shaoming11/hh-winners/software/benchsim/reports/layout_report.md

# Layout verification report

Generated by `python -m benchsim.verify_layout`. Source: `layout_final.json:update13_final`. Gate: station centre error <= 1.0 mm; beakers settle within 1 mm, tilt <= 0.5 deg, no initial interpenetration > 0.2 mm.

**Overall: PASS**

## Station centres (measured in the compiled MuJoCo model)

| Station | Model (mm) | update13_final (mm) | Error (mm) | Result |
|---|---|---|---|---|
| pourer base axis | [397.4, 599.7] | [397.4, 599.7] | 0.000 | PASS |
| transfer base axis | [604.8, 599.7] | [604.8, 599.7] | 0.000 | PASS |
| scale pan centre | [620.0, 407.0, 63.68] | [620.0, 407.0, 63.7] | 0.022 | PASS |
| funnel rim (sled at WORK) | [450.0, 282.0, 233.0] | [450.0, 282.0, 233.0] | 0.000 | PASS |
| carousel centre | [755.7, 297.0] | [755.7, 297.0] | 0.000 | PASS |
| carousel pick pocket | [718.22, 372.17, 61.7] | [718.2, 372.2, 61.7] | 0.032 | PASS |
| carousel auger on the pocket circle (r, z) | [83.97, 61.7] | [84.0, 61.7] | 0.033 | PASS |
| every pocket reaches the auger in deck range | [] | [] | 0.000 | PASS |
| rack pocket 1 | [192.3, 394.6, 60.2] | [192.3, 394.6, 60.2] | 0.000 | PASS |
| rack pocket 2 | [134.6, 477.1, 60.2] | [134.6, 477.1, 60.2] | 0.000 | PASS |
| rack pocket 3 | [108.5, 574.4, 60.2] | [108.5, 574.4, 60.2] | 0.000 | PASS |
| X-front rail centre Y | [582.5] | [582.5] | 0.000 | PASS |
| X-back rail centre Y | [652.3] | [652.3] | 0.000 | PASS |
| auger outlet over auger pocket | [834.5, 326.0] | [834.5, 326.0] | 0.000 | PASS |

## Beakers after 2 s of free settling

| Beaker | Station | Error (mm) | Moved (mm) | Tilt (deg) | Initial penetration (mm) | Result |
|---|---|---|---|---|---|---|
| P1 | carousel_pocket_0 | 0.110 | 0.160 | 0.024 | 0.000 | PASS |
| P2 | carousel_pocket_2 | 0.111 | 0.161 | 0.033 | 0.000 | PASS |
| dev | rack_1 | 0.110 | 0.160 | 0.038 | 0.000 | PASS |
| water | rack_3 | 0.108 | 0.158 | 0.000 | 0.000 | PASS |

## Recorded r / bearing table vs coordinates (coordinates are authoritative)

| Arm | Station | r | r recorded | Bearing | Bearing recorded |
|---|---|---|---|---|---|
| pourer | rack 1 | 290.1 | 290.0 | -45.0 | -45 |
| pourer | rack 2 | 290.0 | 290.0 | -65.0 | -65 |
| pourer | rack 3 | 290.0 | 290.0 | -85.0 | -85 |
| pourer | scale | 294.4 | 294.4 | 49.1 | 47 |
| pourer | funnel | 322.0 | 322.0 | 9.4 | 9 |
| transfer | carousel pick | 254.2 | 254.2 | 26.5 | 26.5 |
| transfer | scale | 193.3 | 193.3 | 4.5 | -5 |
| - | carousel_pick vs centre | 84.0 | 84.0 | 116.5 | None |
| - | carousel_auger vs centre | 84.0 | 84.0 | 20.2 | None |

## Imported CAD mesh placement

| Part | File | Placement check | Residual (mm) |
|---|---|---|---|
| RK-03 reagent rack | `RK-03_reagent_rack.stl` | fit: 3 cup floors to update13_final rack_stands + floor Z | 0.000 |
| TT-04 v4 beaker ring | `TT-04_beaker-ring-v4-4x100mL_qty1.stl` | fit: 4 pocket bores to the r84 pockets + floor Z | 0.123 |
| TT-02 carousel deck | `TT-02_carousel-deck_qty1.stl` | concentric with the carousel axis (symmetric part); Z = ring base - 7 | n/a |
| WS-02 v3 scale pan | `WS-02_scale-pan-v3-100mL_qty1.stl` | ring centre and floor Z: floor lands on the update13_final beaker bottom Z 63.7 | 0.000 |
| ST-11 stage sled | `ST-11_stage-sled_qty1_SUPPORTS.stl` | part frame = tools/cad/stage_b.py origin (450, 282, 0); catch-well ring centre found at local (0.01, 0.04) | 0.038 |
| ST-12 servo bridge | `ST-12_servo-bridge_qty1.stl` | part frame = tools/cad/stage_b.py Part origin (explicit world coordinates) | n/a |
| ST-13 crank | `ST-13_crank_qty1.stl` | part frame = tools/cad/stage_b.py Part origin (explicit world coordinates) | n/a |
| ST-14 connecting rod | `ST-14_connecting-rod_qty1.stl` | part frame = tools/cad/stage_b.py Part origin (explicit world coordinates) | n/a |
| ST-07 catch well | `ST-07_catch-well_qty1.stl` | concentric in the ST-11 locating ring (symmetric part); Z = sled plate top | n/a |
| ST-05 flask collar | `ST-05_flask-collar_qty1.stl` | concentric, on the catch-well floor (assumed 2 mm) | n/a |
| TT-01 v2 turntable base | `TT-01_turntable-base-v2_qty1.stl` | assumed: local origin on the carousel axis, rotated with the unit by update13_final carousel.rotation_deg | n/a |

## Fidelity

| Part | Visual | Collision | Source | Note |
|---|---|---|---|---|
| table | procedural | box | bench_params.toml world.table_xy (assumed extent) |  |
| frame rails (X-front, X-back, Y-left, Y-right, E6, S1, S2) | procedural | box per rail | update13_final X_rails + demo_process 2.2 + tools/cad/stage_a.py | solid 20x20 boxes, no T-slots; E5 omitted (placement not recorded) |
| scale WS-01 base, load cell | procedural | box | update13_final scale.mount (saddle X 547-664) + WS-01 STL extent |  |
| scale pan WS-02 v3 | procedural | cylinder floor + 20-box locating ring | update13_final scale.pan, WS-02 STL extent |  |
| load cell signal | analytic | - | slide-joint flexure (k, zeta) + HX711 noise/quantisation | see benchsim.backends.sim |
| carousel TT-01/TT-02/TT-04 v4 | procedural | cylinders + 20-box pocket bore (r 30.6) + 3 mm rib band (r 28.3) | update13_final carousel + layout_final.py pocket walls r28.3-30.3 | deck on a hinge with a position servo |
| auger PS-01 post + DH-01 head + E5 | procedural | box | layout_final carousel.auger_post_box / auger_head_box / auger_rail_E5 (STL extents as placed) | bounding boxes of the CAD parts; screw not modelled |
| auger dosing | analytic | - | g/rev x revolutions with CV, stall rule (electrical.md 6) |  |
| reagent rack RK-03 | procedural | cup posts + 20-box cup walls + webs + spine | update13_final rack_stands + rack_beaker_bottom_z | cup walls 22 mm tall around the beaker; spine on the Y-left west face |
| stage ST-11 sled, ST-13 crank, ST-14 rod | procedural | sled plate box; crank/rod no collision | tools/cad/stage_b.py (crank r50 at (450,77), rod 80) | closed slider-crank: hinge + hinge + connect equality + slide |
| flask 250 mL, ST-05 collar, ST-07 catch well | procedural | convex frustum hull (flask) | assumed Erlenmeyer dims; ST-05/ST-07 STL extents |  |
| funnel | procedural | convex frustum hull | update13_final funnel (rim Z 233); 100 mm rim assumed | solid hull: conservative for clearance below the rim |
| foam column | analytic | - | benchsim.chem.foam: induction + logistic growth from reagent masses |  |
| beakers EISCO 100 mL PP (56 x 74) | procedural | floor cylinder + 20-box hollow wall | demo_process 3 + DUMMY-BEAKER STL | free bodies; liquid weight applied as an external force by the chemistry model |
| liquid in vessels | analytic | - | benchsim.chem.liquid: tilted-cylinder volume, weir flow, ballistic stream |  |
| SO-101 arms (2x) | upstream-mesh | upstream link meshes (convex hulls) | TheRobotStudio/SO-ARM100 5f6d2b876a53 so101_new_calib.xml | stock jaw meshes removed; actuators as upstream (kp 998, 3.35 N m) |
| fin-ray gripper GR-01 body, GR-02 jaw, GR-03 fingers | cad-mesh | GR-01/GR-02 convex hulls + one 4 mm box per finger contact face | exports/prints_v2 GR-0x STLs (assembly coordinates, arm A as built) placed by the CAD as-built fit | moving finger = GR-03 mirrored about the 43 mm bisector and rotated (gripper_design.to_moving_q0) |
| RK-03 reagent rack | cad-mesh | procedural (see the matching procedural row) | RK-03_reagent_rack.stl | fit: 3 cup floors to update13_final rack_stands + floor Z; residual 0.000 mm |
| TT-04 v4 beaker ring | cad-mesh | procedural (see the matching procedural row) | TT-04_beaker-ring-v4-4x100mL_qty1.stl | fit: 4 pocket bores to the r84 pockets + floor Z; residual 0.123 mm |
| TT-02 carousel deck | cad-mesh | procedural (see the matching procedural row) | TT-02_carousel-deck_qty1.stl | concentric with the carousel axis (symmetric part); Z = ring base - 7 |
| WS-02 v3 scale pan | cad-mesh | procedural (see the matching procedural row) | WS-02_scale-pan-v3-100mL_qty1.stl | ring centre and floor Z: floor lands on the update13_final beaker bottom Z 63.7; residual 0.000 mm |
| ST-11 stage sled | cad-mesh | procedural (see the matching procedural row) | ST-11_stage-sled_qty1_SUPPORTS.stl | part frame = tools/cad/stage_b.py origin (450, 282, 0); catch-well ring centre found at local (0.01, 0.04); residual 0.038 mm |
| ST-12 servo bridge | cad-mesh | procedural (see the matching procedural row) | ST-12_servo-bridge_qty1.stl | part frame = tools/cad/stage_b.py Part origin (explicit world coordinates) |
| ST-13 crank | cad-mesh | procedural (see the matching procedural row) | ST-13_crank_qty1.stl | part frame = tools/cad/stage_b.py Part origin (explicit world coordinates) |
| ST-14 connecting rod | cad-mesh | procedural (see the matching procedural row) | ST-14_connecting-rod_qty1.stl | part frame = tools/cad/stage_b.py Part origin (explicit world coordinates) |
| ST-07 catch well | cad-mesh | procedural (see the matching procedural row) | ST-07_catch-well_qty1.stl | concentric in the ST-11 locating ring (symmetric part); Z = sled plate top |
| ST-05 flask collar | cad-mesh | procedural (see the matching procedural row) | ST-05_flask-collar_qty1.stl | concentric, on the catch-well floor (assumed 2 mm) |
| TT-01 v2 turntable base | cad-mesh | procedural (see the matching procedural row) | TT-01_turntable-base-v2_qty1.stl | assumed: local origin on the carousel axis, rotated with the unit by update13_final carousel.rotation_deg |
| cameras | analytic | - | no documented viewpoint; poses assumed in scene.cameras |  |
