shaoming11/hh-winners/software/benchsim/reports/mechanisms_report.md

# Mechanisms verification report (phase 7)

Generated by `python -m benchsim.verify_mechanisms` (123 s wall). Auger dosing, foam and liquid volumes are analytic models, not CFD or granular simulation; every parameter is in `benchsim/config/bench_params.toml` ([auger], [auger_model], [foam], [flask]), and "assumed" values there have no measurement behind them.

**Overall: PASS**

## Gates

| Section | Gate | Result |
|---|---|---|
| (a) dosing | doses within tol | PASS |
| (a) dosing | topups le max | PASS |
| (a) dosing | landing in P2 | PASS |
| (a) dosing | transient jam recovered | PASS |
| (a) dosing | jam faults | PASS |
| (a) dosing | hopper empty faults | PASS |
| (a) dosing | hopper empty host rule | PASS |
| (b) carousel | all pocket station pairs visited | PASS |
| (b) carousel | all reachable | PASS |
| (b) carousel | deck angle within done tol | PASS |
| (b) carousel | pockets on stations | PASS |
| (b) carousel | beakers stay in pockets | PASS |
| (b) carousel | commanded time obeys 2s per 45deg | PASS |
| (b) carousel | travel time within cmd plus timeout | PASS |
| (c) stage | linkage matches analytic | PASS |
| (c) stage | travel vs commanded angle | PASS |
| (c) stage | analytic 150deg is 97 3 | PASS |
| (c) stage | erupt travel 97 3 | PASS |
| (c) stage | work return | PASS |
| (c) stage | travel time within cmd plus timeout | PASS |
| (d) foam | o2 yield about 1 7 l | PASS |
| (d) foam | o2 released conserved | PASS |
| (d) foam | zero foam without yeast | PASS |
| (d) foam | zero foam without developer | PASS |
| (d) foam | foam made monotonic | PASS |
| (d) foam | column monotonic to peak | PASS |
| (d) foam | camera frames cover growth | PASS |
| (d) foam | camera colour px grow | PASS |
| (d) foam | camera segmented px grow | PASS |
| (d) foam | camera projection matches top | PASS |
| (d) foam | camera foam pixels in region | PASS |

## (a) Yeast dosing

Model: per-revolution g/rev drawn from N(0.850, (0.06 x 0.850)^2) with a seeded RNG. Yeast leaves only on new screw travel, so the 1/4-turn reverse after each AUG costs 1/4 rev of dispensing at the start of the next AUG. Host: first pass 85 % of target by revolutions, scale verification, at most 2 top-ups of round((target - m)/g_per_rev, 0.1). P2 is teleported between its pick pocket and the scale pan (the transfer-arm move is the sequencer's job); its empty tare on the simulated HX711 was 18.017 g.

Landing: outlet 0.416 mm from the P2 axis at the auger station (limit 21.800 = inner radius - outlet radius), 33.9 mm above the lip; receiver = P2.

Calibration (architecture 6, 3 x 10 rev into the tared cup): **0.8294 g/rev** (model mean 0.850 per dispensing revolution). Runs: 0.838 g/rev, 0.831 g/rev, 0.820 g/rev.

| Dose | Status | First pass (rev) | Top-ups | Revs total | Scale (g) | Error (g) | Ledger truth (g) | Truth error (g) |
|---|---|---|---|---|---|---|---|---|
| 1 | ok | 7.2 | 1 | 8.5 | 7.101 | +0.101 | 7.073 | +0.073 |
| 2 | ok | 7.2 | 1 | 8.3 | 6.987 | -0.013 | 7.010 | +0.010 |
| 3 | ok | 7.2 | 1 | 8.2 | 7.043 | +0.043 | 7.056 | +0.056 |
| 4 | ok | 7.2 | 1 | 8.1 | 6.984 | -0.016 | 6.976 | -0.024 |
| 5 | ok | 7.2 | 1 | 8.4 | 7.016 | +0.016 | 7.024 | +0.024 |
| 6 | ok | 7.2 | 1 | 8.3 | 7.077 | +0.077 | 7.089 | +0.089 |
| 7 | ok | 7.2 | 1 | 8.3 | 6.959 | -0.041 | 6.961 | -0.039 |
| 8 | ok | 7.2 | 1 | 8.1 | 7.043 | +0.043 | 7.057 | +0.057 |
| 9 | ok | 7.2 | 1 | 8.5 | 7.024 | +0.024 | 7.032 | +0.032 |
| 10 | ok | 7.2 | 1 | 8.3 | 7.016 | +0.016 | 7.036 | +0.036 |

Target 7.0 g +- 0.7 g over 10 doses: scale error mean +0.025 g, std 0.043 g, max |error| 0.101 g; ledger truth mean +0.032 g, std 0.041 g, max |error| 0.089 g. Top-up counts {'0': 0, '1': 10, '2': 0}. Yeast spilled: 0.0000 g.

Where the negative bias comes from: every AUG starts by re-covering the previous 0.00-turn anti-dribble reverse, and in this model that travel dispenses nothing ([auger_model] recover_dispenses = false, assumed). Calibration spreads the loss over 10 rev, so the calibrated value sits below the true one, but a 1-1.5 rev top-up still loses about 0.00 rev x 0.85 g/rev = 0.00 g. The documented top-up formula is used unchanged. If the real screw behaves this way, adding reverse_rev to each commanded pass would remove most of the bias.

| Fault case | Result |
|---|---|
| Transient jam (screw blocked 0.25 s, 1 s into the first pass) | ok, first-pass stalls 1, scale 7.003 g |
| Jammed auger | fault AUGER_JAM after 3 stall events |
| Empty hopper (device model rule) | fault HOPPER_EMPTY: Mega fault {'g_last': 0.619, 'revs': 10, 't': 602002} |
| Empty hopper (host scale rule, device rule off) | fault HOPPER_EMPTY: host scale check: -0.04 g over 15.6 rev |

Sensitivity to a host g/rev error (true g/rev unchanged; informational):

| Host g/rev / calibrated | Status | First pass (rev) | Top-ups | Scale (g) | Truth (g) |
|---|---|---|---|---|---|
| 0.80 | ok | 9.0 | 0 | 7.570 | 7.597 |
| 0.80 | ok | 9.0 | 0 | 7.316 | 7.344 |
| 0.90 | ok | 8.0 | 0 | 6.865 | 6.880 |
| 0.90 | ok | 8.0 | 0 | 6.702 | 6.703 |
| 1.10 | ok | 6.5 | 1 | 6.906 | 6.910 |
| 1.10 | ok | 6.5 | 1 | 6.962 | 6.980 |
| 1.20 | ok | 6.0 | 1 | 6.625 | 6.643 |
| 1.20 | ok | 6.0 | 1 | 6.688 | 6.715 |

## (b) Carousel stations

Deck angle that brings each pocket to each station; bearings from update13_final, pocket angles from [carousel] pocket_ids_deg.

| Pocket | Station | Station bearing (deg) | Deck angle (deg) |
|---|---|---|---|
| 0 | pick | 116.504 | 0.004 |
| 0 | auger | 20.205 | -96.295 |
| 1 | pick | 116.504 | -89.996 |
| 1 | auger | 20.205 | 173.705 |
| 2 | pick | 116.504 | 180.004 |
| 2 | auger | 20.205 | 83.705 |
| 3 | pick | 116.504 | 90.004 |
| 3 | auger | 20.205 | -6.295 |

Moves at the commanded minimum time (2.0 s per 45 deg). Gates: deck within the firmware done tolerance 0.6 deg, pocket centres and beaker offsets within 1.0 mm, travel time between commanded and commanded + 2.0 s.

| Deck cmd (deg) | Span (deg) | Cmd (s) | Travel (s) | Deck error (deg) | Pick: pocket, error (mm) | Auger: pocket, error (mm) | P1 offset (mm) | P2 offset (mm) |
|---|---|---|---|---|---|---|---|---|
| -96.30 | 96.3 | 4.280 | 4.285 | -0.185 | - | 0 (P1), 0.274 | 0.246 | 0.254 |
| 173.71 | 269.8 | 11.991 | 11.995 | +0.066 | - | 1 (-), 0.103 | 0.214 | 0.159 |
| 83.70 | 89.9 | 3.998 | 4.005 | -0.195 | - | 2 (P2), 0.290 | 0.212 | 0.176 |
| -6.29 | 90.2 | 4.011 | 4.015 | -0.198 | - | 3 (-), 0.294 | 0.203 | 0.172 |
| 0.00 | 6.1 | 0.270 | 0.535 | +0.382 | 0 (P1), 0.564 | - | 0.201 | 0.155 |
| -90.00 | 89.4 | 3.974 | 3.975 | -0.206 | 1 (-), 0.306 | - | 0.194 | 0.159 |
| 180.00 | 269.8 | 11.990 | 11.995 | +0.065 | 2 (P2), 0.101 | - | 0.154 | 0.150 |
| 90.00 | 89.9 | 3.998 | 4.005 | -0.195 | 3 (-), 0.290 | - | 0.148 | 0.167 |

## (c) Stage slider-crank

Analytic s(theta) = (r + L) - r cos(theta) - sqrt(L^2 - r^2 sin^2(theta)), r 50, L 80; s(150 deg) = 97.3078 mm.

| Cmd (deg) | Crank measured (deg) | Sled travel MuJoCo (mm) | Analytic at measured (mm) | Linkage error (mm) | Analytic at cmd (mm) | Error vs cmd (mm) |
|---|---|---|---|---|---|---|
| 0 | 0.000 | -0.000 | 0.000 | -0.0000 | 0.000 | -0.0000 |
| 10 | 9.995 | 1.231 | 1.231 | -0.0000 | 1.232 | -0.0012 |
| 20 | 19.995 | 4.862 | 4.862 | -0.0000 | 4.865 | -0.0024 |
| 30 | 29.995 | 10.702 | 10.702 | -0.0001 | 10.705 | -0.0035 |
| 40 | 39.995 | 18.433 | 18.433 | -0.0001 | 18.438 | -0.0043 |
| 50 | 49.995 | 27.621 | 27.621 | -0.0001 | 27.626 | -0.0049 |
| 60 | 59.995 | 37.727 | 37.727 | -0.0001 | 37.732 | -0.0051 |
| 70 | 69.995 | 48.145 | 48.145 | -0.0001 | 48.150 | -0.0050 |
| 80 | 79.995 | 58.262 | 58.262 | -0.0001 | 58.267 | -0.0046 |
| 90 | 89.996 | 67.546 | 67.546 | -0.0001 | 67.550 | -0.0040 |
| 100 | 99.996 | 75.628 | 75.629 | -0.0001 | 75.632 | -0.0033 |
| 110 | 109.996 | 82.349 | 82.349 | -0.0001 | 82.352 | -0.0026 |
| 120 | 119.996 | 87.730 | 87.730 | -0.0000 | 87.732 | -0.0020 |
| 130 | 129.996 | 91.903 | 91.903 | -0.0000 | 91.904 | -0.0015 |
| 140 | 139.996 | 95.041 | 95.041 | -0.0000 | 95.042 | -0.0011 |
| 150 | 149.996 | 97.307 | 97.307 | -0.0000 | 97.308 | -0.0008 |

Max linkage error 0.0001 mm; max error vs commanded angle 0.0051 mm (gate 0.5 mm).

| Move | Crank (deg) | Sled travel (mm) | Travel time (s) | Commanded (s) |
|---|---|---|---|---|
| WORK | 0.012 | 0.000 | 2.685 | 2.500 |
| ERUPT | 149.989 | 97.306 | 2.675 | 2.500 |
| WORK | 0.012 | 0.000 | 2.685 | 2.500 |

## (d) Foam

O2 yield: 39 g developer x 0.12 = 4.68 g H2O2 = 0.1376 mol -> 0.0688 mol O2 x 24.47 L/mol = **1683 mL** (demo_process 1: about 1.7 L). Flask internal volume (modelled frustum + neck) 296.6 mL.

Parameters ([foam], mostly assumed): induction 2.0 s, k = 1.20 mL/(g s) x yeast g / liquid mL, trap fraction 0.70 with soap (0.00 without), liquid fraction 0.05, collapse tau 30 s, column max 200 mm above the neck, column diameter = neck bore 28 mm.

Timeline (t = 0 when the yeast slurry enters the flask, all at once): stage starts at 1.5 s and reaches ERUPT at 4.17 s (sled 97.20 mm); foam reaches the neck top at 4.09 s; column peak 200.0 mm at 5.7 s; after 60 s, 1674 mL O2 released, 1233 mL foam made, 528 mL overflowed into the catch well.

Timing note (informational; it rests on the assumed induction_s and k): foam reaches the neck top BEFORE the sled arrives at ERUPT (margin -0.08 s), with the sled at 97.1 mm of its 97.2 mm travel by then. Architecture 4.5 wants the catalyst-to-neck time measured on the first live run.

| t (s) | H2O2 left (g) | O2 (mL) | Foam made (mL) | Foam in flask (mL) | Column above neck (mm) | Overflow (mL) |
|---|---|---|---|---|---|---|
| 1 | 4.680 | 0 | 0 | 0 | 0.0 | 0 |
| 2 | 4.680 | 0 | 0 | 0 | 0.0 | 0 |
| 3 | 4.282 | 143 | 105 | 104 | 0.0 | 0 |
| 4 | 3.919 | 274 | 202 | 195 | 0.0 | 0 |
| 5 | 3.586 | 394 | 290 | 202 | 119.3 | 0 |
| 6 | 3.281 | 503 | 371 | 202 | 200.0 | 21 |
| 7 | 3.002 | 604 | 445 | 202 | 200.0 | 84 |
| 8 | 2.747 | 695 | 512 | 202 | 200.0 | 140 |
| 9 | 2.514 | 779 | 574 | 202 | 200.0 | 192 |
| 10 | 2.300 | 856 | 631 | 202 | 200.0 | 237 |
| 11 | 2.105 | 926 | 682 | 202 | 200.0 | 278 |
| 12 | 1.926 | 991 | 730 | 202 | 200.0 | 315 |
| 13 | 1.762 | 1050 | 773 | 202 | 200.0 | 347 |
| 14 | 1.613 | 1103 | 813 | 202 | 200.0 | 376 |
| 15 | 1.476 | 1153 | 849 | 202 | 200.0 | 402 |
| 20 | 0.947 | 1343 | 990 | 202 | 200.0 | 488 |
| 25 | 0.607 | 1465 | 1079 | 202 | 200.0 | 523 |
| 30 | 0.390 | 1543 | 1137 | 202 | 197.4 | 528 |
| 35 | 0.250 | 1594 | 1174 | 201 | 172.9 | 528 |
| 40 | 0.160 | 1626 | 1198 | 192 | 146.3 | 528 |
| 45 | 0.103 | 1646 | 1213 | 176 | 123.9 | 528 |
| 50 | 0.066 | 1660 | 1223 | 158 | 104.8 | 528 |
| 55 | 0.042 | 1668 | 1229 | 140 | 88.7 | 528 |
| 60 | 0.027 | 1674 | 1233 | 122 | 75.1 | 528 |

Zero cases (60 s each): no yeast: peak 0.0 mm, foam 0.0 mL, O2 0 mL; no developer: peak 0.0 mm, foam 0.0 mL, O2 0 mL; no soap: peak 0.0 mm, foam 0.0 mL, O2 1680 mL.

### Foam camera check (foam_cam, 640x480, fovy 40 deg)

The flask_neck_top site is projected with f = (H/2)/tan(fovy/2) and the camera pose (data.cam_xpos/cam_xmat). The region is 2 projected column radii either side of that pixel, from the image top down to it plus one projected radius (the near half of the column base, seen from above). Foam-coloured pixels outside the region must stay under 2 % of those inside. Foam-coloured pixels: hue within 30 deg of the foam rgba hue, saturation >= 0.15, value >= 0.25. Cross-checks: MuJoCo segmentation of the foam geom in the same region, and the predicted vs segmented top row of the column. The funnel (alpha 0.55) stands in front of the lower column: the colour test sees the foam through it, but segmentation records the funnel. The top-row check is therefore gated only while the column top is above the funnel rim (marked *). Saved frames are annotated: cyan = region, green = projected neck top.

| t (s) | Column (mm) | Neck pixel (u, v) | Colour px in region | Segmented px in region | Colour px outside | Top row predicted / segmented | Frame |
|---|---|---|---|---|---|---|---|
| 4.17 | 12.2 | [320.2, 420.5] | 2362 | 2363 | 0 | 380.2 / 387 | [png](foam_frames/foam_t04.17s.png) |
| 4.25 | 23.0 | [320.2, 420.5] | 5026 | 2887 | 0 | 355.6 / 382 |  |
| 4.50 | 56.2 | [320.2, 420.5] | 10590 | 2887 | 0 | 278.4 / 382 | [png](foam_frames/foam_t04.50s.png) |
| 4.75 | 88.3 | [320.2, 420.5] | 16074 | 5248 | 0 | 201.7 / 202 * | [png](foam_frames/foam_t04.75s.png) |
| 5.00 | 119.3 | [320.2, 420.5] | 21860 | 11057 | 0 | 121.2 / 121 * | [png](foam_frames/foam_t05.00s.png) |
| 5.25 | 149.3 | [320.2, 420.5] | 27945 | 17141 | 0 | 36.6 / 37 * |  |
| 5.50 | 178.4 | [320.2, 420.5] | 30869 | 19969 | 0 | - | [png](foam_frames/foam_t05.50s.png) |
| 5.75 | 200.0 | [320.2, 420.5] | 30869 | 19968 | 0 | - |  |
| 6.00 | 200.0 | [320.2, 420.5] | 30869 | 19968 | 0 | - |  |
| 7.00 | 200.0 | [320.2, 420.5] | 30869 | 19968 | 0 | - |  |
| 8.00 | 200.0 | [320.2, 420.5] | 30869 | 19968 | 0 | - |  |
| 10.00 | 200.0 | [320.2, 420.5] | 30869 | 19968 | 0 | - |  |
| 15.00 | 200.0 | [320.2, 420.5] | 30869 | 19968 | 0 | - |  |
| 20.00 | 200.0 | [320.2, 420.5] | 30869 | 19968 | 0 | - |  |
| 30.00 | 197.4 | [320.2, 420.5] | 30868 | 19968 | 0 | - | [png](foam_frames/foam_t30.00s.png) |
| 45.00 | 123.9 | [320.2, 420.5] | 22758 | 11943 | 0 | 108.5 / 109 * |  |
| 60.00 | 75.1 | [320.2, 420.5] | 13762 | 2887 | 0 | 233.4 / 382 | [png](foam_frames/foam_t60.00s.png) |

## Approximations

- Auger: grams per revolution are i.i.d. normal per revolution of new screw travel; no bridging, no compaction, no dependence on hopper level until the hopper is empty. The fall from the outlet is instant.
- The ledger applies the yeast weight to P2 as an external force, and the simulated scale reads it through the HX711 model (noise 0.07 g at 80 Hz, mean of 16 samples).
- Foam: first-order kinetics after a fixed induction delay. The headspace ignores the liquid carried into the foam. The column is a cylinder of neck-bore diameter drawn through the funnel, which is ignored. Collapse is a single exponential; overflow above the standing height is only bookkept. None of this is CFD.
- Stage and carousel use the MuJoCo position actuators driven by the simulated Mega smoothstep. The closed slider-crank uses a soft connect equality, so linkage errors are constraint compliance.
