shaoming11/hh-winners/software/benchsim/reports/kinematics_report.md

# Kinematics verification report

Generated by `python -m benchsim.verify_kinematics`. Margins are degrees to the URDF limit minus 5 deg (rule: >= 10 at picks, places and pours, >= 5 on carries). Paths are checked at <= 1.5 deg joint steps with the other arm parked; a contact is a penetration deeper than 0.5 mm.

## 1. CAD planner convention -> SO-101 MJCF

Mapping `q_mj = o + s * q_cad` with `o` from the CAD as-built axis fit (`benchsim.cadmap`) and `s` from the sign search below.
Status: **approximate**. The recorded paths are replayed with this mapping for audit only; they are not used as hardware or simulator trajectories.

### Sign search (32 combinations; best 6)

| signs | mean endpoint error (mm) | max (mm) | all frames in limits |
|---|---|---|---|
| [1, 1, 1, 1, 1] | 32.4 | 97.0 | True |
| [1, 1, 1, 1, -1] | 42.7 | 96.8 | True |
| [1, -1, -1, -1, 1] | 160.6 | 233.7 | False |
| [1, -1, -1, -1, -1] | 161.7 | 234.0 | False |
| [-1, 1, -1, -1, -1] | 235.4 | 374.1 | False |
| [-1, 1, -1, -1, 1] | 237.7 | 368.4 | False |

### Station endpoints of the recorded paths (MJCF FK vs update13_final)

| pose | FK (mm) | station (mm) | residual (mm) | margin MJCF | planner recorded | diff |
|---|---|---|---|---|---|---|
| P_dev pick | [188.6, 399.0, 105.2] | [192.3, 394.6, 100.2] | 7.59 | 9.96 wrist_flex | 11.65 wr_flex | -1.69 |
| P_wat pick | [109.8, 578.2, 90.6] | [108.5, 574.4, 100.2] | 10.43 | 9.56 wrist_flex | 11.18 wr_flex | -1.63 |
| P_fun pick | [616.0, 403.0, 98.6] | [620.0, 407.0, 93.7] | 7.51 | 8.76 wrist_flex | 10.42 wr_flex | -1.66 |
| T1 first frame (pick) | [742.1, 466.2, 60.7] | [718.2, 372.2, 61.7] | 97.01 | 19.40 wrist_flex | 17.72 wr_flex | +1.67 |
| T1 last frame (place) | [616.7, 406.4, 62.6] | [620.0, 407.0, 63.7] | 3.48 | 18.96 wrist_flex | 17.29 wr_flex | +1.67 |
| T2 first frame (pick) | [616.7, 406.4, 62.6] | [620.0, 407.0, 63.7] | 3.48 | 18.96 wrist_flex | 17.29 wr_flex | +1.67 |
| T2 last frame (place) | [742.1, 466.2, 60.7] | [718.2, 372.2, 61.7] | 97.01 | 19.40 wrist_flex | 17.72 wr_flex | +1.67 |

The binding joint matches the planner in every case; the constant 1.67 deg margin difference is the wrist-flex zero of the axis fit vs the planner's link-angle calibration (urdf_limits.py), i.e. the wrist-flex zero is uncertain by about 1.7 deg.

## 2. Recorded paths replayed on the MJCF arms (audit)

| step | segment | frames | in limits | min margin | contacts (worst) | min clearance | held tilt | lip above rim |
|---|---|---|---|---|---|---|---|---|
| T1 | approach park->pick | 6 | True | 11.2 wrist_flex | 0  | 18.1 |  |  |
| T1 | carry pick->place (held) | 8 | True | 11.2 wrist_flex | 3 (1.4 mm beaker_P1/scale_pan) | -1.4 | [0.6, 0.6] |  |
| T1 | retreat place->park | 5 | True | 11.5 wrist_flex | 11 (13.2 mm beaker_P1/transfer/gripper) | -13.2 |  |  |
| P_dev | approach park->pick | 13 | True | 10.0 wrist_flex | 19 (4.7 mm beaker_dev/pourer/gripper) | -4.7 |  |  |
| P_dev | carry pick->pre-pour (held) | 34 | True | 10.0 wrist_flex | 7 (4.6 mm beaker_dev/world) | -4.6 | [0.3, 0.8] |  |
| P_dev | tilt-in (held) | 9 | True | 35.7 elbow_flex | 0  | 18.6 | [0.3, 55.0] | [np.float64(48.2), np.float64(96.1)] |
| P_dev | pour 55->105 deg (held) | 26 | True | 35.7 elbow_flex | 0  | 18.6 | [54.9, 104.9] | [np.float64(42.2), np.float64(48.2)] |
| P_fun | approach park->pick | 14 | True | 8.8 wrist_flex | 23 (4.6 mm beaker_P1/pourer/gripper) | -4.6 |  |  |
| P_fun | carry pick->pre-pour (held) | 32 | True | 8.8 wrist_flex | 2 (3.1 mm beaker_P1/scale_pan) | -3.1 | [0.3, 1.1] |  |
| P_fun | tilt-in (held) | 35 | True | 66.1 wrist_roll | 0  | 10.7 | [1.1, 55.0] | [np.float64(68.3), np.float64(83.8)] |
| P_fun | pour 55->105 deg (held) | 26 | True | 76.3 shoulder_lift | 0  | 18.6 | [55.0, 105.0] | [np.float64(62.3), np.float64(68.3)] |
| T2 | approach park->pick | 6 | True | 11.5 wrist_flex | 13 (13.8 mm beaker_P1/transfer/gripper) | -13.7 |  |  |
| T2 | carry pick->place (held) | 8 | True | 11.2 wrist_flex | 3 (1.4 mm scale_pan/beaker_P1) | -1.4 | [0.6, 0.6] |  |
| T2 | retreat place->park | 5 | True | 11.2 wrist_flex | 11 (13.2 mm beaker_P1/transfer/gripper) | -13.2 |  |  |
| P_wat | approach park->pick | 13 | True | 9.5 wrist_flex | 3 (0.8 mm world/pourer/moving_jaw_so101_v1) | -0.8 |  |  |
| P_wat | carry pick->pre-pour (held) | 34 | True | 9.5 wrist_flex | 12 (9.7 mm world/beaker_water) | -9.7 | [0.3, 0.8] |  |
| P_wat | tilt-in (held) | 9 | True | 35.6 elbow_flex | 0  | 18.6 | [0.3, 55.2] | [np.float64(39.6), np.float64(83.9)] |
| P_wat | pour 55->105 deg (held) | 26 | True | 35.6 elbow_flex | 0  | 18.6 | [55.2, 105.1] | [np.float64(39.6), np.float64(46.0)] |

Pour segments reproduce the planner geometry (lip 42-48 mm above the P1 rim for the 45 mm design, 62-68 for the 65 mm funnel design; carried beakers stay within 1.1 deg of upright). Approach and pick frames collide by the size of the endpoint residuals, and the planner's top-down grasp frame puts the beaker 13-14 mm into the fixed finger (demo_process 3 already tells the operator to shift it about 14 mm). Recorded-path playback is therefore **pending** a hardware calibration.

## 3. MuJoCo-native station poses (simulation only)

Solved by IK on the MJCF arms, seeded from the mapped recorded poses. Top-down picks use the taught frame (beaker shifted 16.0 mm toward the moving jaw so the fixed finger clears it by 3 mm). Saved in `reports/native_plans.json` with `origin: mujoco-native`.

| step | pose | endpoint error (mm) | axis tilt (deg) | min margin | binding | rule |
|---|---|---|---|---|---|---|
| 1 P1 carousel->scale | pick (close on P1) | 0.000 | 0.0 | 23.21 | wrist_flex | ok |
| 1 P1 carousel->scale | place (release) | 0.000 | 0.0 | 15.27 | wrist_flex | ok |
| 2 developer pour | pick (close on dev) | 0.000 | 0.0 | 9.01 | wrist_flex | **below 10** |
| 2 developer pour | place (release) | 0.000 | 0.0 | 9.67 | wrist_flex | **below 10** |
| 2 developer pour | pour theta 40 | - | - | 32.74 | elbow_flex | ok |
| 2 developer pour | pour theta 105 | - | - | 37.07 | elbow_flex | ok |
| 3 P1 funnel pour | pick (close on P1) | 0.000 | 0.0 | 7.54 | wrist_flex | **below 10** |
| 3 P1 funnel pour | place (release) | 0.000 | 0.0 | 8.12 | wrist_flex | **below 10** |
| 3 P1 funnel pour | pour theta 40 | - | - | 74.51 | shoulder_lift | ok |
| 3 P1 funnel pour | pour theta 105 | - | - | 79.80 | shoulder_lift | ok |
| 4 P1 scale->carousel | pick (close on P1) | 0.000 | 0.0 | 15.87 | wrist_flex | ok |
| 4 P1 scale->carousel | place (release) | 0.000 | 0.0 | 22.57 | wrist_flex | ok |
| 6 P2 carousel->scale | pick (close on P2) | 0.000 | 0.0 | 23.21 | wrist_flex | ok |
| 6 P2 carousel->scale | place (release) | 0.000 | 0.0 | 15.27 | wrist_flex | ok |
| 7 water pour | pick (close on water) | 0.000 | 0.0 | 13.83 | wrist_flex | ok |
| 7 water pour | place (release) | 0.000 | 0.0 | 14.56 | wrist_flex | ok |
| 7 water pour | pour theta 40 | - | - | 34.40 | elbow_flex | ok |
| 7 water pour | pour theta 105 | - | - | 39.53 | elbow_flex | ok |
| 8 P2 funnel pour | pick (close on P2) | 0.000 | 0.0 | 7.54 | wrist_flex | **below 10** |
| 8 P2 funnel pour | place (release) | 0.000 | 0.0 | 8.12 | wrist_flex | **below 10** |
| 8 P2 funnel pour | pour theta 40 | - | - | 74.51 | shoulder_lift | ok |
| 8 P2 funnel pour | pour theta 105 | - | - | 79.80 | shoulder_lift | ok |
| 9 P2 scale->carousel | pick (close on P2) | 0.000 | 0.0 | 15.87 | wrist_flex | ok |
| 9 P2 scale->carousel | place (release) | 0.000 | 0.0 | 22.57 | wrist_flex | ok |

### Grip height selection for the side-grasp pours

| step | documented GRIP_H | pick margin there | GRIP_H used | pick margin used | lip drift (mm) |
|---|---|---|---|---|---|
| 2 developer pour | 40 | 7.33 | 44 | 9.01 | 8.9 |
| 3 P1 funnel pour | 30 | 6.43 | 33 | 7.54 | 7.2 |
| 7 water pour | 40 | 13.83 | 40 | 13.83 | 0.6 |
| 8 P2 funnel pour | 30 | 6.43 | 33 | 7.54 | 7.2 |

## 4. Native path checks

| step | segment | phase | configs | min margin | rule | contacts | min clearance (mm) | at |
|---|---|---|---|---|---|---|---|---|
| 1 P1 carousel->scale | approach park->above channel entry | approach | 47 | 14.40 wrist_flex | ok | 0 | 16.18 | transfer/gripper(transfer/finger_fixed) x beaker_P1(beaker_P1_w3) |
| 1 P1 carousel->scale | lower to channel entry | approach | 10 | 14.40 wrist_flex | ok | 0 | 18.60 | transfer/shoulder x world(rail_X_front) |
| 1 P1 carousel->scale | slide in along finger channel | approach | 16 | 14.40 wrist_flex | ok | 0 | 18.60 | transfer/shoulder x world(rail_X_front) |
| 1 P1 carousel->scale | descend to carousel_pick | approach | 12 | 14.57 wrist_flex | ok | 0 | 5.55 | transfer/gripper(transfer/finger_fixed) x carousel(pocket0_w7) |
| 1 P1 carousel->scale | touch fixed finger to P1 | approach | 4 | 23.21 wrist_flex | ok | 0 | -0.34 | transfer/gripper(transfer/finger_fixed) x beaker_P1(beaker_P1_w7) |
| 1 P1 carousel->scale | close on P1 | pick | 19 | 23.21 wrist_flex | ok | 0 | 5.30 | transfer/gripper(transfer/finger_fixed) x carousel(pocket0_w7) |
| 1 P1 carousel->scale | lift from carousel_pick | carry | 12 | 14.54 wrist_flex | ok | 0 | 0.05 | beaker_P1(beaker_P1_floor) x carousel(tt04_floor) |
| 1 P1 carousel->scale | carry carousel_pick->scale_pan | carry | 21 | 7.95 wrist_flex | ok | 0 | 11.74 | beaker_P1(beaker_P1_floor) x carousel(pocket0_w18) |
| 1 P1 carousel->scale | lower onto scale_pan | carry | 11 | 7.95 wrist_flex | ok | 0 | 1.57 | beaker_P1(beaker_P1_floor) x scale_pan(scale_pan_floor) |
| 1 P1 carousel->scale | release | place | 19 | 15.27 wrist_flex | ok | 0 | 7.72 | transfer/gripper(transfer/finger_fixed) x scale_pan(scale_ring_w6) |
| 1 P1 carousel->scale | move fixed finger off P1 | retreat | 4 | 14.58 wrist_flex | ok | 0 | -0.34 | transfer/gripper(transfer/finger_fixed) x beaker_P1(beaker_P1_w7) |
| 1 P1 carousel->scale | lift 20 mm | retreat | 13 | 6.75 wrist_flex | ok | 0 | 8.04 | transfer/gripper(transfer/finger_fixed) x scale_pan(scale_ring_w6) |
| 1 P1 carousel->scale | slide out along finger channel | retreat | 17 | 6.73 wrist_flex | ok | 0 | 18.60 | transfer/shoulder x world(rail_X_front) |
| 1 P1 carousel->scale | return to park | park | 67 | 8.14 wrist_flex | ok | 0 | 13.03 | transfer/gripper(transfer/finger_fixed) x beaker_P1(beaker_P1_w9) |
| 2 developer pour | approach park->above rack_1 | approach | 99 | 31.41 elbow_flex | ok | 0 | 3.62 | pourer/gripper(pourer/finger_fixed) x beaker_dev(beaker_dev_w17) |
| 2 developer pour | descend to rack_1 | approach | 30 | 9.01 wrist_flex | ok | 0 | 5.00 | pourer/gripper(pourer/finger_fixed) x world(rk03_cup1_w18) |
| 2 developer pour | close on dev | pick | 11 | 9.01 wrist_flex | **below 10** | 0 | 4.88 | pourer/moving_jaw_so101_v1(pourer/finger_moving) x world(rk03_cup1_w10) |
| 2 developer pour | lift from rack_1 | carry | 99 | 9.01 wrist_flex | ok | 0 | 0.05 | beaker_dev(beaker_dev_floor) x world(rk03_cup1_post) |
| 2 developer pour | carry to above pre-pour | carry | 52 | 63.41 shoulder_pan | ok | 0 | 18.60 | pourer/shoulder x world(rail_X_front) |
| 2 developer pour | lower to pre-pour | carry | 23 | 56.50 elbow_flex | ok | 0 | 18.60 | pourer/shoulder x world(rail_X_front) |
| 2 developer pour | tilt-in 0->40 | pour | 41 | 32.74 elbow_flex | ok | 0 | 9.84 | pourer/gripper(pourer/finger_fixed) x beaker_P1(beaker_P1_w13) |
| 2 developer pour | pour manifold 40->105 | pour | 183 | 28.16 wrist_flex | ok | 0 | 9.84 | pourer/gripper(pourer/finger_fixed) x beaker_P1(beaker_P1_w13) |
| 2 developer pour | untilt to pre-pour | pour | 41 | 32.74 elbow_flex | ok | 0 | 9.84 | pourer/gripper(pourer/finger_fixed) x beaker_P1(beaker_P1_w13) |
| 2 developer pour | raise from pre-pour | carry | 23 | 56.50 elbow_flex | ok | 0 | 18.60 | pourer/shoulder x world(rail_X_front) |
| 2 developer pour | carry back above rack_1 | carry | 52 | 63.41 shoulder_pan | ok | 0 | 18.60 | pourer/shoulder x world(rail_X_front) |
| 2 developer pour | lower into rack_1 | carry | 99 | 9.67 wrist_flex | ok | 0 | 0.54 | beaker_dev(beaker_dev_w18) x world(rk03_cup1_w19) |
| 2 developer pour | release | place | 11 | 9.67 wrist_flex | **below 10** | 0 | 6.38 | pourer/moving_jaw_so101_v1(pourer/finger_moving) x world(rk03_cup1_w10) |
| 2 developer pour | lift out | retreat | 28 | 9.67 wrist_flex | ok | 0 | 6.50 | pourer/gripper(pourer/finger_fixed) x world(rk03_cup1_w16) |
| 2 developer pour | return to park | park | 99 | 31.41 elbow_flex | ok | 0 | 3.62 | pourer/gripper(pourer/finger_fixed) x beaker_dev(beaker_dev_w17) |
| 3 P1 funnel pour | approach park->above scale_pan | approach | 98 | 28.91 wrist_flex | ok | 0 | 3.68 | pourer/gripper(pourer/finger_fixed) x beaker_P1(beaker_P1_w2) |
| 3 P1 funnel pour | descend to scale_pan | approach | 30 | 7.54 wrist_flex | ok | 0 | 8.02 | pourer/gripper(pourer/finger_fixed) x scale_pan(scale_ring_w2) |
| 3 P1 funnel pour | close on P1 | pick | 11 | 7.54 wrist_flex | **below 10** | 0 | 7.90 | pourer/moving_jaw_so101_v1(pourer/finger_moving) x scale_pan(scale_ring_w15) |
| 3 P1 funnel pour | lift from scale_pan | carry | 103 | 7.54 wrist_flex | ok | 0 | 0.02 | beaker_P1(beaker_P1_floor) x scale_pan(scale_pan_floor) |
| 3 P1 funnel pour | carry to above pre-pour | carry | 35 | 52.52 shoulder_pan | ok | 0 | 18.60 | pourer/shoulder x world(rail_X_front) |
| 3 P1 funnel pour | lower to pre-pour | carry | 13 | 65.11 wrist_roll | ok | 0 | 11.19 | beaker_P1(beaker_P1_floor) x sled |
| 3 P1 funnel pour | tilt-in 0->40 | pour | 41 | 65.11 wrist_roll | ok | 0 | 8.44 | beaker_P1(beaker_P1_floor) x sled |
| 3 P1 funnel pour | pour manifold 40->105 | pour | 169 | 16.52 wrist_flex | ok | 0 | 18.60 | pourer/shoulder x world(rail_X_front) |
| 3 P1 funnel pour | untilt to pre-pour | pour | 41 | 65.11 wrist_roll | ok | 0 | 8.44 | beaker_P1(beaker_P1_floor) x sled |
| 3 P1 funnel pour | raise from pre-pour | carry | 13 | 65.11 wrist_roll | ok | 0 | 11.19 | beaker_P1(beaker_P1_floor) x sled |
| 3 P1 funnel pour | carry back above scale_pan | carry | 35 | 52.52 shoulder_pan | ok | 0 | 18.60 | pourer/shoulder x world(rail_X_front) |
| 3 P1 funnel pour | lower into scale_pan | carry | 103 | 8.12 wrist_flex | ok | 0 | 1.52 | beaker_P1(beaker_P1_floor) x scale_pan(scale_pan_floor) |
| 3 P1 funnel pour | release | place | 11 | 8.12 wrist_flex | **below 10** | 0 | 9.40 | pourer/moving_jaw_so101_v1(pourer/finger_moving) x scale_pan(scale_ring_w15) |
| 3 P1 funnel pour | lift out | retreat | 28 | 8.12 wrist_flex | ok | 0 | 9.52 | pourer/gripper(pourer/finger_fixed) x scale_pan(scale_ring_w3) |
| 3 P1 funnel pour | return to park | park | 98 | 28.91 wrist_flex | ok | 0 | 3.68 | pourer/gripper(pourer/finger_fixed) x beaker_P1(beaker_P1_w2) |
| 4 P1 scale->carousel | approach park->above channel entry | approach | 60 | 8.72 wrist_flex | ok | 0 | 12.68 | transfer/gripper(transfer/finger_fixed) x beaker_P1(beaker_P1_w8) |
| 4 P1 scale->carousel | lower to channel entry | approach | 9 | 8.72 wrist_flex | ok | 0 | 18.60 | transfer/shoulder x world(rail_X_front) |
| 4 P1 scale->carousel | slide in along finger channel | approach | 17 | 7.30 wrist_flex | ok | 0 | 18.60 | transfer/shoulder x world(rail_X_front) |
| 4 P1 scale->carousel | descend to scale_pan | approach | 13 | 7.32 wrist_flex | ok | 0 | 6.62 | transfer/gripper(transfer/finger_fixed) x scale_pan(scale_ring_w6) |
| 4 P1 scale->carousel | touch fixed finger to P1 | approach | 5 | 15.17 wrist_flex | ok | 0 | -0.22 | transfer/gripper(transfer/finger_fixed) x beaker_P1(beaker_P1_w6) |
| 4 P1 scale->carousel | close on P1 | pick | 19 | 15.87 wrist_flex | ok | 0 | 6.22 | transfer/gripper(transfer/finger_fixed) x scale_pan(scale_ring_w4) |
| 4 P1 scale->carousel | lift from scale_pan | carry | 13 | 7.95 wrist_flex | ok | 0 | 0.02 | beaker_P1(beaker_P1_floor) x scale_pan(scale_pan_floor) |
| 4 P1 scale->carousel | carry scale_pan->carousel_pick | carry | 21 | 7.95 wrist_flex | ok | 0 | 11.69 | beaker_P1(beaker_P1_floor) x carousel(pocket0_w7) |
| 4 P1 scale->carousel | lower onto carousel_pick | carry | 11 | 14.54 wrist_flex | ok | 0 | -0.04 | beaker_P1(beaker_P1_w5) x carousel(pocket0rib_w7) |
| 4 P1 scale->carousel | release | place | 19 | 22.57 wrist_flex | ok | 0 | 6.80 | transfer/gripper(transfer/finger_fixed) x carousel(pocket0_w5) |
| 4 P1 scale->carousel | move fixed finger off P1 | retreat | 4 | 22.57 wrist_flex | ok | 0 | -0.22 | transfer/gripper(transfer/finger_fixed) x beaker_P1(beaker_P1_w6) |
| 4 P1 scale->carousel | lift 20 mm | retreat | 12 | 13.92 wrist_flex | ok | 0 | 7.00 | transfer/gripper(transfer/finger_fixed) x carousel(pocket0_w7) |
| 4 P1 scale->carousel | slide out along finger channel | retreat | 16 | 13.75 wrist_flex | ok | 0 | 18.60 | transfer/shoulder x world(rail_X_front) |
| 4 P1 scale->carousel | return to park | park | 56 | 13.75 wrist_flex | ok | 0 | 13.45 | transfer/gripper(transfer/finger_fixed) x beaker_P1(beaker_P1_w2) |
| 6 P2 carousel->scale | approach park->above channel entry | approach | 47 | 14.40 wrist_flex | ok | 0 | 16.18 | transfer/gripper(transfer/finger_fixed) x beaker_P2(beaker_P2_w3) |
| 6 P2 carousel->scale | lower to channel entry | approach | 10 | 14.40 wrist_flex | ok | 0 | 18.60 | transfer/shoulder x world(rail_X_front) |
| 6 P2 carousel->scale | slide in along finger channel | approach | 16 | 14.40 wrist_flex | ok | 0 | 18.60 | transfer/shoulder x world(rail_X_front) |
| 6 P2 carousel->scale | descend to carousel_pick | approach | 12 | 14.57 wrist_flex | ok | 0 | 5.55 | transfer/gripper(transfer/finger_fixed) x carousel(pocket0_w7) |
| 6 P2 carousel->scale | touch fixed finger to P2 | approach | 4 | 23.21 wrist_flex | ok | 0 | -0.37 | transfer/gripper(transfer/finger_fixed) x beaker_P2(beaker_P2_w7) |
| 6 P2 carousel->scale | close on P2 | pick | 19 | 23.21 wrist_flex | ok | 0 | 5.30 | transfer/gripper(transfer/finger_fixed) x carousel(pocket0_w7) |
| 6 P2 carousel->scale | lift from carousel_pick | carry | 12 | 14.54 wrist_flex | ok | 0 | 0.00 | beaker_P2(beaker_P2_floor) x carousel(tt04_floor) |
| 6 P2 carousel->scale | carry carousel_pick->scale_pan | carry | 21 | 7.95 wrist_flex | ok | 0 | 11.69 | beaker_P2(beaker_P2_floor) x carousel(pocket0_w7) |
| 6 P2 carousel->scale | lower onto scale_pan | carry | 11 | 7.95 wrist_flex | ok | 0 | 1.52 | beaker_P2(beaker_P2_floor) x scale_pan(scale_pan_floor) |
| 6 P2 carousel->scale | release | place | 19 | 15.27 wrist_flex | ok | 0 | 7.72 | transfer/gripper(transfer/finger_fixed) x scale_pan(scale_ring_w6) |
| 6 P2 carousel->scale | move fixed finger off P2 | retreat | 4 | 14.58 wrist_flex | ok | 0 | -0.37 | transfer/gripper(transfer/finger_fixed) x beaker_P2(beaker_P2_w7) |
| 6 P2 carousel->scale | lift 20 mm | retreat | 13 | 6.75 wrist_flex | ok | 0 | 8.04 | transfer/gripper(transfer/finger_fixed) x scale_pan(scale_ring_w6) |
| 6 P2 carousel->scale | slide out along finger channel | retreat | 17 | 6.73 wrist_flex | ok | 0 | 18.60 | transfer/shoulder x world(rail_X_front) |
| 6 P2 carousel->scale | return to park | park | 67 | 8.14 wrist_flex | ok | 0 | 13.01 | transfer/gripper(transfer/finger_fixed) x beaker_P2(beaker_P2_w9) |
| 7 water pour | approach park->above rack_3 | approach | 95 | 15.88 shoulder_pan | ok | 0 | 3.68 | pourer/gripper(pourer/finger_fixed) x beaker_water(beaker_water_w6) |
| 7 water pour | descend to rack_3 | approach | 30 | 13.83 wrist_flex | ok | 0 | 1.00 | pourer/gripper(pourer/finger_fixed) x world(rk03_cup3_w4) |
| 7 water pour | close on water | pick | 11 | 13.83 wrist_flex | ok | 0 | 1.00 | pourer/gripper(pourer/finger_fixed) x world(rk03_cup3_w4) |
| 7 water pour | lift from rack_3 | carry | 101 | 13.83 wrist_flex | ok | 0 | 0.05 | beaker_water(beaker_water_floor) x world(rk03_cup3_post) |
| 7 water pour | carry to above pre-pour | carry | 102 | 16.67 shoulder_pan | ok | 0 | 18.60 | pourer/shoulder x world(rail_X_front) |
| 7 water pour | lower to pre-pour | carry | 33 | 42.72 shoulder_pan | ok | 0 | 18.60 | pourer/shoulder x world(rail_X_front) |
| 7 water pour | tilt-in 0->40 | pour | 41 | 34.40 elbow_flex | ok | 0 | 13.82 | pourer/gripper(pourer/finger_fixed) x beaker_P2(beaker_P2_w4) |
| 7 water pour | pour manifold 40->105 | pour | 94 | 34.40 elbow_flex | ok | 0 | 13.82 | pourer/gripper(pourer/finger_fixed) x beaker_P2(beaker_P2_w4) |
| 7 water pour | untilt to pre-pour | pour | 41 | 34.40 elbow_flex | ok | 0 | 13.82 | pourer/gripper(pourer/finger_fixed) x beaker_P2(beaker_P2_w4) |
| 7 water pour | raise from pre-pour | carry | 33 | 42.72 shoulder_pan | ok | 0 | 18.60 | pourer/shoulder x world(rail_X_front) |
| 7 water pour | carry back above rack_3 | carry | 102 | 16.67 shoulder_pan | ok | 0 | 18.60 | pourer/shoulder x world(rail_X_front) |
| 7 water pour | lower into rack_3 | carry | 101 | 14.56 wrist_flex | ok | 0 | 0.54 | beaker_water(beaker_water_w6) x world(rk03_cup3_w5) |
| 7 water pour | release | place | 11 | 14.56 wrist_flex | ok | 0 | 2.50 | pourer/gripper(pourer/finger_fixed) x world(rk03_cup3_w4) |
| 7 water pour | lift out | retreat | 27 | 14.56 wrist_flex | ok | 0 | 2.50 | pourer/gripper(pourer/finger_fixed) x world(rk03_cup3_w4) |
| 7 water pour | return to park | park | 95 | 15.88 shoulder_pan | ok | 0 | 3.68 | pourer/gripper(pourer/finger_fixed) x beaker_water(beaker_water_w6) |
| 8 P2 funnel pour | approach park->above scale_pan | approach | 98 | 28.91 wrist_flex | ok | 0 | 3.68 | pourer/gripper(pourer/finger_fixed) x beaker_P2(beaker_P2_w2) |
| 8 P2 funnel pour | descend to scale_pan | approach | 30 | 7.54 wrist_flex | ok | 0 | 8.02 | pourer/gripper(pourer/finger_fixed) x scale_pan(scale_ring_w2) |
| 8 P2 funnel pour | close on P2 | pick | 11 | 7.54 wrist_flex | **below 10** | 0 | 7.90 | pourer/moving_jaw_so101_v1(pourer/finger_moving) x scale_pan(scale_ring_w15) |
| 8 P2 funnel pour | lift from scale_pan | carry | 103 | 7.54 wrist_flex | ok | 0 | 0.02 | beaker_P2(beaker_P2_floor) x scale_pan(scale_pan_floor) |
| 8 P2 funnel pour | carry to above pre-pour | carry | 35 | 52.52 shoulder_pan | ok | 0 | 18.60 | pourer/shoulder x world(rail_X_front) |
| 8 P2 funnel pour | lower to pre-pour | carry | 13 | 65.11 wrist_roll | ok | 0 | 11.19 | beaker_P2(beaker_P2_floor) x sled |
| 8 P2 funnel pour | tilt-in 0->40 | pour | 41 | 65.11 wrist_roll | ok | 0 | 8.44 | beaker_P2(beaker_P2_floor) x sled |
| 8 P2 funnel pour | pour manifold 40->105 | pour | 169 | 16.52 wrist_flex | ok | 0 | 18.60 | pourer/shoulder x world(rail_X_front) |
| 8 P2 funnel pour | untilt to pre-pour | pour | 41 | 65.11 wrist_roll | ok | 0 | 8.44 | beaker_P2(beaker_P2_floor) x sled |
| 8 P2 funnel pour | raise from pre-pour | carry | 13 | 65.11 wrist_roll | ok | 0 | 11.19 | beaker_P2(beaker_P2_floor) x sled |
| 8 P2 funnel pour | carry back above scale_pan | carry | 35 | 52.52 shoulder_pan | ok | 0 | 18.60 | pourer/shoulder x world(rail_X_front) |
| 8 P2 funnel pour | lower into scale_pan | carry | 103 | 8.12 wrist_flex | ok | 0 | 1.52 | beaker_P2(beaker_P2_floor) x scale_pan(scale_pan_floor) |
| 8 P2 funnel pour | release | place | 11 | 8.12 wrist_flex | **below 10** | 0 | 9.40 | pourer/moving_jaw_so101_v1(pourer/finger_moving) x scale_pan(scale_ring_w15) |
| 8 P2 funnel pour | lift out | retreat | 28 | 8.12 wrist_flex | ok | 0 | 9.52 | pourer/gripper(pourer/finger_fixed) x scale_pan(scale_ring_w3) |
| 8 P2 funnel pour | return to park | park | 98 | 28.91 wrist_flex | ok | 0 | 3.68 | pourer/gripper(pourer/finger_fixed) x beaker_P2(beaker_P2_w2) |
| 9 P2 scale->carousel | approach park->above channel entry | approach | 60 | 8.72 wrist_flex | ok | 0 | 12.68 | transfer/gripper(transfer/finger_fixed) x beaker_P2(beaker_P2_w8) |
| 9 P2 scale->carousel | lower to channel entry | approach | 9 | 8.72 wrist_flex | ok | 0 | 18.60 | transfer/shoulder x world(rail_X_front) |
| 9 P2 scale->carousel | slide in along finger channel | approach | 17 | 7.30 wrist_flex | ok | 0 | 18.60 | transfer/shoulder x world(rail_X_front) |
| 9 P2 scale->carousel | descend to scale_pan | approach | 13 | 7.32 wrist_flex | ok | 0 | 6.62 | transfer/gripper(transfer/finger_fixed) x scale_pan(scale_ring_w6) |
| 9 P2 scale->carousel | touch fixed finger to P2 | approach | 5 | 15.17 wrist_flex | ok | 0 | -0.22 | transfer/gripper(transfer/finger_fixed) x beaker_P2(beaker_P2_w6) |
| 9 P2 scale->carousel | close on P2 | pick | 19 | 15.87 wrist_flex | ok | 0 | 6.22 | transfer/gripper(transfer/finger_fixed) x scale_pan(scale_ring_w4) |
| 9 P2 scale->carousel | lift from scale_pan | carry | 13 | 7.95 wrist_flex | ok | 0 | 0.02 | beaker_P2(beaker_P2_floor) x scale_pan(scale_pan_floor) |
| 9 P2 scale->carousel | carry scale_pan->carousel_pick | carry | 21 | 7.95 wrist_flex | ok | 0 | 11.69 | beaker_P2(beaker_P2_floor) x carousel(pocket0_w7) |
| 9 P2 scale->carousel | lower onto carousel_pick | carry | 11 | 14.54 wrist_flex | ok | 0 | -0.04 | beaker_P2(beaker_P2_w5) x carousel(pocket0rib_w7) |
| 9 P2 scale->carousel | release | place | 19 | 22.57 wrist_flex | ok | 0 | 6.80 | transfer/gripper(transfer/finger_fixed) x carousel(pocket0_w5) |
| 9 P2 scale->carousel | move fixed finger off P2 | retreat | 4 | 22.57 wrist_flex | ok | 0 | -0.22 | transfer/gripper(transfer/finger_fixed) x beaker_P2(beaker_P2_w6) |
| 9 P2 scale->carousel | lift 20 mm | retreat | 12 | 13.92 wrist_flex | ok | 0 | 7.00 | transfer/gripper(transfer/finger_fixed) x carousel(pocket0_w7) |
| 9 P2 scale->carousel | slide out along finger channel | retreat | 16 | 13.75 wrist_flex | ok | 0 | 18.60 | transfer/shoulder x world(rail_X_front) |
| 9 P2 scale->carousel | return to park | park | 56 | 13.75 wrist_flex | ok | 0 | 13.45 | transfer/gripper(transfer/finger_fixed) x beaker_P2(beaker_P2_w2) |

| step | free-motion clearance (mm) | segment | between |
|---|---|---|---|
| 1 P1 carousel->scale | 11.74 | carry carousel_pick->scale_pan | beaker_P1(beaker_P1_floor) x carousel(pocket0_w18) |
| 2 developer pour | 3.62 | approach park->above rack_1 | pourer/gripper(pourer/finger_fixed) x beaker_dev(beaker_dev_w17) |
| 3 P1 funnel pour | 3.68 | approach park->above scale_pan | pourer/gripper(pourer/finger_fixed) x beaker_P1(beaker_P1_w2) |
| 4 P1 scale->carousel | 11.69 | carry scale_pan->carousel_pick | beaker_P1(beaker_P1_floor) x carousel(pocket0_w7) |
| 6 P2 carousel->scale | 11.69 | carry carousel_pick->scale_pan | beaker_P2(beaker_P2_floor) x carousel(pocket0_w7) |
| 7 water pour | 3.68 | approach park->above rack_3 | pourer/gripper(pourer/finger_fixed) x beaker_water(beaker_water_w6) |
| 8 P2 funnel pour | 3.68 | approach park->above scale_pan | pourer/gripper(pourer/finger_fixed) x beaker_P2(beaker_P2_w2) |
| 9 P2 scale->carousel | 11.69 | carry scale_pan->carousel_pick | beaker_P2(beaker_P2_floor) x carousel(pocket0_w7) |

Clearances near 0 at picks and places are the beaker seated in its pocket or cup (beakers are ignored by the clearance query while the gripper is at a station).

## 5. Reach limits found

- Top-down at carousel_pick: +0 mm 23.2 deg, +10 mm 19.0 deg, +20 mm 14.7 deg, +30 mm 10.4 deg, +40 mm 5.9 deg, +50 mm 1.3 deg, +60 mm -3.6 deg, +80 mm unreachable
- Top-down at scale_pan: +0 mm 15.2 deg, +10 mm 11.3 deg, +20 mm 7.4 deg, +30 mm 3.6 deg, +40 mm -0.2 deg, +50 mm -4.0 deg, +60 mm unreachable, +80 mm unreachable

## 6. Open rule issues

- 2 developer pour / close on dev: margin 9.01 deg < rule 10 (wrist_flex)
- 2 developer pour / release: margin 9.67 deg < rule 10 (wrist_flex)
- 3 P1 funnel pour / close on P1: margin 7.54 deg < rule 10 (wrist_flex)
- 3 P1 funnel pour / release: margin 8.12 deg < rule 10 (wrist_flex)
- 8 P2 funnel pour / close on P2: margin 7.54 deg < rule 10 (wrist_flex)
- 8 P2 funnel pour / release: margin 8.12 deg < rule 10 (wrist_flex)

Collision-free: **True**
