shaoming11/hh-winners/analysis/fastener_reach.md

# Fastener reach check (CDR-01 / CDR-24)

Generated by `python analysis/fastener_reach.py` from `meshes.json` (scene list, world mm). Do not edit by hand.

Criterion: engagement >= 1.5 d in PLA, >= 1.0 d in steel / Al / brass. Engagement is the axial overlap of the shank (tip to head bearing face) with the receiving thread: T-nut, heat-set insert or tapped horn by axial extent, PLA pilot by point-in-mesh ring test at r = d/2 - 0.1 mm. 'Avail.' is the threaded length the receiving body offers on this axis (for PLA: material inside d/2 along the 15 mm search window, i.e. pilot plus any solid beyond it); 'gap' is how far short of it the tip stops.

**The CAD still carries the pre-CDR fastener lengths.** FAILs below are the as-modelled state and are expected; the CDR disposition column says what the ruling changes. Re-run after the CAD occurrences are updated.

Screws checked: 43. PASS 11, FAIL 32.

## Root-level occurrences (not in a HARDWARE group)

| Occurrence | Screw | Clamps | Axis | Tip (X, Y, Z) | Receiving thread | Material | Engaged mm | x d | Threads | Need mm | Avail. mm | Gap mm | Result |
|---|---|---|---|---|---|---|---|---|---|---|---|---|---|
| SHCS ISO 4762 M3x12:38 | SHCS M3x12 | ST-02 | Z | 648.9, 141.0, 54.0 | 25T Al disc horn (Treedix) | Al 6061 | 2.00 | 0.67 | 4.0 | 3.0 | 2.00 | - | **FAIL** |
| SHCS ISO 4762 M3x12:39 | SHCS M3x12 | ST-02 | Z | 654.9, 148.9, 54.0 | 25T Al disc horn (Treedix) | Al 6061 | 2.00 | 0.67 | 4.0 | 3.0 | 2.00 | - | **FAIL** |
| SHCS ISO 4762 M3x12:40 | SHCS M3x12 | ST-02 | Z | 656.8, 135.1, 54.0 | 25T Al disc horn (Treedix) | Al 6061 | 2.00 | 0.67 | 4.0 | 3.0 | 2.00 | - | **FAIL** |
| SHCS ISO 4762 M3x12:41 | SHCS M3x12 | ST-02 | Z | 662.8, 143.0, 54.0 | 25T Al disc horn (Treedix) | Al 6061 | 2.00 | 0.67 | 4.0 | 3.0 | 2.00 | - | **FAIL** |
| SHCS ISO 4762 M5x20:8 | SHCS M5x20 | ST-08 bearing race spacer | Z | 535.6, 232.0, 47.0 | Heat-set insert M5 ruthex RX-M5x9.5 | brass | 8.00 | 1.60 | 10.0 | 5.0 | 9.50 | - | **PASS** |

- Al horn flange is 2.0 mm thick: 1.0d not reachable; same class as the CDR-24 carousel deck screws (full 2.0 mm flange accepted)

## Arm mounts

| Occurrence | Screw | Clamps | Axis | Tip (X, Y, Z) | Receiving thread | Material | Engaged mm | x d | Threads | Need mm | Avail. mm | Gap mm | Result |
|---|---|---|---|---|---|---|---|---|---|---|---|---|---|
| CSK ISO 10642 M4x20:2 | CSK M4x20 | (not in scene, e.g. SO-101 base) | Z | 302.7, 508.5, 17.0 | T-nut 2020 drop-in M4 | steel | 1.20 | 0.30 | 1.7 | 4.0 | 3.80 | - | **FAIL** |
| CSK ISO 10642 M4x20:3 | CSK M4x20 | (not in scene, e.g. SO-101 base) | Z | 358.3, 508.5, 17.0 | T-nut 2020 drop-in M4 | steel | 1.20 | 0.30 | 1.7 | 4.0 | 3.80 | - | **FAIL** |
| CSK ISO 10642 M4x20:4 | CSK M4x20 | (not in scene, e.g. SO-101 base) | Z | 542.7, 508.5, 17.0 | T-nut 2020 drop-in M4 | steel | 1.20 | 0.30 | 1.7 | 4.0 | 3.80 | - | **FAIL** |
| CSK ISO 10642 M4x20:5 | CSK M4x20 | (not in scene, e.g. SO-101 base) | Z | 598.3, 508.5, 17.0 | T-nut 2020 drop-in M4 | steel | 1.20 | 0.30 | 1.7 | 4.0 | 3.80 | - | **FAIL** |
| SHCS ISO 4762 M4x20:12 | SHCS M4x20 | (not in scene, e.g. SO-101 base) | Z | 298.2, 578.3, 16.2 | T-nut 2020 drop-in M4 | steel | 2.00 | 0.50 | 2.9 | 4.0 | 3.80 | - | **FAIL** |
| SHCS ISO 4762 M4x20:13 | SHCS M4x20 | (not in scene, e.g. SO-101 base) | Z | 361.6, 578.3, 16.2 | T-nut 2020 drop-in M4 | steel | 2.00 | 0.50 | 2.9 | 4.0 | 3.80 | - | **FAIL** |
| SHCS ISO 4762 M4x20:16 | SHCS M4x20 | (not in scene, e.g. SO-101 base) | Z | 538.2, 578.3, 16.2 | T-nut 2020 drop-in M4 | steel | 2.00 | 0.50 | 2.9 | 4.0 | 3.80 | - | **FAIL** |
| SHCS ISO 4762 M4x20:17 | SHCS M4x20 | (not in scene, e.g. SO-101 base) | Z | 601.6, 578.3, 16.2 | T-nut 2020 drop-in M4 | steel | 2.00 | 0.50 | 2.9 | 4.0 | 3.80 | - | **FAIL** |

- CDR-11: replace by ISO 7380 M4x20, 2.0 mm; T-nut is 3.8 mm long, so 1.0d is not reachable; accepted (PLA-boss-limited preload ~1 kN)

- CDR-11: unchanged, 2.0 mm accepted (T-nut 3.8 mm < 1.0d; PLA-boss-limited preload)

## Four-bar

| Occurrence | Screw | Clamps | Axis | Tip (X, Y, Z) | Receiving thread | Material | Engaged mm | x d | Threads | Need mm | Avail. mm | Gap mm | Result |
|---|---|---|---|---|---|---|---|---|---|---|---|---|---|
| SHCS ISO 4762 M5x20:5 | SHCS M5x20 | ST-08 bearing race spacer | Z | 655.6, 242.0, 47.0 | Heat-set insert M5 ruthex RX-M5x9.5 | brass | 8.00 | 1.60 | 10.0 | 5.0 | 9.50 | - | **PASS** |
| SHCS ISO 4762 M5x20:7 | SHCS M5x20 | ST-08 bearing race spacer | Z | 535.6, 332.0, 47.0 | Heat-set insert M5 ruthex RX-M5x9.5 | brass | 8.00 | 1.60 | 10.0 | 5.0 | 9.50 | - | **PASS** |

## Frame brackets

| Occurrence | Screw | Clamps | Axis | Tip (X, Y, Z) | Receiving thread | Material | Engaged mm | x d | Threads | Need mm | Avail. mm | Gap mm | Result |
|---|---|---|---|---|---|---|---|---|---|---|---|---|---|
| SHCS ISO 4762 M5x8:10 | SHCS M5x8 | 2020 inside corner bracket | Y | 276.6, 503.5, 10.0 | T-nut 2020 drop-in M5 | steel | 3.20 | 0.64 | 4.0 | 5.0 | 3.80 | - | **FAIL** |
| SHCS ISO 4762 M5x8:11 | SHCS M5x8 | 2020 inside corner bracket | X | 260.0, 486.5, 10.4 | T-nut 2020 drop-in M5 | steel | 3.20 | 0.64 | 4.0 | 5.0 | 3.80 | - | **FAIL** |
| SHCS ISO 4762 M5x8:12 | SHCS M5x8 | 2020 inside corner bracket | X | 260.0, 600.3, 10.4 | T-nut 2020 drop-in M5 | steel | 3.20 | 0.64 | 4.0 | 5.0 | 3.80 | - | **FAIL** |
| SHCS ISO 4762 M5x8:13 | SHCS M5x8 | 2020 inside corner bracket | Y | 276.6, 583.3, 10.0 | T-nut 2020 drop-in M5 | steel | 3.20 | 0.64 | 4.0 | 5.0 | 3.80 | - | **FAIL** |
| SHCS ISO 4762 M5x8:14 | SHCS M5x8 | 2020 inside corner bracket | X | 670.0, 486.5, 9.6 | T-nut 2020 drop-in M5 | steel | 3.20 | 0.64 | 4.0 | 5.0 | 3.80 | - | **FAIL** |
| SHCS ISO 4762 M5x8:15 | SHCS M5x8 | 2020 inside corner bracket | Y | 652.6, 503.5, 10.0 | T-nut 2020 drop-in M5 | steel | 3.20 | 0.64 | 4.0 | 5.0 | 3.80 | - | **FAIL** |
| SHCS ISO 4762 M5x8:16 | SHCS M5x8 | 2020 inside corner bracket | Y | 652.6, 583.3, 10.0 | T-nut 2020 drop-in M5 | steel | 3.20 | 0.64 | 4.0 | 5.0 | 3.80 | - | **FAIL** |
| SHCS ISO 4762 M5x8:17 | SHCS M5x8 | 2020 inside corner bracket | X | 670.0, 600.3, 9.6 | T-nut 2020 drop-in M5 | steel | 3.20 | 0.64 | 4.0 | 5.0 | 3.80 | - | **FAIL** |

- Not reviewed at CDR; T-nut-limited

## Measuring + auger station

| Occurrence | Screw | Clamps | Axis | Tip (X, Y, Z) | Receiving thread | Material | Engaged mm | x d | Threads | Need mm | Avail. mm | Gap mm | Result |
|---|---|---|---|---|---|---|---|---|---|---|---|---|---|
| SHCS ISO 4762 M3x12:42 | SHCS M3x12 | DH-01 yeast auger head | Z | 47.9, 262.5, 136.0 | AG-01 auger stand | PLA | 0.00 | 0.00 | 0.0 | 4.5 | 14.05 | 1.00 | **FAIL** |
| SHCS ISO 4762 M3x12:43 | SHCS M3x12 | DH-01 yeast auger head | Z | 61.9, 262.5, 136.0 | AG-01 auger stand | PLA | 0.00 | 0.00 | 0.0 | 4.5 | 14.05 | 1.00 | **FAIL** |
| SHCS ISO 4762 M5x12:14 | SHCS M5x12 | WS-01 scale base | Z | 409.6, 508.5, 16.0 | T-nut 2020 drop-in M5 | steel | 2.20 | 0.44 | 2.8 | 5.0 | 3.80 | - | **FAIL** |
| SHCS ISO 4762 M5x12:15 | SHCS M5x12 | WS-01 scale base | Z | 464.6, 508.5, 16.0 | T-nut 2020 drop-in M5 | steel | 2.20 | 0.44 | 2.8 | 5.0 | 3.80 | - | **FAIL** |
| SHCS ISO 4762 M5x12:20 | SHCS M5x12 | RK-02 reagent rack | Z | 674.6, 455.0, 14.2 | T-nut 2020 drop-in M5 | steel | 3.80 | 0.76 | 4.7 | 5.0 | 3.80 | - | **FAIL** |
| SHCS ISO 4762 M5x12:21 | SHCS M5x12 | RK-02 reagent rack | Z | 674.6, 545.0, 14.2 | T-nut 2020 drop-in M5 | steel | 3.80 | 0.76 | 4.7 | 5.0 | 3.80 | - | **FAIL** |
| SHCS ISO 4762 M5x12:22 | SHCS M5x12 | AG-01 auger stand | Z | 254.6, 291.0, 16.0 | T-nut 2020 drop-in M5 | steel | 2.20 | 0.44 | 2.8 | 5.0 | 3.80 | - | **FAIL** |
| SHCS ISO 4762 M5x12:23 | SHCS M5x12 | AG-01 auger stand | Z | 254.6, 309.0, 16.0 | T-nut 2020 drop-in M5 | steel | 2.20 | 0.44 | 2.8 | 5.0 | 3.80 | - | **FAIL** |

- AG-01/WS-01: CDR-03/06 Ø10x1.5 counterbore -> 3.35-4.05 mm; RK-02 already full T-nut

- CDR-01: replace by SHCS M3x20, tip Z128, 7.0 mm (2.3d) in the AG-01 pilot

## Saddle bolts

| Occurrence | Screw | Clamps | Axis | Tip (X, Y, Z) | Receiving thread | Material | Engaged mm | x d | Threads | Need mm | Avail. mm | Gap mm | Result |
|---|---|---|---|---|---|---|---|---|---|---|---|---|---|
| SHCS ISO 4762 M5x12:6 | SHCS M5x12 | TT-01 | Z | 254.6, 355.0, 16.0 | T-nut 2020 drop-in M5 | steel | 2.20 | 0.44 | 2.8 | 5.0 | 3.80 | - | **FAIL** |
| SHCS ISO 4762 M5x12:7 | SHCS M5x12 | TT-01 | Z | 254.6, 385.0, 16.0 | T-nut 2020 drop-in M5 | steel | 2.20 | 0.44 | 2.8 | 5.0 | 3.80 | - | **FAIL** |
| SHCS ISO 4762 M5x12:8 | SHCS M5x12 | ST-01 | Z | 674.6, 280.0, 16.0 | T-nut 2020 drop-in M5 | steel | 2.20 | 0.44 | 2.8 | 5.0 | 3.80 | - | **FAIL** |
| SHCS ISO 4762 M5x12:9 | SHCS M5x12 | ST-01 | Z | 674.6, 298.0, 16.0 | T-nut 2020 drop-in M5 | steel | 2.20 | 0.44 | 2.8 | 5.0 | 3.80 | - | **FAIL** |

- CDR-24: TT-01/ST-01 saddles not reprinted, 2.2 mm accepted (PLA-roof-limited preload, SF ~1.5 install / >40 service)

## Servos

| Occurrence | Screw | Clamps | Axis | Tip (X, Y, Z) | Receiving thread | Material | Engaged mm | x d | Threads | Need mm | Avail. mm | Gap mm | Result |
|---|---|---|---|---|---|---|---|---|---|---|---|---|---|
| SHCS ISO 4762 M3x12:14 | SHCS M3x12 | FlashHobby M45CHW + 25T disc horn | Z | 140.6, 365.1, 21.3 | TT-01 | PLA | 8.05 | 2.68 | 16.1 | 4.5 | 23.05 | - | **PASS** |
| SHCS ISO 4762 M3x12:15 | SHCS M3x12 | FlashHobby M45CHW + 25T disc horn | Z | 140.6, 374.9, 21.3 | TT-01 | PLA | 8.05 | 2.68 | 16.1 | 4.5 | 23.05 | - | **PASS** |
| SHCS ISO 4762 M3x12:16 | SHCS M3x12 | FlashHobby M45CHW + 25T disc horn | Z | 189.2, 365.1, 21.3 | TT-01 | PLA | 8.05 | 2.68 | 16.1 | 4.5 | 23.05 | - | **PASS** |
| SHCS ISO 4762 M3x12:17 | SHCS M3x12 | FlashHobby M45CHW + 25T disc horn | Z | 189.2, 374.9, 21.3 | TT-01 | PLA | 8.05 | 2.68 | 16.1 | 4.5 | 23.05 | - | **PASS** |
| SHCS ISO 4762 M3x12:18 | SHCS M3x12 | FlashHobby M45CHW + 25T disc horn | Z | 690.1, 146.9, 27.3 | ST-01 | PLA | 8.05 | 2.68 | 16.1 | 4.5 | 23.05 | - | **PASS** |
| SHCS ISO 4762 M3x12:19 | SHCS M3x12 | FlashHobby M45CHW + 25T disc horn | Z | 690.1, 137.1, 27.3 | ST-01 | PLA | 8.05 | 2.68 | 16.1 | 4.5 | 23.05 | - | **PASS** |
| SHCS ISO 4762 M3x12:20 | SHCS M3x12 | FlashHobby M45CHW + 25T disc horn | Z | 641.5, 146.9, 27.3 | ST-01 | PLA | 8.05 | 2.68 | 16.1 | 4.5 | 23.05 | - | **PASS** |
| SHCS ISO 4762 M3x12:21 | SHCS M3x12 | FlashHobby M45CHW + 25T disc horn | Z | 641.5, 137.1, 27.3 | ST-01 | PLA | 8.05 | 2.68 | 16.1 | 4.5 | 23.05 | - | **PASS** |

## Summary by fastener group

| Group | Screw | Clamps | Receiving | Qty | Engaged mm (min-max) | x d (min) | Threads (min) | Result | CDR disposition |
|---|---|---|---|---|---|---|---|---|---|
| (root) | SHCS M3x12 | ST-02 | 25T Al disc horn (Treedix) | 4 | 2.00-2.00 | 0.67 | 4.0 | **FAIL** | Al horn flange is 2.0 mm thick: 1.0d not reachable; same class as the CDR-24 carousel deck screws (full 2.0 mm flange accepted) |
| (root) | SHCS M5x20 | ST-08 bearing race spacer | Heat-set insert M5 ruthex RX-M5x9.5 | 1 | 8.00-8.00 | 1.60 | 10.0 | **PASS** |  |
| Arm mounts | CSK M4x20 | (not in scene, e.g. SO-101 base) | T-nut 2020 drop-in M4 | 4 | 1.20-1.20 | 0.30 | 1.7 | **FAIL** | CDR-11: replace by ISO 7380 M4x20, 2.0 mm; T-nut is 3.8 mm long, so 1.0d is not reachable; accepted (PLA-boss-limited preload ~1 kN) |
| Arm mounts | SHCS M4x20 | (not in scene, e.g. SO-101 base) | T-nut 2020 drop-in M4 | 4 | 2.00-2.00 | 0.50 | 2.9 | **FAIL** | CDR-11: unchanged, 2.0 mm accepted (T-nut 3.8 mm < 1.0d; PLA-boss-limited preload) |
| Four-bar | SHCS M5x20 | ST-08 bearing race spacer | Heat-set insert M5 ruthex RX-M5x9.5 | 2 | 8.00-8.00 | 1.60 | 10.0 | **PASS** |  |
| Frame brackets | SHCS M5x8 | 2020 inside corner bracket | T-nut 2020 drop-in M5 | 8 | 3.20-3.20 | 0.64 | 4.0 | **FAIL** | Not reviewed at CDR; T-nut-limited |
| Measuring + auger station | SHCS M3x12 | DH-01 yeast auger head | AG-01 auger stand | 2 | 0.00-0.00 | 0.00 | 0.0 | **FAIL** | CDR-01: replace by SHCS M3x20, tip Z128, 7.0 mm (2.3d) in the AG-01 pilot |
| Measuring + auger station | SHCS M5x12 | AG-01 auger stand | T-nut 2020 drop-in M5 | 2 | 2.20-2.20 | 0.44 | 2.8 | **FAIL** | AG-01/WS-01: CDR-03/06 Ø10x1.5 counterbore -> 3.35-4.05 mm; RK-02 already full T-nut |
| Measuring + auger station | SHCS M5x12 | RK-02 reagent rack | T-nut 2020 drop-in M5 | 2 | 3.80-3.80 | 0.76 | 4.7 | **FAIL** | AG-01/WS-01: CDR-03/06 Ø10x1.5 counterbore -> 3.35-4.05 mm; RK-02 already full T-nut |
| Measuring + auger station | SHCS M5x12 | WS-01 scale base | T-nut 2020 drop-in M5 | 2 | 2.20-2.20 | 0.44 | 2.8 | **FAIL** | AG-01/WS-01: CDR-03/06 Ø10x1.5 counterbore -> 3.35-4.05 mm; RK-02 already full T-nut |
| Saddle bolts | SHCS M5x12 | ST-01 | T-nut 2020 drop-in M5 | 2 | 2.20-2.20 | 0.44 | 2.8 | **FAIL** | CDR-24: TT-01/ST-01 saddles not reprinted, 2.2 mm accepted (PLA-roof-limited preload, SF ~1.5 install / >40 service) |
| Saddle bolts | SHCS M5x12 | TT-01 | T-nut 2020 drop-in M5 | 2 | 2.20-2.20 | 0.44 | 2.8 | **FAIL** | CDR-24: TT-01/ST-01 saddles not reprinted, 2.2 mm accepted (PLA-roof-limited preload, SF ~1.5 install / >40 service) |
| Servos | SHCS M3x12 | FlashHobby M45CHW + 25T disc horn | ST-01 | 4 | 8.05-8.05 | 2.68 | 16.1 | **PASS** |  |
| Servos | SHCS M3x12 | FlashHobby M45CHW + 25T disc horn | TT-01 | 4 | 8.05-8.05 | 2.68 | 16.1 | **PASS** |  |

## Not checkable from meshes.json

- Carousel deck screws (README row 519, M3x10 into the 25T horn): no screw occurrence is present in the export (neither `scene` nor `carousel`). Per M-21: tip Z48.6 in the Z48-50 flange = 1.4 mm (0.47d) **FAIL**; CDR-24 changes them to SHCS M3x12 (tip Z46.6, full 2.0 mm flange, 0.67d, accepted: the flange is the limit).
- Arm-base screws pass through the borrowed SO-101 base, which is excluded from the scene; only the T-nut engagement is checked here, which is the governing thread.
- Any nut not modelled (e.g. DIN 985 locknuts on GR-03, CDR-16) is not in the scene and is not checked.
