shaoming11/hh-winners/analysis/load_cases.md

# Load cases (CDR-28)

Generated by `python analysis/load_cases.py`. Do not edit by hand.

**Allowables** (FDM PLA, scatter-adjusted): across layers 10 MPa, along layers 30 MPa, bearing 50 MPa; VHB 4950 0.3 MPa sustained shear.  
**Criteria:** OP (operational) SF >= 2 against the allowable. ACC (accident, two-fault) SF >= 1 against the allowable and SF >= 2 against 20/40 MPa. CHECK/TEST rows state their own criterion. Kt from Peterson stepped-bar fits with the measured root radii (fillet_report.md not yet generated; see notes).

Servo stall 4.413 N*m (M45CHW 45 kg*cm at 8.4 V).

**Summary:** 57 rows, 14 FAIL: 1d-sleeved, 2-1s, 3a, 3b-t, 3c, 3d, 4--X-v1, 4--Y-v1, 5b, 5c, 8-40-PLA, 8-50-PLA, 9, 12-v1.

**FAIL dispositions:**

- **1d-sleeved** Stop post v1, Z35.5 post top above the web (governing), sleeved: ST-01 v1 knife edge (SF 0.96-1.0). ST-01 v2 fin is mandatory before the live demo (CDR-07); until then accepted-risk entry signed by the lead.
- **2-1s** Stop impact, 1 s move (wrong profile, fault on fault): post force and v1 Z35.5 stress: Only reachable with a wrong motion profile AND a failed firmware clamp; CDR-09 enforces >= 3 s smoothstep (row 2-3s passes).
- **3a** DH-01 v1 Y=299 joint: continuous section (sliver): v1 geometry, not printed; replaced by the CDR-02 web.
- **3b-t** DH-01 v1 sliver torsion, 10 N lateral at the hopper rim (Z205): v1 geometry, not printed; replaced by the CDR-02 web.
- **3c** DH-01 v2 Y=299 joint: continuous section with the web X79-95, Z135-152: **Open issue for CDR-02:** the web as drawn (X79-95) cannot meet the >= 700 mm^2 continuous-section acceptance at Y=299; it only reaches ~213-296 mm^2. Either widen the web across the bridge face or restate the acceptance (bridge face area vs two-sided transfer area). Stress rows 3e/3f pass with large margin, so this is an acceptance-wording/geometry decision for the chief engineer.
- **3d** DH-01 v2 Y=320 section (web + tube ring + hopper walls): Predicted from v1 hopper walls; the v2 hopper (60 deg walls) must be sliced. Below 600 mm^2 on this estimate.
- **4--X-v1** AG-01 rocking, 20 N -X (pivot on foot X edge), v1 20x12 bar: v1 geometry; v2 (30x16 bar) passes.
- **4--Y-v1** AG-01 rocking, 20 N -Y (pivot on foot Y edge, bar bending + torsion), v1 20x12 bar: v1 geometry; v2 passes at 0.47 deg (thin margin against 0.5 deg).
- **5b** DH-02 v1 jam 0.25 N*m, hub annulus D5.1/D3.1, sharp step: v1 geometry; DH-02 v2 passes (row 5a). Both superseded by DH-02 v3 (servo change, 2026-10-14).
- **5c** DH-02 v3 jam at full FB5311M-360 stall 1.52 N*m, D8 hub: Servo change, 2026-10-14: a full FB5311M-360 stall overloads the D8 PLA hub. Mitigation: mandatory firmware stall rule on the A2 feedback (150 ms), DH-02 v3 at 100 % infill, 1 spare printed.
- **8-40-PLA** Hot-wetted ST-04/05/07 at 40 mL charge vs PLA HDT: Accepted by CDR-18 if PLA: kPa stress, roundness check after each run. Confirm the as-printed material.
- **8-50-PLA** Hot-wetted ST-04/05/07 at 50 mL charge vs PLA HDT: 50 mL is above the 40 mL cap; shown for reference.
- **9** Foam volume at the 40 mL cap vs ST-07 well annulus: By design: overflow is contained by the drop cloth and pads (CDR-19).
- **12-v1** TT-04 pocket wall, 10 N side load at the rim (v1 printed: 16 tall, 2.4 wall, R0.8): Accident only (rim strike) after the CDR-15 lead-ins; v1 is the printed part. If TT-04 is unprinted, v2 (12 mm walls, R1.5) passes.

Rows 10b, 10c, 10d, 10e, 10f, 10h, 10i meet thread-strip vs preload but miss the reach rule (receiving thread shorter than 1.0 d); accepted by CDR-11/24.

| # | Case | Cat | Demand | Capacity | SF | SF vs 20/40 | Criterion | Result | CDR |
|---|---|---|---|---|---|---|---|---|---|
| 1a | Stop post contact force at stall, bare (crank 39 deg) | INFO | 189 N | - | - | - | - | **-** | CDR-07 |
| 1b | Stop post contact force at stall, ST-09 sleeved | INFO | 197 N | - | - | - | - | **-** | CDR-08 |
| 1c-bare | Stop post v1, Z7.3 composite root (post + web + cradle wall), bare | ACC | 6.65 MPa | 10.0 MPa | 1.50 | 3.01 | SF >= 1.0 and >= 2.0 vs 20 | **PASS** | CDR-07 |
| 1c-sleeved | Stop post v1, Z7.3 composite root (post + web + cradle wall), sleeved | ACC | 6.95 MPa | 10.0 MPa | 1.44 | 2.88 | SF >= 1.0 and >= 2.0 vs 20 | **PASS** | CDR-07 |
| 1d-bare | Stop post v1, Z35.5 post top above the web (governing), bare | ACC | 10.00 MPa | 10.0 MPa | 1.00 | 2.00 | SF >= 1.0 and >= 2.0 vs 20 | **PASS** | CDR-07 |
| 1d-sleeved | Stop post v1, Z35.5 post top above the web (governing), sleeved | ACC | 10.5 MPa | 10.0 MPa | 0.96 | 1.91 | SF >= 1.0 and >= 2.0 vs 20 | **FAIL** | CDR-07 |
| 1e | Stop post v2, Z54 fin top (sleeved) | ACC | 3.11 MPa | 10.0 MPa | 3.22 | 6.43 | SF >= 1.0 and >= 2.0 vs 20 | **PASS** | CDR-07 |
| 2-3s | Stop impact, 3 s smoothstep (CDR-09 minimum): post force and v1 Z35.5 stress | ACC | 4.84 MPa | 10.0 MPa | 2.07 | 4.14 | SF >= 1.0 and >= 2.0 vs 20 | **PASS** | CDR-09 |
| 2-1s | Stop impact, 1 s move (wrong profile, fault on fault): post force and v1 Z35.5 stress | ACC | 14.5 MPa | 10.0 MPa | 0.69 | 1.38 | SF >= 1.0 and >= 2.0 vs 20 | **FAIL** | CDR-09 |
| 3a | DH-01 v1 Y=299 joint: continuous section (sliver) | CHECK | 700 mm^2 | 58.7 mm^2 | 0.08 | - | SF >= 1 | **FAIL** | CDR-02 |
| 3b | DH-01 v1 sliver under 10 N hand load on the hopper | OP | 7.38 MPa | 30.0 MPa | 4.06 | - | SF >= 2.0 | **PASS** | CDR-02 |
| 3b-t | DH-01 v1 sliver torsion, 10 N lateral at the hopper rim (Z205) | OP | 8.01 MPa | 10.0 MPa | 1.25 | - | SF >= 2.0 | **FAIL** | CDR-02 |
| 3c | DH-01 v2 Y=299 joint: continuous section with the web X79-95, Z135-152 | CHECK | 700 mm^2 | 213 mm^2 | 0.30 | - | SF >= 1 | **FAIL** | CDR-02 |
| 3d | DH-01 v2 Y=320 section (web + tube ring + hopper walls) | CHECK | 600 mm^2 | 507 mm^2 | 0.84 | - | SF >= 1 | **FAIL** | CDR-02 |
| 3e | DH-01 v2 web joint under 10 N hand load (bending) | OP | 0.86 MPa | 30.0 MPa | 34.81 | - | SF >= 2.0 | **PASS** | CDR-02 |
| 3f | DH-01 v2 web joint: torsion (hand 10 N lateral + N20 stall 0.35 N*m) | OP | 2.05 MPa | 10.0 MPa | 4.87 | - | SF >= 2.0 | **PASS** | CDR-02 |
| 4a | AG-01 v2 post root, 20 N at Z180 (worst axis, Z_y 3125) | OP | 1.42 MPa | 10.0 MPa | 7.05 | - | SF >= 2.0 | **PASS** | CDR-03 |
| 4--X-v1 | AG-01 rocking, 20 N -X (pivot on foot X edge), v1 20x12 bar | OP | 0.54 deg | 0.50 deg | 0.93 | - | SF >= 1.0 | **FAIL** | CDR-03 |
| 4--X-v2 | AG-01 rocking, 20 N -X (pivot on foot X edge), v2 30x16 bar | OP | 0.15 deg | 0.50 deg | 3.32 | - | SF >= 1.0 | **PASS** | CDR-03 |
| 4--Y-v1 | AG-01 rocking, 20 N -Y (pivot on foot Y edge, bar bending + torsion), v1 20x12 bar | OP | 1.70 deg | 0.50 deg | 0.29 | - | SF >= 1.0 | **FAIL** | CDR-03 |
| 4--Y-v2 | AG-01 rocking, 20 N -Y (pivot on foot Y edge, bar bending + torsion), v2 30x16 bar | OP | 0.47 deg | 0.50 deg | 1.07 | - | SF >= 1.0 | **PASS** | CDR-03 |
| 5a | DH-02 v2 jam 0.25 N*m, D7 hub at the D9 collar (R2) | OP | 4.33 MPa | 10.0 MPa | 2.31 | - | SF >= 2.0 | **PASS** | CDR-04 |
| 5b | DH-02 v1 jam 0.25 N*m, hub annulus D5.1/D3.1, sharp step | OP | 22.2 MPa | 10.0 MPa | 0.45 | - | SF >= 2.0 | **FAIL** | CDR-04 |
| 5c | DH-02 v3 jam at full FB5311M-360 stall 1.52 N*m, D8 hub | ACC | 15.1 MPa | 10.0 MPa | 0.66 | - | SF >= 1.0 | **FAIL** | servo change 2026-10-14 |
| 6a | Grip pull-out vs 100 mL beaker + 80 mL developer, 1 g + 1 g shake | TEST | 2.12 N | 3.20 N | 1.51 | - | SF >= 1.5 | **PASS** | CDR-13 |
| 7a | Load cell: arm place force + max demo load vs stop engagement | CHECK | 7.92 N | 11.8 N | 1.49 | - | SF >= 1 | **PASS** | CDR-06 |
| 7b | Load cell: stop engagement (upper) vs 150 % safe overload | ACC | 13.7 N | 14.7 N | 1.07 | - | SF >= 1.0 | **PASS** | CDR-06 |
| 8-40-PLA | Hot-wetted ST-04/05/07 at 40 mL charge vs PLA HDT | CHECK | 57.5 C | 55.0 C | 0.96 | - | SF >= 1 | **FAIL** | CDR-18 |
| 8-40-PETG | Hot-wetted ST-04/05/07 at 40 mL charge vs PETG HDT | CHECK | 57.5 C | 70.0 C | 1.22 | - | SF >= 1 | **PASS** | CDR-18 |
| 8-50-PLA | Hot-wetted ST-04/05/07 at 50 mL charge vs PLA HDT | CHECK | 62.0 C | 55.0 C | 0.89 | - | SF >= 1 | **FAIL** | CDR-18 |
| 8-50-PETG | Hot-wetted ST-04/05/07 at 50 mL charge vs PETG HDT | CHECK | 62.0 C | 70.0 C | 1.13 | - | SF >= 1 | **PASS** | CDR-18 |
| 9 | Foam volume at the 40 mL cap vs ST-07 well annulus | CHECK | 1.94 L | 0.65 L | 0.34 | - | SF >= 1 | **FAIL** | CDR-19 |
| 10a | Engagement: DH-01 -> AG-01, SHCS M3x20 self-tapped D2.5 pilot | OP | 30.0 N | 396 N | 13.19 | - | strip SF >= 2.0; reach >= 1.5 d | **PASS** | CDR-01 |
| 10b | Engagement: Arm front row, ISO 7380 M4x20 into steel T-nut | OP | 1000 N | 1822 N | 1.82 | - | strip SF >= 1.5; reach >= 1.0 d | **ACCEPTED (strip PASS, reach FAIL)** | CDR-11 |
| 10c | Engagement: Arm back row, SHCS M4x20 into steel T-nut | OP | 1000 N | 1822 N | 1.82 | - | strip SF >= 1.5; reach >= 1.0 d | **ACCEPTED (strip PASS, reach FAIL)** | CDR-11 |
| 10d | Engagement: TT-01/ST-01 saddle M5x12 into T-nut (no counterbore) | OP | 1650 N | 2505 N | 1.52 | - | strip SF >= 1.5; reach >= 1.0 d | **ACCEPTED (strip PASS, reach FAIL)** | CDR-24 |
| 10e | Engagement: AG-01/WS-01 v2 saddle M5x12, D10x1.5 counterbore (min) | OP | 1650 N | 3815 N | 2.31 | - | strip SF >= 1.5; reach >= 1.0 d | **ACCEPTED (strip PASS, reach FAIL)** | CDR-03/06 |
| 10f | Engagement: RK-02 M5x12 into T-nut (full nut) | OP | 1650 N | 4328 N | 2.62 | - | strip SF >= 1.5; reach >= 1.0 d | **ACCEPTED (strip PASS, reach FAIL)** | CDR-24 |
| 10g | Engagement: Four-bar pivot M5x20 into ruthex M5 insert | OP | 500 N | 10933 N | 21.87 | - | strip SF >= 1.5; reach >= 1.0 d | **PASS** |  |
| 10h | Engagement: Carousel deck SHCS M3x12 into 25T Al horn (2.0 mm flange) | OP | 500 N | 1585 N | 3.17 | - | strip SF >= 1.5; reach >= 1.0 d | **ACCEPTED (strip PASS, reach FAIL)** | CDR-24 |
| 10i | Engagement: Stage crank SHCS M3x12 into 25T Al horn (2.0 mm flange) | OP | 500 N | 1585 N | 3.17 | - | strip SF >= 1.5; reach >= 1.0 d | **ACCEPTED (strip PASS, reach FAIL)** |  |
| 10j | Engagement: Servo ears SHCS M3x12 into TT-01/ST-01 D2.5 pilots | OP | 150 N | 452 N | 3.02 | - | strip SF >= 2.0; reach >= 1.5 d | **PASS** |  |
| 11a | Carousel: liner friction torque (bottom plate floating) vs servo torque | OP | 0.07 N*m | 3.43 N*m | 47.67 | - | SF >= 2.0 | **PASS** | CDR-10 |
| 11b | Carousel: upper VHB (top plate to deck) shear from the friction drag | OP | 0.00 MPa | 0.30 MPa | 1100.00 | - | SF >= 2.0 | **PASS** | CDR-10 |
| 12-v1 | TT-04 pocket wall, 10 N side load at the rim (v1 printed: 16 tall, 2.4 wall, R0.8) | ACC | 11.0 MPa | 10.0 MPa | 0.91 | 1.82 | SF >= 1.0 and >= 2.0 vs 20 | **FAIL** | CDR-14/15 |
| 12-v2 | TT-04 pocket wall, 10 N side load at the rim (v2 if unprinted: 12 tall (CDR-14), 2.4 wall, R1.5) | ACC | 7.40 MPa | 10.0 MPa | 1.35 | 2.70 | SF >= 1.0 and >= 2.0 vs 20 | **PASS** | CDR-14/15 |
| 13a | Servo ear screws at stall: PLA bearing on the M3 shank | ACC | 1.89 MPa | 50.0 MPa | 26.43 | - | SF >= 1.0 | **PASS** |  |
| 13b | Servo ear screws at stall: M3 shank shear (8.8) | ACC | 9.03 MPa | 384 MPa | 42.54 | - | SF >= 1.0 | **PASS** |  |
| 13c | Servo ear (servo case) bearing on the screw | ACC | 6.05 MPa | 50.0 MPa | 8.26 | - | SF >= 1.0 | **PASS** |  |
| 14a | Carousel: servo torque to index 45 deg in 0.6 s (8 full beakers) | OP | 0.13 N*m | 3.43 N*m | 26.36 | - | SF >= 2.0 | **PASS** |  |
| 14b | Carousel: M3 horn screws, PLA bearing in deck + spacer at stall | ACC | 6.49 MPa | 50.0 MPa | 7.71 | - | SF >= 1.0 | **PASS** |  |
| 14c | Stage: crank torque, breakaway + accel (180 mm in 1 s, worst) | OP | 0.33 N*m | 3.43 N*m | 10.51 | - | SF >= 2.0 | **PASS** |  |
| 14d | Crank bending at the hub, servo stalled (in plane, along layers) | ACC | 9.93 MPa | 30.0 MPa | 3.02 | 4.03 | SF >= 1.0 and >= 2.0 vs 40 | **PASS** |  |
| 14e | ST-04 tray posts (D20), stall load, R<=0.5 root | ACC | 4.96 MPa | 10.0 MPa | 2.02 | 4.03 | SF >= 1.0 and >= 2.0 vs 20 | **PASS** | CDR-12 |
| 14f | F625ZZ bearing radial load at stall | OP | 29.4 N | 1100 N | 37.39 | - | SF >= 2.0 | **PASS** |  |
| 14g | SO-101 base: tension per M4 bolt vs PLA-limited preload | OP | 37.9 N | 1000 N | 26.36 | - | SF >= 2.0 | **PASS** | CDR-11 |
| 14h | Frame: horizontal shove vs friction from 2 C-clamps | OP | 30.0 N | 600 N | 20.00 | - | SF >= 2.0 | **PASS** |  |

## Formulas and inputs

**1a Stop post contact force at stall, bare (crank 39 deg)**  
Formula: `F = T_stall / sqrt(r_c^2 - (10 + r_post + t_sleeve)^2)`  
Inputs: T_stall = 4.413 N*m (45 kg*cm), r_c = 30.15, r_post = 9.0, t_sleeve = 0 -> lever 23.41 mm  
Note: X 146 N, -Y 119 N  

**1b Stop post contact force at stall, ST-09 sleeved**  
Formula: `F = T_stall / sqrt(r_c^2 - (10 + r_post + t_sleeve)^2)`  
Inputs: t_sleeve = 1.2 -> lever 22.38 mm  
Note: X 153 N, -Y 124 N. Design value.  

**1c-bare Stop post v1, Z7.3 composite root (post + web + cradle wall), bare**  
Formula: `sigma = Kt (Fx L / Zx + Fy L / Zy)`  
Inputs: F = 189 N at Z61, L = 53.7, A 662 mm^2, Zx 4008, Zy 2580 mm^3, Kt 1.5 (R2.0; Peterson full shoulder r/d 0.11, D/d 1.5: 1.69)  
Note: sigma_nom 4.43 MPa. Across layers.  

**1c-sleeved Stop post v1, Z7.3 composite root (post + web + cradle wall), sleeved**  
Formula: `sigma = Kt (Fx L / Zx + Fy L / Zy)`  
Inputs: F = 197 N at Z61, L = 53.7, A 662 mm^2, Zx 4008, Zy 2580 mm^3, Kt 1.5 (R2.0; Peterson full shoulder r/d 0.11, D/d 1.5: 1.69)  
Note: sigma_nom 4.64 MPa. Across layers.  

**1d-bare Stop post v1, Z35.5 post top above the web (governing), bare**  
Formula: `sigma = Kt F L / Z (resultant, minimum Z)`  
Inputs: F = 189 N, L = 25.5, Z = 577 mm^3 (A 260), Kt 1.2 (R2.0 partial shoulder, ruling value; Peterson full shoulder 1.69)  
Note: sigma_nom 8.33 MPa. v1 knife edge: ST-01 v2 mandatory before the live demo; accepted-risk wording if not fitted.  

**1d-sleeved Stop post v1, Z35.5 post top above the web (governing), sleeved**  
Formula: `sigma = Kt F L / Z (resultant, minimum Z)`  
Inputs: F = 197 N, L = 25.5, Z = 577 mm^3 (A 260), Kt 1.2 (R2.0 partial shoulder, ruling value; Peterson full shoulder 1.69)  
Note: sigma_nom 8.71 MPa. v1 knife edge: ST-01 v2 mandatory before the live demo; accepted-risk wording if not fitted.  

**1e Stop post v2, Z54 fin top (sleeved)**  
Formula: `sigma = Kt F L / Z`  
Inputs: F = 197 N, L = 61 - 54 = 7.0, Z = 577 mm^3, Kt 1.3 (R3 fin-to-post)  
Note: Predicted. Acceptance (CDR-07): slice the v2 STL, sigma_peak <= 10 MPa at every Z 5-66 under 197 N at Z61. At Z35.3 the post+fin section (>330 mm^2) carries 197 N x 25.7 mm with no notch.  

**2-3s Stop impact, 3 s smoothstep (CDR-09 minimum): post force and v1 Z35.5 stress**  
Formula: `F_tip = v sqrt(m k_s); F_post = F_tip L_crank / a; sigma = Kt F_post L / Z`  
Inputs: m 0.69 kg, v = 1.5 s/T = 0.090 m/s, k_crank = 3EI/L^3 = 33.7 N/mm (L 127.6), k_post 3187 N/mm, k_s 33.3 N/mm, L_crank 150, a 22.38 -> F_post 91 N; Z35.5: L 25.5, Z 577, Kt 1.2  
Note: Sleeve compliance ignored (conservative). Tray mass reflected 1:1 to the crank tip.  

**2-1s Stop impact, 1 s move (wrong profile, fault on fault): post force and v1 Z35.5 stress**  
Formula: `F_tip = v sqrt(m k_s); F_post = F_tip L_crank / a; sigma = Kt F_post L / Z`  
Inputs: m 0.69 kg, v = 1.5 s/T = 0.270 m/s, k_crank = 3EI/L^3 = 33.7 N/mm (L 127.6), k_post 3187 N/mm, k_s 33.3 N/mm, L_crank 150, a 22.38 -> F_post 274 N; Z35.5: L 25.5, Z 577, Kt 1.2  
Note: Sleeve compliance ignored (conservative). Tray mass reflected 1:1 to the crank tip.  

**3a DH-01 v1 Y=299 joint: continuous section (sliver)**  
Formula: `A_cont = area(slice Y298.95 AND slice Y299.05)`  
Inputs: meshes.json slice (0.25 mm raster, point-in-mesh): bridge side 707 mm^2, tube side 257 mm^2  
Note: Strip ~15.6 x 4 mm, Z_bend ~42 mm^3. v1 is not printed (CDR-02 web is P0-before-print).  

**3b DH-01 v1 sliver under 10 N hand load on the hopper**  
Formula: `sigma = M / Z_bend`  
Inputs: M = 10 N x 31 mm = 310 N*mm, Z_bend 42 mm^3 (M-02); torsion 10 N x 58 mm = 580 N*mm -> tau ~8 MPa on 15.6 x 4  
Note: Bending along layers; torsional shear ~8 MPa vs 10 also fails.  

**3b-t DH-01 v1 sliver torsion, 10 N lateral at the hopper rim (Z205)**  
Formula: `tau = T / (alpha b c^2), alpha 0.29`  
Inputs: T = 580 N*mm, b 15.6, c 4 (M-02)  
Note: No Kt applied (would be worse).  

**3c DH-01 v2 Y=299 joint: continuous section with the web X79-95, Z135-152**  
Formula: `A_cont = area(bridge side AND (tube side OR web) minus v2 bore D14)`  
Inputs: web 16 x 17 joined at the bridge face; web-in-bridge overlap 213 mm^2; R3 web-to-bridge fillets add ~83 mm^2 near the face  
Note: Predicted from the v1 mesh + web box (v2 STL not exported yet). The web only spans X79-95 of the 60-wide bridge, so the load-transfer area across Y=299 cannot reach 700 mm^2 as drawn (+fillets ~296). The >=700 figure is met only if the whole bridge face is counted. RECORD the measured v2 value here.  

**3d DH-01 v2 Y=320 section (web + tube ring + hopper walls)**  
Formula: `A = area(slice Y320 OR web, minus v2 bore D14)`  
Inputs: v1 section at Y320 337 mm^2 (v1 hopper geometry)  
Note: Predicted; v2 hopper walls (60 deg, slot Y312-344) change this. RECORD the measured v2 value here.  

**3e DH-01 v2 web joint under 10 N hand load (bending)**  
Formula: `sigma = Kt M / Z_web, Z_web = b h^2 / 6`  
Inputs: M 310 N*mm, b 16, h 13.9 -> Z 515 mm^3, Kt(R3) 1.43  

**3f DH-01 v2 web joint: torsion (hand 10 N lateral + N20 stall 0.35 N*m)**  
Formula: `tau = Kt T / (alpha b c^2), alpha 0.21`  
Inputs: T = 580 + 350 N*mm, b 16, c 13.9, Kt 1.43  
Note: Shear allowable taken as the across-layer 10 MPa (conservative). SUPERSEDED by the servo change, 2026-10-14: the N20 is replaced by the Feetech FB5311M-360 on the DH-01 v3 mounting wall (stall 1.52 N*m at 6 V); this row is the v2/N20 record and has not been re-run for v3.  

**4a AG-01 v2 post root, 20 N at Z180 (worst axis, Z_y 3125)**  
Formula: `sigma = Kt F (Z_load - Z_root) / Z`  
Inputs: F 20 N, lever 168 mm -> M 3360 N*mm, post 30 x 25 (Z_x 3750, Z_y 3125 mm^3), R8 root Kt 1.32  

**4--X-v1 AG-01 rocking, 20 N -X (pivot on foot X edge), v1 20x12 bar**  
Formula: `theta = F H / k_theta`  
Inputs: F 20 N, H 180 mm, k_theta 3.85e+05 N*mm/rad (M-06 beam-matrix model)  
Note: Hopper top moves 1.9 mm. +X/+Y bear on the bar/saddle side and are stiffer.  

**4--X-v2 AG-01 rocking, 20 N -X (pivot on foot X edge), v2 30x16 bar**  
Formula: `theta = F H / k_theta`  
Inputs: F 20 N, H 180 mm, k_theta 1.37e+06 N*mm/rad (M-06 beam-matrix model, scaled by bar EI/GJ ratio 3.56)  
Note: Hopper top moves 0.5 mm. +X/+Y bear on the bar/saddle side and are stiffer.  

**4--Y-v1 AG-01 rocking, 20 N -Y (pivot on foot Y edge, bar bending + torsion), v1 20x12 bar**  
Formula: `theta = F H / k_theta`  
Inputs: F 20 N, H 180 mm, k_theta 1.21e+05 N*mm/rad (M-06 beam-matrix model)  
Note: Hopper top moves 6.1 mm. +X/+Y bear on the bar/saddle side and are stiffer.  

**4--Y-v2 AG-01 rocking, 20 N -Y (pivot on foot Y edge, bar bending + torsion), v2 30x16 bar**  
Formula: `theta = F H / k_theta`  
Inputs: F 20 N, H 180 mm, k_theta 4.42e+05 N*mm/rad (M-06 beam-matrix model, scaled by bar EI/GJ ratio 3.65)  
Note: Hopper top moves 1.7 mm. +X/+Y bear on the bar/saddle side and are stiffer.  

**5a DH-02 v2 jam 0.25 N*m, D7 hub at the D9 collar (R2)**  
Formula: `tau = Kt 16 T / (pi d^3)`  
Inputs: T 250 N*mm (N20 6 V stall at the 6.0 V-compensated duty), d 7, Peterson torsion D9/d7/r2: Kt 1.17 (ruling quoted 1.3)  
Note: tau_nom 3.71 MPa; with Kt 1.3: 4.8 MPa (SF 2.07). At the 0.35 N*m top of the N20 stall range: SF 1.65. Shear on layer planes (upright print). SUPERSEDED by the servo change, 2026-10-14 (N20 and DH-02 v2 dropped; see row 5c).  

**5b DH-02 v1 jam 0.25 N*m, hub annulus D5.1/D3.1, sharp step**  
Formula: `tau = Kt T r / J`  
Inputs: J = pi (5.1^4 - 3.1^4) / 32 = 57 mm^4, r 2.55, Kt ~2 (sharp)  
Note: Superseded by v2 (not printed).  

**5c DH-02 v3 jam at full FB5311M-360 stall 1.52 N*m, D8 hub**  
Formula: `tau = 16 T / (pi d^3)`  
Inputs: T 1520 N*mm (FB5311M-360 15.5 kg*cm stall at 6 V), d 8, Kt not applied (flange root radius not in this script)  
Note: Servo change, 2026-10-14. Nominal shear already exceeds the across-layer allowable, and the stall torque rises at 8.4 V. Not a design point: the firmware stall rule (A2 feedback progress < 5 deg in 150 ms -> stop, reverse 1/4 rev, retry; 3 stalls -> F AUGER_JAM) must stop the servo first. DH-02 v3 is printed at 100 % infill, 1 spare.  

**6a Grip pull-out vs 100 mL beaker + 80 mL developer, 1 g + 1 g shake**  
Formula: `F_pull >= 1.5 (1 g + 1 g shake) W; F_pull = 2 mu N`  
Inputs: W = (25 g + 80 mL x 1.04) g = 1.06 N; demand 2W = 2.12 N; calibrated pull-out >= 3.2 N  
Note: Torque-limited close, calibrated Friday on a water-filled beaker with wet silicone fingers. N per finger = 3.2 / (2 x 0.6) = 2.7 N (mu 0.6 silicone); without silicone (mu 0.3) 5.3 N. Static 1 g: SF 3.0.  

**7a Load cell: arm place force + max demo load vs stop engagement**  
Formula: `F = F_slip + m_max g  vs  F_stop = 1.2 FS`  
Inputs: F_slip 4.0 N (grip pull-out, beaker slides in the fingers), m_max 0.4 kg; stop set with 2 paper sheets under 500 g -> 1.2-1.4 FS  
Note: Criterion: the stop is not touched in normal use (lower stop setting 1.2 FS).  

**7b Load cell: stop engagement (upper) vs 150 % safe overload**  
Formula: `F_stop,max = 1.4 FS  vs  1.5 FS`  
Inputs: FS = 1 kg = 9.81 N  
Note: Hand on the pan / dropped beaker: the set-screw stop carries the rest.  

**8-40-PLA Hot-wetted ST-04/05/07 at 40 mL charge vs PLA HDT**  
Formula: `T = T0 + (V rho w / M) dH / (m_liq c + C_flask)`  
Inputs: V 40 mL, rho 1.04, w 0.12, M 34.01, dH 98.2 kJ/mol -> Q 14.4 kJ; C 488 J/K; T0 28 C  
Note: Margin -2.5 K. Near-zero (kPa) stress for minutes: warping, not strength, is the risk; check ST-07 roundness after each run (CDR-18). As-printed material (PLA vs PETG) still to be confirmed from printer logs.  

**8-40-PETG Hot-wetted ST-04/05/07 at 40 mL charge vs PETG HDT**  
Formula: `T = T0 + (V rho w / M) dH / (m_liq c + C_flask)`  
Inputs: V 40 mL, rho 1.04, w 0.12, M 34.01, dH 98.2 kJ/mol -> Q 14.4 kJ; C 488 J/K; T0 28 C  
Note: Margin +12.5 K. Near-zero (kPa) stress for minutes: warping, not strength, is the risk; check ST-07 roundness after each run (CDR-18). As-printed material (PLA vs PETG) still to be confirmed from printer logs.  

**8-50-PLA Hot-wetted ST-04/05/07 at 50 mL charge vs PLA HDT**  
Formula: `T = T0 + (V rho w / M) dH / (m_liq c + C_flask)`  
Inputs: V 50 mL, rho 1.04, w 0.12, M 34.01, dH 98.2 kJ/mol -> Q 18.0 kJ; C 530 J/K; T0 28 C  
Note: Margin -7.0 K. Near-zero (kPa) stress for minutes: warping, not strength, is the risk; check ST-07 roundness after each run (CDR-18). As-printed material (PLA vs PETG) still to be confirmed from printer logs.  

**8-50-PETG Hot-wetted ST-04/05/07 at 50 mL charge vs PETG HDT**  
Formula: `T = T0 + (V rho w / M) dH / (m_liq c + C_flask)`  
Inputs: V 50 mL, rho 1.04, w 0.12, M 34.01, dH 98.2 kJ/mol -> Q 18.0 kJ; C 530 J/K; T0 28 C  
Note: Margin +8.0 K. Near-zero (kPa) stress for minutes: warping, not strength, is the risk; check ST-07 roundness after each run (CDR-18). As-printed material (PLA vs PETG) still to be confirmed from printer logs.  

**9 Foam volume at the 40 mL cap vs ST-07 well annulus**  
Formula: `V_foam ~ V_O2 = V_dev x 40 vol x T/273 K`  
Inputs: V_dev 40 mL, 40-vol developer, T 58 C; well annulus 0.65 L (D126 x 88 around the D85 flask)  
Note: Overflow ~1.3 L by design: contained by the taped drop cloth + absorbent pads ringing ERUPT (CDR-19); optional PP container (OD <=150) holds ~2.3 L.  

**10a Engagement: DH-01 -> AG-01, SHCS M3x20 self-tapped D2.5 pilot**  
Formula: `F_strip = pi d Le tau 0.6 (tau 10)  vs  installation preload / max service load`  
Inputs: Le 7.00 mm = 2.33 d = 14.0 threads (need 4.5 mm, PLA); preload/service 30 N  
Note: Reach rule (>= 1.5 d): **PASS**.  

**10b Engagement: Arm front row, ISO 7380 M4x20 into steel T-nut**  
Formula: `F_strip = pi d Le 0.58 UTS 0.5 (UTS 250)  vs  installation preload / max service load`  
Inputs: Le 2.00 mm = 0.50 d = 2.9 threads (need 4.0 mm, steel); preload/service 1000 N  
Note: Reach rule (>= 1.0 d): **FAIL**. Receiving thread is shorter than 1.0 d, so the rule cannot be met by any screw length; the ruling accepts the joint on strip vs PLA-limited preload.  

**10c Engagement: Arm back row, SHCS M4x20 into steel T-nut**  
Formula: `F_strip = pi d Le 0.58 UTS 0.5  vs  installation preload / max service load`  
Inputs: Le 2.00 mm = 0.50 d = 2.9 threads (need 4.0 mm, steel); preload/service 1000 N  
Note: Reach rule (>= 1.0 d): **FAIL**. Receiving thread is shorter than 1.0 d, so the rule cannot be met by any screw length; the ruling accepts the joint on strip vs PLA-limited preload.  

**10d Engagement: TT-01/ST-01 saddle M5x12 into T-nut (no counterbore)**  
Formula: `F_strip = pi d Le 0.58 UTS 0.5  vs  installation preload / max service load`  
Inputs: Le 2.20 mm = 0.44 d = 2.8 threads (need 5.0 mm, steel); preload/service 1650 N  
Note: Reach rule (>= 1.0 d): **FAIL**. Receiving thread is shorter than 1.0 d, so the rule cannot be met by any screw length; the ruling accepts the joint on strip vs PLA-limited preload.  

**10e Engagement: AG-01/WS-01 v2 saddle M5x12, D10x1.5 counterbore (min)**  
Formula: `F_strip = pi d Le 0.58 UTS 0.5  vs  installation preload / max service load`  
Inputs: Le 3.35 mm = 0.67 d = 4.2 threads (need 5.0 mm, steel); preload/service 1650 N  
Note: Reach rule (>= 1.0 d): **FAIL**. Receiving thread is shorter than 1.0 d, so the rule cannot be met by any screw length; the ruling accepts the joint on strip vs PLA-limited preload.  

**10f Engagement: RK-02 M5x12 into T-nut (full nut)**  
Formula: `F_strip = pi d Le 0.58 UTS 0.5  vs  installation preload / max service load`  
Inputs: Le 3.80 mm = 0.76 d = 4.7 threads (need 5.0 mm, steel); preload/service 1650 N  
Note: Reach rule (>= 1.0 d): **FAIL**. Receiving thread is shorter than 1.0 d, so the rule cannot be met by any screw length; the ruling accepts the joint on strip vs PLA-limited preload.  

**10g Engagement: Four-bar pivot M5x20 into ruthex M5 insert**  
Formula: `F_strip = pi d Le 0.58 UTS 0.5 (UTS 300)  vs  installation preload / max service load`  
Inputs: Le 8.00 mm = 1.60 d = 10.0 threads (need 5.0 mm, brass); preload/service 500 N  
Note: Reach rule (>= 1.0 d): **PASS**.  

**10h Engagement: Carousel deck SHCS M3x12 into 25T Al horn (2.0 mm flange)**  
Formula: `F_strip = pi d Le 0.58 UTS 0.5 (UTS 290)  vs  installation preload / max service load`  
Inputs: Le 2.00 mm = 0.67 d = 4.0 threads (need 3.0 mm, Al); preload/service 500 N  
Note: Reach rule (>= 1.0 d): **FAIL**. Receiving thread is shorter than 1.0 d, so the rule cannot be met by any screw length; the ruling accepts the joint on strip vs PLA-limited preload.  

**10i Engagement: Stage crank SHCS M3x12 into 25T Al horn (2.0 mm flange)**  
Formula: `F_strip = pi d Le 0.58 UTS 0.5 (UTS 290)  vs  installation preload / max service load`  
Inputs: Le 2.00 mm = 0.67 d = 4.0 threads (need 3.0 mm, Al); preload/service 500 N  
Note: Reach rule (>= 1.0 d): **FAIL**. Receiving thread is shorter than 1.0 d, so the rule cannot be met by any screw length; the ruling accepts the joint on strip vs PLA-limited preload.  

**10j Engagement: Servo ears SHCS M3x12 into TT-01/ST-01 D2.5 pilots**  
Formula: `F_strip = pi d Le tau 0.6 (tau 10)  vs  installation preload / max service load`  
Inputs: Le 8.00 mm = 2.67 d = 16.0 threads (need 4.5 mm, PLA); preload/service 150 N  
Note: Reach rule (>= 1.5 d): **PASS**.  

**11a Carousel: liner friction torque (bottom plate floating) vs servo torque**  
Formula: `T_f = mu N r`  
Inputs: mu 0.3, N 6 N (deck + beakers on the liner), r 40 mm  
Note: Radial load on the servo output = liner friction ~2 N (was 0.8-2.5 kN with both plates bonded).  

**11b Carousel: upper VHB (top plate to deck) shear from the friction drag**  
Formula: `tau = (T_f / r) / A_vhb`  
Inputs: T_f 0.072 N*m at r 40, A 6600 mm^2  

**12-v1 TT-04 pocket wall, 10 N side load at the rim (v1 printed: 16 tall, 2.4 wall, R0.8)**  
Formula: `sigma = Kt 6 F h / (b t^2)`  
Inputs: F 10 N, h 16, b 20 (flat-strip, conservative for a ring), t 2.4, Kt(r 0.8) 1.32  
Note: Rim strike = accident after the CDR-15 lead-ins and vertical approach (acceptance: 20 picks, no strike).  

**12-v2 TT-04 pocket wall, 10 N side load at the rim (v2 if unprinted: 12 tall (CDR-14), 2.4 wall, R1.5)**  
Formula: `sigma = Kt 6 F h / (b t^2)`  
Inputs: F 10 N, h 12, b 20 (flat-strip, conservative for a ring), t 2.4, Kt(r 1.5) 1.18  
Note: Rim strike = accident after the CDR-15 lead-ins and vertical approach (acceptance: 20 picks, no strike).  

**13a Servo ear screws at stall: PLA bearing on the M3 shank**  
Formula: `sigma_b = F / (d Le), F = T_stall / (s_ears 2)`  
Inputs: T 4413 N*mm, ear spacing 48.6 mm, 2 screws per side -> F 45.4 N; d 3, Le 8.0 (fastener_reach)  

**13b Servo ear screws at stall: M3 shank shear (8.8)**  
Formula: `tau = F / A_s`  
Inputs: F 45.4 N, A_s 5.03 mm^2, allowable 0.6 x 640  

**13c Servo ear (servo case) bearing on the screw**  
Formula: `sigma_b = F / (d t_ear)`  
Inputs: F 45.4 N, t_ear 2.5 mm (est.), nylon/ABS ~50 MPa  

**14a Carousel: servo torque to index 45 deg in 0.6 s (8 full beakers)**  
Formula: `T = I alpha + T_drag`  
Inputs: I 0.0044 kg*m^2, alpha 8.7 rad/s^2, drag 0.02 N*m + liner 0.072 N*m  

**14b Carousel: M3 horn screws, PLA bearing in deck + spacer at stall**  
Formula: `sigma_b = T / (4 r_bc) / (d t)`  
Inputs: r_bc 7, d 3, t 8.1  

**14c Stage: crank torque, breakaway + accel (180 mm in 1 s, worst)**  
Formula: `T = (mu m g + m a) L`  
Inputs: mu 0.25, m 0.69 kg, a 0.72 m/s^2, L 0.15 m  

**14d Crank bending at the hub, servo stalled (in plane, along layers)**  
Formula: `sigma = Kt T / Z`  
Inputs: Z = 10 x 20^2 / 6 = 667 mm^3, Kt 1.5 (hub root radius not yet in fillet_report; assumed)  

**14e ST-04 tray posts (D20), stall load, R<=0.5 root**  
Formula: `sigma = Kt F L / Z`  
Inputs: F 29.4 N, L 49, Z 785 mm^3, Kt 2.7 (r/d 0.025; Peterson D/d 1.2: 2.41)  
Note: Printed; no reprint for fillets (CDR-12).  

**14f F625ZZ bearing radial load at stall**  
Formula: `F = T / L`  
Inputs: L 150 mm, C ~1.1 kN  

**14g SO-101 base: tension per M4 bolt vs PLA-limited preload**  
Formula: `F = M / s / 2`  
Inputs: M 5.30 N*m (shoulder stall + arm), rows 69.8 mm apart, 2 bolts/row; preload ~1 kN  

**14h Frame: horizontal shove vs friction from 2 C-clamps**  
Formula: `F_f = 2 F_clamp mu`  
Inputs: F_clamp ~1 kN (est), mu 0.3  

## DH-01 section record (CDR-02)

| Section | v1 (as exported) | v2 predicted | Acceptance | v2 measured |
|---|---|---|---|---|
| Y=299.0 continuous (both sides) | 59 mm^2 | 213 mm^2 (+~83 fillets) | >= 700 mm^2 | _pending: slice v2 STL_ |
| Y=320 | 337 mm^2 | 507 mm^2 | >= 600 mm^2 | _pending: slice v2 STL_ |

Source: meshes.json slice (0.25 mm raster, point-in-mesh).
