shaoming11/hh-winners/review/records/cdr_minutes.md

# CDR minutes — Wet Lab Bench v2, 2026-10-14

Generated by `python analysis/make_minutes.py` from [cdr_record.json](cdr_record.json). Full ruling text: [cdr_ruling.md](cdr_ruling.md). Do not edit by hand.

## Attendees

| Role | Discipline | Part in the review |
|---|---|---|
| Chief engineer (chair) | all | Ran spot-checks and ruled on every finding |
| Senior reviewer | mechanical | Raised 29 findings, wrote the rebuttals |
| Design owner | mechanical | Answered each finding (defence), final word on M-04 |
| Senior reviewer | electrical | Raised 16 findings, wrote the rebuttals |
| Design owner | electrical | Answered each finding (defence) |
| Senior reviewer | software | Raised 30 findings, wrote the rebuttals |
| Design owner | software | Answered each finding (defence), final word on S-13 |

Process (per review/BRIEF.md): reviewer finding → owner defence → reviewer rebuttal (RESOLVED or ESCALATE) → owner final word on escalations → chief engineer ruling.

## Outcome in brief

- 75 findings reviewed; 53 action items (CDR-xx); 30 rejected sub-requirements; nothing rejected outright.
- Action items by priority: P0-before-print 24, P1-before-demo 27, P2-nice 2; 8 require a reprint.
- Escalated to the chief engineer: M-04, S-13.

## Mechanical

29 findings (BLOCKER 5, MAJOR 15, MINOR 9).

| Finding | Severity | Title | Owner position | Reviewer status | Final ruling |
|---|---|---|---|---|---|
| M-01 | BLOCKER | DH-01 auger head is not fastened to AG-01: the M3 x 12 screws never reach the post | ACCEPT | RESOLVED | CDR-01 |
| M-02 | BLOCKER | DH-01 tube, hopper and outlet hang off the bridge by a ~50 mm² sliver | ACCEPT | RESOLVED | CDR-02 |
| M-03 | BLOCKER | Carousel is over-constrained: the deck is bolted to the servo horn AND VHB-bonded to a hand-placed lazy Susan | PARTIAL | RESOLVED | CDR-10 (part rejected) |
| M-04 | BLOCKER | ST-01 Ø18 stop posts have an R0.7 root fillet; the claimed SF 3.0 is really ~1.2 at stall and <1 on impact | PARTIAL | ESCALATE | CDR-07, CDR-08, CDR-09 (part rejected) |
| M-05 | BLOCKER | Front-row countersunk arm bolts must cut into the borrowed SO-101 base, and engage only 1.2 mm of the T-nut | PARTIAL | RESOLVED | CDR-11, CDR-31 (part rejected) |
| M-06 | MAJOR | AG-01 135 mm post: no real base fillet is possible, the gusset ends abruptly, and the stand rocks about the 20 x 12 bar | PARTIAL | RESOLVED | CDR-03 (part rejected) |
| M-07 | MAJOR | AG-01 front saddle T-nut hangs 4.5 mm off the end of the left Y-rail | ACCEPT | RESOLVED | CDR-03 |
| M-08 | MAJOR | Fillets were applied by a blanket script, not sized to load paths; structural roots are R0-R2 | PARTIAL | RESOLVED | CDR-03, CDR-06, CDR-12 (part rejected) |
| M-09 | MAJOR | DH-02 auger screw shears at the collar step on a jam, and its flights are too thin to print | ACCEPT | RESOLVED | CDR-04, CDR-49 |
| M-10 | MAJOR | Auger bore printed horizontally on tree supports with 0.42 mm radial clearance; screw has no tip support | PARTIAL | RESOLVED | CDR-05 (part rejected) |
| M-11 | MAJOR | Fin-ray grip force from a 4° position squeeze is about 2-5x too low to hold a full reagent beaker | ACCEPT | RESOLVED | CDR-13 |
| M-12 | MAJOR | A level-gripper roll pour puts the pour lip at a finger, and beaker spouts are not indexed | PARTIAL | RESOLVED | CDR-14 (part rejected) |
| M-13 | MAJOR | Approach clearance is ±2.6 mm and the pockets have no lead-ins, below SO-101 repeatability | PARTIAL | RESOLVED | CDR-15 |
| M-14 | MAJOR | GR-03 TPU slot will not accept the tongue; GR-01/02 tongues are unfilleted; GR-02 print orientation loads layers | ACCEPT | RESOLVED | CDR-16 |
| M-15 | MAJOR | The 1 kg load cell has no overload stop and no splash protection | PARTIAL | RESOLVED | CDR-06, CDR-17 (part rejected) |
| M-16 | MAJOR | PLA tray, collar and catch well sit under a reaction that reaches 60-70 °C; the load case compares against PETG | PARTIAL | RESOLVED | CDR-18 (part rejected) |
| M-17 | MAJOR | Catch well holds about a third of the foam | PARTIAL | RESOLVED | CDR-19 (part rejected) |
| M-18 | MAJOR | The funnel rides loose in the flask neck through the eruption, and the reaction starts at WORK under the pouring arm | PARTIAL | RESOLVED | CDR-20, CDR-21 |
| M-19 | MAJOR | CAD physical materials are wrong on many components, so the mass properties are meaningless | ACCEPT | RESOLVED | CDR-22 |
| M-20 | MAJOR | The BOM is spread over three README tables and is missing CAD and bench items | ACCEPT | RESOLVED | CDR-23 |
| M-21 | MINOR | Several screws are one size short; thread engagement is 1.4-2.2 mm | PARTIAL | RESOLVED | CDR-03, CDR-06, CDR-24 (part rejected) |
| M-22 | MINOR | ST-05 collar OD equals ST-07 well ID (126.0 mm, line-to-line) | ACCEPT | RESOLVED | CDR-25 |
| M-23 | MINOR | ST-08 spacers bear on the F625ZZ shields and crush under the M5 preload | PARTIAL | RESOLVED | CDR-26 (part rejected) |
| M-24 | MINOR | RK-02 'stiffening rib' is entirely inside the plate and does nothing | ACCEPT | RESOLVED | CDR-27 (part rejected) |
| M-25 | MINOR | Hopper has a flat floor and is ~56 mL, not 70 mL | ACCEPT | RESOLVED | CDR-04, CDR-05 |
| M-26 | MINOR | load_cases are missing the cases that actually govern and misstate some failure modes | ACCEPT | RESOLVED | CDR-28 |
| M-27 | MINOR | The README contradicts itself on material, gripper, rack and process | ACCEPT | RESOLVED | CDR-29 |
| M-28 | MINOR | No packing plan; clamp TSA length is unverified; ST-01 is held by 40 mm of rail | PARTIAL | RESOLVED | CDR-30 (part rejected) |
| M-29 | MINOR | Planner collision-free claims have no evidence in the repo and assume CAD-perfect arms | ACCEPT | RESOLVED | CDR-31 (part rejected) |

## Electrical

16 findings (BLOCKER 2, MAJOR 11, MINOR 3).

| Finding | Severity | Title | Owner position | Reviewer status | Final ruling |
|---|---|---|---|---|---|
| E-01 | BLOCKER | The M45CHW servo leads have no exit path from the TT-01 and ST-01 servo pockets. Both pockets are closed cups with 0.3 mm clearance. | ACCEPT | RESOLVED | CDR-40 |
| E-02 | BLOCKER | Opening the serial port, a reset, a firmware upload or plugging in the LiPo snaps the carousel and stage to 1500 us at full servo speed, with peroxide on board. | PARTIAL | RESOLVED | CDR-41 (part rejected) |
| E-03 | MAJOR | The 10 A fuse cannot protect the M45CHWs from a stall. A one-spline horn error drives the stage into its +/-45 deg stop and holds it there. | PARTIAL | RESOLVED | CDR-09, CDR-42 (part rejected) |
| E-04 | MAJOR | HX711 reads disable interrupts and jitter the Servo-library pulses by up to 300 us. The timers themselves do not conflict on the Mega. | ACCEPT | RESOLVED | CDR-43 |
| E-05 | MAJOR | The pour controller assumes an 80 Hz HX711 the module does not provide, and the HX711 and load-cell wiring have no mount, routing or spill protection. | PARTIAL | RESOLVED | CDR-06, CDR-17, CDR-44 (part rejected) |
| E-06 | MAJOR | There is no hardware emergency stop. The only stop is a laptop spacebar, which depends on the Python loop being alive. | ACCEPT | RESOLVED | CDR-45 |
| E-07 | MAJOR | The pour interlock and the low-battery stop rely on signals that do not exist: stage position is inferred from the command, and the LiPo monitor is not wired. | PARTIAL | RESOLVED | CDR-19, CDR-20, CDR-38, CDR-46 (part rejected) |
| E-08 | MAJOR | Ground topology, wire gauge, connector ratings and servo extension drops are unspecified. 'All grounds common' invites returning motor current through the Mega and its USB link. | PARTIAL | RESOLVED | CDR-47 (part rejected) |
| E-09 | MAJOR | There is no defined location, enclosure or spill protection for the Mega, LiPo, TB6612, fuse and relay. The old EL-01 envelope sits under the arms' swept volume. | ACCEPT | RESOLVED | CDR-48 |
| E-10 | MAJOR | The auger drive is under-specified and contradictory: 70 % vs 100 % PWM, speed that varies with battery voltage, no stall detection, an unfused TB6612 branch and no dead time on reversal. | ACCEPT | RESOLVED | CDR-49 |
| E-11 | MAJOR | The arm supply sizing has zero margin, and identical 5.5 x 2.1 barrels on 5 V, 6 V and 12 V supplies invite a motor-killing mis-plug. | ACCEPT | RESOLVED | CDR-50 |
| E-12 | MAJOR | The README contradicts itself on power and control (legacy PCA9685 / 6 V text) and has no wiring diagram, pin table or harness list. | ACCEPT | RESOLVED | CDR-29, CDR-51 |
| E-13 | MAJOR | The electrical BOM is missing parts needed to build and run the bench, including a USB hub for 3 serial devices. | PARTIAL | RESOLVED | CDR-23 |
| E-14 | MINOR | A full 2S charge sits at or above the M45CHW's 8.4 V maximum. The XT60 sparks into 2200 uF, and the single bulk capacitor is far from both servos. | PARTIAL | RESOLVED | CDR-52 (part rejected) |
| E-15 | MINOR | Cable routing and strain relief: the N20 leads hang near the deck rim, there is no tie point on DH-01/AG-01, and the arm cables and load-cell lead are unmanaged. | ACCEPT | RESOLVED | CDR-53 |
| E-16 | MINOR | Servo idle current and heat inside the closed PLA pockets have not been measured, and USB host robustness items are not covered. | PARTIAL | RESOLVED | CDR-54 |

## Software

30 findings (BLOCKER 6, MAJOR 19, MINOR 5).

| Finding | Severity | Title | Owner position | Reviewer status | Final ruling |
|---|---|---|---|---|---|
| S-01 | BLOCKER | Offline trajectories go past the SO-101 joint ranges, so they cannot be replayed on the real arms | ACCEPT | RESOLVED | CDR-31 |
| S-02 | BLOCKER | Planned moves carry filled open beakers tilted and upside down, so they spill reagent in transit | ACCEPT | RESOLVED | CDR-31 |
| S-03 | BLOCKER | The planned pour pose puts the stream 35 mm outside the measuring beaker | ACCEPT | RESOLVED | CDR-31 (part rejected) |
| S-04 | BLOCKER | E-stop and SAFE_STOP keep a pour running, and a software exit drops the held beaker | ACCEPT | RESOLVED | CDR-32 |
| S-05 | BLOCKER | A Mega reset slams the carousel and the stage to 1500 µs at full speed | ACCEPT | RESOLVED | CDR-41 (part rejected) |
| S-06 | BLOCKER | No valid trajectory set exists for the hardware being built, and the repo cannot regenerate one | ACCEPT | RESOLVED | CDR-31 |
| S-07 | MAJOR | The cut-off law double-counts in-flight mass and ignores the untilt tail | ACCEPT | RESOLVED | CDR-34 |
| S-08 | MAJOR | PI on flow cannot follow the falling liquid level without tilt feed-forward | ACCEPT | RESOLVED | CDR-34 |
| S-09 | MAJOR | Reagent fill level is never measured, so θ_start(fill) and the PRECHECK quantity test have no input | ACCEPT | RESOLVED | CDR-34 |
| S-10 | MAJOR | Flow estimate and first-drop detection are noise-limited, and the HX711 rate is assumed, not checked | ACCEPT | RESOLVED | CDR-44 |
| S-11 | MAJOR | Grasp-miss detection cannot fire, and the gripper load thresholds conflict with LeRobot's gripper configuration | ACCEPT | RESOLVED | CDR-13 |
| S-12 | MAJOR | A 5 deg approach opening leaves almost no clearance on the fixed finger | ACCEPT | RESOLVED | CDR-15 |
| S-13 | MAJOR | Calibration and teach plan break the collision guarantee, needs fixtures nobody has, and ignores LeRobot's normalisation | PARTIAL | ESCALATE | CDR-13, CDR-33 (part rejected) |
| S-14 | MAJOR | Arm-to-arm safety relies on zone locks, but the plan was only checked against the other arm's planned pose | ACCEPT | RESOLVED | CDR-31 |
| S-15 | MAJOR | The eruption starts at WORK under arm A before the stage moves out | ACCEPT | RESOLVED | CDR-20 |
| S-16 | MAJOR | No e-stop independent of software, and no handling for arm power loss | PARTIAL | RESOLVED | CDR-17, CDR-45, CDR-50 (part rejected) |
| S-17 | MAJOR | Firmware: the HX711 read disables interrupts and jitters the servos, and a blocking read can leave the auger running | ACCEPT | RESOLVED | CDR-43 (part rejected) |
| S-18 | MAJOR | Motion limits are not enforced in firmware and are given in degrees while the servo type (180 vs 270) is unknown | ACCEPT | RESOLVED | CDR-09 |
| S-19 | MAJOR | Mega protocol is underspecified: framing, acknowledgement semantics, watchdog latch and baud error | PARTIAL | RESOLVED | CDR-35, CDR-46 (part rejected) |
| S-20 | MAJOR | A single asyncio loop with blocking LeRobot calls cannot meet the timing budget | ACCEPT | RESOLVED | CDR-35 |
| S-21 | MAJOR | Arm identity is not checked at connect, so serial ports can swap and torque-enable can snap the arm | ACCEPT | RESOLVED | CDR-54 (part rejected) |
| S-22 | MAJOR | State machine: soap state missing, no pause/resume or reset, no recovery paths, tare scheme cannot work | ACCEPT | RESOLVED | CDR-36 |
| S-23 | MAJOR | Open-loop auger dosing cannot meet ±0.3 g, and several planned checks are physically impossible | PARTIAL | RESOLVED | CDR-46, CDR-49 (part rejected) |
| S-24 | MAJOR | The 'flask detected' interlock is not a sensor, and SAFE_STOP's 'stage home' contradicts the watchdog | PARTIAL | RESOLVED | CDR-20, CDR-46 (part rejected) |
| S-25 | MAJOR | Plan, simulator and schedule cannot deliver a tuned closed-loop system in Friday's window | ACCEPT | RESOLVED | CDR-37 (part rejected) |
| S-26 | MINOR | Top-up pulses and the snap-back excite slosh and make overshoot more likely | PARTIAL | RESOLVED | CDR-34 |
| S-27 | MINOR | Servo load guard thresholds are arbitrary and miss light collisions | ACCEPT | RESOLVED | CDR-36 |
| S-28 | MINOR | Documentation disagrees with itself; config needs a single source of truth | ACCEPT | RESOLVED | CDR-29 |
| S-29 | MINOR | Tolerances are far tighter than the chemistry needs and force slow correction loops | ACCEPT | RESOLVED | CDR-34 |
| S-30 | MINOR | Logging, calibration and platform details are missing | PARTIAL | RESOLVED | CDR-38 (part rejected) |

## Action items

| ID | Discipline | Priority | Reprint | Decision | Parts / docs |
|---|---|---|---|---|---|
| CDR-01 | mechanical | P0-before-print | no | M-01 upheld; owner's M3x20 counter-proposal adopted (reviewer resolved). | AG-01, DH-01, hw occurrences (fusion_bridge), README fastener table, bom/BOM.csv, analysis/fastener_reach.md |
| CDR-02 | mechanical | P0-before-print | yes | M-02 upheld. Owner's mechanism correction (bending runs along layers at Y=299) accepted; the joint is unacceptable either way. | DH-01 (auger_west.py), analysis/load_cases.md |
| CDR-03 | mechanical | P0-before-print | yes | M-06 (partial), M-07, M-21 (AG-01 part) and the M-08 AG-01 radii, combined into AG-01 v2. The user's large-base-fillet rule for a 123 mm pillar is applied. Owner's stress correction accepted (post ~1 MPa; the soft direction is -Y rocking). | AG-01 (auger_west.py, agfix2.py), README rows 387, bom/BOM.csv |
| CDR-04 | mechanical | P0-before-print | yes | M-09 upheld (owner accepted); M-25 screw length included. | DH-02 (aug2.py), analysis/load_cases.py |
| CDR-05 | mechanical | P0-before-print | yes | M-10 (partial; tip pin rejected) and M-25 accepted. | DH-01 (auger_west.py), README auger section, print settings note |
| CDR-06 | mechanical | P0-before-print | yes | M-15 (partial), M-21 (WS-01 counterbore), M-08 (WS-01 R4) and E-05 (mount face kept clear), combined into WS-01 v2. | WS-01 generator, README fastener/assembly, bom/BOM.csv (M3x12 set screw), analysis/load_cases.py |
| CDR-07 | mechanical | P1-before-demo | yes | M-04 escalation resolved for the owner's final position. CE slices of ST-01 confirm the post, web and cradle wall are continuous from Z5 to Z35.3, so the Z5-root failure claim is rejected. The Z35.3 section governs at SF ≈1.0 against 10 MPa, which is not acceptable next to 12% H2O2. ST-01 v2 is mandatory before the live demo (not before powered bring-up behind the clamp). | ST-01 generator, exports/print_manifest.md, README, analysis/load_cases.py |
| CDR-08 | mechanical | P0-before-print | no | M-04 owner bumper accepted; the reviewer's 3 mm sleeve is rejected because it would drop the stop to 31.5°, below the 36.87° that WORK/ERUPT require. | ST-09 (new), README print list, bom/BOM.csv |
| CDR-09 | software | P1-before-demo | no | CE cross-check of M-04, E-03 and S-18. With the sleeve the stop is at 42.2°. A ±40° clamp plus E-03's ±2° trim tolerance reaches 42.0°, a 0.2° margin, which is too thin. Clamp tightened. | docs/software_architecture.md §7, README stage/commissioning, angle gauge (print list) |
| CDR-10 | mechanical | P1-before-demo | no | M-03: over-constraint upheld. Owner's zero-reprint fix adopted (float the bottom plate). Spigot and PTFE sheet rejected. | README turntable stack + fastener row 520, assembly checklist |
| CDR-11 | mechanical | P0-before-print | no | M-05 upheld for the countersink (it modifies the borrowed arm). M4x22 rejected: js15 tolerance against a 0.5 mm window would bottom some screws on the 2020 core. | README lines 37-42, bom/BOM.csv, plan3.py keep-out, analysis/load_cases.py |
| CDR-12 | mechanical | P1-before-demo | no | M-08: process criticism upheld. Reprinting already-printed parts just for fillets rejected (ST-04 tray posts SF 2.0 accident / 4.1, stall-only). ST-01 is handled by CDR-07. | fillet_lib.py + all part scripts (fusion_bridge), analysis/fillet_report.md, analysis/load_cases.py |
| CDR-13 | software | P1-before-demo | no | M-11, S-11 and S-13(b) merged. Close by force, not angle. CE cross-check: the S-11 'stall short of goal' classification only works if the goal lies beyond contact; the torque limit must sit under the EEPROM Max_Torque_Limit=500 that LeRobot writes. | docs/software_architecture.md §3/§8, GR-03 contact faces, bom/BOM.csv, analysis/load_cases.py |
| CDR-14 | mechanical | P0-before-print | no | M-12 partial: lower the grasp. Pocket spout notch rejected (the spout is 45-60 mm above any pocket wall); arrows adopted, with the reviewer's carousel-angle condition. | TT-04, RK-02, WS-02 generators, plan3.py |
| CDR-15 | mechanical | P0-before-print | no | M-13 and S-12 merged. Openings are per station, confirmed by audit. The carousel floor is set where neighbours permit. | TT-04, RK-02, WS-02 generators, config.yaml spec in docs/software_architecture.md §3, plan3.py |
| CDR-16 | mechanical | P0-before-print | no | M-14 upheld (owner accepted). Chamfered roof plus clearance in place of a 10 mm gable. | GR-01, GR-02, GR-03 (gripper_ops.py), bom/BOM.csv |
| CDR-17 | mechanical | P0-before-print | yes | M-15 pan growth, S-16 spill containment and E-05 drip protection combined. CE check: Ø90 leaves only ~0.9 mm to the arm-B base bbox corner (510.1,493.3), so the pan is capped at Ø80. The S-16 ≥80 mL tray is replaced by a lip sized to the real worst case: an 80 mL-line reagent into a 74 mL-brim beaker that already holds yeast overflows ≈13-18 mL. | WS-02 generator, README, docs/software_architecture.md §8 (host-hang residual risk text) |
| CDR-18 | mechanical | P0-before-print | no | M-16 partial. ST-07 3.2 mm reprint rejected. CE cross-check: the README schedule shows ST-04/05/07 were queued in PETG, so the material is confirmed before renaming. The developer target is set so the +2 g tolerance stays under the 40 mL cap. | README materials/recipe, exports/prints names, analysis/load_cases.py, config recipe, bom/BOM.csv (cork) |
| CDR-19 | mechanical | P1-before-demo | no | M-17 partial. The basin is rejected because it sits in the tray's travel path. Charge cap plus disposable containment adopted, with the reviewer's snag condition. CE interface ruling with E-07: Hall sensors go on top of the cloth. | README setup/containment, bom/BOM.csv, analysis/load_cases.py |
| CDR-20 | software | P1-before-demo | no | M-18, S-15, S-24 and E-07 merged into one eruption-timing and interlock rule. CE cross-check: the cork pad raises the funnel rim to Z236, so the retract height is Z>336. | docs/software_architecture.md §4/§8, README run sequence |
| CDR-21 | mechanical | P2-nice | no | M-18 fixed funnel FN-01 accepted only as a gated option (reviewer resolved). | FN-01 (new, optional), plan3 scene |
| CDR-22 | mechanical | P1-before-demo | no | M-19 upheld in full: correct physical materials on everything, including glass. | Fusion model, matfix3.py, review/design_data.json |
| CDR-23 | mechanical | P0-before-print | no | M-20 and E-13 merged, plus every consumable introduced by this CDR. One machine-readable BOM in the repo, as the user requires (all glassware included). | bom/BOM.csv (new), README 'What you buy' |
| CDR-24 | mechanical | P1-before-demo | no | M-21 partial. No reprint of TT-01/ST-01 (preload is PLA-roof-limited; SF ~1.5 at installation, >40 in service). The 2 mm counterbore is rejected on tolerance grounds; 1.5 mm used (in CDR-03/06). | README fastener table, CAD occurrences, bom/BOM.csv |
| CDR-25 | mechanical | P1-before-demo | no | M-22 upheld. | ST-05 (CAD), README verification table |
| CDR-26 | mechanical | P0-before-print | yes | M-23 partial. Shield contact accepted. DIN 988 5x7 (non-standard) and 1.5 N·m preload rejected. | ST-08, README pivot stack, bom/BOM.csv |
| CDR-27 | mechanical | P2-nice | no | M-24 accepted: delete the rib, do not add a foot. | rk3.py |
| CDR-28 | mechanical | P1-before-demo | no | M-26 upheld, with operational/accident categories. | analysis/load_cases.py, analysis/load_cases.md |
| CDR-29 | mechanical | P0-before-print | no | M-27, S-28 and E-12 (doc portion) merged: one README consistency pass in tonight's push. | README.md, docs/software_architecture.md §1.1 |
| CDR-30 | mechanical | P0-before-print | no | M-28 partial. Clamp, packing and tools accepted. ST-01 saddle extension rejected: the preload friction (~1 kN) holds a fixed offset that teach absorbs. | README packing table + assembly notes, bom/BOM.csv |
| CDR-31 | software | P1-before-demo | no | S-01, S-02, S-03, S-06, S-14, M-29 and M-05 (keep-out) upheld. CE ruling on the M-29 vs S-03 conflict: the lip sits 15-20 mm above the receiver rim for scale pours (target 18) and 20-30 mm above the funnel rim. The current frames.json is invalid. The planner is existing CAD tooling: requirements are written into the doc tonight and implemented by the team per §9. | docs/software_architecture.md, fusion_bridge plan3.py/planner.py, software/tools/planner/, analysis/plan3_audit.txt |
| CDR-32 | software | P1-before-demo | no | S-04 upheld, with the reviewer's pre-first-flow rule. | docs/software_architecture.md §4/§8 |
| CDR-33 | software | P0-before-print | no | S-13 escalation resolved for the owner's final position. The roll-axis lever is ~9 mm, so roll is unobservable with the 4-cone grasp-centre fit; owner and reviewer agree. The rigid-probe datum on an arm-registered block is accepted over a slot on WS-01 or the TPU fingers. The WS-01 location is rejected because its T-nut placement error would enter tick0. | CAL-01 x2, CAL-02 (new), bom/BOM.csv print list, docs/software_architecture.md §3/§3.1 |
| CDR-34 | software | P1-before-demo | no | S-07, S-08, S-09, S-26 and S-29 upheld (pour controller §5). | docs/software_architecture.md §5, config.yaml spec |
| CDR-35 | software | P1-before-demo | no | S-19 and S-20 upheld, with reviewer additions (HB proves orchestrator liveness; goal-wake). CE harmonization: V messages come from the INA226, not A0. | docs/software_architecture.md §2/§7 |
| CDR-36 | software | P1-before-demo | no | S-22 and S-27 upheld. | docs/software_architecture.md §4/§8 |
| CDR-37 | software | P1-before-demo | no | S-25 partial: schedule, simulator spec, STEP and DEGRADED modes and cutting the web page accepted. Per the user's explicit instruction, no software is written in this CDR. The pre-flight code list is recorded as the team's recommended schedule, not a CDR deliverable. | docs/software_architecture.md §9 |
| CDR-38 | software | P1-before-demo | no | S-30 partial. Logging, hashing and voltage gating accepted. Ubuntu pin rejected (Windows 11 + LeRobot 0.6.0 already installed). The 100 g M2 weight replaces nickels as primary. CE harmonization of the battery thresholds with E-07. | docs/software_architecture.md §8/§9.3, requirements.lock spec |
| CDR-40 | electrical | P0-before-print | no | E-01 upheld as a BLOCKER, owner's L-relief adopted. CE cross-check: the grommet must be measured tonight so ST-01 v2 (CDR-07) carries the slot. | TT-01 (hand mod), ST-01 v1/v2, hw_funcs.py, TT-01/ST-01 generators, README assembly |
| CDR-41 | electrical | P1-before-demo | no | E-02 and S-05 merged. CE ruling: no RESET capacitor (relay gating makes a reset limp and safe; a cap that must be removed to flash is a trap). The Servo library is dropped per CDR-43, so S-05's writeMicroseconds-before-attach and its 544-2400 µs clamp issue are superseded. | docs/software_architecture.md §7, README Electrical/bring-up, bom/BOM.csv |
| CDR-42 | electrical | P1-before-demo | no | E-03 upheld as resolved (3 A branch fuses, single INA226 with replaced shunt, measured I_trip). | README Electrical, docs/software_architecture.md §6/§7, bom/BOM.csv |
| CDR-43 | electrical | P1-before-demo | no | E-04 and S-17 merged. CE ruling for E-04: Timer4 hardware PWM plus a direct-port HX711 read. S-17's keep-the-Servo-library-on-D9/D10 option and its Timer5 fallback are superseded. S-17's STBY, WDT and timeout items are retained. | docs/software_architecture.md §1/§7, README pin table |
| CDR-44 | electrical | P1-before-demo | no | E-05 and S-10 merged (80 SPS, VHB mount on the WS-01 -Y face, LSQ flow estimator). | README Electrical, docs/software_architecture.md §5.1/§7 |
| CDR-45 | electrical | P0-before-print | no | E-06 and S-16 merged. Hardware e-stop required. CE note: Mega D2 = PE4/INT4 (attachInterrupt 0); E-06 and S-16 name the same pin. | bom/BOM.csv, README Electrical, docs/software_architecture.md §8 |
| CDR-46 | electrical | P1-before-demo | no | E-07 upheld (Halls on the tray, INA226 VBUS, A1 bus divider). CE ruling: this supersedes the S-23/S-19 A0 10k/4.7k divider and makes the Hall the hardware input for the S-24 interlock. | README Electrical/pin table, docs/software_architecture.md §8, bom/BOM.csv |
| CDR-47 | electrical | P1-before-demo | no | E-08 upheld. XT30 power split rejected; 20 AWG HD JR extensions instead. | README Electrical, docs/electrical_block.svg |
| CDR-48 | electrical | P0-before-print | no | E-09 upheld (electronics box in the 0%-overflown left-rear zone). | EL-02 (CAD/BOM), README Electrical layout, plan3 scene |
| CDR-49 | electrical | P0-before-print | no | E-10, M-09 (drive) and S-23 merged into one auger drive spec. CE ruling: E-10's stall rule replaces M-09's 300 ms and S-23's 200 ms rules. INA226 supplies V_pack. | bom/BOM.csv, README Electrical, docs/software_architecture.md §6 |
| CDR-50 | electrical | P0-before-print | no | E-11 and S-16 (voltage part) merged. CE ruling: thresholds are relative to the measured V_idle (S-16) using E-11's warn/fault ratios; 200 ms debounce to avoid acceleration-sag false trips. | bom/BOM.csv, README SO-101 arms, docs/software_architecture.md §8 |
| CDR-51 | electrical | P0-before-print | no | E-12 upheld. The single pin table is authoritative across disciplines (in tonight's push). | README Electrical, docs/electrical_block.svg, docs/software_architecture.md §1 |
| CDR-52 | electrical | P1-before-demo | no | E-14 partial. Charging to 4.15 V rejected; capacitor placement upgraded (upstream of both the e-stop and the relay). | README Electrical |
| CDR-53 | electrical | P1-before-demo | no | E-15 upheld, with geometry corrected. CE cross-check: the AG-01 post top is Z135 (DH-01 bridge above it), so the upper tie point moves from Z140 to Z130. | README cable routing |
| CDR-54 | electrical | P1-before-demo | no | E-16 and S-21 merged. CE ruling: port identity by hub-port location plus identity probe (E-16), because the CH340G has no serial number. The S-21 fingerprint, goal=present and 5°/tick clamp are retained. | docs/software_architecture.md §2/§3, README Electrical (d) |

## Rejected

| Finding (part) | Reason |
|---|---|
| M-03 (part) | The Ø53 spigot on TT-01 (already printed: a 4 h 31 reprint) and the PTFE sheet are unnecessary. Floating the lazy-Susan bottom plate removes the redundant constraint at zero cost, and the reviewer accepted that. |
| M-04 (part) | Ø22 posts with a 3 mm sleeve move the stop to 31.5°, below the 36.87° that WORK/ERUPT need. The Z5-root failure claim (air gap, 26 MPa) is disproved: CE slices of the ST-01 STL at Z 7.3-34 show material continuous from y -38.8 to -10.3. The 0.5 kN/58 MPa impact figure ignores crank compliance. Replaced by CDR-07/08/09. |
| M-05 (part) | M4 x 22 rejected. ISO length tolerance (±0.42 mm) against a 0.5 mm window would bottom some screws on the 2020 core and unclamp the arm. M4 x 20 at 2.0 mm engagement is adequate because preload is limited by the borrowed PLA boss. |
| M-06 (part) | Moving AG-01 off the A1 is rejected. With the 90 x 80 foot and 230 mm bar footprint the part is stable on a bed-slinger, and the move only adds schedule risk. The reviewer's 7.5 MPa/3.5° numbers were for the bar and a free-pivot model, not the post. |
| M-08 (part) | Reprinting already-printed parts (ST-04, ST-01 idler, TT-01) only for fillets is rejected. They are stall-only accident cases with SF ≥2 against 10 MPa including Kt. ST-01 is covered by CDR-07. |
| M-10 (part) | The Ø3 tip pin in a Ø3.4 bushing is rejected. A 0.2 mm journal at the outlet would pack with yeast and become the jam point, and free-end runout (≤0.5 mm) fits inside the new 1.0 mm radial clearance. |
| M-12 (part) | The spout key notch in the pockets is rejected. The EISCO spout is a pinched lip 45-60 mm above any pocket wall, so a notch cannot index it. Engraved arrows (CDR-14) instead. |
| M-15 (part) | The fixed 0.4 mm printed gap is rejected (print tolerance ±0.2 mm against a 0.2-0.3 mm full-scale deflection); an adjustable set-screw stop is used instead. The Ø90 pan and skirt are rejected by CE check: Ø90 leaves ~0.9 mm to the arm-B base bbox corner (510.1, 493.3). Capped at Ø80 with an 8 mm lip (CDR-17). |
| M-16 (part) | Reprinting ST-07 with 3.2 mm walls is rejected. It carries kPa-level stress for minutes, roundness is checked each run, and it may already be PETG (CDR-18). |
| M-17 (part) | The ≥6 L basin under ERUPT is rejected. It sits in the PTFE-glide tray's travel path (Y214-420 → Y34-240), so the tray cannot reach ERUPT. Replaced by the 40 mL cap plus drop cloth, pads and a cling-film-protected servo. |
| M-21 (part) | Reprinting TT-01/ST-01 for counterbores is rejected (PLA-roof-limited preload, SF >40 in service). The 2 mm counterbore is rejected on M5x12 length tolerance (tip could reach Z13.65, below the core at 13.9); 1.5 mm used instead. |
| M-23 (part) | 'DIN 988 5x7x1' is not a standard size (d5 shims are 5x10, which would hit the shield). The 1.5 N·m pivot torque would crush any PLA spacer (~90 MPa); a pivot pin needs no preload. |
| M-24 (part) | The table-height foot is rejected. It would have to match the rail height exactly and would rock, and the plate is adequate on its own (σ≈1 MPa, δ≈0.04 mm). |
| M-28 (part) | Extending the ST-01 saddle to Y330 is rejected (reprint). Two M5 at ~1.6 kN preload give ~1 kN of friction against ~10 N of reactions, so any yaw is a fixed offset absorbed by teach. |
| E-02 (part) / S-05 (part) | The 10 µF RESET-GND capacitor is rejected. With servo power relay-gated (off at reset, in the bootloader and with USB unplugged), a reset only makes the servos limp, and a cap that must be removed before flashing is a trap for teammates. S-05's writeMicroseconds-before-attach sequence is superseded because the Servo library is dropped (Timer4 PWM, CDR-41/43). |
| E-03 (part) | Per-branch INA219s are rejected. One INA226 on the bus sum identifies a single 6.8 A stall against a <2.5 A legitimate sum. The '≥8° clear of the stop' commissioning criterion is impossible against 8.13° of design clearance; replaced by ±1.5° (CDR-09). |
| E-05 (part) | M2 pilots on WS-01 are rejected in favour of VHB on the -Y face, which needs no generator change. The -X face is about 5 mm from arm A's shoulder sweep. The printed drip skirt is replaced by the WS-02 lip (CDR-17). |
| E-07 (part) | D2F-L lever microswitches are rejected (4.3 mm of stop overtravel would crush them, and they need features on the printed ST-01). The deck-home Hall is rejected (a carousel mis-index is not a hazard and the grasp check catches it). The INTERNAL 2.56 V reference is rejected (±9%); the INA226 is used instead. |
| E-08 (part) | The XT30 split power connector per servo is rejected. It doubles mis-mate risk for unsupervised assembly, and 20 AWG HD JR extensions meet the <0.7 V drop target while the 300 ms INA trip bounds stall duration. |
| E-14 (part) | Charging to 4.15 V/cell is rejected. The M45CHW HV rating (6.0-8.4 V) covers a standard 4.20 V/cell 2S charge, which sags within seconds under load. A firmware >8.50 V warning is added instead. |
| S-13 (part) | An orientation slot on WS-01 is rejected. WS-01 is located by T-nuts that slide by hand, so its placement error would enter tick0. A slot seating the TPU fin-ray fingers would use the most compliant element as the datum. Replaced by arm-registered CAL-01 plus the rigid CAL-02 probe (CDR-33). |
| S-16 (part) | A ≥80 mL spill tray under WS-02 is rejected as sized. With the 80 mL fill line, the worst-case host-hang overflow into a 74 mL-brim beaker is ≈13-18 mL, covered by the ~24 mL WS-02 v2 lip. The fixed 6.0/10.5 V thresholds are rejected because they would fault a healthy 5 V arm; relative thresholds are used (CDR-50). |
| S-17 (part) | Keeping the Servo library on D9/D10 with bit-level critical sections, and the Timer5 D45/D46 fallback, are superseded by the E-04 Timer4 hardware-PWM design, which is immune to interrupt latency and also avoids USART RX overrun (CDR-43). |
| S-19 (part) | Sourcing the 'V <mV>' message from an A0 divider is rejected; pack voltage comes from INA226 VBUS and bus presence from the A1 divider (CDR-35/46). |
| S-21 (part) | Port resolution by USB VID:PID plus serial number is rejected. The CH340G reports no serial number and the CH340/CH343 bridges can share VID:PID. Hub-port location plus an identity probe is used (CDR-54). |
| S-23 (part) | The mandatory A0 10k/4.7k battery divider is rejected; it is superseded by INA226 VBUS (±0.1%, no AVcc dependence). The separate 200 ms no-edge stall rule is replaced by the single E-10 rule (CDR-49). |
| S-24 (part) | The microswitch in ST-05 is rejected for this event (reprint and wiring of a printed part). The interlock uses the E-07 WORK Hall, the EEPROM last-DONE and operator confirmation instead. 'Stage moves only on operator command' is rejected without the catalyst-in exception (CDR-20). |
| S-25 (part) | Writing and committing firmware, MegaLink and the simulator as part of this CDR is rejected: the user directed that the software not be written beforehand, only structured in the repo. The pre-flight code list stays in §9 as the team's recommended schedule (CDR-37). |
| S-30 (part) | Pinning to Ubuntu 22.04 is rejected (the demo laptop runs Windows 11 with LeRobot 0.6.0 installed; re-imaging two days before the flight is the bigger risk). 20 nickels as the primary calibration mass is rejected (±0.5% scatter); a 100 g class M2 weight is primary and the nickels are the logged backup. |
| M-29 (part) / S-03 (part) | Neither the flat 20 mm pour clearance nor the 10-20 mm lip band is adopted as written. CE ruling: 15-20 mm above the receiver rim for scale pours (≥10 mm margin over post-teach arm error while keeping the stream short) and 20-30 mm above the funnel rim (CDR-31). |
