shaoming11/hh-winners/software/benchsim/reports/demo_run/joints.csv

t_s | scale_g | pourer_shoulder_pan_deg | pourer_shoulder_lift_deg | pourer_elbow_flex_deg | pourer_wrist_flex_deg | pourer_wrist_roll_deg | pourer_gripper_deg | transfer_shoulder_pan_deg | transfer_shoulder_lift_deg | transfer_elbow_flex_deg | transfer_wrist_flex_deg | transfer_wrist_roll_deg | transfer_gripper_deg
0.516 | 0.145 | 29.97 | -29.09 | -60.03 | 29.36 | 2.9 | 21.71 | 29.97 | -29.09 | -60.03 | 29.36 | 2.9 | 21.71
0.616 | 0.036 | 29.97 | -29.09 | -60.03 | 29.36 | 2.9 | 21.71 | 27.77 | -28.74 | -56.51 | 31.82 | 2.9 | 22.32
0.716 | -0.029 | 29.97 | -29.09 | -60.03 | 29.36 | 2.9 | 21.71 | 25.22 | -28.39 | -52.56 | 34.72 | 2.9 | 23.12
0.816 | 0.055 | 29.97 | -29.09 | -60.03 | 29.36 | 2.9 | 21.71 | 22.59 | -27.95 | -48.52 | 37.53 | 2.9 | 23.82
0.916 | 0.148 | 29.97 | -29.09 | -60.03 | 29.36 | 2.9 | 21.71 | 20.04 | -27.6 | -44.56 | 40.43 | 2.9 | 24.61
1.036 | -0.045 | 29.97 | -29.09 | -60.03 | 29.36 | 2.9 | 21.71 | 16.96 | -27.16 | -39.73 | 43.86 | 2.9 | 25.49
1.156 | -0.086 | 29.97 | -29.09 | -60.03 | 29.36 | 2.9 | 21.71 | 13.8 | -26.72 | -34.98 | 47.29 | 2.9 | 26.37
1.276 | -0.15 | 29.97 | -29.09 | -60.03 | 29.36 | 2.9 | 21.71 | 10.72 | -26.19 | -30.15 | 50.71 | 2.9 | 27.25
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
