shaoming11/hh-winners/software/benchsim/reports/demo_safe_stop/scale.csv

t_s | w_g | raw
0.005 | 45.01 | 60141
0.03 | 44.962 | 60121
0.055 | 44.95 | 60116
0.08 | 44.838 | 60069
0.105 | -0.031 | 60121
0.13 | 0.036 | 60149
0.155 | -0.002 | 60133
0.18 | -0.04 | 60117
0.205 | 0.071 | 60164
0.23 | -0.045 | 60115
0.255 | -0.024 | 60124
0.28 | -0.064 | 60107
0.305 | -0.005 | 60132
0.33 | 0.021 | 60143
0.355 | -0.038 | 60118
0.38 | 0.062 | 60160
0.405 | -0.081 | 60100
0.43 | 0.102 | 60177
0.455 | 0.026 | 60145
0.48 | 0.11 | 60180
0.505 | 0.133 | 60190
0.53 | 0.033 | 60148
0.555 | 0.007 | 60137
0.58 | -0.083 | 60099
0.605 | 0.038 | 60150
0.63 | -0.076 | 60102
0.655 | -0.024 | 60124
0.68 | 0.129 | 60188
0.705 | 0.031 | 60147
0.73 | 0.119 | 60184
0.755 | 0.052 | 60156
0.78 | 0.012 | 60139
0.805 | 0.079 | 60167
0.83 | 0.136 | 60191
0.855 | -0.038 | 60118
0.88 | 0.01 | 60138
0.905 | 0.021 | 60143
0.93 | -0.019 | 60126
0.955 | -0.083 | 60099
0.98 | 0.048 | 60154
1.005 | -0.045 | 60115
1.03 | -0.012 | 60129
1.055 | -0.024 | 60124
1.08 | 0.024 | 60144
1.105 | 0.019 | 60142
1.13 | -0.086 | 60098
1.155 | 0.043 | 60152
1.18 | -0.005 | 60132
1.205 | 0.069 | 60163
1.23 | -0.043 | 60116
1.255 | -0.15 | 60071
1.28 | -0.033 | 60120
1.305 | 0.002 | 60135
1.33 | 0.055 | 60157
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
