shaoming11/hh-winners/software/benchsim/reports/demo_run/frames/0063.39_overview.png

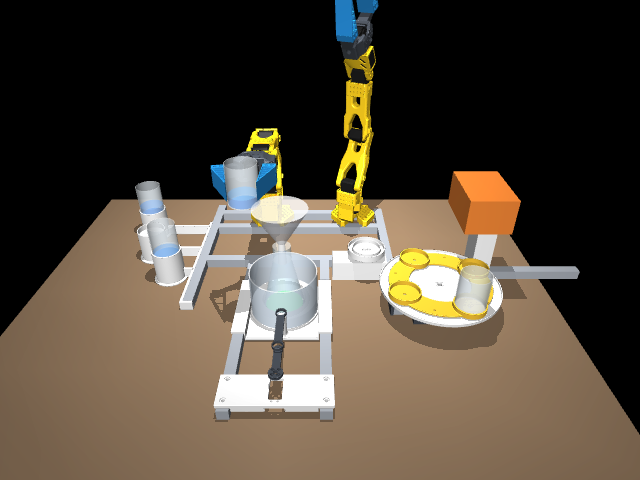
software/benchsim/reports/demo_run/frames/0063.39_overview.png
