shaoming11/hh-winners/software/benchsim/reports/demo_run/frames/0169.69_overview.png

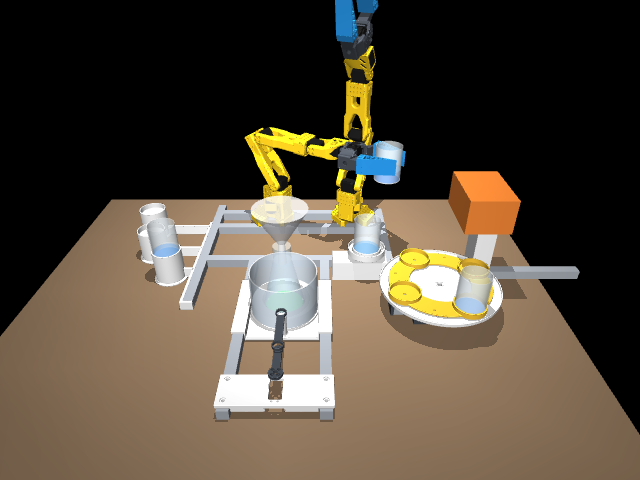
software/benchsim/reports/demo_run/frames/0169.69_overview.png
