shaoming11/hh-winners/software/benchsim/reports/demo_run/frames/0290.69_foam_cam.png

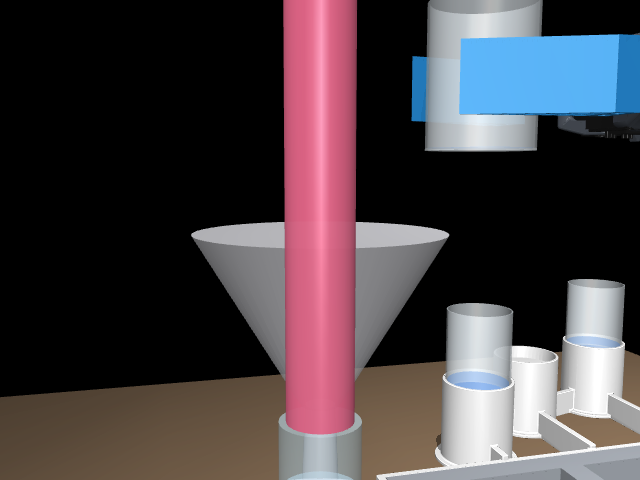
software/benchsim/reports/demo_run/frames/0290.69_foam_cam.png
