shaoming11/hh-winners/software/benchsim/reports/foam_frames/foam_t04.17s.png

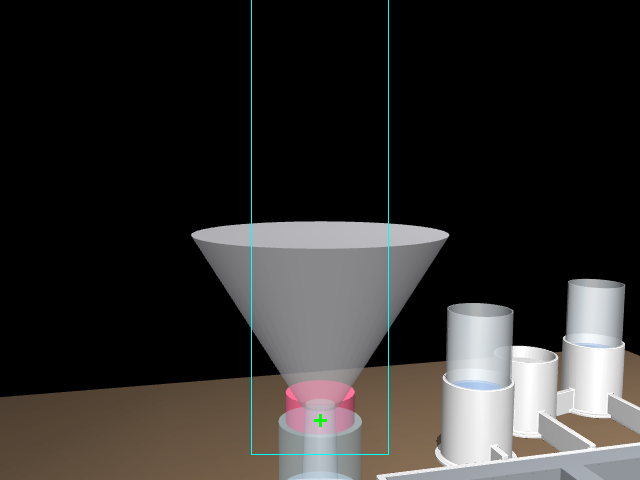
software/benchsim/reports/foam_frames/foam_t04.17s.png
