shaoming11/hh-winners/software/benchsim/reports/grasp_demo/carousel_to_scale_5_grasp.png

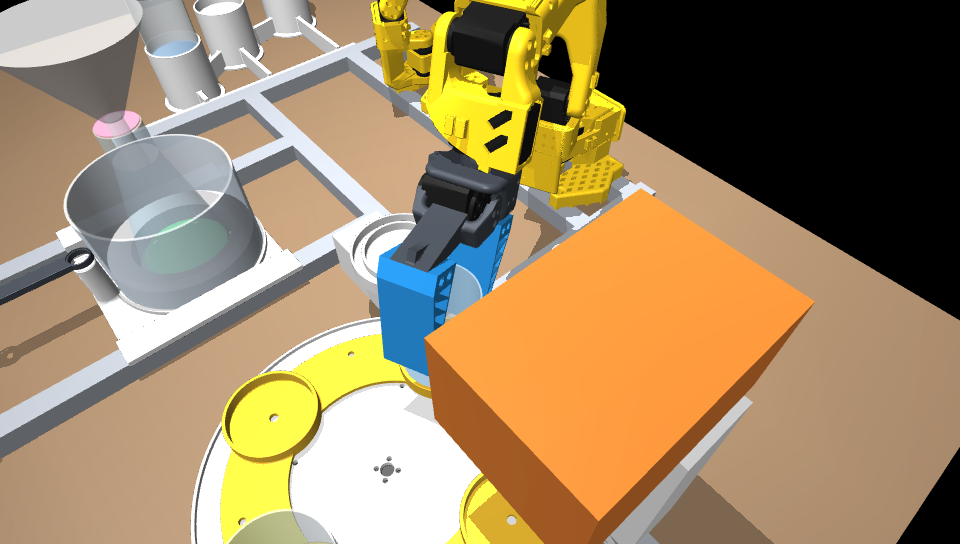
software/benchsim/reports/grasp_demo/carousel_to_scale_5_grasp.png
