shaoming11/hh-winners/software/benchsim/reports/grasp_demo/carousel_to_scale_9_final.png

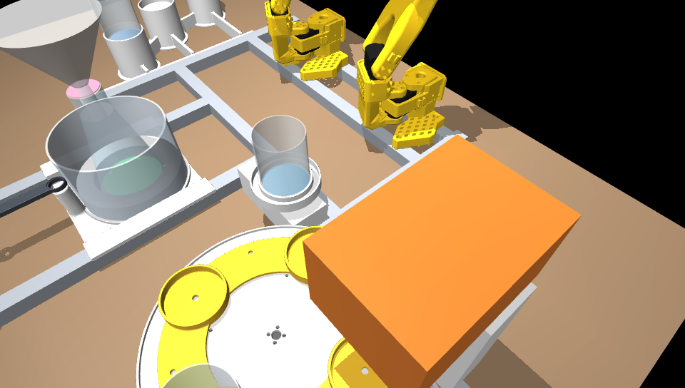
software/benchsim/reports/grasp_demo/carousel_to_scale_9_final.png
