shaoming11/hh-winners/software/benchsim/reports/grasp_demo/rack_to_scale_0_start.png

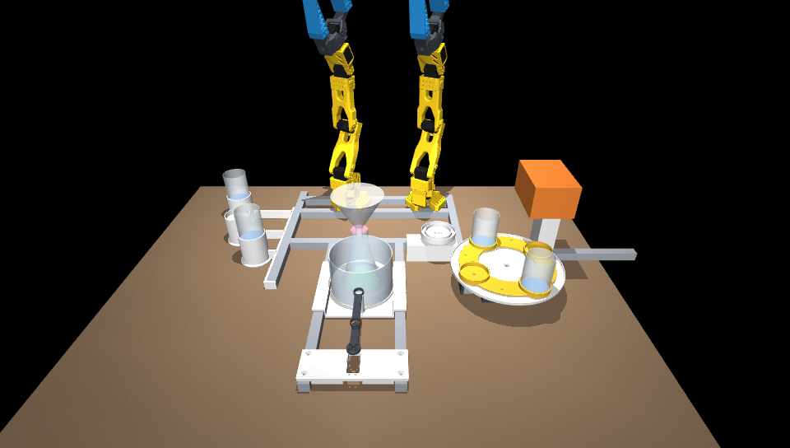
software/benchsim/reports/grasp_demo/rack_to_scale_0_start.png
