shaoming11/hh-winners/software/benchsim/reports/grasp_demo/rack_to_scale_2_grasp.png

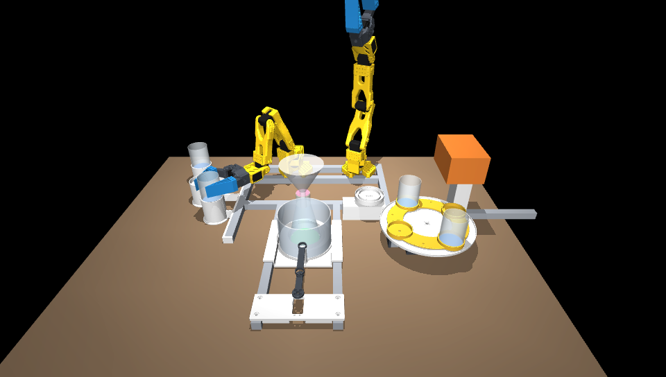
software/benchsim/reports/grasp_demo/rack_to_scale_2_grasp.png
