shaoming11/hh-winners/software/benchsim/reports/grasp_demo/t_c2s_5_grasp.png

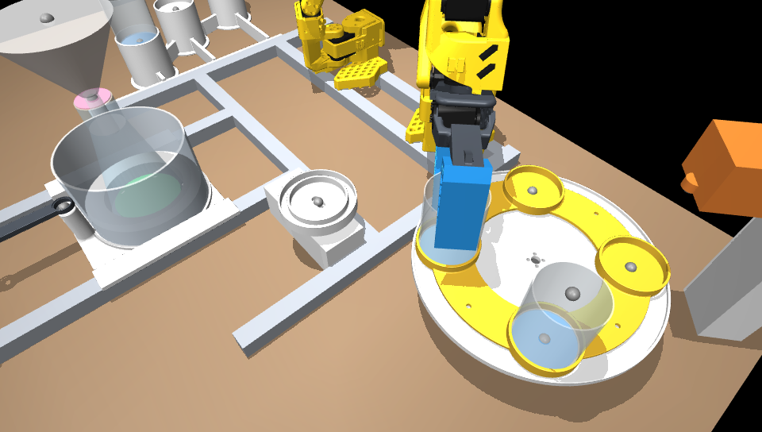
software/benchsim/reports/grasp_demo/t_c2s_5_grasp.png
