shaoming11/hh-winners/software/benchsim/reports/grasp_demo/t_c2s_9_placement.png

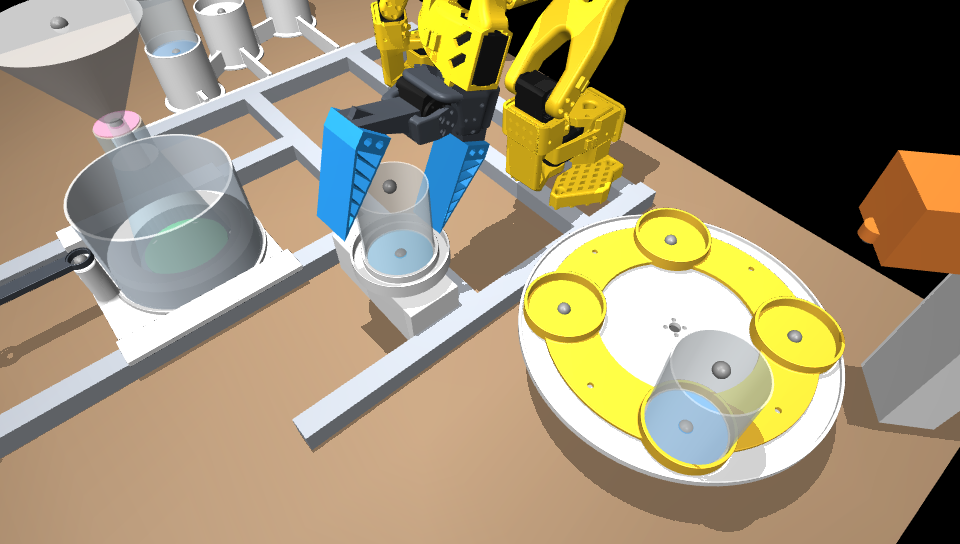
software/benchsim/reports/grasp_demo/t_c2s_9_placement.png
