shaoming11/hh-winners/software/benchsim/reports/grasp_demo/t_miss_8_failed.png

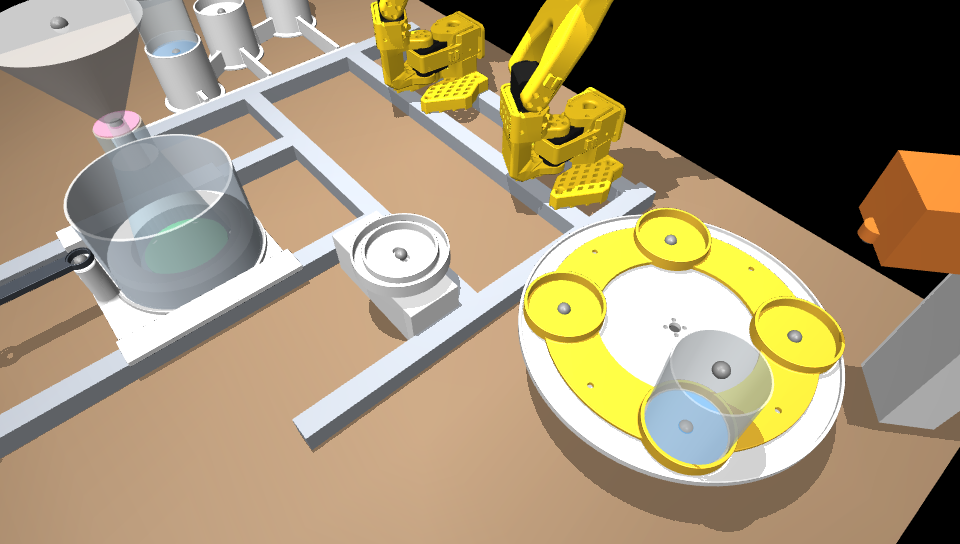
software/benchsim/reports/grasp_demo/t_miss_8_failed.png
