shaoming11/hh-winners/software/benchsim/runs/20261017T053913Z-sim/frames/0000.00_overview.png

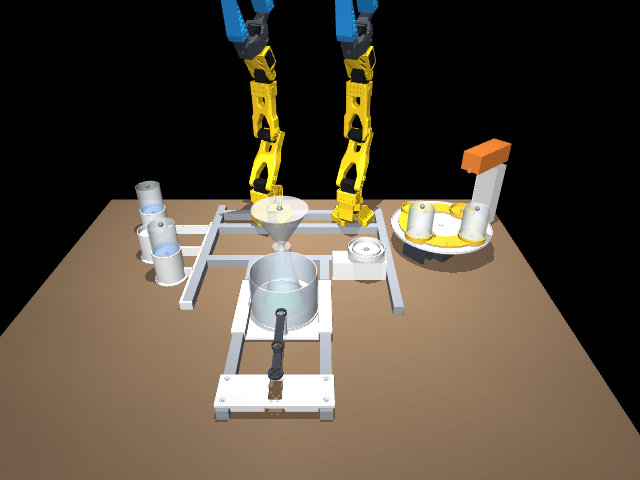
software/benchsim/runs/20261017T053913Z-sim/frames/0000.00_overview.png
