shaoming11/hh-winners/software/benchsim/runs/fx_preview/dose/0004.01_close.png

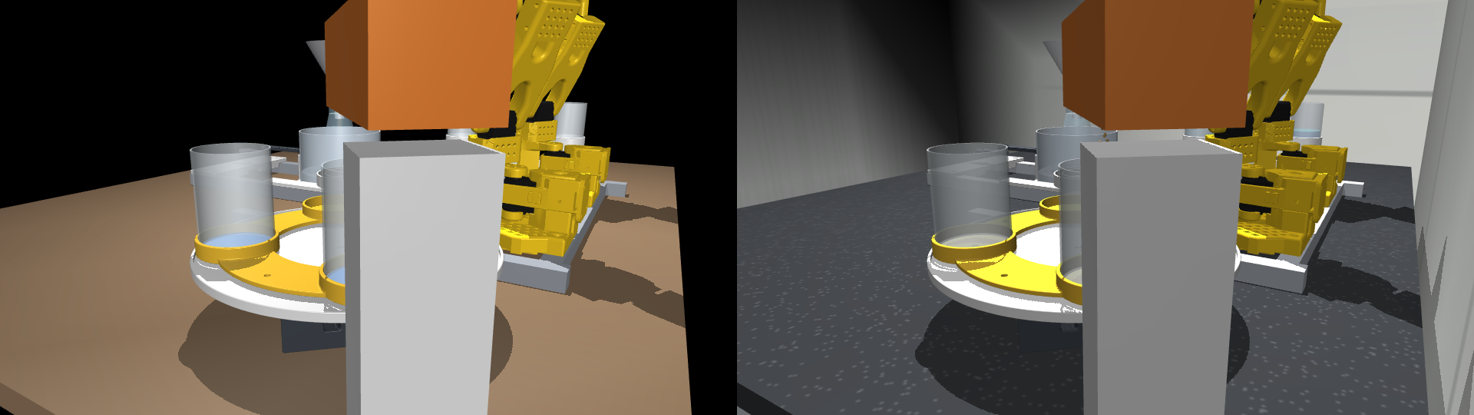
software/benchsim/runs/fx_preview/dose/0004.01_close.png
