shaoming11/hh-winners/software/benchsim/runs/fx_preview/dose/0004.71_bench_cam.png

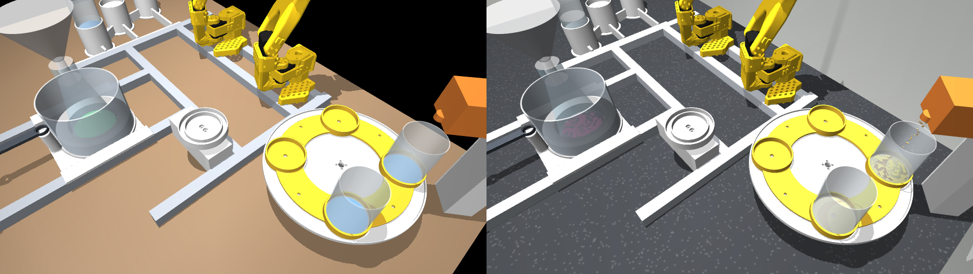
software/benchsim/runs/fx_preview/dose/0004.71_bench_cam.png
