shaoming11/hh-winners/software/benchsim/runs/fx_preview/foam/0004.37_wide_t+03.0s.png

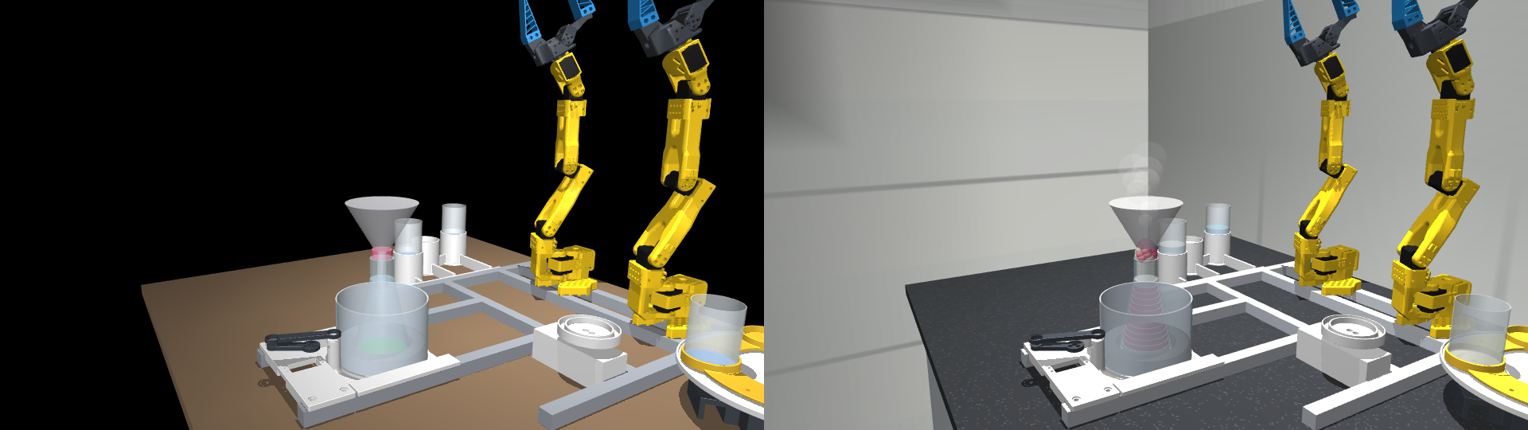
software/benchsim/runs/fx_preview/foam/0004.37_wide_t+03.0s.png
