shaoming11/hh-winners/software/benchsim/runs/fx_preview/foam/0004.70_overview_t+04.5s.png

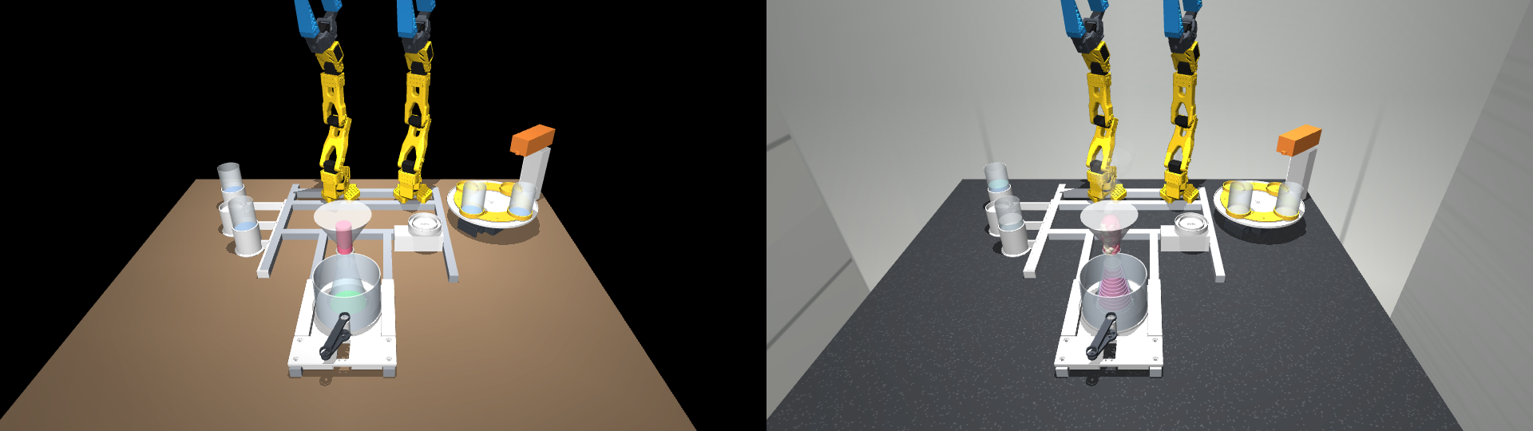
software/benchsim/runs/fx_preview/foam/0004.70_overview_t+04.5s.png
