shaoming11/hh-winners/software/benchsim/runs/fx_preview/foam/0006.20_wide_t+06.0s.png

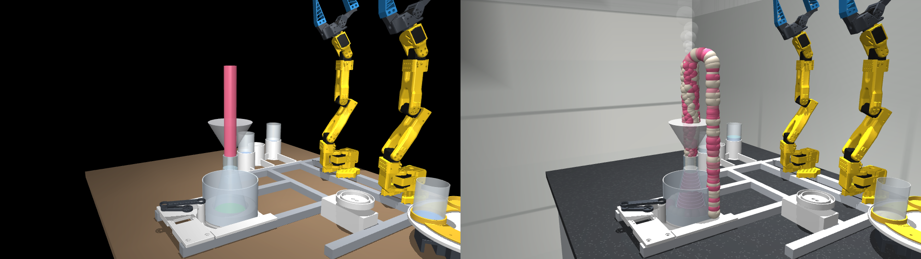
software/benchsim/runs/fx_preview/foam/0006.20_wide_t+06.0s.png
