shaoming11/hh-winners/software/benchsim/runs/fx_preview/foam/0020.20_foam_cam_t+20.0s.png

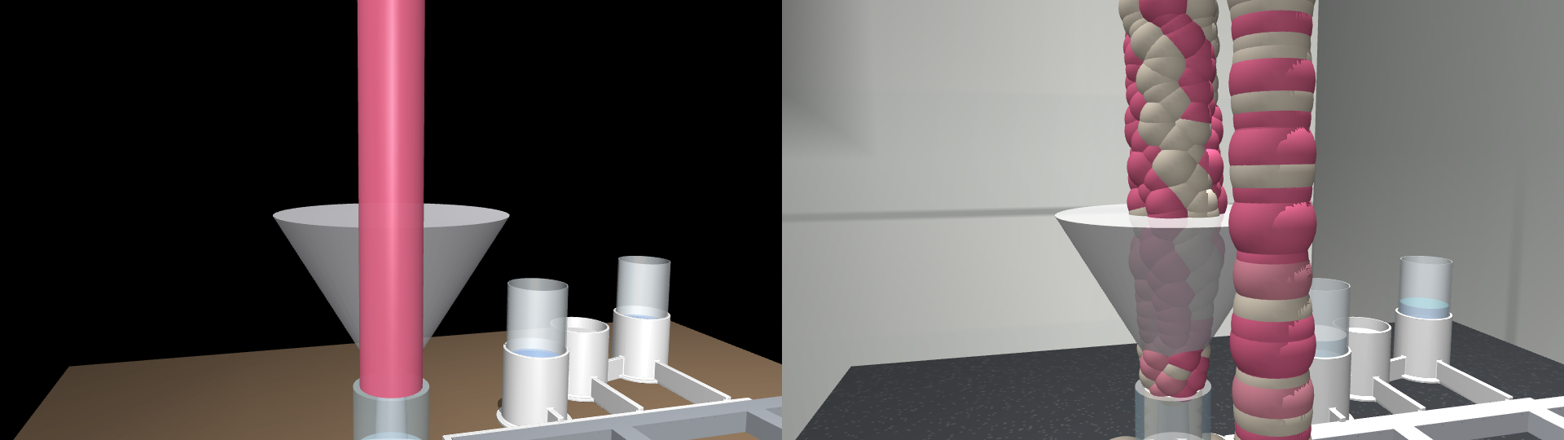
software/benchsim/runs/fx_preview/foam/0020.20_foam_cam_t+20.0s.png
