shaoming11/hh-winners/software/benchsim/runs/fx_preview/foam/0060.20_foam_cam_t+60.0s.png

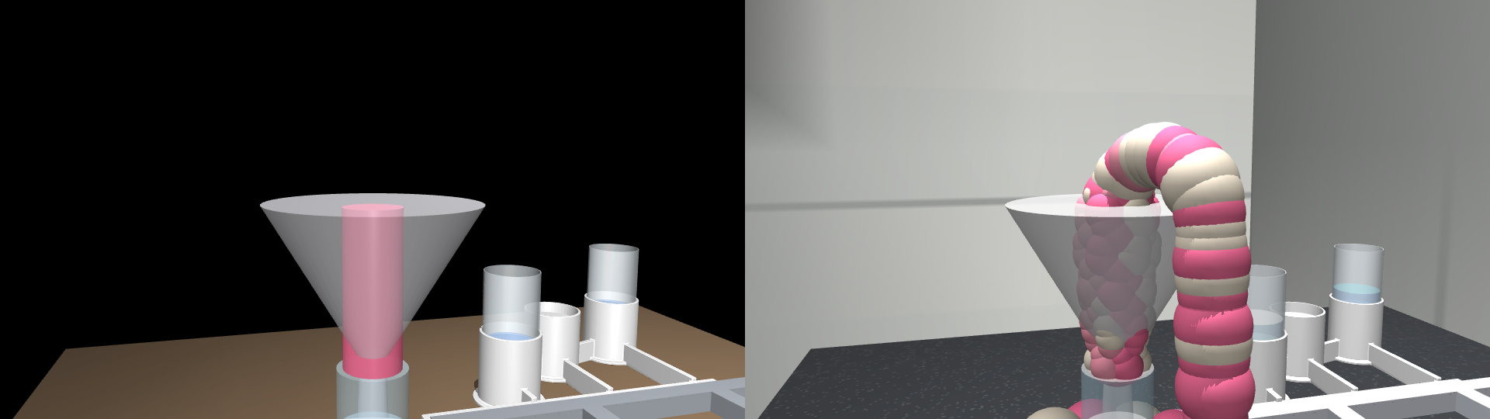
software/benchsim/runs/fx_preview/foam/0060.20_foam_cam_t+60.0s.png
