shaoming11/hh-winners/software/benchsim/runs/fx_preview/funnel/0013.48_close.png

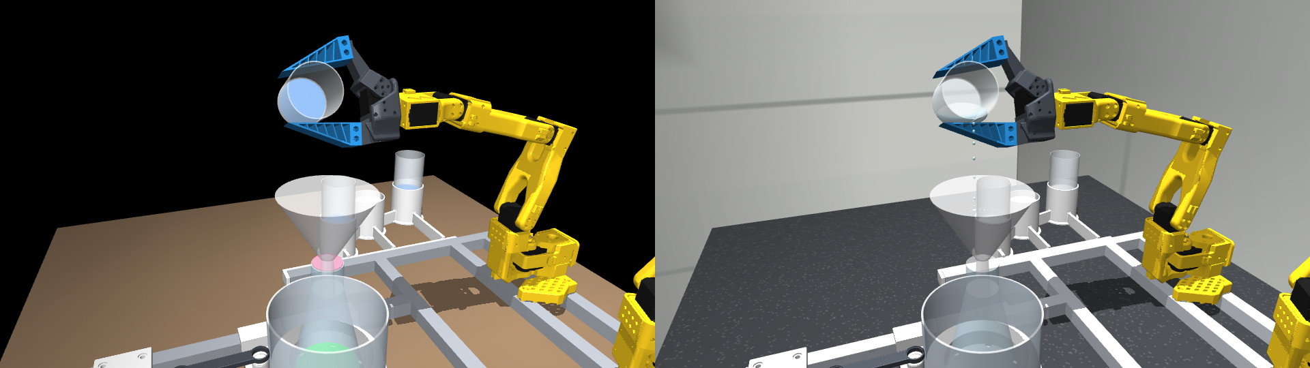
software/benchsim/runs/fx_preview/funnel/0013.48_close.png
