shaoming11/hh-winners/software/benchsim/runs/fx_preview/funnel/0013.98_flask.png

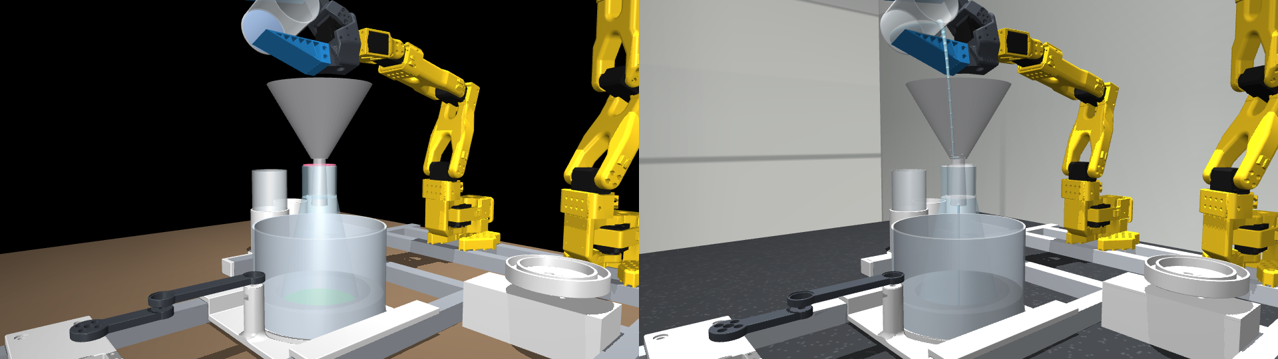
software/benchsim/runs/fx_preview/funnel/0013.98_flask.png
