shaoming11/hh-winners/software/benchsim/runs/fx_preview/funnel/0014.49_overview.png

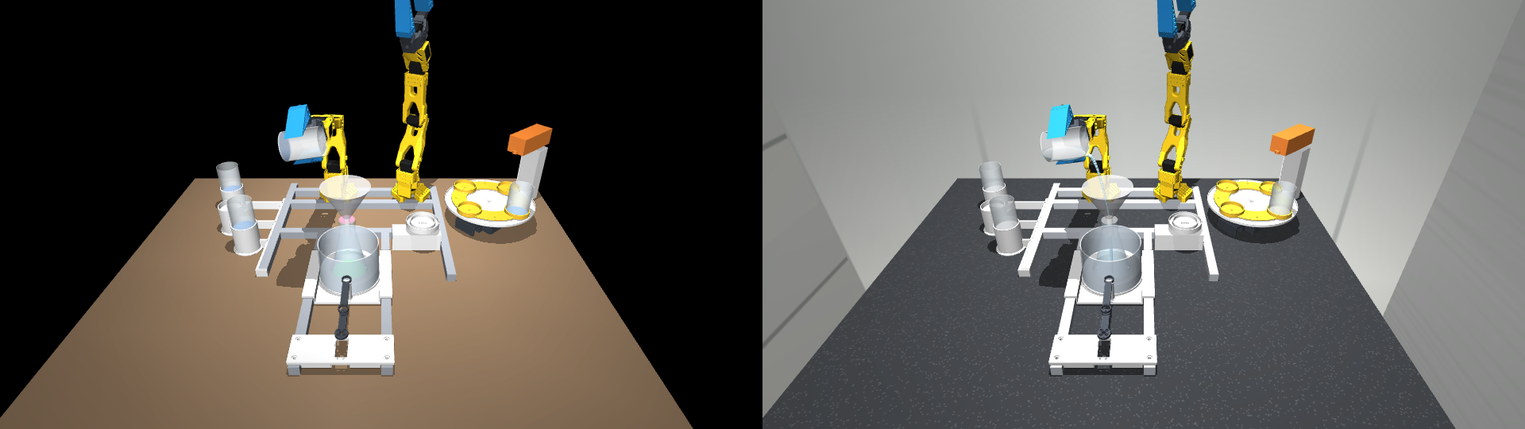
software/benchsim/runs/fx_preview/funnel/0014.49_overview.png
