shaoming11/hh-winners/software/benchsim/runs/fx_preview/funnel/0016.49_close.png

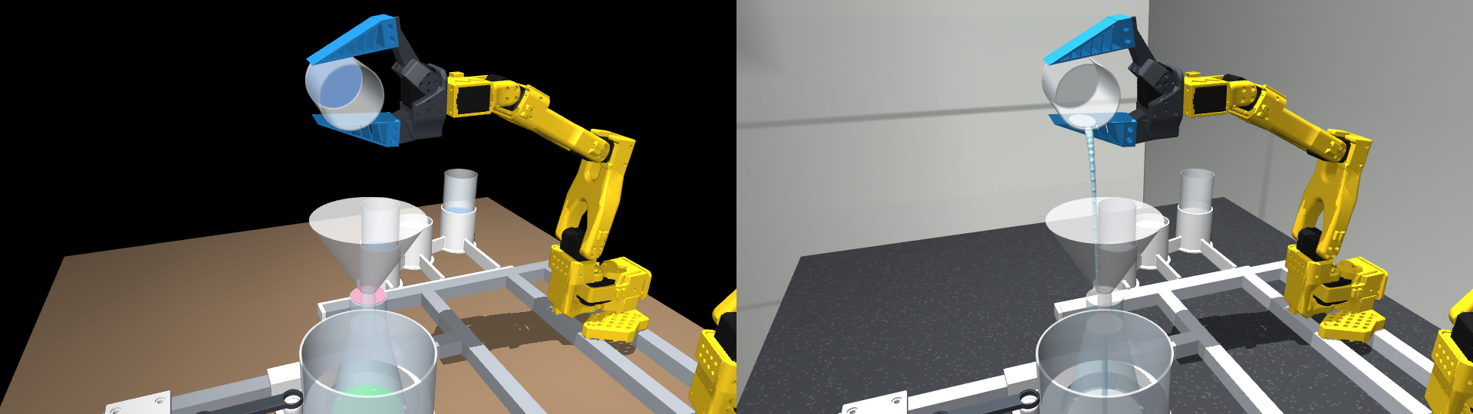
software/benchsim/runs/fx_preview/funnel/0016.49_close.png
