shaoming11/hh-winners/software/benchsim/runs/fx_preview/pour/0019.04_close.png

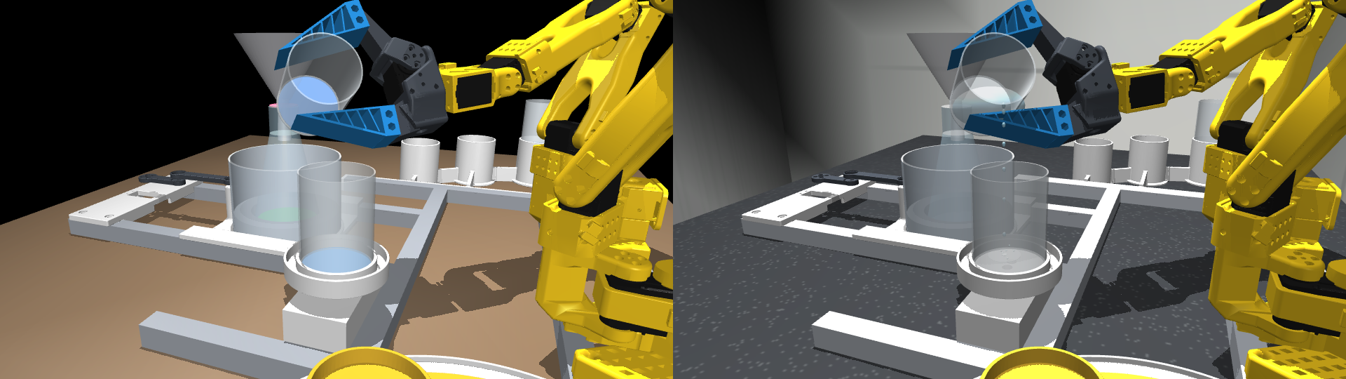
software/benchsim/runs/fx_preview/pour/0019.04_close.png
