shaoming11/hh-winners/software/benchsim/runs/fx_preview/pour/0019.64_side.png

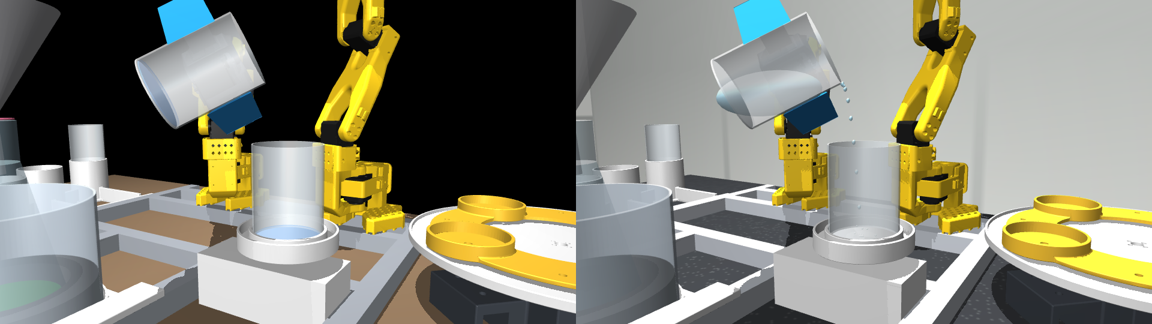
software/benchsim/runs/fx_preview/pour/0019.64_side.png
