shaoming11/hh-winners/bom/BOM_final.md

# Final bill of materials (LEAN v4, as ordered)

Status: **ordered 2026-10-14**, shipped to Boston 02215. Source:
[Google Sheet "Wet Lab Bench - LEAN Order List v4 (Oct 14)"](https://docs.google.com/spreadsheets/d/17d2MXRSbegNUYcjjpSLNEWjm604agthDyUk6FDgXbmU/edit).
Links match `bom/BOM_links.csv` by id; the four add-ons at the bottom come from the sheet.
Prices are logged-out Amazon list prices from Oct 14.

- **Totals:** the LEAN v4 buy list is **$302.51**. On top of that came four add-ons: an M4 kit, M4 ×
  20 SHCS, M4 × 20 BHCS and VHB tape. Everything went out in two Amazon orders, $213.83 + $123.42.
- **Delivery:** the 100 mL beakers arrive **Saturday**. Until then, use printed dummy beakers
  for dry runs ([../docs/print_list.md](../docs/print_list.md)).
- **No new purchases.** Design changes must use only what is listed here or already owned.

The older `BOM.csv`, `BOM.md`, `BOM_links.*` and `delivery_check*` files list the full post-CDR
set (about $1,050). They are kept for reference; this file is what was actually bought.

## Bought (LEAN v4)

| id | Item | Why it is needed | Qty | Link | Price |
|---|---|---|---|---|---|
| FR-06 | F625ZZ flanged bearing 5 × 16 × 5 (10-pk) | Stage connecting rod (ST-14) | 1 | [B0G1B256ZS](https://www.amazon.com/dp/B0G1B256ZS) | $8.49 |
| F-30 | M4 hammer-head T-nuts for 2020 (100-pk) | All frame joints are M4 | 1 | [B0C9DJBG1H](https://www.amazon.com/dp/B0C9DJBG1H) | $5.09 |
| F-31 | M4 × 10 SHCS, 12.9 black (120-pk) | All frame joints are M4; RK-03 spine | 1 | [B0DYSDQ6TV](https://www.amazon.com/dp/B0DYSDQ6TV) | $7.99 |
| F-01 | M3 screw kit (M3 × 6..30 + hex nuts + washers) | Servo horns (M3 holes), gripper finger clamps, auger head, servo ears. Auger flange uses M3 × 6. Plain hex nut + Loctite where nylocs were planned | 1 | [B0FGV5FCBN](https://www.amazon.com/dp/B0FGV5FCBN) | $9.99 |
| F-18 | M5 screw kit (M5 × 8..35 + nuts) | Stage pivot only: 1 × M5 × 25 + nut through the F625ZZ bearings | 1 | [B0FGV561HZ](https://www.amazon.com/dp/B0FGV561HZ) | $9.99 |
| ELE-31 | 25T aluminium servo horn (10-pk) | Auger, carousel and stage servos all couple through these | 1 | [B0875ZS9KF](https://www.amazon.com/dp/B0875ZS9KF) | $8.99 |
| FR-07 | Lazy Susan bearing, 4 in | Carousel turntable bearing (TT-01 is built around it) | 1 | [B08CY2P8KZ](https://www.amazon.com/dp/B08CY2P8KZ) | $15.99 |
| ELE-08 | 1 kg load cell + HX711 | The scale | 1 | [B09K7G51KJ](https://www.amazon.com/dp/B09K7G51KJ) | $9.99 |
| CON-09 | Loctite 242 blue | Replaces nylon lock nuts on the gripper clamps and stage pivot | 1 | [B000I1RSNS](https://www.amazon.com/dp/B000I1RSNS) | $7.02 |
| TOO-02 | Long metric hex key set | Assembly | 1 | [B0CJBRYQF3](https://www.amazon.com/dp/B0CJBRYQF3) | $9.99 |
| FR-04 | Deep-reach C-clamp (2-pk) | Clamps the bench to the table so the arms can't walk it | 1 | [B0CBZ9J74Y](https://www.amazon.com/dp/B0CBZ9J74Y) | $19.06 |
| ELE-22 | XT60 lead with inline blade-fuse holder | Battery connector + main fuse in one part | 1 | [B0BZ7Y1DQY](https://www.amazon.com/dp/B0BZ7Y1DQY) | $12.99 |
| ELE-21 | 10 A blade fuses | Main fuse | 1 | [B0DSCGW488](https://www.amazon.com/dp/B0DSCGW488) | $4.99 |
| ELE-23b | 22 mm e-stop, 2 NC | Pole 1 cuts servo power; pole 2 tells the Mega (D2) | 1 | [B07NP44T74](https://www.amazon.com/dp/B07NP44T74) | $13.99 |
| ELE-28 | 2200 µF 16 V capacitor | Stops servo brown-outs | 1 | [B0FVGBGMW2](https://www.amazon.com/dp/B0FVGBGMW2) | $6.99 |
| ELE-17 | WAGO lever-nut kit | Power distribution with no soldering | 1 | [B0CJ5QF3VX](https://www.amazon.com/dp/B0CJ5QF3VX) | $20.95 |
| ELE-12 | Servo extension 100 cm (5-pk) | Carousel / stage / auger servos reach the Mega | 1 | [B0CXR2YBS4](https://www.amazon.com/dp/B0CXR2YBS4) | $24.49 |
| HDW-07 | ABS project box | Holds the e-stop and keeps foam and liquid off the electronics | 1 | [B06XSQZ5M6](https://www.amazon.com/dp/B06XSQZ5M6) | $9.99 |
| CHM-01 | 12 % hydrogen peroxide, 32 oz | The reaction. Alternative: Sally Beauty Cambridge, 40 Vol **clear** developer | 2 | [B09HW9VJGQ](https://www.amazon.com/dp/B09HW9VJGQ) | $27.90 |
| LAB-02 | EISCO 100 mL PP beakers, 56 × 74 (12-pk) | Rack, carousel and scale beakers: the only beaker size on the bench | 1 | [B00BHLE5RU](https://www.amazon.com/dp/B00BHLE5RU) | $16.29 |
| GLS-01 | 250 mL Erlenmeyer flask | Reaction flask + 1 spare | 2 | [B006VYY10Y](https://www.amazon.com/dp/B006VYY10Y) | $16.40 |
| LAB-03 | 4 in funnel | Pours go through it into the flask | 1 | [B017UYYKSQ](https://www.amazon.com/dp/B017UYYKSQ) | $9.99 |
| SAF-02 | Splash goggles | 12 % peroxide causes serious eye damage | 2 | [B0CJVDBZW3](https://www.amazon.com/dp/B0CJVDBZW3) | $15.98 |
| SAF-03 | Nitrile gloves | Handling the peroxide and the foam | 1 | [B0C9S5PMSD](https://www.amazon.com/dp/B0C9S5PMSD) | $8.97 |
| | **Total** | | | | **$302.51** |

## Added to the order

| Item | Use | Link | Price |
|---|---|---|---|
| M4 screw assortment ("M4 longer screws") | Longer M4 screws for the frame | [B0GG8SZC1W](https://www.amazon.com/dp/B0GG8SZC1W) | see order |
| M4 × 20 socket head (SHCS) | Arm bases, back row | [B0GHNNRZ4F](https://www.amazon.com/dp/B0GHNNRZ4F) | see order |
| M4 × 20 button head (BHCS, ISO 7380) | Arm bases, front row (low head under the shoulder link) | [B07H17FG9R](https://www.amazon.com/dp/B07H17FG9R) | $8.89 |
| 3M 4950 VHB tape, 1 in × 5 yd | Under TT-01 (carousel + auger unit) | [B007Y7GIKI](https://www.amazon.com/dp/B007Y7GIKI) | $22.29 |

## Buy locally

| id | Item | Where |
|---|---|---|
| CHM-04 | Instant dry yeast | Grocery store (about $2 for 3 packets) |
| CHM-02 | Dish soap + food colouring | Grocery store / CVS |

## Already owned or borrowed (do not buy)

- 8 × 400 mm 2020 extrusions, angle brackets, M4 screws and M4 T-nuts.
- Wire, zip ties, solder, USB cables.
- FlashHobby M45CHW servos (carousel and stage), Feetech FB5311M-360 (auger).
- 2S LiPo with XT60, Arduino Mega 2560 Pro.
- PLA and TPU 95A filament.
- 2 × SO-101 arms **with their power adapters** (borrowed).

## Dropped from the earlier BOM

Kapton tape, ASI 388 silicone, cork, silicone sheet, thermometer, standoffs, resistor and
capacitor kits, perfboard, **relay, INA226 + shunt, Hall sensors + magnets, branch fuses, 470 µF
capacitor**, M5 T-nut and bracket kits, nyloc kit, set screw, marker, M5 bracket screws. The
electrics that remain are described in [../docs/electrical.md](../docs/electrical.md).
