shaoming11/hh-winners/bom/delivery_check_v2.md

# Delivery check v2: everything to BU (ZIP 02215) by Fri Oct 16

## DEADLINES (Eastern, Wed Oct 14)

- **Thursday: order by 7:30 PM ET.** This covers every item that has a Thursday option. The earliest Thursday cutoffs are 7:39 PM (ELE-33 cap kit, SAF-01 glasses, FAS-08 nylocs), then 8:39 PM (HDW-04 clamps) and 8:44 PM (FAS-09, 2 left). Thursday for *every* item is not possible: ELE-23 boxed e-stop, LAB-02 and ELE-27 are Friday-only, and LAB-01 is Saturday.
- **Friday: order everything by ~11:30 PM ET tonight.** Most Thursday cutoffs are 11:39 PM and Friday-only items cut off at ~11:59 PM. Friday is a delivery *date*, not guaranteed morning (up to ~10 PM).
- **Can't make Friday at all:** LAB-01 (EISCO 50 mL beakers, now Sat Oct 17).
- All Thu/Fri dates need a **Prime** account. Without Prime every item shows Mon Oct 19.

**Checked:** Wed 2026-10-14 ~16:08-16:20 EDT, amazon.com, not signed in, Deliver to Boston 02215. Thu/Fri dates are the 'Prime members get FREE delivery' line; without Prime every item shows Mon Oct 19. Cutoffs = check time + 'Order within' countdown (+/- 10 min). Fri dates are date-only, not guaranteed morning. Every listing below ships from Amazon (FBA, Prime-eligible). None ships from overseas. The only overseas listings seen (e.g. e-stop B0HGX86M7Y, Oct 22-26) were rejected.

**Changes since v1:** FAS-05 M3 kit B0FG2BRXL3 slipped to **Sat** (replaced by B0FGV5FCBN). GLS-02 B099QK8PX8 and TOO-03 B07S2DCVR2 slipped to Fri (Thursday substitutes below). LAB-01 slipped from Fri to **Sat**. ELE-23 B07GPF76R1 is now **Fri** with a cutoff around midnight. Genuine WAGO 25-pk B0107SYYGU is now Sat.

| id | item | qty | link | price (pack) | ships from / sold by | Thu cutoff | Fri cutoff | verdict | note |
|---|---|---|---|---|---|---|---|---|---|
| NEW-a | 2020 inside corner bracket, black aluminium, 20 sets incl. 40 M5 T-nuts + 40 M5 SHCS (need 12) | 1 | [B0F1B85397](https://www.amazon.com/dp/B0F1B85397) | $14.99 (20 sets) | Amazon / TOCLUX | 11:39 PM | - | **OK-THU** | Alt Iverntech 20 pc alu B091GH5QKF $17.89 (Thu, cutoff 7:39 PM). HONJIE B09R8SDF8T is Fri only. |
| NEW-b1 | M3 SHCS kit 1120 pc M3x6/8/10/12/16/20/25/30 + nuts + washers (Fasteners Pro) | 1 | [B0FGV5FCBN](https://www.amazon.com/dp/B0FGV5FCBN) | $9.99 (1120 pc) | Amazon / Fasteners Pro | 11:39 PM | - | **OK-THU** | REPLACES FAS-05 B0FG2BRXL3, which now shows SATURDAY Oct 17 (too late). Same brand, larger kit, includes hex nuts. Covers FAS-01/05/07/17/19/20. |
| NEW-b2/c2 | Metric nylon-insert lock nut (DIN 985) + hex nut kit 206 pc: M3 lock x30, M5 lock x20, M3/M5 hex | 1 | [B0F62DG4DV](https://www.amazon.com/dp/B0F62DG4DV) | $9.99 (206 pc) | Amazon / BNUOK Fasterner | 11:39 PM | - | **OK-THU** | Covers ~20 M3 nylocs (b), M5 hex + nylocs (c) and FAS-08. Stainless A2-70. |
| NEW-c1 | M5x25 SHCS 12.9, 60 pc | 1 | [B0GHNNR8YZ](https://www.amazon.com/dp/B0GHNNR8YZ) | $7.30 (60) | Amazon / Svling Fastener | 11:39 PM | - | **OK-THU** | Need 2. M5 kit B0FGV561HZ (FAS-11) has only ~9 per length; buy this so the kit is not short. |
| NEW-d | M5x10 SHCS 12.9, 100 pc | 1 | [B0GHNN6HQ4](https://www.amazon.com/dp/B0GHNN6HQ4) | $8.09 (100) | Amazon / Svling Fastener | 11:39 PM | - | **OK-THU** | Need 8. M5 kit has only ~9 per length, so buy a dedicated pack. |
| NEW-e1 / ELE-23 | Taiss 22 mm red latching mushroom e-stop, 2 NC, in station box | 1 | [B07GPF76R1](https://www.amazon.com/dp/B07GPF76R1) | $16.99 (1) | Amazon / SEA-GULL | - | 11:59 PM | **OK-FRI** | Exact spec. Now FRI Oct 16 (cutoff ~midnight tonight). No boxed 2NC e-stop on Amazon shows Thursday (boxed B0F89WHD36 is Thu but 1NO+1NC). |
| NEW-e2 | TWTADE 22 mm 2NC red latching mushroom e-stop (bare, no box), YW1B-V4E02R | 1 | [B07NP44T74](https://www.amazon.com/dp/B07NP44T74) | $13.99 (1) | Amazon / TAISHUN | 11:39 PM | - | **OK-THU** | THURSDAY backup: panel-mount in a 22 mm hole in the HDW-07 ABS box or a printed box. Order both; cheap insurance. |
| NEW-f / HDW-01 | uxcell F625ZZ flanged bearing 5x16x5, 10 pc | 1 | [B0G1B256ZS](https://www.amazon.com/dp/B0G1B256ZS) | $8.49 (10) | Amazon / Amadeo City | 11:39 PM | - | **OK-THU** | Earlier BOM listing still arrives Thu. ONLY 5 LEFT: order early. |
| GLS-01 | Karter 250 mL Erlenmeyer | 2 | [B006VYY10Y](https://www.amazon.com/dp/B006VYY10Y) | $8.20 ea (1) | Amazon / Lake Charles Mfg | 11:39 PM | - | **OK-THU** |  |
| GLS-02 | Glass stir rods 6 mm x 6 in, 15 pk (Gardena) | 1 | [B0D1NCM4R4](https://www.amazon.com/dp/B0D1NCM4R4) | $8.98 (15) | Amazon / Gardena | 9:34 PM | - | **OK-THU** | SUBSTITUTE: BOM listing B099QK8PX8 slipped to FRI. |
| GLS-03 | Karter 100 mL glass graduated cylinder | 1 | [B006UKIASI](https://www.amazon.com/dp/B006UKIASI) | $10.99 (1) | Amazon / Lake Charles Mfg | 11:39 PM | - | **OK-THU** |  |
| LAB-01 | EISCO 50 mL PP beaker 43 OD x 61 H (single per listing) | 6 | [B00BHLE5AW](https://www.amazon.com/dp/B00BHLE5AW) | $9.19 ea (1) | Amazon / The Lab Stockroom | - | - | **AT RISK** | Now SATURDAY Oct 17 (was Fri), only 11 left. No EISCO 50 mL listing arrives Thu/Fri. Stopgap: DAJAVE 50 mL cups 100 pk B09Y2TXFDT $14.99 Thu (cutoff 9:19 PM), dimensions NOT verified against the 43 x 61 carousel pockets. |
| LAB-02 | EISCO 100 mL PP beaker, 12 pk | 1 | [B00BHLE5RU](https://www.amazon.com/dp/B00BHLE5RU) | $16.29 (12) | Amazon / The Lab Stockroom | - | 11:59 PM | **OK-FRI** | Fri only (date, not guaranteed morning). Thu alt Waziaqoc 12 pk B0DGT4WDGF $9.99 is 62.5 x 68.5 mm, not the 56 x 74 EISCO. |
| LAB-03 | EISCO 4 in PP funnel | 1 | [B017UYYKSQ](https://www.amazon.com/dp/B017UYYKSQ) | $9.99 (1) | Amazon / The Lab Stockroom | 11:39 PM | - | **OK-THU** |  |
| FAS-02 | ISO 7380 M4x20 button head, 50 pc | 1 | [B07H17FG9R](https://www.amazon.com/dp/B07H17FG9R) | $8.89 (50) | Amazon / Fullerkreg | 11:39 PM | - | **OK-THU** |  |
| FAS-03/14 | mxuteuk M4 12.9 SHCS kit | 1 | [B0CHJDMJ3H](https://www.amazon.com/dp/B0CHJDMJ3H) | $8.99 (kit) | Amazon / mxuteuk | 9:34 PM | - | **OK-THU** |  |
| FAS-04 | 2020 M4 drop-in T-nut, 100 | 1 | [B0B1LTL6M5](https://www.amazon.com/dp/B0B1LTL6M5) | $5.99 (100) | Amazon / HELIFOUNER | 11:39 PM | - | **OK-THU** |  |
| FAS-08 | DIN 985 M3 nylon locknut, 120 (optional) | 0-1 | [B0FJ8QP76C](https://www.amazon.com/dp/B0FJ8QP76C) | $9.23 (120) | Amazon / Kinhon Rock | 7:39 PM | - | **OK-THU** | OPTIONAL now: NEW-b2/c2 kit has 30 M3 nylocs. Early cutoff 7:39 PM. |
| FAS-09 | M3x12 set screw | 1 | [B0DDHL6P99](https://www.amazon.com/dp/B0DDHL6P99) | $6.89 (-) | Amazon / AMZ-Fasteners | 8:44 PM | - | **OK-THU** | Only 2 left. Backup: Ace/Home Depot. |
| FAS-11 | M5 SHCS kit 272 pc M5x8-35 + nuts | 1 | [B0FGV561HZ](https://www.amazon.com/dp/B0FGV561HZ) | $9.99 (272) | Amazon / Fasteners Pro | 11:39 PM | - | **OK-THU** |  |
| FAS-13 | 2020 M5 T-nut + M5 screw kit 240 pc | 1 | [B0DMCS8KW4](https://www.amazon.com/dp/B0DMCS8KW4) | $12.99 (240) | Amazon / JCSPBYL | 11:39 PM | - | **OK-THU** | Covers FAS-10/12. |
| FAS-16 | ruthex M5 heat-set inserts, 50 | 1 | [B07YSVXWS8](https://www.amazon.com/dp/B07YSVXWS8) | $9.99 (50) | Amazon / ruthex | 9:34 PM | - | **OK-THU** |  |
| FAS-18 | M3 brass standoff kit | 1 | [B06XQ33Y9X](https://www.amazon.com/dp/B06XQ33Y9X) | $8.99 (120) | Amazon / ALBERT GUY | 9:34 PM | - | **OK-THU** | Only 13 left. |
| HDW-04 | BESSEY CM34DR C-clamp, 2 pk | 1 | [B0CBZ9J74Y](https://www.amazon.com/dp/B0CBZ9J74Y) | $19.06 (2) | Amazon / Amazon.com | 8:39 PM | - | **OK-THU** |  |
| HDW-07 | ABS project box 200x120x75 | 1 | [B06XSQZ5M6](https://www.amazon.com/dp/B06XSQZ5M6) | $9.99 (1) | Amazon / Aquat Supply | 9:19 PM | - | **OK-THU** |  |
| ELE-02 | OVONIC Mate1 2S LiPo charger | 1 | [B0G6CV6BNR](https://www.amazon.com/dp/B0G6CV6BNR) | $50.99 (1) | Amazon / Ovonic Online | 9:34 PM | - | **OK-THU** |  |
| ELE-03 | Zeee LiPo safe bag | 1 | [B07KZQZBN2](https://www.amazon.com/dp/B07KZQZBN2) | $13.49 (1) | Amazon / ZEEE POWER | 11:39 PM | - | **OK-THU** |  |
| ELE-04 | LiPo cell checker | 1 | [B013U1CP08](https://www.amazon.com/dp/B013U1CP08) | $5.99 (1) | Amazon / yueton | 11:39 PM | - | **OK-THU** |  |
| ELE-05 | Sabrent 4-port powered hub | 1 | [B00TPMEOYM](https://www.amazon.com/dp/B00TPMEOYM) | $19.99 (1) | Amazon / Store4PC | 11:39 PM | - | **OK-THU** |  |
| ELE-07 | USB-A to micro-USB cable 2 pk | 1 | [B0719H12WD](https://www.amazon.com/dp/B0719H12WD) | $7.25 (2) | Amazon / Amazon.com | 11:39 PM | - | **OK-THU** |  |
| ELE-08 | Load cell 1 kg + HX711, 2 sets | 1 | [B09K7G51KJ](https://www.amazon.com/dp/B09K7G51KJ) | $9.99 (2) | Amazon / SazkJere | 11:39 PM | - | **OK-THU** |  |
| ELE-12 | 20 AWG JR ext 120 cm, 5 pk | 1 | [B0CXR2YBS4](https://www.amazon.com/dp/B0CXR2YBS4) | $24.49 (5) | Amazon / Chellys | 11:39 PM | - | **OK-THU** |  |
| ELE-13 | 20 AWG JR ext 30 cm, 5 pk | 1 | [B0CXQ8RZH8](https://www.amazon.com/dp/B0CXQ8RZH8) | $14.49 (5) | Amazon / Chellys | 11:39 PM | - | **OK-THU** |  |
| ELE-14 | 16 AWG silicone wire red+black | 1 | [B0D93K21TN](https://www.amazon.com/dp/B0D93K21TN) | $7.99 (10+10 ft) | Amazon / Deegoo-FPV | 11:39 PM | - | **OK-THU** |  |
| ELE-15 | 20 AWG silicone wire red+black | 1 | [B01AAX64EC](https://www.amazon.com/dp/B01AAX64EC) | $8.48 (10+10 ft) | Amazon / BNTECHGO-US | 11:39 PM | - | **OK-THU** |  |
| ELE-16 | 22 AWG hook-up wire 6 col | 1 | [B089CQHRDT](https://www.amazon.com/dp/B089CQHRDT) | $12.79 (6) | Amazon / Fermerry | 11:39 PM | - | **OK-THU** |  |
| ELE-17 | WAGO 221 12-pc kit (3x 221-415) | 1 | [B0CJ5QF4Z2](https://www.amazon.com/dp/B0CJ5QF4Z2) | $12.45 (12) | Amazon / Peppy Products | 11:39 PM | - | **OK-THU** | Need 4x 221-415: buy the 4th LOCAL. Genuine 25 pk B0107SYYGU now SATURDAY. |
| ELE-18 | Inline ATO fuse holder 4 pk | 1 | [B0F6NPV287](https://www.amazon.com/dp/B0F6NPV287) | $7.99 (4) | Amazon / Anyongora | 11:39 PM | - | **OK-THU** |  |
| ELE-19/42 | ATO fuse 3 A, 20 | 1 | [B0DHS1GTC7](https://www.amazon.com/dp/B0DHS1GTC7) | $3.99 (20) | Amazon / GOMEDI | 11:39 PM | - | **OK-THU** |  |
| ELE-21 | ATO fuse 10 A, 25 | 1 | [B0DSCGW488](https://www.amazon.com/dp/B0DSCGW488) | $4.99 (25) | Amazon / GOODSEN | 11:39 PM | - | **OK-THU** |  |
| ELE-22 | XT60 lead with fuse holder, 2 | 1 | [B0BZ7Y1DQY](https://www.amazon.com/dp/B0BZ7Y1DQY) | $12.99 (2) | Amazon / Sundry Goods | 11:39 PM | - | **OK-THU** |  |
| ELE-24 | HiLetgo 5 V relay H/L, 2 | 1 | [B00LW15A4W](https://www.amazon.com/dp/B00LW15A4W) | $7.39 (2) | Amazon / HiLetgo | 11:39 PM | - | **OK-THU** |  |
| ELE-25 | Metal film resistor kit | 1 | [B0CDWVLTM1](https://www.amazon.com/dp/B0CDWVLTM1) | $8.99 (kit) | Amazon / ALLECIN | 11:39 PM | - | **OK-THU** |  |
| ELE-26 | HiLetgo INA226, 2 | 1 | [B0CDWXB8PG](https://www.amazon.com/dp/B0CDWXB8PG) | $10.99 (2) | Amazon / HiLetgo | 11:39 PM | - | **OK-THU** |  |
| ELE-27 | 2512 2 W R010 shunt, 50 | 1 | [B0FVM8PRL5](https://www.amazon.com/dp/B0FVM8PRL5) | $5.99 (50) | Amazon / Qianhai Store | - | 11:59 PM | **OK-FRI** | Fri only, 15 left. Fallback: INA226 onboard R100 shunt. |
| ELE-28 | Rubycon 2200 uF 16 V | 1 | [B0FVGBGMW2](https://www.amazon.com/dp/B0FVGBGMW2) | $6.99 (1) | Amazon / eeeee_shop | 9:34 PM | - | **OK-THU** |  |
| ELE-29/30 | FlashHobby M45CHW servo (order qty 3) | 3 | [B09VBFZ9KW](https://www.amazon.com/dp/B09VBFZ9KW) | $44.99 ea (1) | Amazon / UAV-parts | 11:39 PM | - | **OK-THU** | Only 17 left. |
| ELE-31 | Treedix 25T Al horn, 10 | 1 | [B0875ZS9KF](https://www.amazon.com/dp/B0875ZS9KF) | $8.99 (10) | Amazon / Treedix | 11:39 PM | - | **OK-THU** | Only 11 left. |
| ELE-32 | 470 uF 16 V electrolytic | 1 | [B0CMQCQMH5](https://www.amazon.com/dp/B0CMQCQMH5) | $5.99 (pk) | Amazon / ALLECIN | 9:19 PM | - | **OK-THU** | Low-ESR B0D78PQ4C1 is Fri only. |
| ELE-33 | Ceramic cap kit (100 nF) | 1 | [B0C1V8Q93P](https://www.amazon.com/dp/B0C1V8Q93P) | $9.99 (kit) | Amazon / ALLECIN | 7:39 PM | - | **OK-THU** | EARLIEST cutoff. |
| ELE-34 | A3144 Hall sensor, 20 | 1 | [B0CZ6QXMZ2](https://www.amazon.com/dp/B0CZ6QXMZ2) | $6.99 (20) | Amazon / ALLECIN | 11:39 PM | - | **OK-THU** |  |
| ELE-35 | N52 6x2 magnets, 50 | 1 | [B0H55FXL9W](https://www.amazon.com/dp/B0H55FXL9W) | $9.99 (50) | Amazon / Rhinocats | 11:39 PM | - | **OK-THU** |  |
| ELE-38 | Switched power strip | 1 | [B0GF26Y1TF](https://www.amazon.com/dp/B0GF26Y1TF) | $19.99 (1) | Amazon / Chiefway | 11:54 PM | - | **OK-THU** |  |
| ELE-39 | 4-core shielded cable 22 AWG 25 ft (conditional) | 1 | [B0D9JY3MC4](https://www.amazon.com/dp/B0D9JY3MC4) | $16.99 (25 ft) | Amazon / PENGYULAI | 11:54 PM | - | **OK-THU** |  |
| CON-01 | 3M 4950 VHB 1 in x 5 yd | 1 | [B007Y7GIKI](https://www.amazon.com/dp/B007Y7GIKI) | $22.29 (1) | Amazon / Prime Distribution USA | 11:39 PM | - | **OK-THU** |  |
| CON-02 | Cork 3 mm, 8 pk | 1 | [B0CKL6KLQS](https://www.amazon.com/dp/B0CKL6KLQS) | $16.99 (8) | Amazon / BENECREAT | 11:39 PM | - | **OK-THU** |  |
| CON-03 | 1 mm adhesive silicone sheet | 1 | [B0CZNYD9PP](https://www.amazon.com/dp/B0CZNYD9PP) | $8.99 (1) | Amazon / SJZSLM-US | 11:39 PM | - | **OK-THU** |  |
| CON-05 | Trimaco drop cloth 9x12 | 1 | [B00004YOTS](https://www.amazon.com/dp/B00004YOTS) | $11.69 (1) | Amazon / Amazon.com | 11:54 PM | - | **OK-THU** |  |
| CON-06 | Absorbent spill pads | 1 | [B09X24M4B8](https://www.amazon.com/dp/B09X24M4B8) | $8.40 (pk) | Amazon / Amazon.com | 11:39 PM | - | **OK-THU** |  |
| CON-07 | ELEGOO Kapton tape 4 pk | 1 | [B072Z92QZ2](https://www.amazon.com/dp/B072Z92QZ2) | $9.99 (4) | Amazon / ELEGOO | 11:39 PM | - | **OK-THU** |  |
| CON-08 | ASI 388 silicone 2.8 oz | 1 | [B0063U2RT8](https://www.amazon.com/dp/B0063U2RT8) | $9.95 (1) | Amazon / SDR Supply | 10:59 PM | 11:59 PM | **OK-FRI** | Buy-box offer is Fri; a second offer on the page shows Thu (cutoff 10:59 PM). Or Home Depot/Ace. |
| CON-09 | Loctite 242 | 1 | [B000I1RSNS](https://www.amazon.com/dp/B000I1RSNS) | $7.02 (1) | Amazon / Amazon.com | 11:39 PM | - | **OK-THU** |  |
| CON-10 | Heat-shrink kit | 1 | [B01MFA3OFA](https://www.amazon.com/dp/B01MFA3OFA) | $7.99 (580) | Amazon / GinscoDirect | 11:39 PM | - | **OK-THU** |  |
| CON-11 | Zip ties 200 | 1 | [B0BC1VH4XB](https://www.amazon.com/dp/B0BC1VH4XB) | $3.99 (200) | Amazon / TANTTI-US | 11:39 PM | - | **OK-THU** |  |
| CON-12 | Adhesive tie mounts 100 | 1 | [B07M69LK65](https://www.amazon.com/dp/B07M69LK65) | $6.99 (100) | Amazon / XHF2018 | 11:54 PM | - | **OK-THU** |  |
| CON-14 | PTFE glides 20 | 1 | [B08HWC3CSP](https://www.amazon.com/dp/B08HWC3CSP) | $8.99 (20) | Amazon / ALIMITOPIA | 9:19 PM | - | **OK-THU** |  |
| CON-15 | Lazy Susan bearing 8 pk | 1 | [B08CY2P8KZ](https://www.amazon.com/dp/B08CY2P8KZ) | $15.99 (8) | Amazon / Evadow | 9:19 PM | - | **OK-THU** |  |
| CON-17 | SUNLU TPU 95A 1 kg (if needed) | 1 | [B0BXNWK6NS](https://www.amazon.com/dp/B0BXNWK6NS) | $21.99 (1 kg) | Amazon / SUNLU | 11:39 PM | - | **OK-THU** |  |
| CON-19 | VELCRO strips | 1 | [B09BNPX3XJ](https://www.amazon.com/dp/B09BNPX3XJ) | $8.65 (8) | Amazon / Amazon.com | 11:39 PM | - | **OK-THU** |  |
| CON-20 | 2020 slot cover 6 m | 1 | [B09KPZBTB9](https://www.amazon.com/dp/B09KPZBTB9) | $11.98 (6 m) | Amazon / BLCCLOY | 11:39 PM | - | **OK-THU** |  |
| CON-21 | Electrical tape 4 col | 1 | [B0C62DM4H8](https://www.amazon.com/dp/B0C62DM4H8) | $7.89 (4) | Amazon / xinhanhuachen | 11:39 PM | - | **OK-THU** |  |
| CON-22 | 63/37 solder 0.8 mm | 1 | [B075WB98FJ](https://www.amazon.com/dp/B075WB98FJ) | $8.99 (50 g) | Amazon / MAIYUM | 11:39 PM | - | **OK-THU** |  |
| CON-23 | 120-grit sandpaper 12 | 1 | [B0BWN8J1FZ](https://www.amazon.com/dp/B0BWN8J1FZ) | $8.99 (12) | Amazon / BOSHCRAFT | 9:49 PM | - | **OK-THU** |  |
| TOO-01 | Pinecil | 1 | [B096X6SG13](https://www.amazon.com/dp/B096X6SG13) | $39.99 (1) | Amazon / Pine64 | 11:39 PM | - | **OK-THU** |  |
| TOO-02 | AMTOVL long hex keys | 1 | [B0CJBRYQF3](https://www.amazon.com/dp/B0CJBRYQF3) | $9.99 (9) | Amazon / AMTOVL-USA | 11:39 PM | - | **OK-THU** |  |
| TOO-03 | HARFINGTON 14 mm HSS drill, 10 mm shank, 158 mm OAL | 1 | [B0F679NDD6](https://www.amazon.com/dp/B0F679NDD6) | $8.99 (1) | Amazon / HARFINGTON | 11:39 PM | - | **OK-THU** | SUBSTITUTE: BOM listing B07S2DCVR2 slipped to FRI. 158 mm < 7 in (TSA OK). |
| TOO-04 | GMTOOLS countersink set | 1 | [B0CWLCZ51W](https://www.amazon.com/dp/B0CWLCZ51W) | $13.99 (5) | Amazon / GMTOOLS | 10:59 PM | - | **OK-THU** |  |
| TOO-05 | AstroAI multimeter | 1 | [B08DHHJPS1](https://www.amazon.com/dp/B08DHHJPS1) | $18.99 (1) | Amazon / AstroAI | 11:39 PM | - | **OK-THU** |  |
| TOO-06 | Luggage scale | 1 | [B07QFTGGYF](https://www.amazon.com/dp/B07QFTGGYF) | $9.99 (1) | Amazon / Travel Inspira | 10:59 PM | - | **OK-THU** |  |
| SAF-01 | Quest safety glasses 2 pk | 1 | [B0CZ7K4Q9S](https://www.amazon.com/dp/B0CZ7K4Q9S) | $7.99 (2) | Amazon / Quest Safety | 7:39 PM | - | **OK-THU** | EARLIEST cutoff. |
| SAF-02 | Indirect-vent goggles | 2 | [B0CJVDBZW3](https://www.amazon.com/dp/B0CJVDBZW3) | $7.99 ea (1?) | Amazon / LECHENG LTD | 9:34 PM | - | **OK-THU** |  |
| SAF-03 | Nitrile gloves 100 | 1 | [B0C9S5PMSD](https://www.amazon.com/dp/B0C9S5PMSD) | $8.97 (100) | Amazon / Supmedic | 11:39 PM | - | **OK-THU** |  |
| CLB-01 | MAGIKON 100 g M2 weight | 1 | [B078N1TRDC](https://www.amazon.com/dp/B078N1TRDC) | $4.99 (1) | Amazon / LittleTiger | 11:39 PM | - | **OK-THU** |  |

Covered by other rows, no separate purchase: FAS-01/05/07/17/19/20 (NEW-b1 kit), FAS-06 (servo screws), FAS-10/12 (FAS-13), FAS-14 (FAS-03), ELE-41 (ELE-31), ELE-42 (ELE-19). Skipped: LAB-05 (optional, qty 0), ELE-37 (voltage unconfirmed).

## AT RISK

- **LAB-01 EISCO 50 mL PP beaker (B00BHLE5AW):** now Sat Oct 17, only 11 left. No 43 OD x 61 H EISCO listing arrives Thursday or Friday. Stopgap: DAJAVE 50 mL cups, 100-pk, [B09Y2TXFDT](https://www.amazon.com/dp/B09Y2TXFDT), $14.99, Thursday, cutoff 9:19 PM. Their dimensions are **not verified** against the carousel pockets. Or ask the BU chemistry stockroom.
- **ELE-23 e-stop:** the exact boxed 2NC part is Friday-only. Order it and also the bare Thursday TWTADE 2NC (NEW-e2). If the box is late, mount the TWTADE in a 22 mm hole in HDW-07.

## ORDER NOW (earliest cutoff first)

1. **7:39 PM** (Thu) | FAS-08 | [B0FJ8QP76C](https://www.amazon.com/dp/B0FJ8QP76C) | DIN 985 M3 nylon locknut, 120 (optional) | qty 0-1
2. **7:39 PM** (Thu) | ELE-33 | [B0C1V8Q93P](https://www.amazon.com/dp/B0C1V8Q93P) | Ceramic cap kit (100 nF) | qty 1
3. **7:39 PM** (Thu) | SAF-01 | [B0CZ7K4Q9S](https://www.amazon.com/dp/B0CZ7K4Q9S) | Quest safety glasses 2 pk | qty 1
4. **8:39 PM** (Thu) | HDW-04 | [B0CBZ9J74Y](https://www.amazon.com/dp/B0CBZ9J74Y) | BESSEY CM34DR C-clamp, 2 pk | qty 1
5. **8:44 PM** (Thu) | FAS-09 | [B0DDHL6P99](https://www.amazon.com/dp/B0DDHL6P99) | M3x12 set screw | qty 1
6. **9:19 PM** (Thu) | HDW-07 | [B06XSQZ5M6](https://www.amazon.com/dp/B06XSQZ5M6) | ABS project box 200x120x75 | qty 1
7. **9:19 PM** (Thu) | ELE-32 | [B0CMQCQMH5](https://www.amazon.com/dp/B0CMQCQMH5) | 470 uF 16 V electrolytic | qty 1
8. **9:19 PM** (Thu) | CON-14 | [B08HWC3CSP](https://www.amazon.com/dp/B08HWC3CSP) | PTFE glides 20 | qty 1
9. **9:19 PM** (Thu) | CON-15 | [B08CY2P8KZ](https://www.amazon.com/dp/B08CY2P8KZ) | Lazy Susan bearing 8 pk | qty 1
10. **9:34 PM** (Thu) | GLS-02 | [B0D1NCM4R4](https://www.amazon.com/dp/B0D1NCM4R4) | Glass stir rods 6 mm x 6 in, 15 pk (Gardena) | qty 1
11. **9:34 PM** (Thu) | FAS-03/14 | [B0CHJDMJ3H](https://www.amazon.com/dp/B0CHJDMJ3H) | mxuteuk M4 12.9 SHCS kit | qty 1
12. **9:34 PM** (Thu) | FAS-16 | [B07YSVXWS8](https://www.amazon.com/dp/B07YSVXWS8) | ruthex M5 heat-set inserts, 50 | qty 1
13. **9:34 PM** (Thu) | FAS-18 | [B06XQ33Y9X](https://www.amazon.com/dp/B06XQ33Y9X) | M3 brass standoff kit | qty 1
14. **9:34 PM** (Thu) | ELE-02 | [B0G6CV6BNR](https://www.amazon.com/dp/B0G6CV6BNR) | OVONIC Mate1 2S LiPo charger | qty 1
15. **9:34 PM** (Thu) | ELE-28 | [B0FVGBGMW2](https://www.amazon.com/dp/B0FVGBGMW2) | Rubycon 2200 uF 16 V | qty 1
16. **9:34 PM** (Thu) | SAF-02 | [B0CJVDBZW3](https://www.amazon.com/dp/B0CJVDBZW3) | Indirect-vent goggles | qty 2
17. **9:49 PM** (Thu) | CON-23 | [B0BWN8J1FZ](https://www.amazon.com/dp/B0BWN8J1FZ) | 120-grit sandpaper 12 | qty 1
18. **10:59 PM** (Thu) | CON-08 | [B0063U2RT8](https://www.amazon.com/dp/B0063U2RT8) | ASI 388 silicone 2.8 oz | qty 1
19. **10:59 PM** (Thu) | TOO-04 | [B0CWLCZ51W](https://www.amazon.com/dp/B0CWLCZ51W) | GMTOOLS countersink set | qty 1
20. **10:59 PM** (Thu) | TOO-06 | [B07QFTGGYF](https://www.amazon.com/dp/B07QFTGGYF) | Luggage scale | qty 1
21. **11:39 PM** (Thu) | NEW-a | [B0F1B85397](https://www.amazon.com/dp/B0F1B85397) | 2020 inside corner bracket, black aluminium, 20 sets incl. 40 M5 T-nuts + 40 M5 SHCS (need 12) | qty 1
22. **11:39 PM** (Thu) | NEW-b1 | [B0FGV5FCBN](https://www.amazon.com/dp/B0FGV5FCBN) | M3 SHCS kit 1120 pc M3x6/8/10/12/16/20/25/30 + nuts + washers (Fasteners Pro) | qty 1
23. **11:39 PM** (Thu) | NEW-b2/c2 | [B0F62DG4DV](https://www.amazon.com/dp/B0F62DG4DV) | Metric nylon-insert lock nut (DIN 985) + hex nut kit 206 pc: M3 lock x30, M5 lock x20, M3/M5 hex | qty 1
24. **11:39 PM** (Thu) | NEW-c1 | [B0GHNNR8YZ](https://www.amazon.com/dp/B0GHNNR8YZ) | M5x25 SHCS 12.9, 60 pc | qty 1
25. **11:39 PM** (Thu) | NEW-d | [B0GHNN6HQ4](https://www.amazon.com/dp/B0GHNN6HQ4) | M5x10 SHCS 12.9, 100 pc | qty 1
26. **11:39 PM** (Thu) | NEW-e2 | [B07NP44T74](https://www.amazon.com/dp/B07NP44T74) | TWTADE 22 mm 2NC red latching mushroom e-stop (bare, no box), YW1B-V4E02R | qty 1
27. **11:39 PM** (Thu) | NEW-f / HDW-01 | [B0G1B256ZS](https://www.amazon.com/dp/B0G1B256ZS) | uxcell F625ZZ flanged bearing 5x16x5, 10 pc | qty 1
28. **11:39 PM** (Thu) | GLS-01 | [B006VYY10Y](https://www.amazon.com/dp/B006VYY10Y) | Karter 250 mL Erlenmeyer | qty 2
29. **11:39 PM** (Thu) | GLS-03 | [B006UKIASI](https://www.amazon.com/dp/B006UKIASI) | Karter 100 mL glass graduated cylinder | qty 1
30. **11:39 PM** (Thu) | LAB-03 | [B017UYYKSQ](https://www.amazon.com/dp/B017UYYKSQ) | EISCO 4 in PP funnel | qty 1
31. **11:39 PM** (Thu) | FAS-02 | [B07H17FG9R](https://www.amazon.com/dp/B07H17FG9R) | ISO 7380 M4x20 button head, 50 pc | qty 1
32. **11:39 PM** (Thu) | FAS-04 | [B0B1LTL6M5](https://www.amazon.com/dp/B0B1LTL6M5) | 2020 M4 drop-in T-nut, 100 | qty 1
33. **11:39 PM** (Thu) | FAS-11 | [B0FGV561HZ](https://www.amazon.com/dp/B0FGV561HZ) | M5 SHCS kit 272 pc M5x8-35 + nuts | qty 1
34. **11:39 PM** (Thu) | FAS-13 | [B0DMCS8KW4](https://www.amazon.com/dp/B0DMCS8KW4) | 2020 M5 T-nut + M5 screw kit 240 pc | qty 1
35. **11:39 PM** (Thu) | ELE-03 | [B07KZQZBN2](https://www.amazon.com/dp/B07KZQZBN2) | Zeee LiPo safe bag | qty 1
36. **11:39 PM** (Thu) | ELE-04 | [B013U1CP08](https://www.amazon.com/dp/B013U1CP08) | LiPo cell checker | qty 1
37. **11:39 PM** (Thu) | ELE-05 | [B00TPMEOYM](https://www.amazon.com/dp/B00TPMEOYM) | Sabrent 4-port powered hub | qty 1
38. **11:39 PM** (Thu) | ELE-07 | [B0719H12WD](https://www.amazon.com/dp/B0719H12WD) | USB-A to micro-USB cable 2 pk | qty 1
39. **11:39 PM** (Thu) | ELE-08 | [B09K7G51KJ](https://www.amazon.com/dp/B09K7G51KJ) | Load cell 1 kg + HX711, 2 sets | qty 1
40. **11:39 PM** (Thu) | ELE-12 | [B0CXR2YBS4](https://www.amazon.com/dp/B0CXR2YBS4) | 20 AWG JR ext 120 cm, 5 pk | qty 1
41. **11:39 PM** (Thu) | ELE-13 | [B0CXQ8RZH8](https://www.amazon.com/dp/B0CXQ8RZH8) | 20 AWG JR ext 30 cm, 5 pk | qty 1
42. **11:39 PM** (Thu) | ELE-14 | [B0D93K21TN](https://www.amazon.com/dp/B0D93K21TN) | 16 AWG silicone wire red+black | qty 1
43. **11:39 PM** (Thu) | ELE-15 | [B01AAX64EC](https://www.amazon.com/dp/B01AAX64EC) | 20 AWG silicone wire red+black | qty 1
44. **11:39 PM** (Thu) | ELE-16 | [B089CQHRDT](https://www.amazon.com/dp/B089CQHRDT) | 22 AWG hook-up wire 6 col | qty 1
45. **11:39 PM** (Thu) | ELE-17 | [B0CJ5QF4Z2](https://www.amazon.com/dp/B0CJ5QF4Z2) | WAGO 221 12-pc kit (3x 221-415) | qty 1
46. **11:39 PM** (Thu) | ELE-18 | [B0F6NPV287](https://www.amazon.com/dp/B0F6NPV287) | Inline ATO fuse holder 4 pk | qty 1
47. **11:39 PM** (Thu) | ELE-19/42 | [B0DHS1GTC7](https://www.amazon.com/dp/B0DHS1GTC7) | ATO fuse 3 A, 20 | qty 1
48. **11:39 PM** (Thu) | ELE-21 | [B0DSCGW488](https://www.amazon.com/dp/B0DSCGW488) | ATO fuse 10 A, 25 | qty 1
49. **11:39 PM** (Thu) | ELE-22 | [B0BZ7Y1DQY](https://www.amazon.com/dp/B0BZ7Y1DQY) | XT60 lead with fuse holder, 2 | qty 1
50. **11:39 PM** (Thu) | ELE-24 | [B00LW15A4W](https://www.amazon.com/dp/B00LW15A4W) | HiLetgo 5 V relay H/L, 2 | qty 1
51. **11:39 PM** (Thu) | ELE-25 | [B0CDWVLTM1](https://www.amazon.com/dp/B0CDWVLTM1) | Metal film resistor kit | qty 1
52. **11:39 PM** (Thu) | ELE-26 | [B0CDWXB8PG](https://www.amazon.com/dp/B0CDWXB8PG) | HiLetgo INA226, 2 | qty 1
53. **11:39 PM** (Thu) | ELE-29/30 | [B09VBFZ9KW](https://www.amazon.com/dp/B09VBFZ9KW) | FlashHobby M45CHW servo (order qty 3) | qty 3
54. **11:39 PM** (Thu) | ELE-31 | [B0875ZS9KF](https://www.amazon.com/dp/B0875ZS9KF) | Treedix 25T Al horn, 10 | qty 1
55. **11:39 PM** (Thu) | ELE-34 | [B0CZ6QXMZ2](https://www.amazon.com/dp/B0CZ6QXMZ2) | A3144 Hall sensor, 20 | qty 1
56. **11:39 PM** (Thu) | ELE-35 | [B0H55FXL9W](https://www.amazon.com/dp/B0H55FXL9W) | N52 6x2 magnets, 50 | qty 1
57. **11:39 PM** (Thu) | CON-01 | [B007Y7GIKI](https://www.amazon.com/dp/B007Y7GIKI) | 3M 4950 VHB 1 in x 5 yd | qty 1
58. **11:39 PM** (Thu) | CON-02 | [B0CKL6KLQS](https://www.amazon.com/dp/B0CKL6KLQS) | Cork 3 mm, 8 pk | qty 1
59. **11:39 PM** (Thu) | CON-03 | [B0CZNYD9PP](https://www.amazon.com/dp/B0CZNYD9PP) | 1 mm adhesive silicone sheet | qty 1
60. **11:39 PM** (Thu) | CON-06 | [B09X24M4B8](https://www.amazon.com/dp/B09X24M4B8) | Absorbent spill pads | qty 1
61. **11:39 PM** (Thu) | CON-07 | [B072Z92QZ2](https://www.amazon.com/dp/B072Z92QZ2) | ELEGOO Kapton tape 4 pk | qty 1
62. **11:39 PM** (Thu) | CON-09 | [B000I1RSNS](https://www.amazon.com/dp/B000I1RSNS) | Loctite 242 | qty 1
63. **11:39 PM** (Thu) | CON-10 | [B01MFA3OFA](https://www.amazon.com/dp/B01MFA3OFA) | Heat-shrink kit | qty 1
64. **11:39 PM** (Thu) | CON-11 | [B0BC1VH4XB](https://www.amazon.com/dp/B0BC1VH4XB) | Zip ties 200 | qty 1
65. **11:39 PM** (Thu) | CON-17 | [B0BXNWK6NS](https://www.amazon.com/dp/B0BXNWK6NS) | SUNLU TPU 95A 1 kg (if needed) | qty 1
66. **11:39 PM** (Thu) | CON-19 | [B09BNPX3XJ](https://www.amazon.com/dp/B09BNPX3XJ) | VELCRO strips | qty 1
67. **11:39 PM** (Thu) | CON-20 | [B09KPZBTB9](https://www.amazon.com/dp/B09KPZBTB9) | 2020 slot cover 6 m | qty 1
68. **11:39 PM** (Thu) | CON-21 | [B0C62DM4H8](https://www.amazon.com/dp/B0C62DM4H8) | Electrical tape 4 col | qty 1
69. **11:39 PM** (Thu) | CON-22 | [B075WB98FJ](https://www.amazon.com/dp/B075WB98FJ) | 63/37 solder 0.8 mm | qty 1
70. **11:39 PM** (Thu) | TOO-01 | [B096X6SG13](https://www.amazon.com/dp/B096X6SG13) | Pinecil | qty 1
71. **11:39 PM** (Thu) | TOO-02 | [B0CJBRYQF3](https://www.amazon.com/dp/B0CJBRYQF3) | AMTOVL long hex keys | qty 1
72. **11:39 PM** (Thu) | TOO-03 | [B0F679NDD6](https://www.amazon.com/dp/B0F679NDD6) | HARFINGTON 14 mm HSS drill, 10 mm shank, 158 mm OAL | qty 1
73. **11:39 PM** (Thu) | TOO-05 | [B08DHHJPS1](https://www.amazon.com/dp/B08DHHJPS1) | AstroAI multimeter | qty 1
74. **11:39 PM** (Thu) | SAF-03 | [B0C9S5PMSD](https://www.amazon.com/dp/B0C9S5PMSD) | Nitrile gloves 100 | qty 1
75. **11:39 PM** (Thu) | CLB-01 | [B078N1TRDC](https://www.amazon.com/dp/B078N1TRDC) | MAGIKON 100 g M2 weight | qty 1
76. **11:54 PM** (Thu) | ELE-38 | [B0GF26Y1TF](https://www.amazon.com/dp/B0GF26Y1TF) | Switched power strip | qty 1
77. **11:54 PM** (Thu) | ELE-39 | [B0D9JY3MC4](https://www.amazon.com/dp/B0D9JY3MC4) | 4-core shielded cable 22 AWG 25 ft (conditional) | qty 1
78. **11:54 PM** (Thu) | CON-05 | [B00004YOTS](https://www.amazon.com/dp/B00004YOTS) | Trimaco drop cloth 9x12 | qty 1
79. **11:54 PM** (Thu) | CON-12 | [B07M69LK65](https://www.amazon.com/dp/B07M69LK65) | Adhesive tie mounts 100 | qty 1
80. **11:59 PM** (Fri) | NEW-e1 / ELE-23 | [B07GPF76R1](https://www.amazon.com/dp/B07GPF76R1) | Taiss 22 mm red latching mushroom e-stop, 2 NC, in station box | qty 1
81. **11:59 PM** (Fri) | LAB-02 | [B00BHLE5RU](https://www.amazon.com/dp/B00BHLE5RU) | EISCO 100 mL PP beaker, 12 pk | qty 1
82. **11:59 PM** (Fri) | ELE-27 | [B0FVM8PRL5](https://www.amazon.com/dp/B0FVM8PRL5) | 2512 2 W R010 shunt, 50 | qty 1

## BUY LOCAL

- **LAB-04** PP bin ~110x80x100 (confirm use): CVS / Target near Kenmore Sq (any small plastic tub)
- **ELE-36** Screw-terminal breakout for Mega 2560 PRO: Micro Center Cambridge, 730 Memorial Dr: perfboard + 3.5 mm screw terminals
- **ELE-17 (4th)** 1x extra WAGO 221-415: Home Depot or Micro Center Cambridge
- **ELE-23 backup** 22 mm 2NC e-stop: Micro Center Cambridge (if both Amazon e-stops slip)
- **NEW-a..d backup** M3/M5 SHCS, M3/M5 hex + nylon lock nuts: Tags Hardware Cambridge, Ace Hardware, Home Depot. 2020 brackets are unlikely at big-box stores; check Micro Center.
- **LAB-01 stopgap** 50 mL PP beakers: No known Boston retail stockist of EISCO 50 mL; ask the BU chemistry stockroom
- **ELE-37** Arm power adapters (voltage TBD): Micro Center Cambridge once SIGRobotics confirms

McMaster-Carr is not used (no same-week delivery to individuals).
