shaoming11/hh-winners/exports/print_at_BU/2_TT-04_carousel-ring_x1.stl

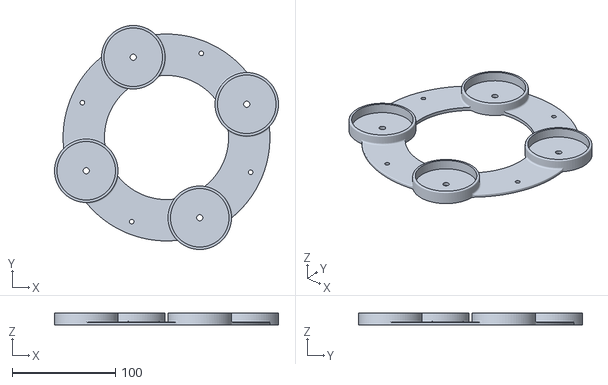
[picture p41: CAD file, 2026-10-17]
exports/print_at_BU/2_TT-04_carousel-ring_x1.stl
216.6 x 216.6 x 12.0
