shaoming11/hh-winners/exports/print_at_BU/7_jigs/JG-02R.stl

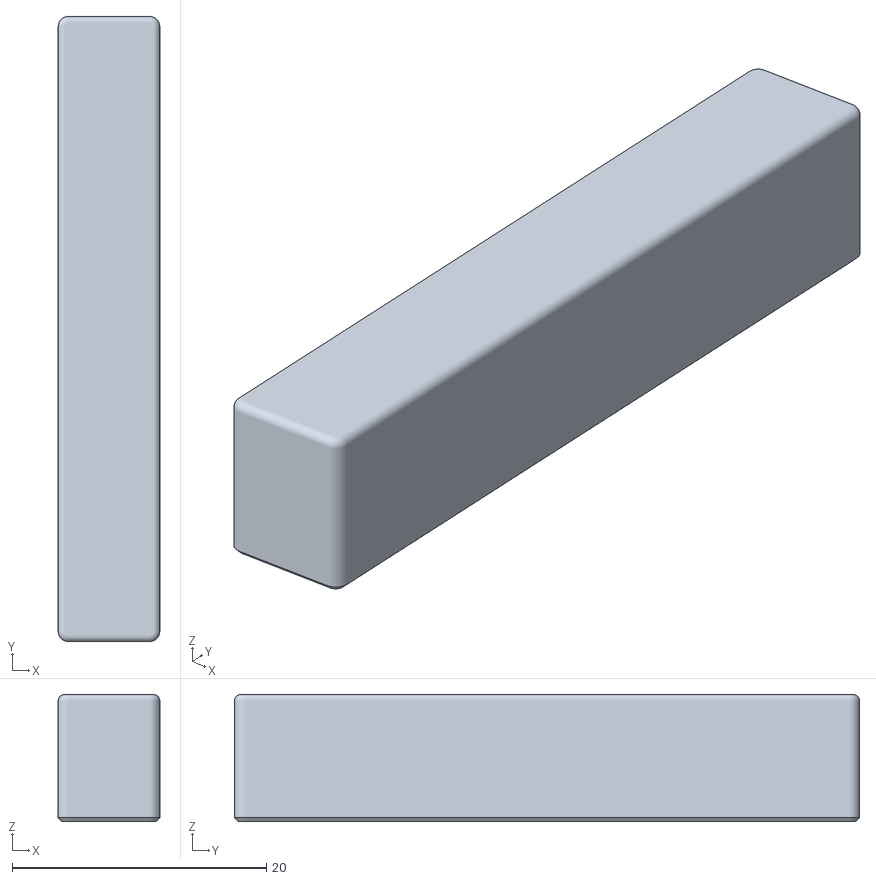
[picture p42: CAD file, 2026-10-17]
exports/print_at_BU/7_jigs/JG-02R.stl
8.00 x 49.2 x 10.0
