shaoming11/hh-winners/exports/print_final/A1/4_CAL-01x2_calibration-blocks_2h43_DROPPABLE.gcode.3mf

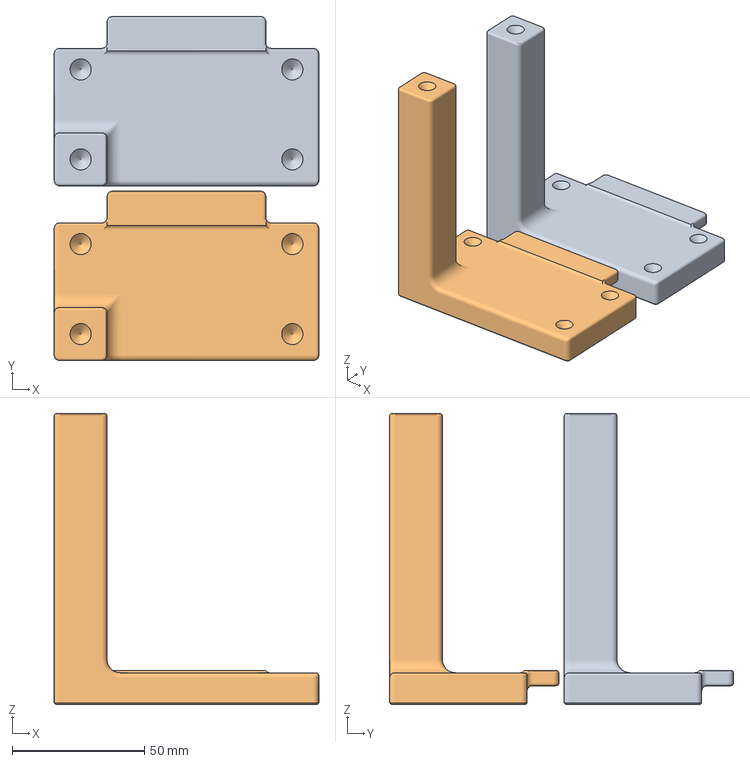
[picture p43: CAD file, 2026-10-17]
exports/print_final/A1/4_CAL-01x2_calibration-blocks_2h43_DROPPABLE.gcode.3mf
100.0 x 130.0 x 110.0 mm
CAL-01_arm-calibration-block_qty2.stl x 2
