shaoming11/hh-winners/exports/print_final/H2D/2_DH-01-v4_auger-head_2h37.gcode.3mf

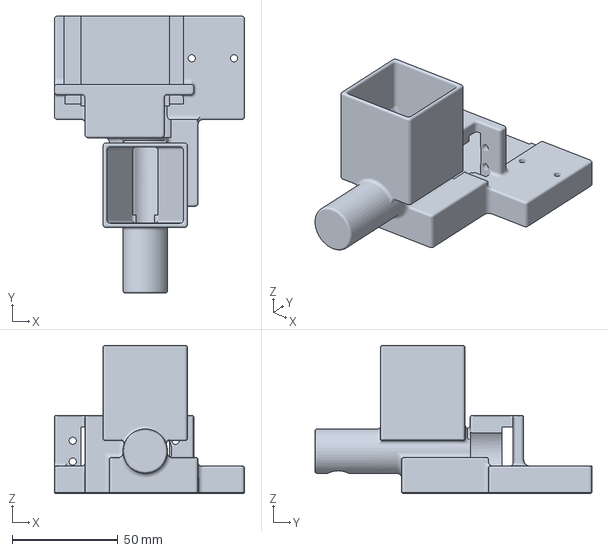
[picture p44: CAD file, 2026-10-17]
exports/print_final/H2D/2_DH-01-v4_auger-head_2h37.gcode.3mf
90.0 x 131.0 x 70.0 mm
