shaoming11/hh-winners/exports/print_final/X2/4_WS-02_scale-pan_+_ST-08-x6_0h44/WS-02_scale-pan-v2_qty1.stl

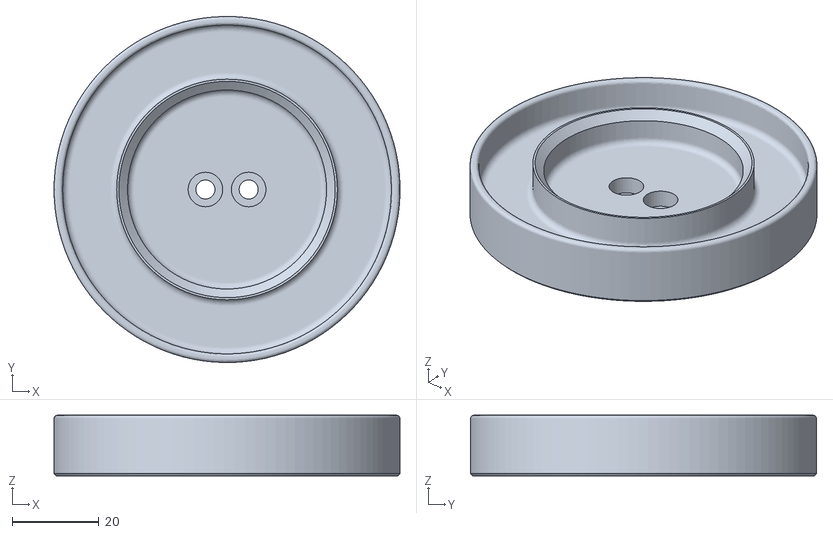
[picture p45: CAD file, 2026-10-17]
exports/print_final/X2/4_WS-02_scale-pan_+_ST-08-x6_0h44/WS-02_scale-pan-v2_qty1.stl
80.0 x 80.0 x 14.0
