shaoming11/hh-winners/exports/print_final/X2/5_CAL-02_probe_1h12_DROPPABLE/CAL-02_calibration-probe_qty1.stl

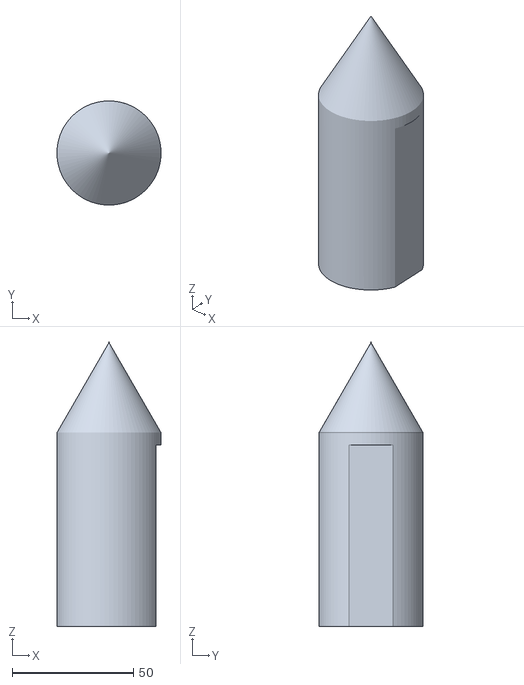
[picture p46: CAD file, 2026-10-17]
exports/print_final/X2/5_CAL-02_probe_1h12_DROPPABLE/CAL-02_calibration-probe_qty1.stl
43.0 x 43.0 x 117.2
