shaoming11/hh-winners/exports/print_final/X2/6_RK-02_reagent-rack_2h05_LAST_may-change/RK-02_reagent-rack-v2_qty1.stl

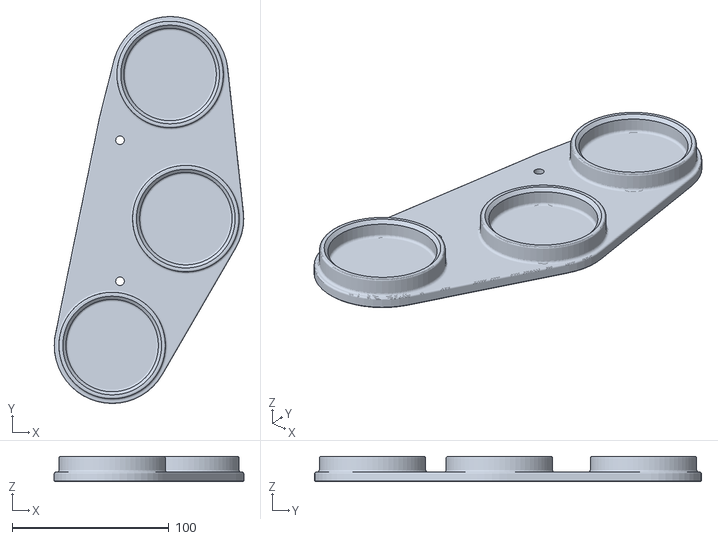
[picture p47: CAD file, 2026-10-17]
exports/print_final/X2/6_RK-02_reagent-rack_2h05_LAST_may-change/RK-02_reagent-rack-v2_qty1.stl
121.0 x 247.0 x 16.0
