shaoming11/hh-winners/exports/print_queue_2026-10-15/A1/2_ST-07_catch-well_VASE_0h54.gcode.3mf

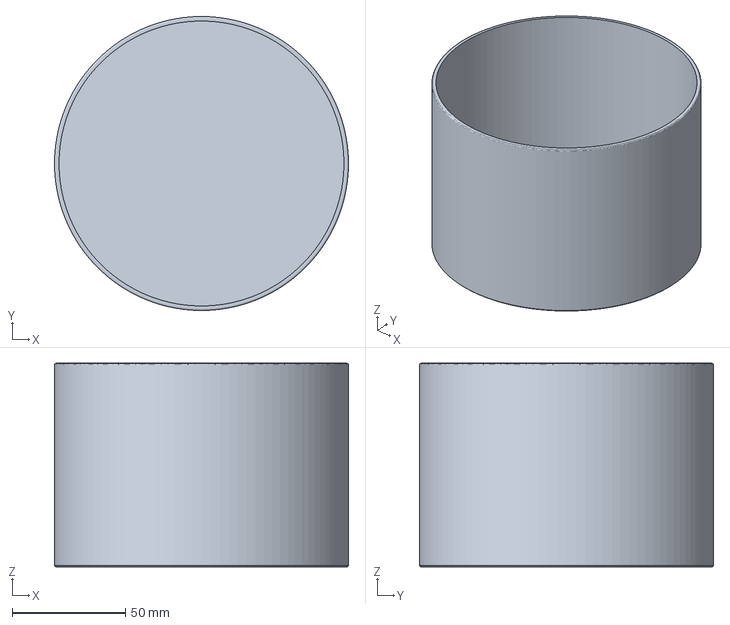
[picture p48: CAD file, 2026-10-17]
exports/print_queue_2026-10-15/A1/2_ST-07_catch-well_VASE_0h54.gcode.3mf
130.0 x 130.0 x 90.0 mm
