shaoming11/hh-winners/exports/print_queue_2026-10-15/H2D - when its current plate finishes/2_TT-02-deck_+_TT-03-spacer_FAST.gcode.3mf

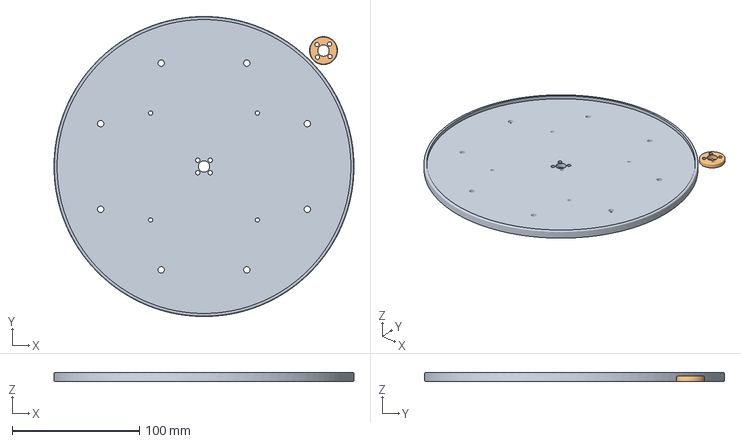
[picture p49: CAD file, 2026-10-17]
exports/print_queue_2026-10-15/H2D - when its current plate finishes/2_TT-02-deck_+_TT-03-spacer_FAST.gcode.3mf
236.0 x 236.0 x 7.00 mm
TT-02_carousel-deck_qty1.stl
TT-03_horn-spacer_qty1.stl
