shaoming11/hh-winners/exports/print_queue_2026-10-15/X2E/2_AFTER-GRIPPERS_RK-03v2_reagent-stands_x3_2h10.gcode.3mf

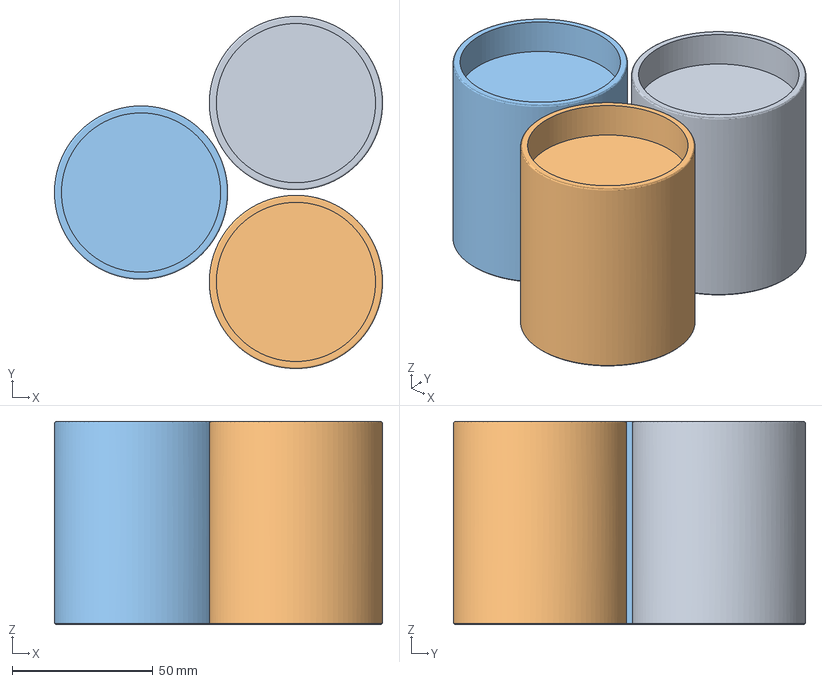
[picture p50: CAD file, 2026-10-17]
exports/print_queue_2026-10-15/X2E/2_AFTER-GRIPPERS_RK-03v2_reagent-stands_x3_2h10.gcode.3mf
116.7 x 125.2 x 72.2 mm
RK-03v2_reagent-stand_qty3.stl x 3
