shaoming11/hh-winners/exports/prints/TT-04_beaker-locator-ring-v2_qty1.step

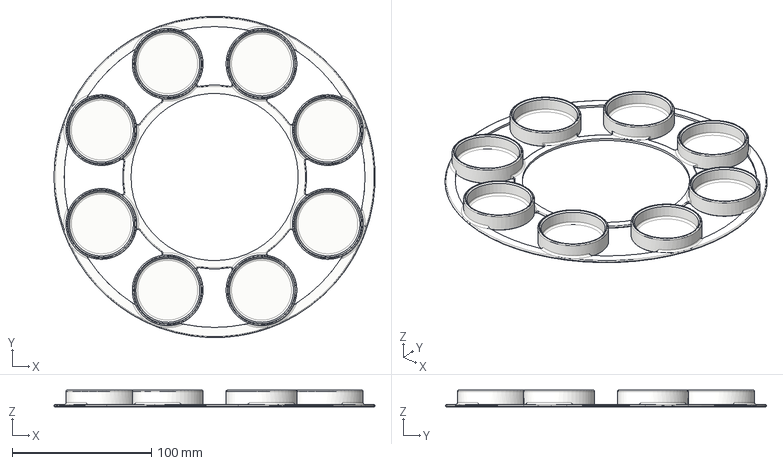
[picture p51: CAD file, 2026-10-17]
exports/prints/TT-04_beaker-locator-ring-v2_qty1.step
230.5 x 230.5 x 12.0 mm
