shaoming11/hh-winners/exports/prints_v2/WS-02_scale-pan-v3-100mL_qty1.stl

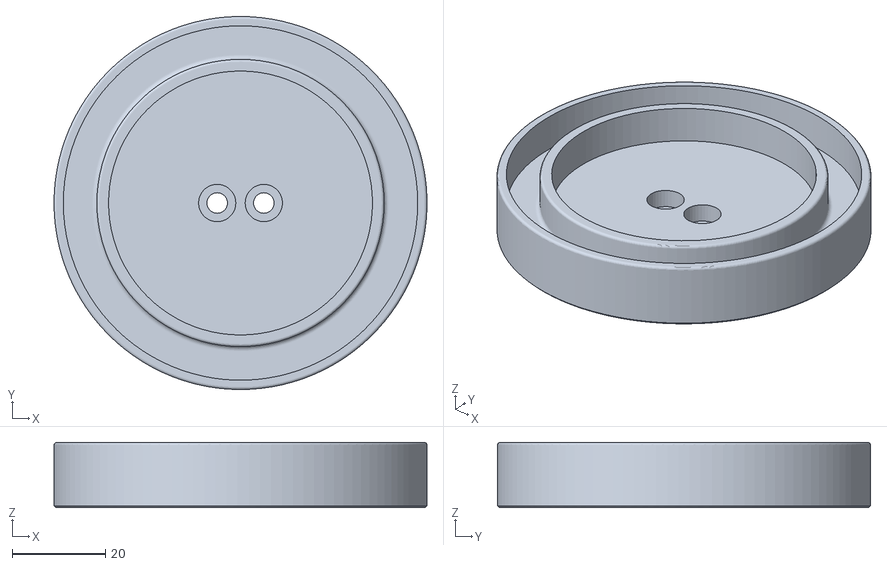
[picture p52: CAD file, 2026-10-17]
exports/prints_v2/WS-02_scale-pan-v3-100mL_qty1.stl
80.0 x 80.0 x 14.0
