shaoming11/hh-winners/exports/plates/X2-3_RK-02.gcode.3mf

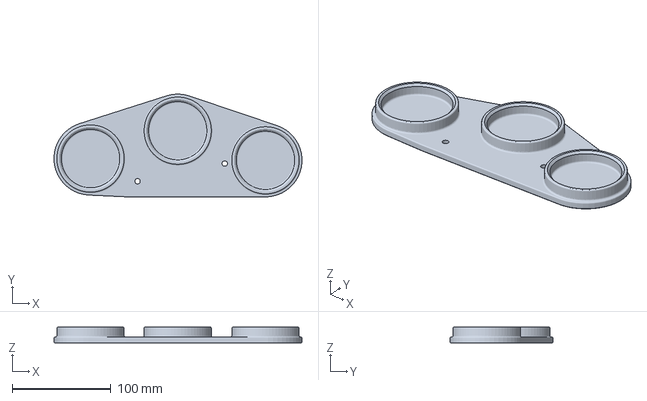
[picture p53: CAD file, 2026-10-17]
exports/plates/X2-3_RK-02.gcode.3mf
250.8 x 103.8 x 16.0 mm
