shaoming11/hh-winners/exports/print_at_BU/7_jigs/JG-03.stl

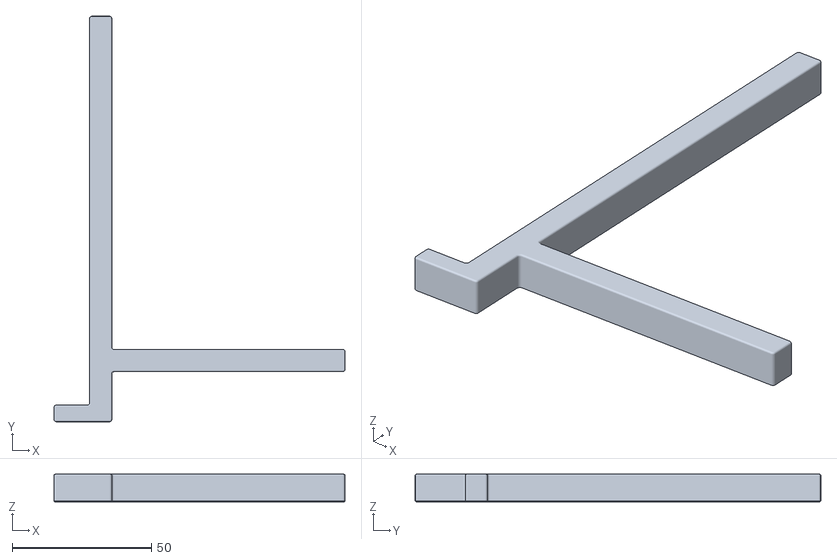
[picture p54: CAD file, 2026-10-17]
exports/print_at_BU/7_jigs/JG-03.stl
104.6 x 145.8 x 10.0
