shaoming11/hh-winners/exports/print_final/A1/3_WS-01-v3_FX-01_2h08.gcode.3mf

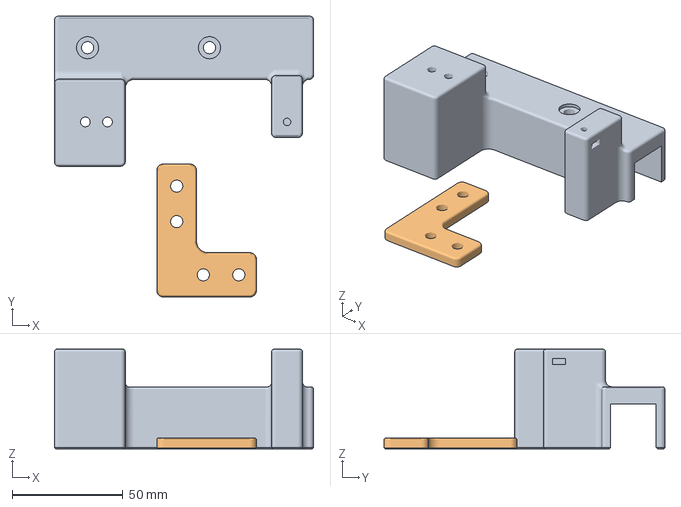
[picture p55: CAD file, 2026-10-17]
exports/print_final/A1/3_WS-01-v3_FX-01_2h08.gcode.3mf
117.0 x 126.8 x 45.0 mm
WS-01_scale-base-v3_qty1.stl
FX-01_E5-joiner-plate_qty1.stl
