shaoming11/hh-winners/exports/print_final/H2D/3_ST-11-14_stage-sled-bridge-crank-rod_6h18.gcode.3mf

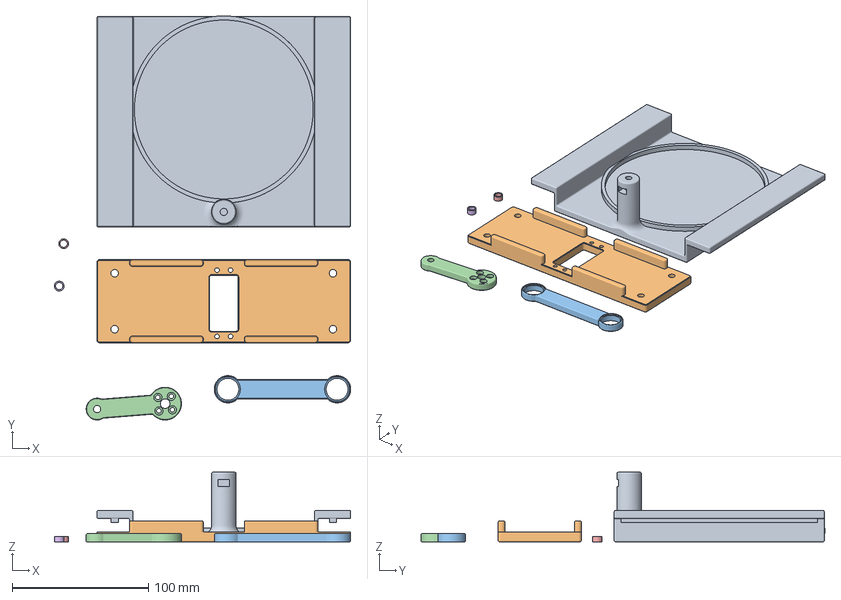
[picture p56: CAD file, 2026-10-17]
exports/print_final/H2D/3_ST-11-14_stage-sled-bridge-crank-rod_6h18.gcode.3mf
217.2 x 296.0 x 51.0 mm
ST-11_stage-sled_qty1_SUPPORTS.stl
ST-12_servo-bridge_qty1.stl
ST-14_connecting-rod_qty1.stl
ST-13_crank_qty1.stl
ST-15_pivot-spacer_qty2.stl x 2
