shaoming11/hh-winners/exports/print_queue_2026-10-15/H2D - when its current plate finishes/3_jigs_JG-04-05-06-08_0h33.gcode.3mf

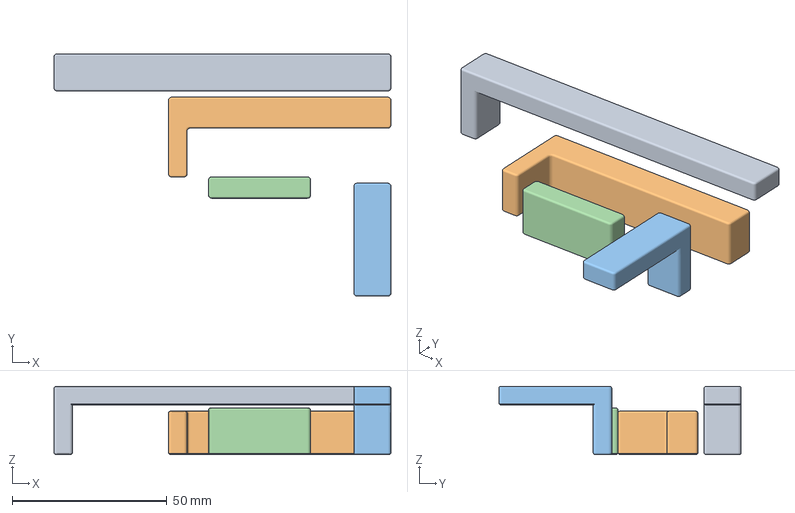
[picture p57: CAD file, 2026-10-17]
exports/print_queue_2026-10-15/H2D - when its current plate finishes/3_jigs_JG-04-05-06-08_0h33.gcode.3mf
108.9 x 78.3 x 22.0 mm
JG-04_pourer-base-locator.stl
JG-08_rack-tie-plate-gauge.stl
JG-05_transfer-base-locator.stl
JG-06_scale-gauge-7-mm.stl
