shaoming11/hh-winners/exports/print_queue_2026-10-15/X2E/GR-01x2_GR-02x2_gripper-bodies_RE-SLICE-FOR-X2E_5h05.gcode.3mf

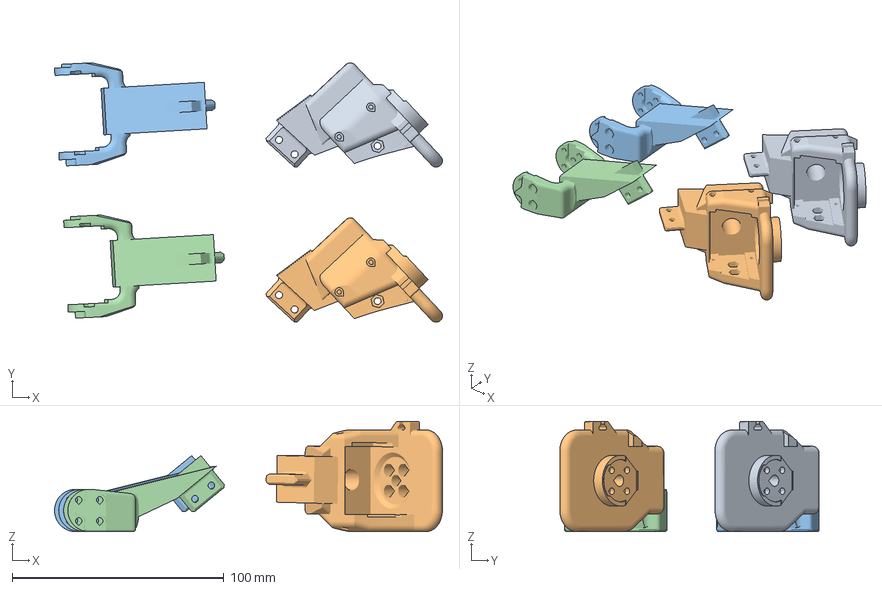
[picture p58: CAD file, 2026-10-17]
exports/print_queue_2026-10-15/X2E/GR-01x2_GR-02x2_gripper-bodies_RE-SLICE-FOR-X2E_5h05.gcode.3mf
183.1 x 122.5 x 52.0 mm
GR-01_gripper-body_qty2_SUPPORTS.stl x 2
GR-02_moving-jaw_qty2_SUPPORTS.stl x 2
