shaoming11/hh-winners/exports/prints/ST-15_pivot-spacer_qty2.step

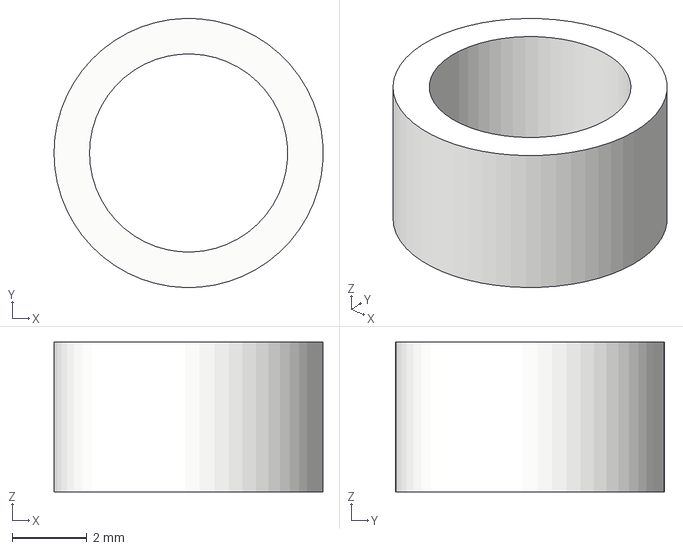
[picture p59: CAD file, 2026-10-17]
exports/prints/ST-15_pivot-spacer_qty2.step
7.19 x 7.20 x 4.00 mm
