shaoming11/hh-winners/exports/prints_v2/DH-01-v5_FINAL_bore-support-blocker_modifier.stl

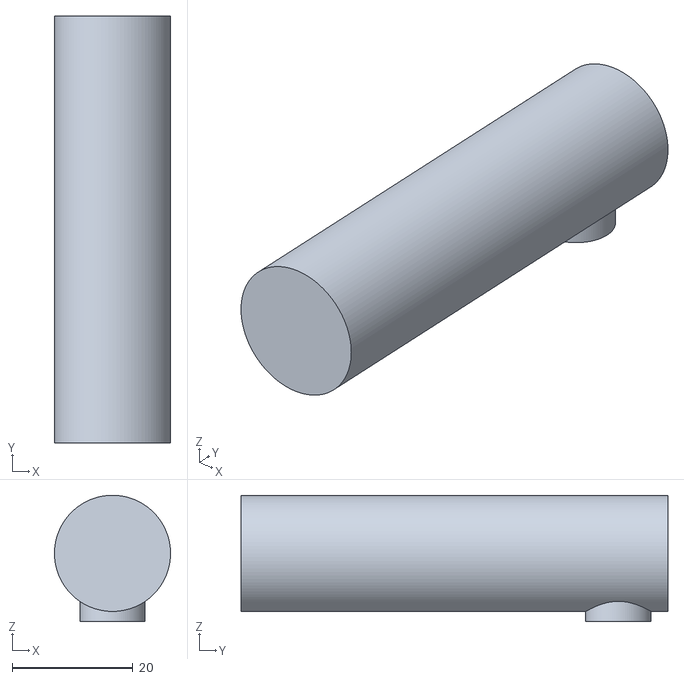
[picture p60: CAD file, 2026-10-17]
exports/prints_v2/DH-01-v5_FINAL_bore-support-blocker_modifier.stl
19.2 x 70.6 x 20.9
