shaoming11/hh-winners/exports/plates/A1-1_TPU_fingers-sleeves.gcode.3mf

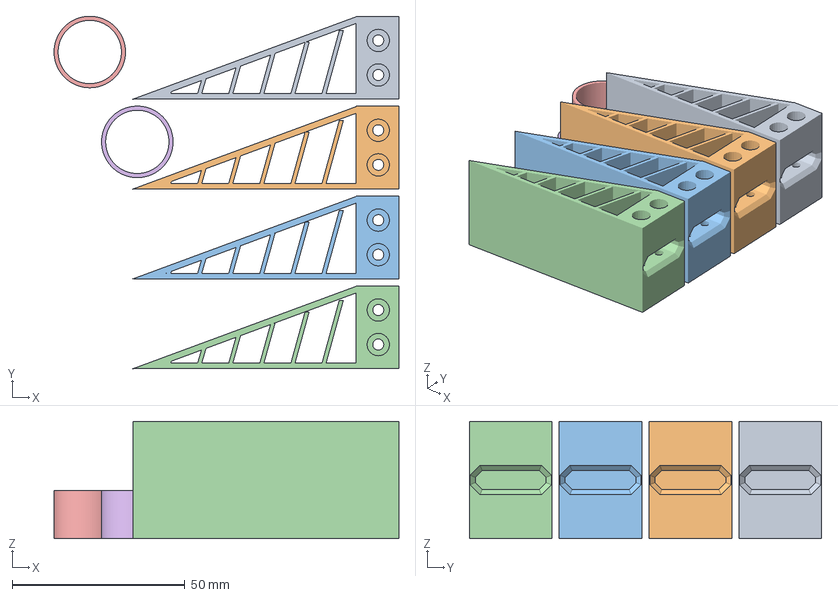
[picture p61: CAD file, 2026-10-17]
exports/plates/A1-1_TPU_fingers-sleeves.gcode.3mf
99.8 x 102.0 x 34.0 mm
GR-03_fin-ray-finger_qty4_TPU.stl x 4
ST-09_stop-post-sleeve_qty2_TPU.stl x 2
