shaoming11/hh-winners/exports/print_at_BU/4_RK-04_rack-tie-plate_x1.stl

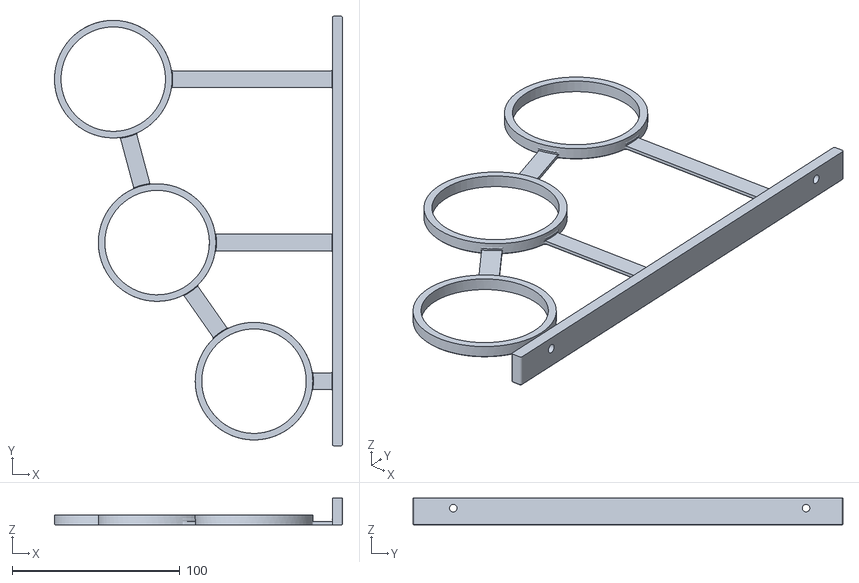
[picture p62: CAD file, 2026-10-17]
exports/print_at_BU/4_RK-04_rack-tie-plate_x1.stl
171.5 x 256.0 x 16.0
