shaoming11/hh-winners/exports/print_at_BU/7_jigs/JG-04_pourer-base-locator.stl

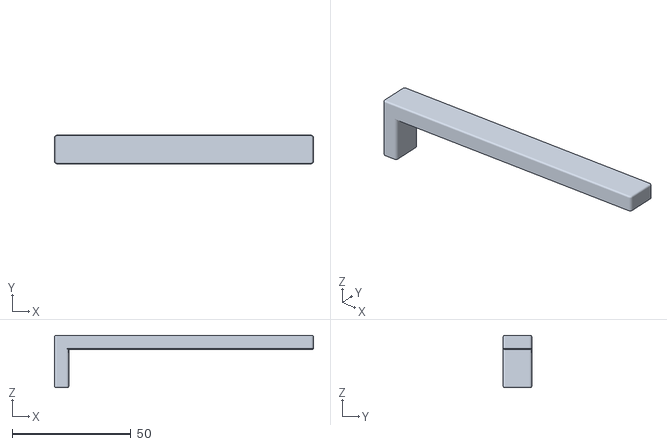
[picture p63: CAD file, 2026-10-17]
exports/print_at_BU/7_jigs/JG-04_pourer-base-locator.stl
108.9 x 12.0 x 22.0
