shaoming11/hh-winners/exports/print_final/A1/1_PS-01_auger-post_2h11.gcode.3mf

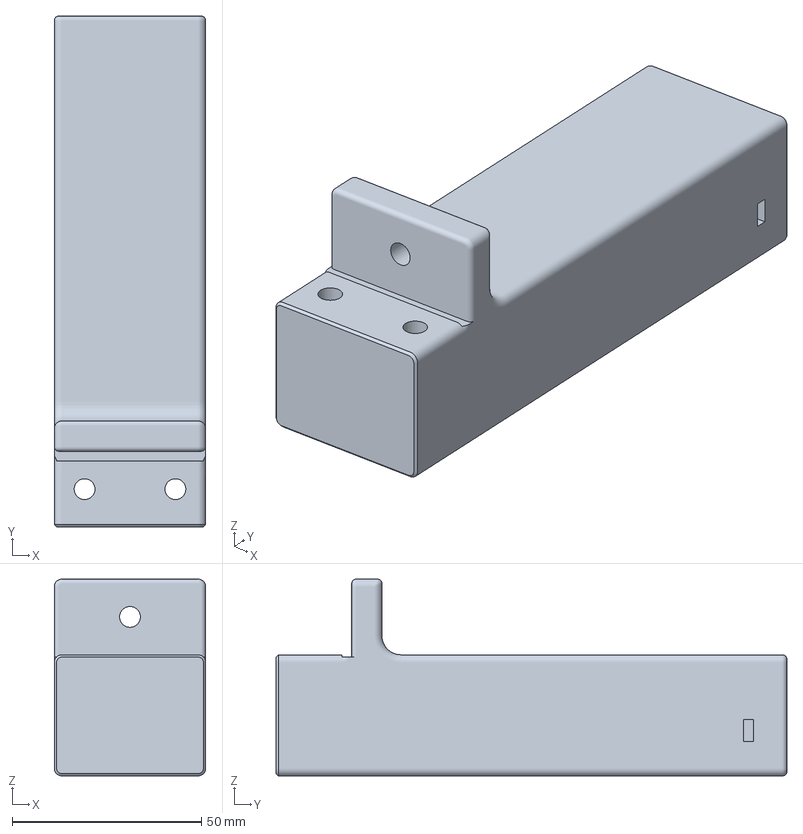
[picture p64: CAD file, 2026-10-17]
exports/print_final/A1/1_PS-01_auger-post_2h11.gcode.3mf
40.0 x 135.0 x 52.0 mm
