shaoming11/hh-winners/exports/print_queue_2026-10-15/A1/5_TT-05_turntable-tie-plate_1h11.gcode.3mf

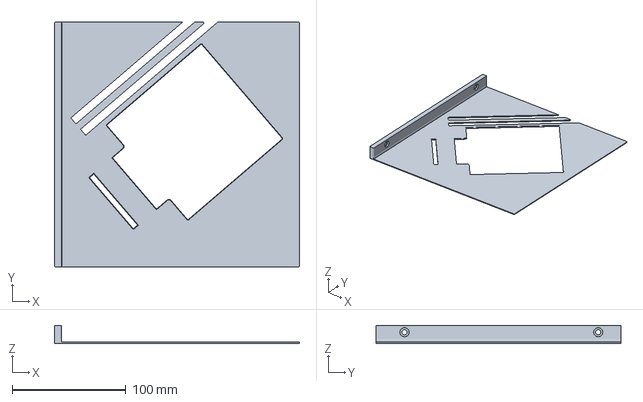
[picture p65: CAD file, 2026-10-17]
exports/print_queue_2026-10-15/A1/5_TT-05_turntable-tie-plate_1h11.gcode.3mf
215.0 x 215.0 x 16.0 mm
