shaoming11/hh-winners/exports/print_queue_2026-10-15/H2D - when its current plate finishes/1_DH-01-v5_auger-head_2h35.gcode.3mf

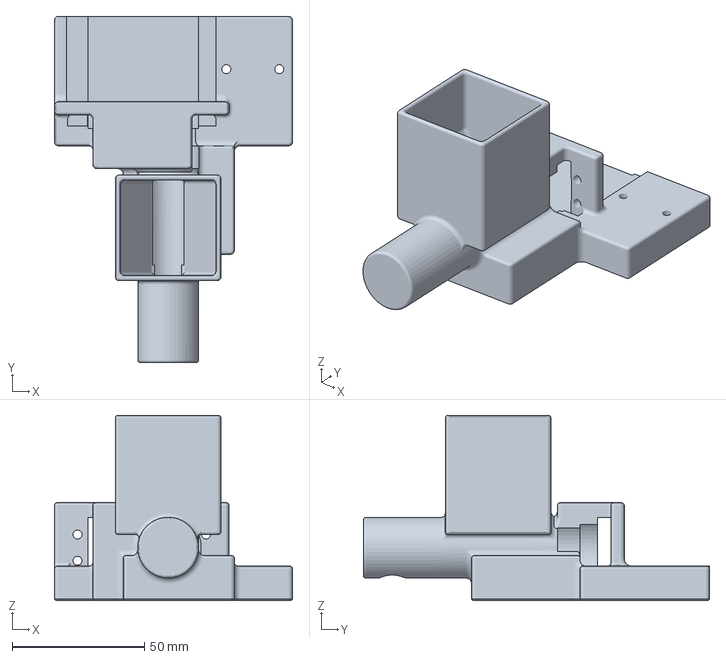
[picture p66: CAD file, 2026-10-17]
exports/print_queue_2026-10-15/H2D - when its current plate finishes/1_DH-01-v5_auger-head_2h35.gcode.3mf
90.0 x 131.0 x 70.0 mm
