shaoming11/hh-winners/exports/prints/GR-03_fin-ray-finger_qty4_TPU.step

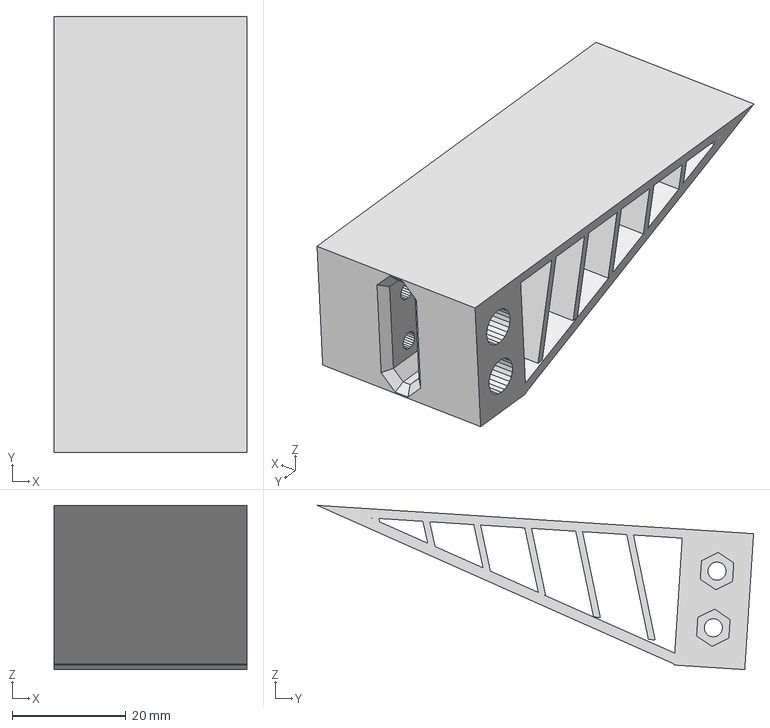
[picture p67: CAD file, 2026-10-17]
exports/prints/GR-03_fin-ray-finger_qty4_TPU.step
34.0 x 76.8 x 28.9 mm
