shaoming11/hh-winners/exports/prints_v2/JG-05_transfer-base-locator.stl

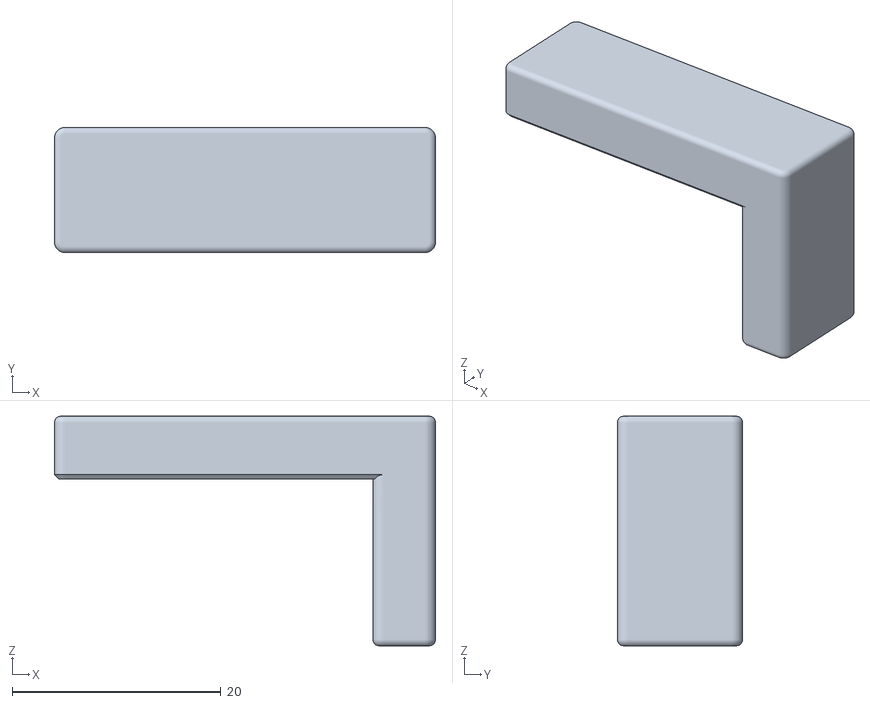
[picture p68: CAD file, 2026-10-17]
exports/prints_v2/JG-05_transfer-base-locator.stl
36.5 x 12.0 x 22.0
