shaoming11/hh-winners/exports/plates/X2-1_scale-spacers-gauge.gcode.3mf

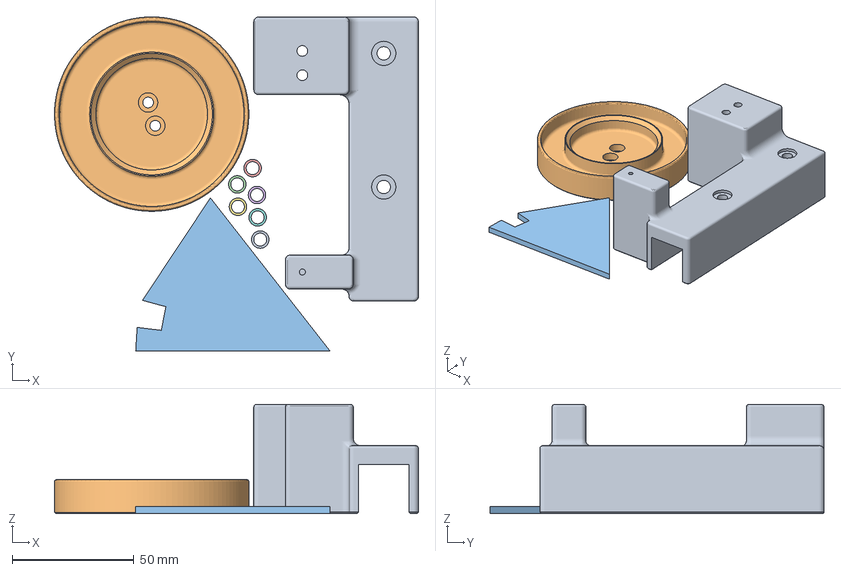
[picture p69: CAD file, 2026-10-17]
exports/plates/X2-1_scale-spacers-gauge.gcode.3mf
149.8 x 137.5 x 45.0 mm
WS-01_scale-base-v2_qty1.stl
WS-02_scale-pan-v2_qty1.stl
GA-01_stage-angle-gauge_qty1.stl
ST-08_bearing-race-spacer-v2_qty6.stl x 6
