shaoming11/hh-winners/exports/prints_v2/ST-01_stage-base-v2_qty1.stl

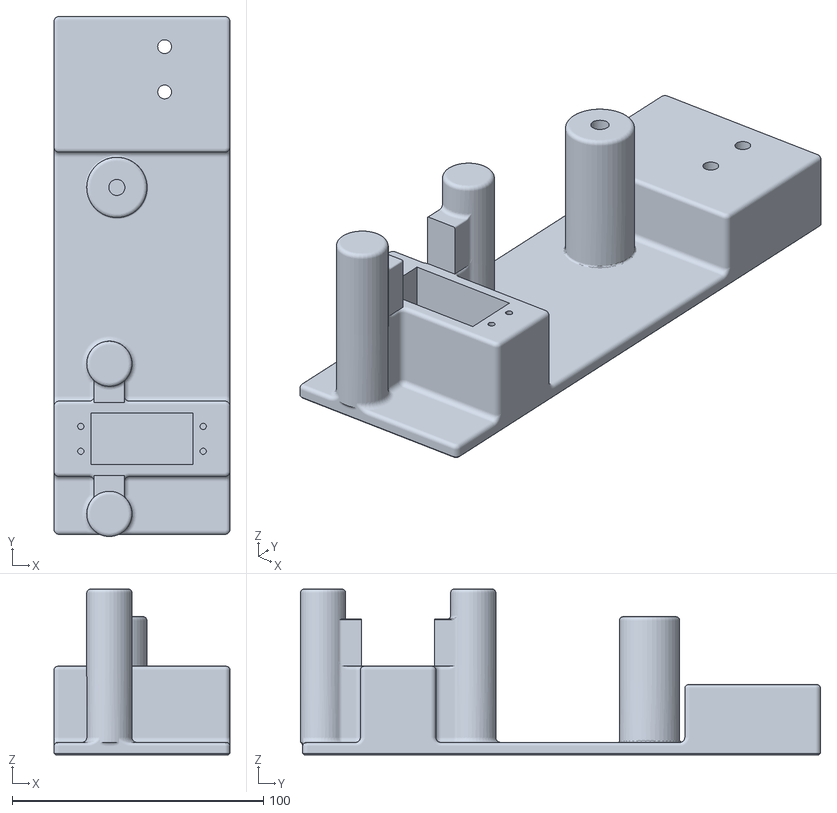
[picture p70: CAD file, 2026-10-17]
exports/prints_v2/ST-01_stage-base-v2_qty1.stl
70.0 x 206.9 x 66.0
