shaoming11/hh-winners/exports/print_at_BU/3_RK-03v2_reagent-stand_PRINT-x2.stl

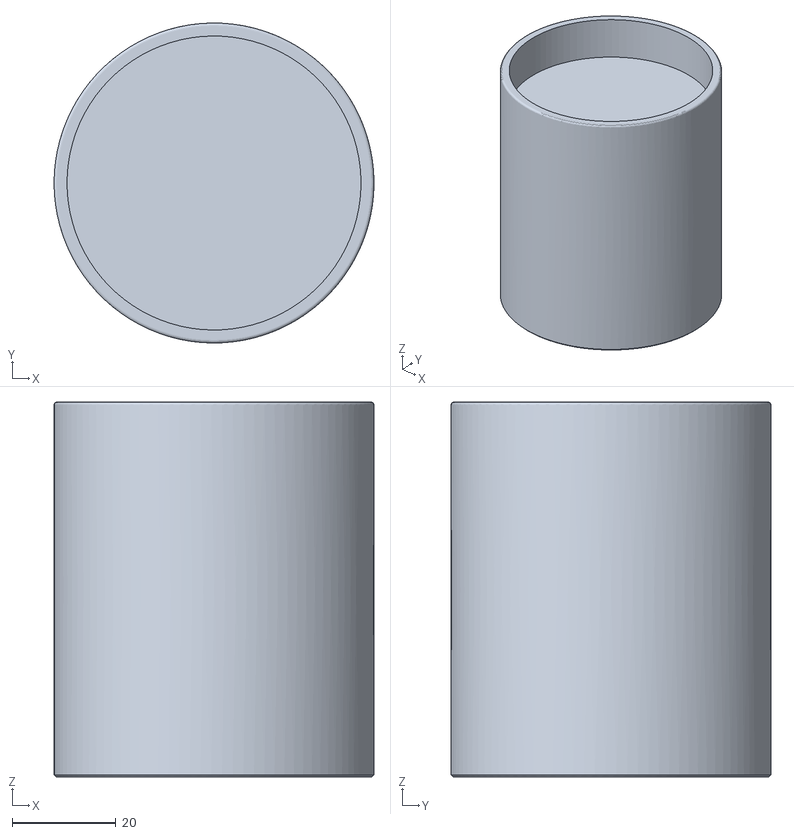
[picture p71: CAD file, 2026-10-17]
exports/print_at_BU/3_RK-03v2_reagent-stand_PRINT-x2.stl
61.6 x 61.6 x 72.2
