shaoming11/hh-winners/exports/print_queue_2026-10-15/A1/6_IF-TIME_jigs_JG-01-02-03-07-10_0h55.gcode.3mf

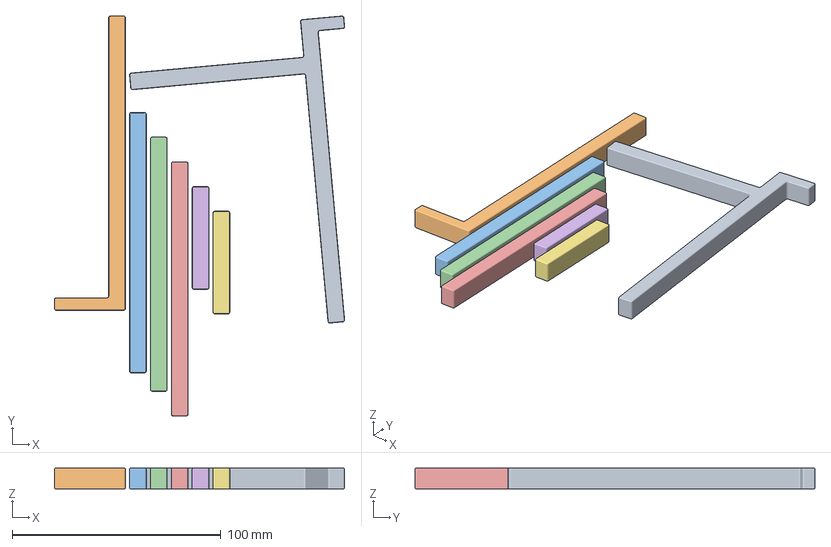
[picture p72: CAD file, 2026-10-17]
exports/print_queue_2026-10-15/A1/6_IF-TIME_jigs_JG-01-02-03-07-10_0h55.gcode.3mf
139.0 x 191.5 x 10.0 mm
JG-03.stl
JG-07.stl
JG-10.stl
JG-01L.stl
JG-01R.stl
JG-02L.stl
JG-02R.stl
