shaoming11/hh-winners/exports/prints/FX-01_E5-joiner-plate_qty1.step

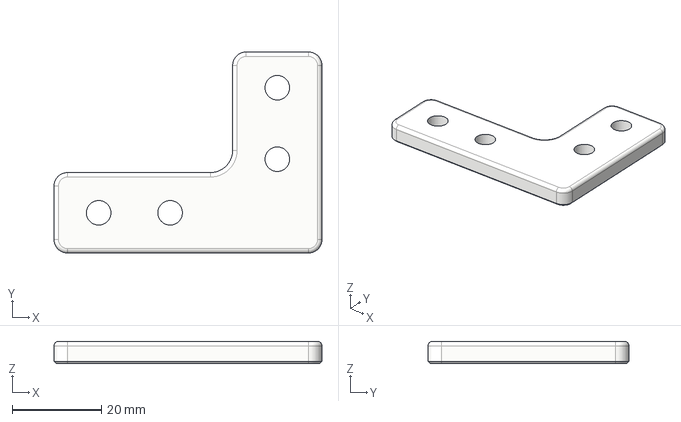
[picture p73: CAD file, 2026-10-17]
exports/prints/FX-01_E5-joiner-plate_qty1.step
60.0 x 45.0 x 5.00 mm
