shaoming11/hh-winners/exports/prints_v2/_beaker_wall.stl

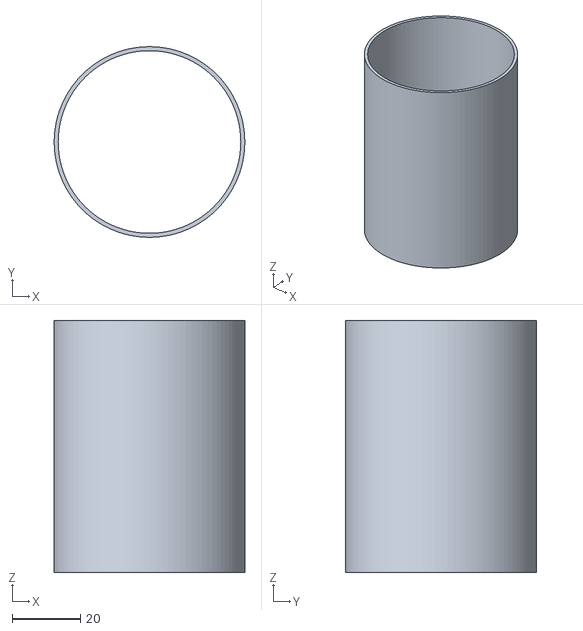
[picture p74: CAD file, 2026-10-17]
exports/prints_v2/_beaker_wall.stl
56.0 x 56.0 x 74.0
