shaoming11/hh-winners/exports/print_queue_2026-10-15/A1/1_NOW_WS-01v4_+_ST-05_2h37.gcode.3mf

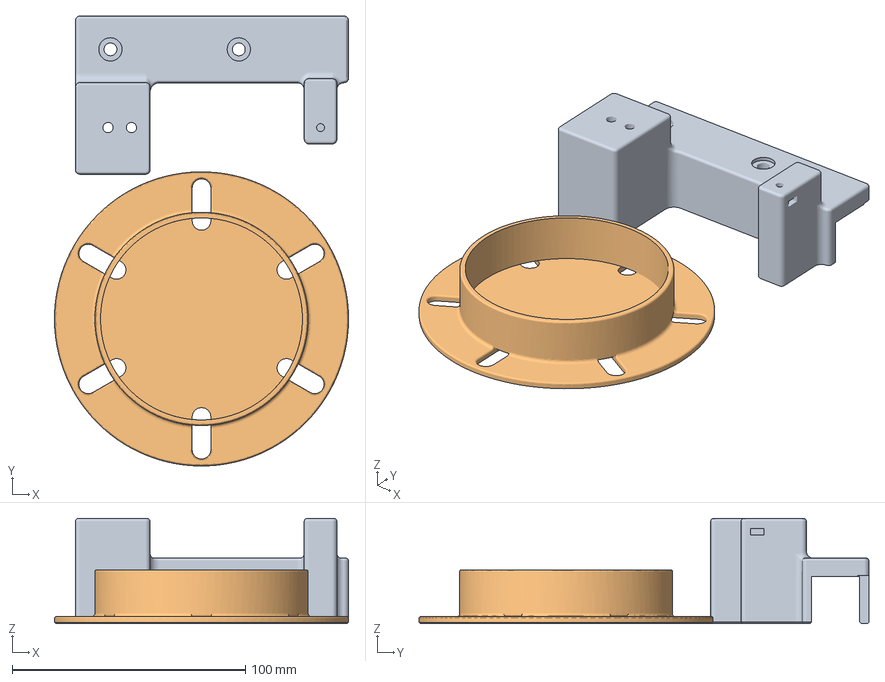
[picture p75: CAD file, 2026-10-17]
exports/print_queue_2026-10-15/A1/1_NOW_WS-01v4_+_ST-05_2h37.gcode.3mf
126.0 x 192.7 x 45.0 mm
WS-01_scale-base-v4_E6-notch_qty1.stl
ST-05_flask-collar_qty1.stl
