shaoming11/hh-winners/exports/prints_v2/JG-06_scale_gauge_7_mm.stl

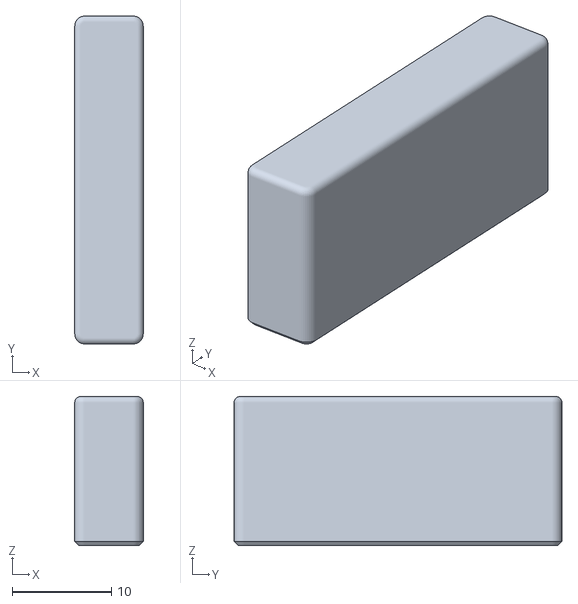
[picture p76: CAD file, 2026-10-17]
exports/prints_v2/JG-06_scale_gauge_7_mm.stl
6.90 x 33.0 x 15.0
