shaoming11/hh-winners/exports/prints/ST-14_connecting-rod_qty1.step

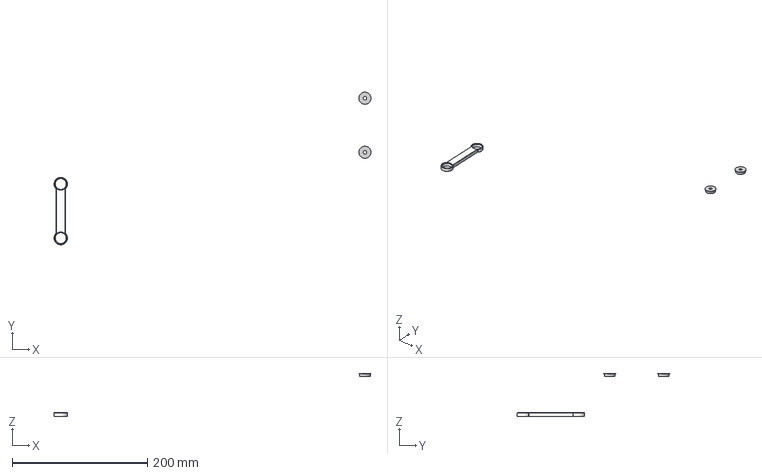
[picture p77: CAD file, 2026-10-17]
exports/prints/ST-14_connecting-rod_qty1.step
469.0 x 226.0 x 64.0 mm
