shaoming11/hh-winners/exports/prints_v2/JG-07.stl

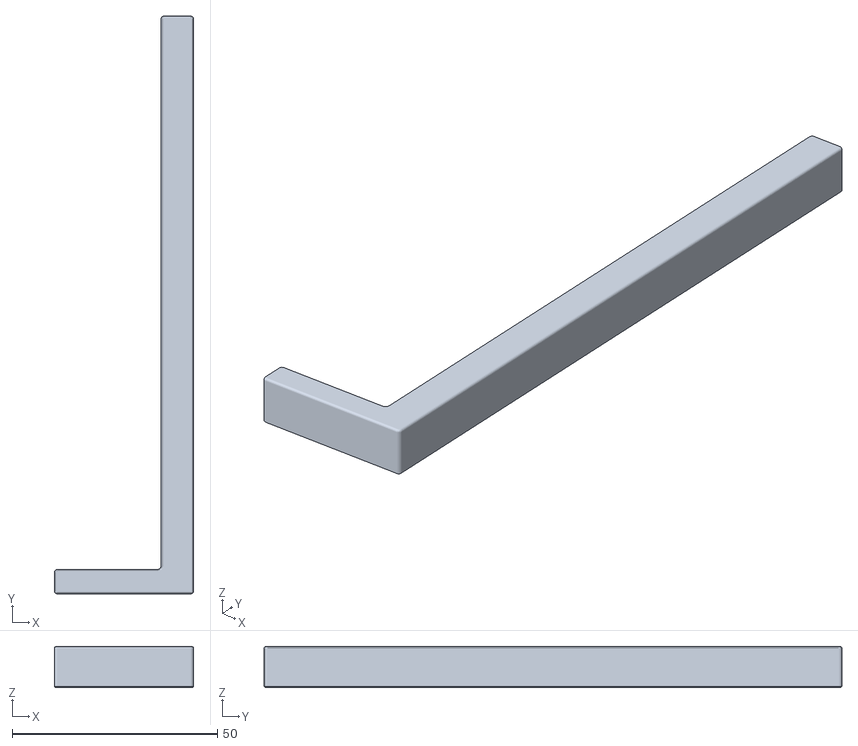
[picture p78: CAD file, 2026-10-17]
exports/prints_v2/JG-07.stl
34.0 x 140.9 x 10.0
