shaoming11/hh-winners/exports/prints/TT-02_carousel-deck_qty1.step

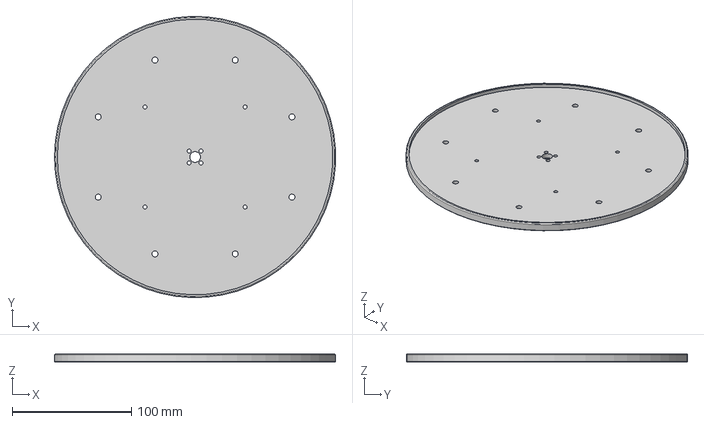
[picture p79: CAD file, 2026-10-17]
exports/prints/TT-02_carousel-deck_qty1.step
235.8 x 235.9 x 7.00 mm
