shaoming11/hh-winners/exports/prints/ST-13_crank_qty1.step

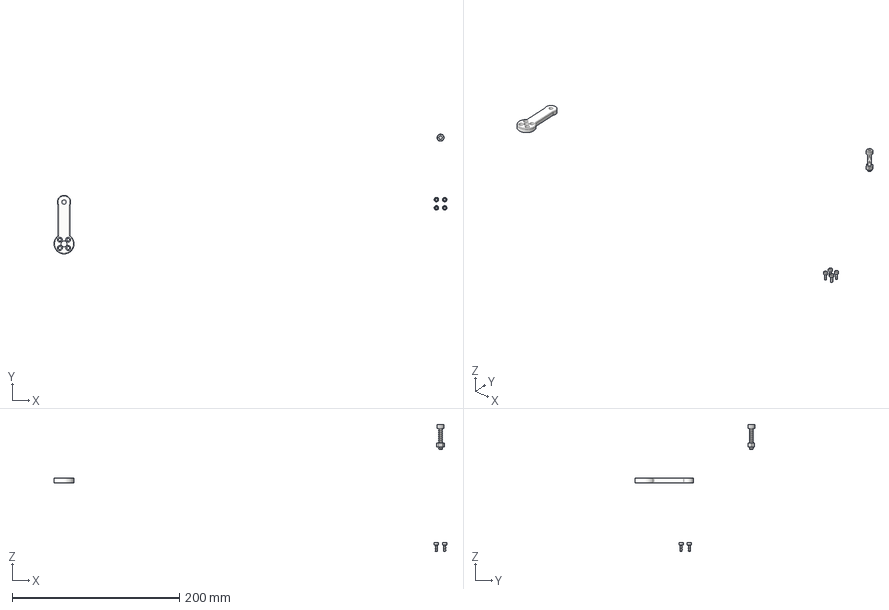
[picture p80: CAD file, 2026-10-17]
exports/prints/ST-13_crank_qty1.step
469.7 x 143.2 x 152.0 mm
