shaoming11/hh-winners/exports/prints/GR-02_moving-jaw_qty2_SUPPORTS.step

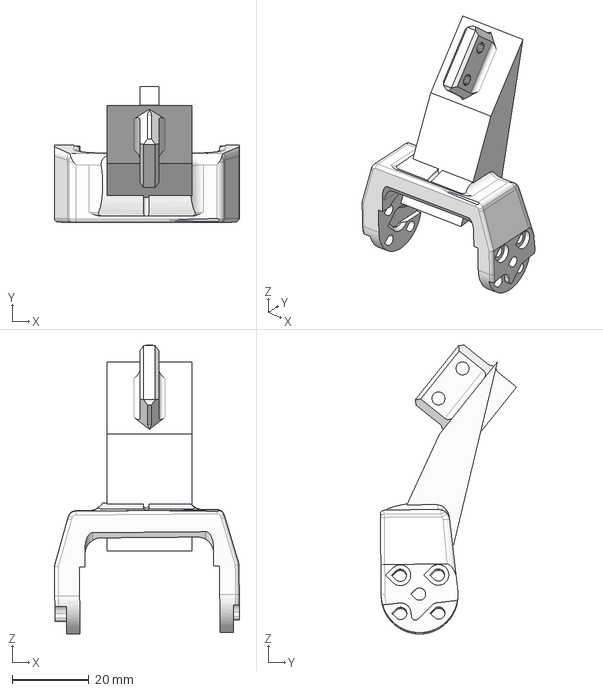
[picture p81: CAD file, 2026-10-17]
exports/prints/GR-02_moving-jaw_qty2_SUPPORTS.step
48.1 x 35.4 x 75.1 mm
