shaoming11/hh-winners/exports/prints_v2/PS-01_auger-post-v2_qty1.stl

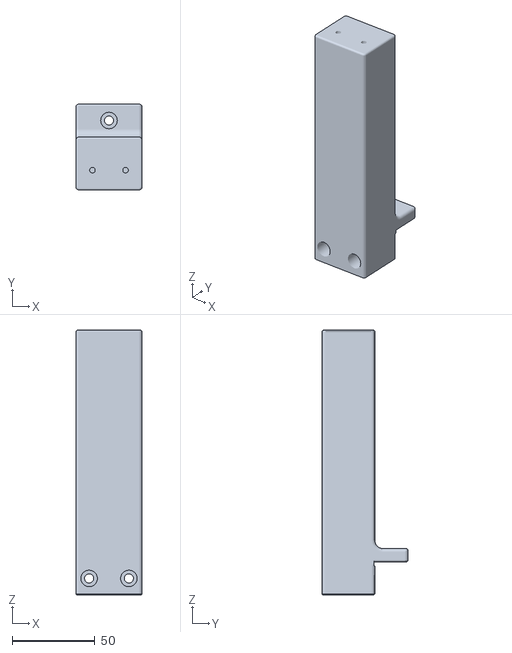
[picture p82: CAD file, 2026-10-17]
exports/prints_v2/PS-01_auger-post-v2_qty1.stl
40.0 x 52.0 x 160.0
