shaoming11/hh-winners/exports/prints_v2/JG-10_S2-locator.stl

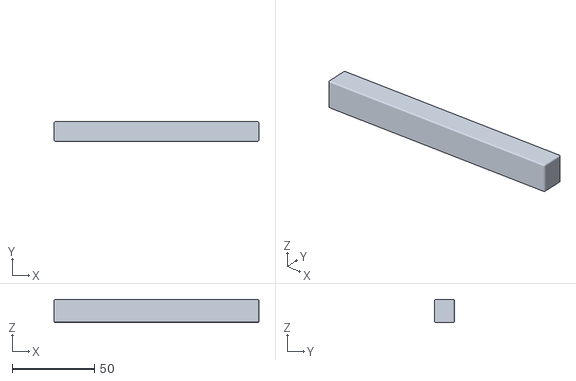
[picture p83: CAD file, 2026-10-17]
exports/prints_v2/JG-10_S2-locator.stl
124.7 x 12.0 x 14.0
