shaoming11/hh-winners/exports/prints/TT-01_turntable-base_qty1.step

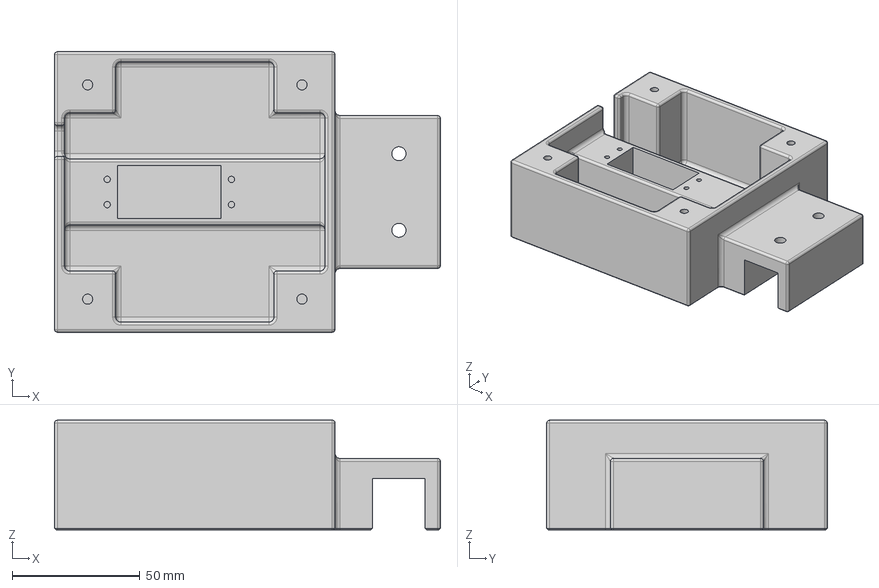
[picture p84: CAD file, 2026-10-17]
exports/prints/TT-01_turntable-base_qty1.step
151.3 x 110.0 x 43.0 mm
