shaoming11/hh-winners/exports/prints_v2/_beaker_floor.stl

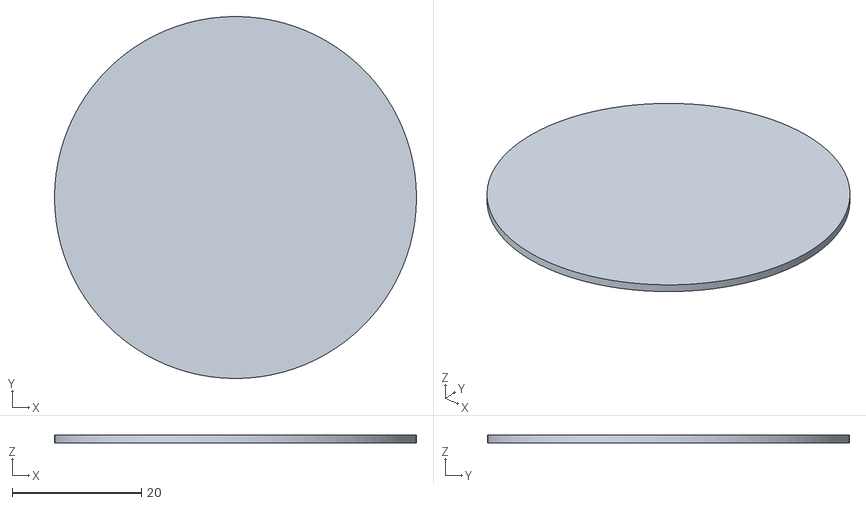
[picture p85: CAD file, 2026-10-17]
exports/prints_v2/_beaker_floor.stl
56.0 x 56.0 x 1.20
