shaoming11/hh-winners/exports/prints_v2/ST-05_flask-collar_qty1.stl

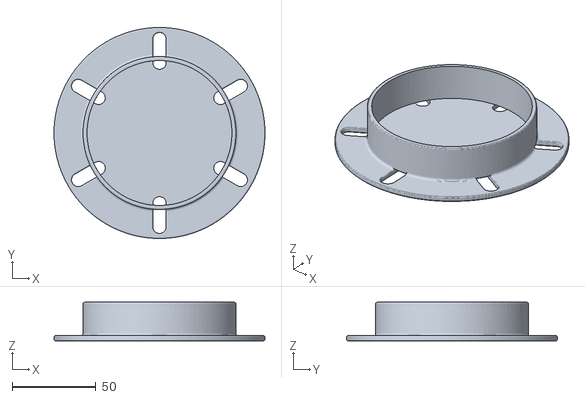
[picture p86: CAD file, 2026-10-17]
exports/prints_v2/ST-05_flask-collar_qty1.stl
126.0 x 126.0 x 23.0
