shaoming11/hh-winners/exports/prints/WS-01_scale-base-v3_qty1.step

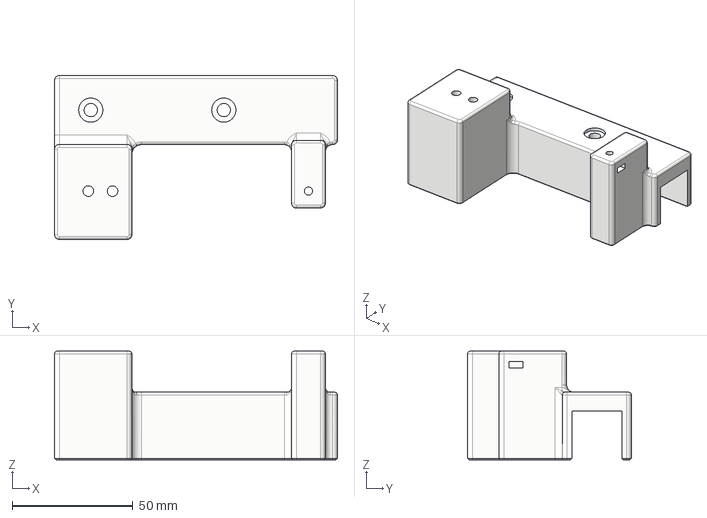
[picture p87: CAD file, 2026-10-17]
exports/prints/WS-01_scale-base-v3_qty1.step
117.0 x 67.8 x 45.0 mm
