shaoming11/hh-winners/exports/prints_v2/JG-01_gap_block_E6-Xfront_122_R.stl

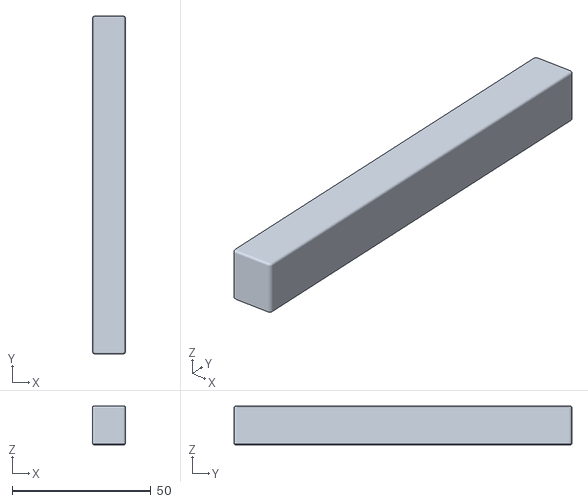
[picture p88: CAD file, 2026-10-17]
exports/prints_v2/JG-01_gap_block_E6-Xfront_122_R.stl
12.0 x 121.7 x 14.0
