shaoming11/hh-winners/exports/prints/GR-01_gripper-body_qty2_SUPPORTS.step

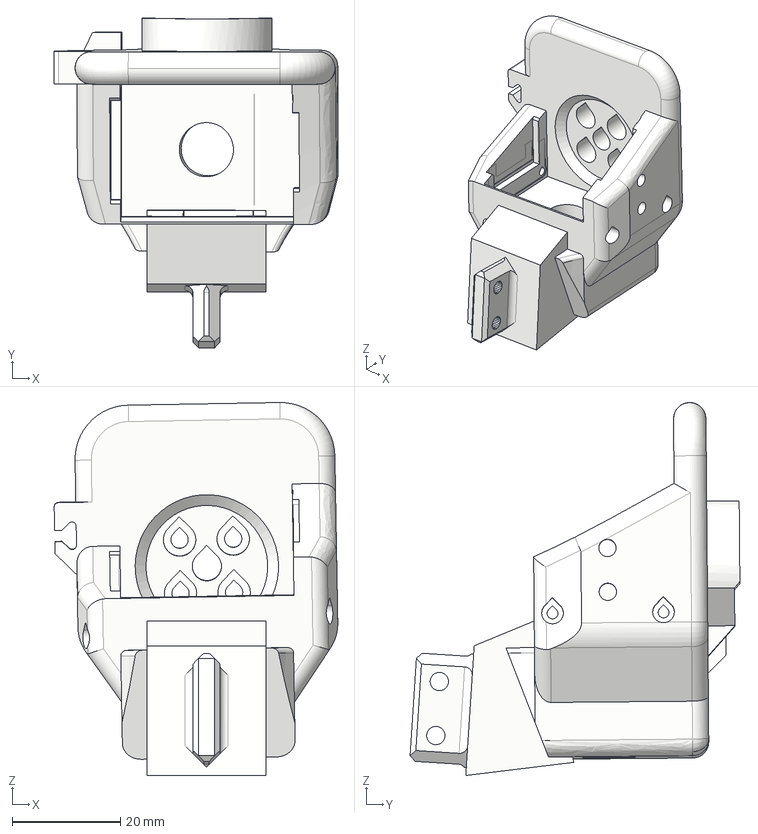
[picture p89: CAD file, 2026-10-17]
exports/prints/GR-01_gripper-body_qty2_SUPPORTS.step
52.4 x 60.9 x 68.9 mm
