shaoming11/hh-winners/exports/prints_v2/WS-01_scale-base-v4_E6-notch_qty1.stl

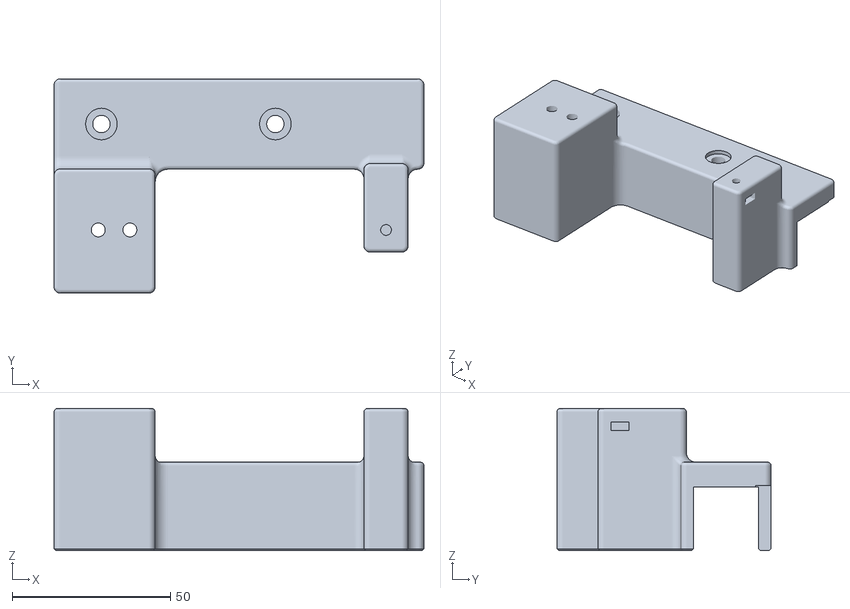
[picture p90: CAD file, 2026-10-17]
exports/prints_v2/WS-01_scale-base-v4_E6-notch_qty1.stl
117.0 x 67.8 x 45.0
