shaoming11/hh-winners/exports/prints/TT-01_turntable-base-v2_qty1.step

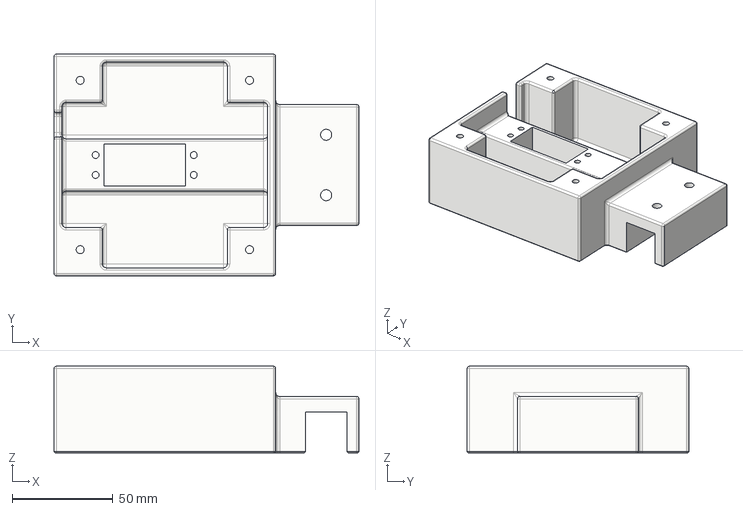
[picture p91: CAD file, 2026-10-17]
exports/prints/TT-01_turntable-base-v2_qty1.step
151.3 x 110.0 x 43.0 mm
