shaoming11/hh-winners/exports/prints/ST-11_stage-sled_qty1_SUPPORTS.step

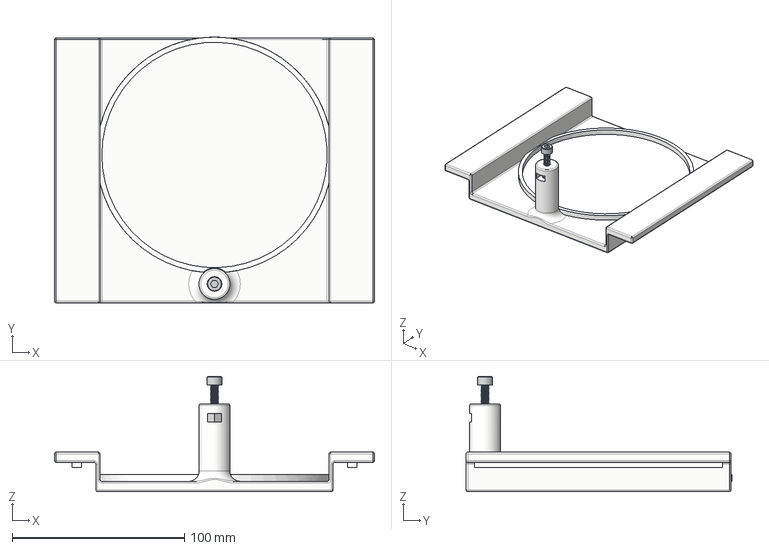
[picture p92: CAD file, 2026-10-17]
exports/prints/ST-11_stage-sled_qty1_SUPPORTS.step
186.0 x 154.5 x 67.0 mm
