shaoming11/hh-winners/exports/prints_v2/JG-07_turntable-plate-gauge.stl

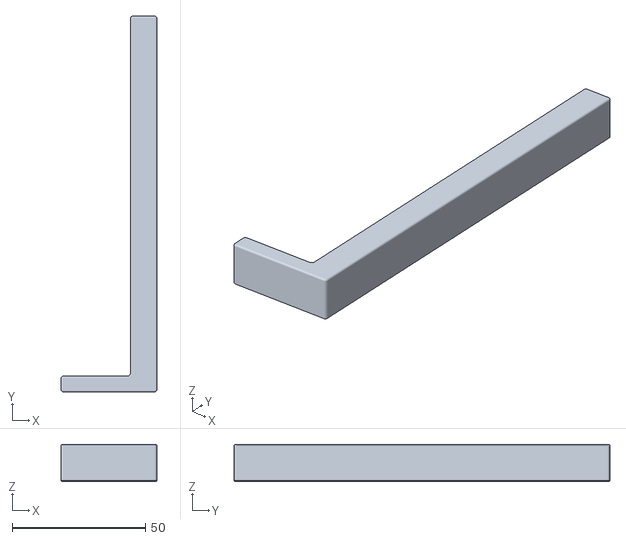
[picture p93: CAD file, 2026-10-17]
exports/prints_v2/JG-07_turntable-plate-gauge.stl
36.0 x 140.9 x 14.0
