shaoming11/hh-winners/exports/prints/TL-01_stir-rod-handle_qty2.step

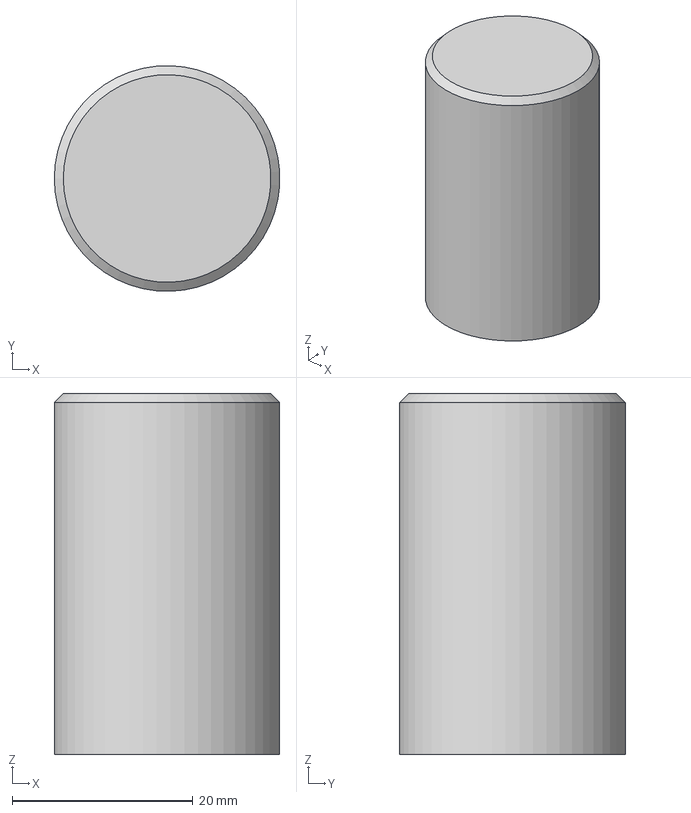
[picture p94: CAD file, 2026-10-17]
exports/prints/TL-01_stir-rod-handle_qty2.step
25.0 x 25.0 x 40.0 mm
