shaoming11/hh-winners/exports/prints_v2/DH-01-v4_bore-support-blocker_modifier.stl

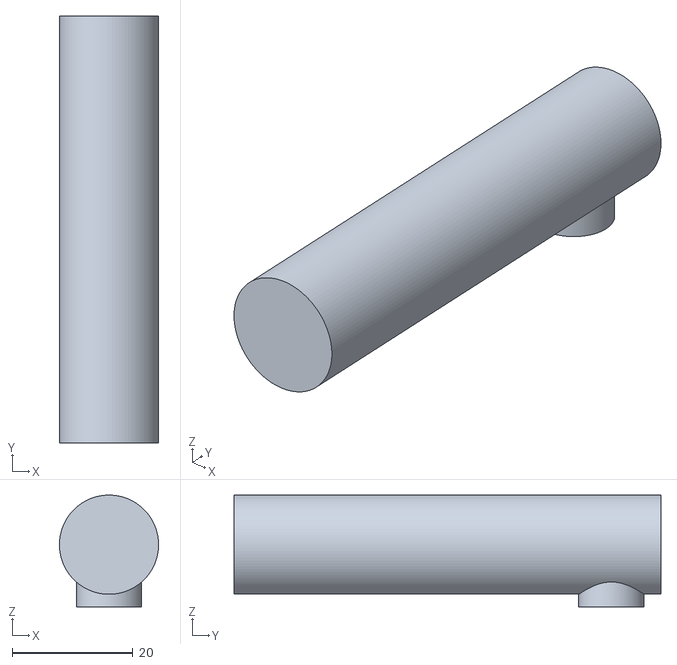
[picture p95: CAD file, 2026-10-17]
exports/prints_v2/DH-01-v4_bore-support-blocker_modifier.stl
16.4 x 70.6 x 18.5
