shaoming11/hh-winners/exports/prints/TT-03_horn-spacer_qty1.step

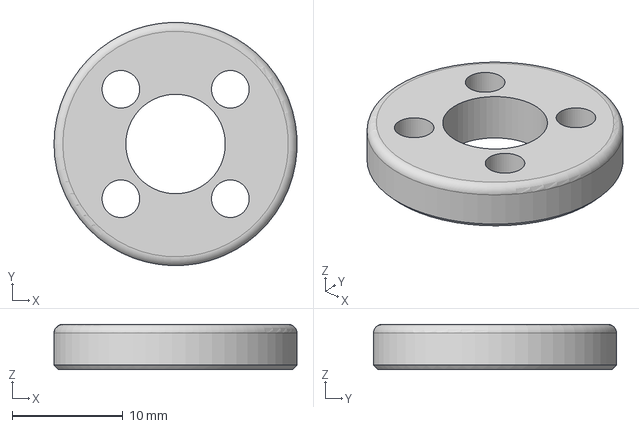
[picture p96: CAD file, 2026-10-17]
exports/prints/TT-03_horn-spacer_qty1.step
22.0 x 22.0 x 4.10 mm
