shaoming11/hh-winners/exports/prints/ST-12_servo-bridge_qty1.step

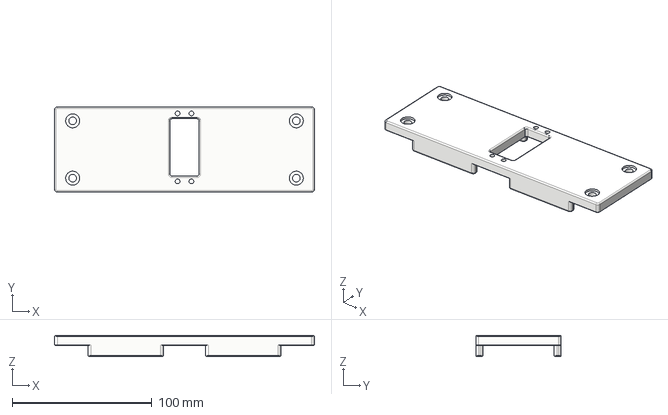
[picture p97: CAD file, 2026-10-17]
exports/prints/ST-12_servo-bridge_qty1.step
186.0 x 61.0 x 15.3 mm
