shaoming11/hh-winners/exports/prints_v2/GA-01_stage-angle-gauge_qty1.stl

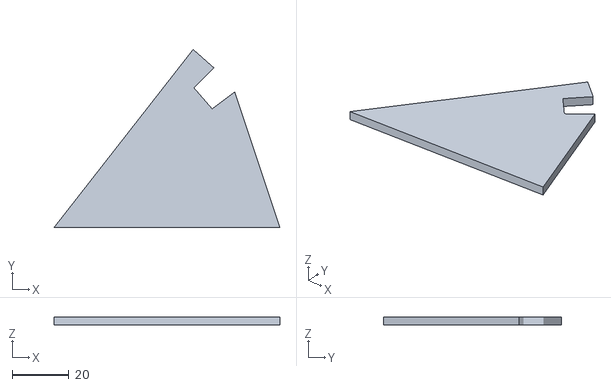
[picture p98: CAD file, 2026-10-17]
exports/prints_v2/GA-01_stage-angle-gauge_qty1.stl
80.0 x 63.0 x 3.00
