shaoming11/hh-winners/exports/prints_v2/JG-03_E6_locator.stl

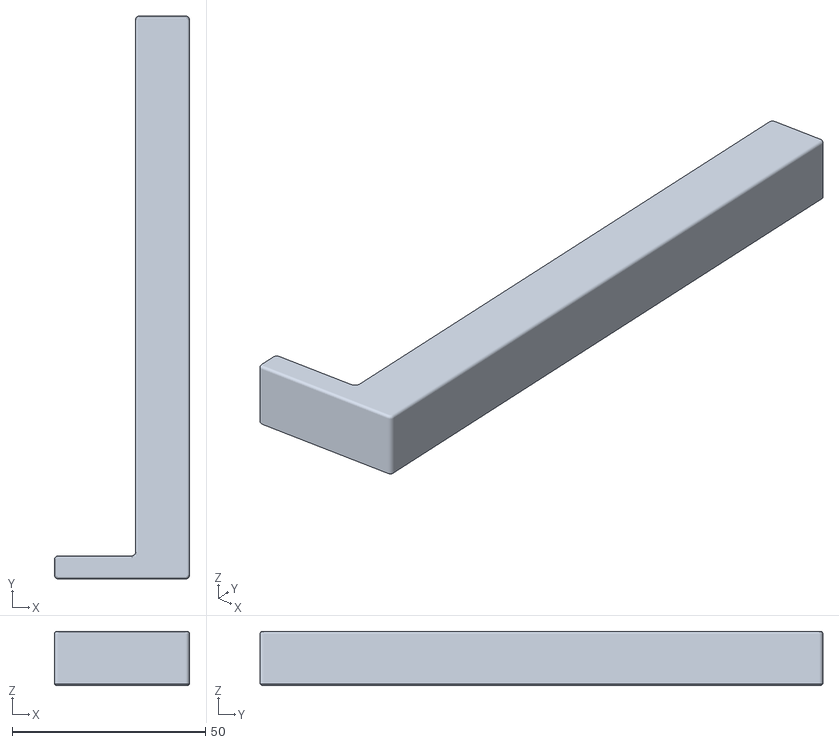
[picture p99: CAD file, 2026-10-17]
exports/prints_v2/JG-03_E6_locator.stl
35.0 x 145.8 x 14.0
