shaoming11/hh-winners/exports/prints/TC-01_bearing-test-coupon_qty1.step

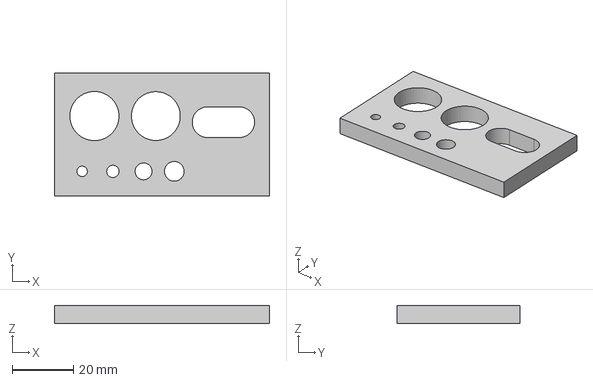
[picture p100: CAD file, 2026-10-17]
exports/prints/TC-01_bearing-test-coupon_qty1.step
70.0 x 40.0 x 6.00 mm
