shaoming11/hh-winners/exports/prints_v2/JG-03_E6-+-S1-locator.stl

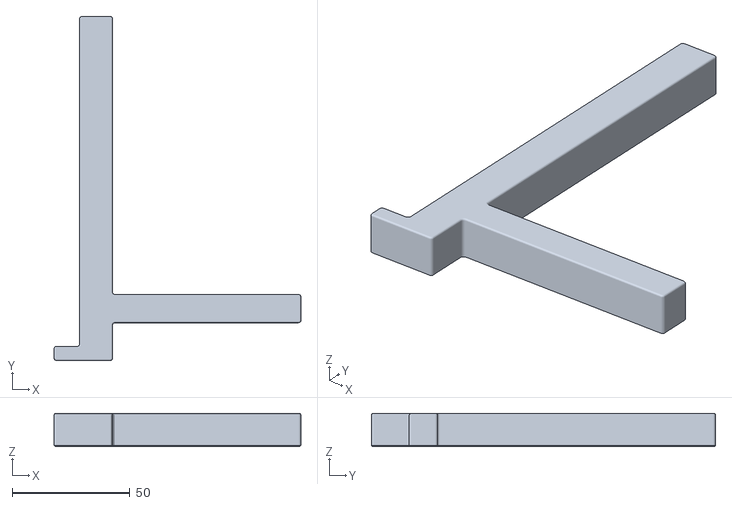
[picture p101: CAD file, 2026-10-17]
exports/prints_v2/JG-03_E6-+-S1-locator.stl
104.6 x 145.8 x 14.0
