shaoming11/hh-winners/exports/prints_v2/JG-01R.stl

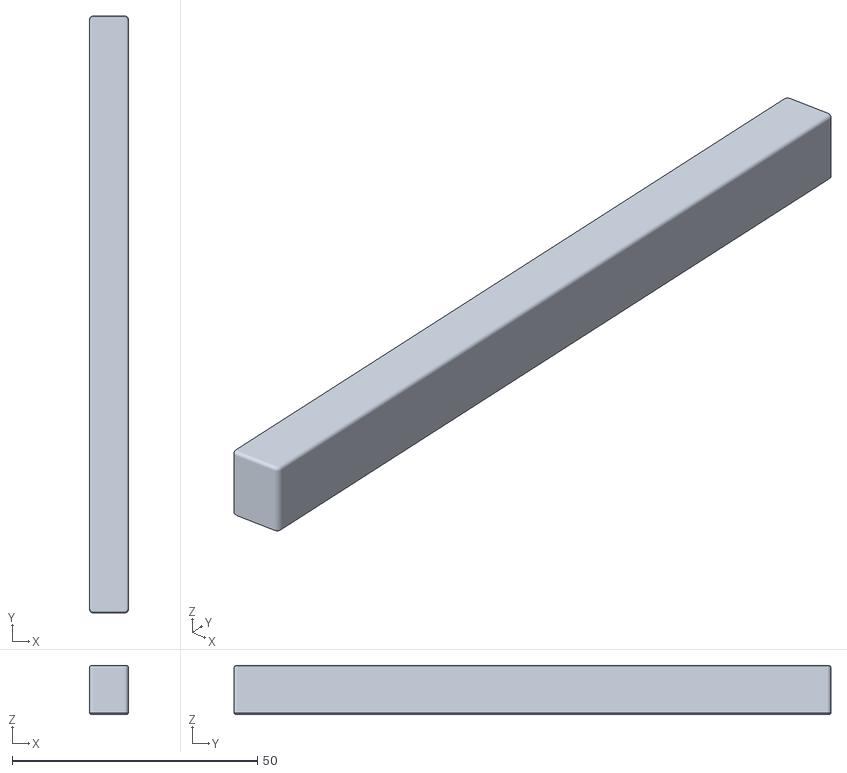
[picture p102: CAD file, 2026-10-17]
exports/prints_v2/JG-01R.stl
8.00 x 121.7 x 10.0
