shaoming11/hh-winners/exports/prints_v2/SF-01_scale-foot_qty1.stl

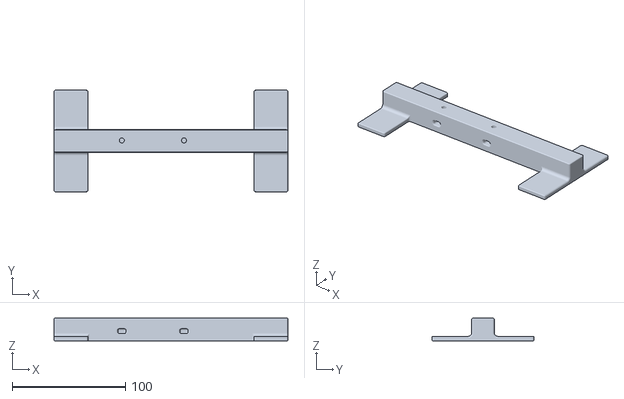
[picture p103: CAD file, 2026-10-17]
exports/prints_v2/SF-01_scale-foot_qty1.stl
207.0 x 90.0 x 20.0
