shaoming11/hh-winners/exports/prints_v2/JG-04_pourer_base_locator.stl

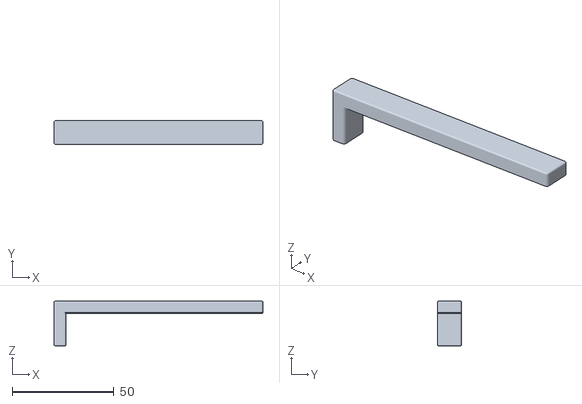
[picture p104: CAD file, 2026-10-17]
exports/prints_v2/JG-04_pourer_base_locator.stl
102.9 x 12.0 x 22.0
