shaoming11/hh-winners/exports/prints_v2/CAL-02_probe-v2-d56_qty1.stl

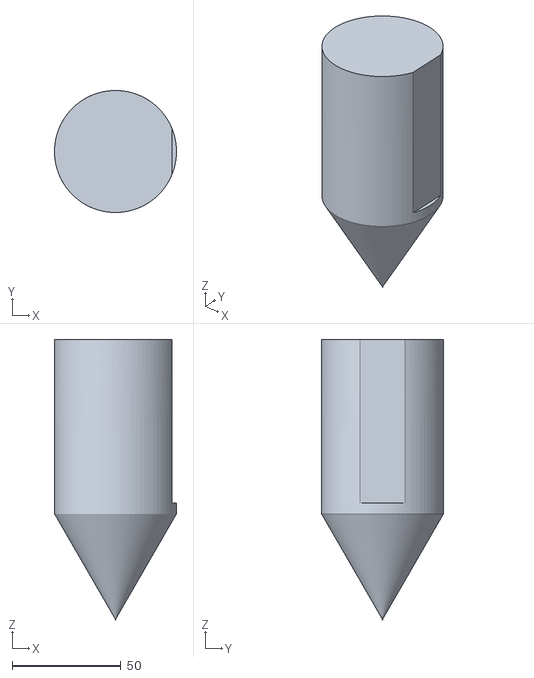
[picture p105: CAD file, 2026-10-17]
exports/prints_v2/CAL-02_probe-v2-d56_qty1.stl
56.0 x 56.0 x 128.5
