shaoming11/hh-winners/exports/prints_v2/RK-03_reagent_rack.stl

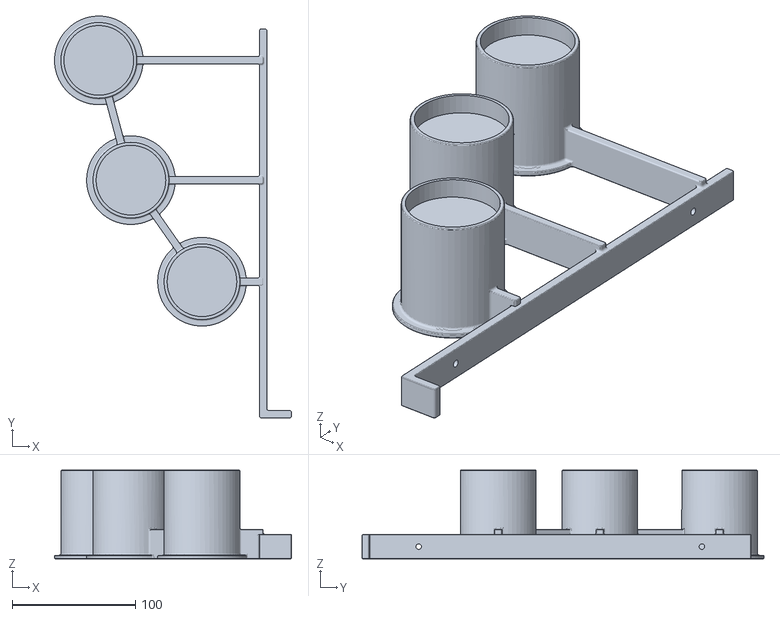
[picture p106: CAD file, 2026-10-17]
exports/prints_v2/RK-03_reagent_rack.stl
192.5 x 326.4 x 72.2
