shaoming11/hh-winners/exports/prints_v2/ST-13_crank_qty1.stl

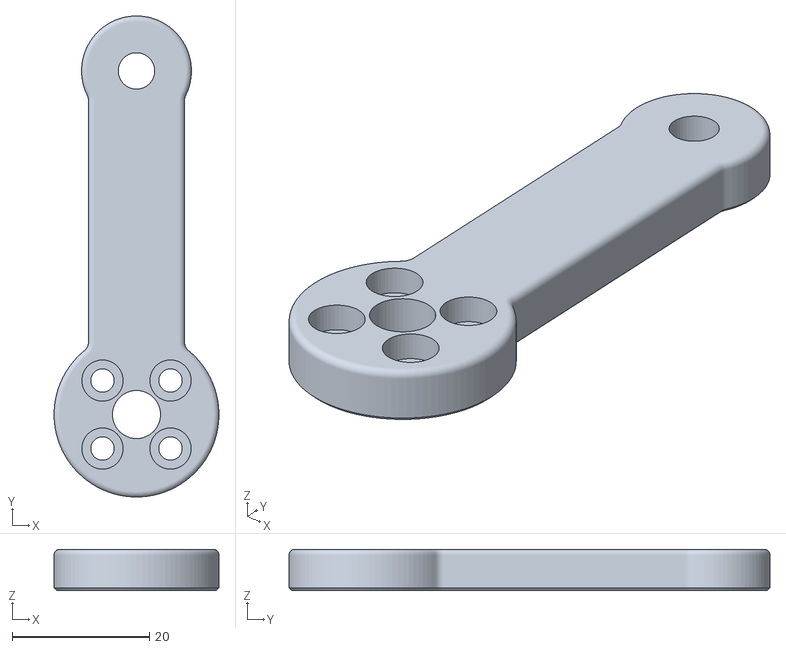
[picture p107: CAD file, 2026-10-17]
exports/prints_v2/ST-13_crank_qty1.stl
24.0 x 70.0 x 6.00
