shaoming11/hh-winners/exports/prints_v2/AG-01_auger-stand-v2_qty1.stl

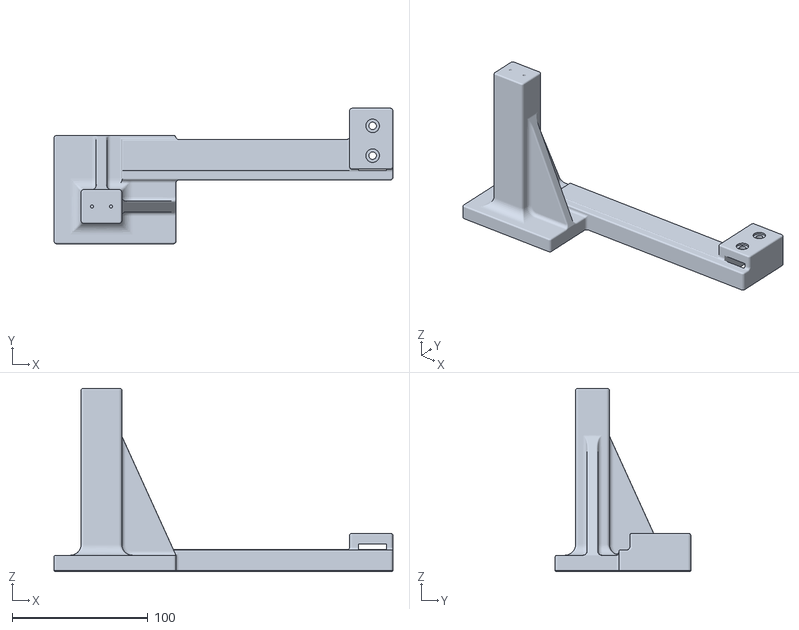
[picture p108: CAD file, 2026-10-17]
exports/prints_v2/AG-01_auger-stand-v2_qty1.stl
250.0 x 100.0 x 135.0
