shaoming11/hh-winners/exports/prints_v2/ST-09_stop-post-sleeve_qty2_TPU.stl

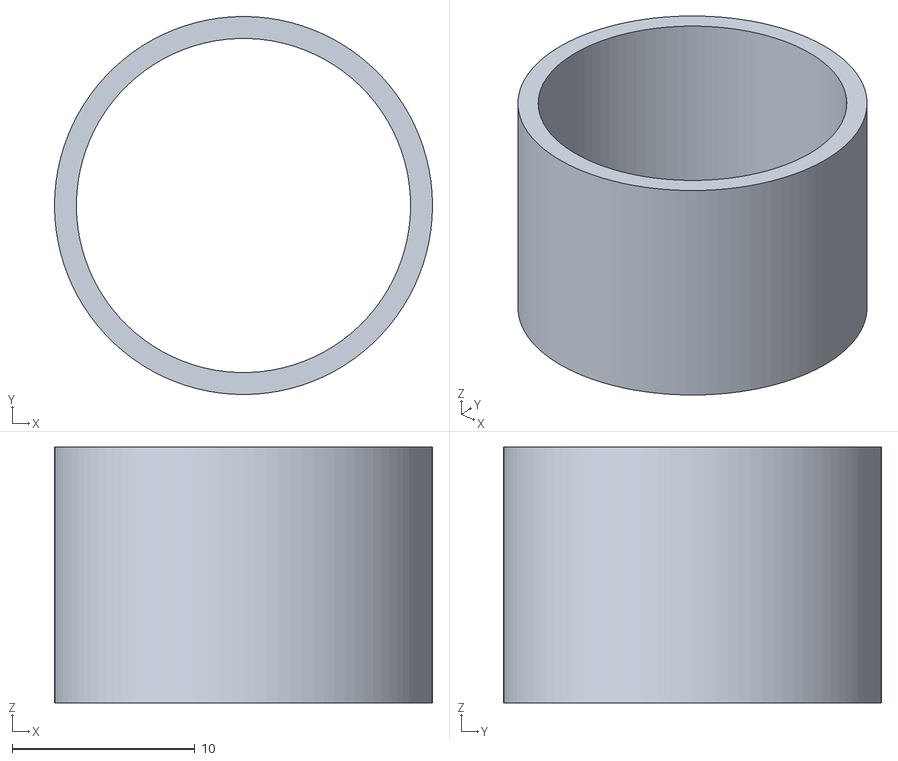
[picture p109: CAD file, 2026-10-17]
exports/prints_v2/ST-09_stop-post-sleeve_qty2_TPU.stl
20.7 x 20.7 x 14.0
