shaoming11/hh-winners/exports/prints_v2/JG-08_rack-tie-plate-gauge.stl

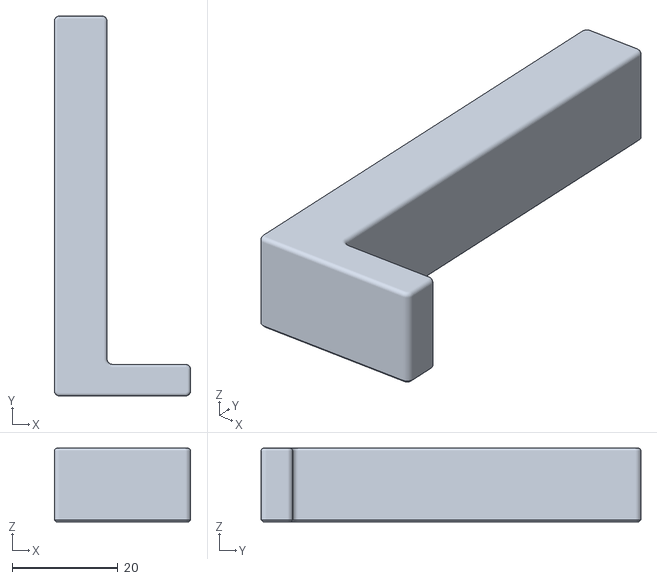
[picture p110: CAD file, 2026-10-17]
exports/prints_v2/JG-08_rack-tie-plate-gauge.stl
25.8 x 71.9 x 14.0
