shaoming11/hh-winners/exports/prints_v2/JG-10.stl

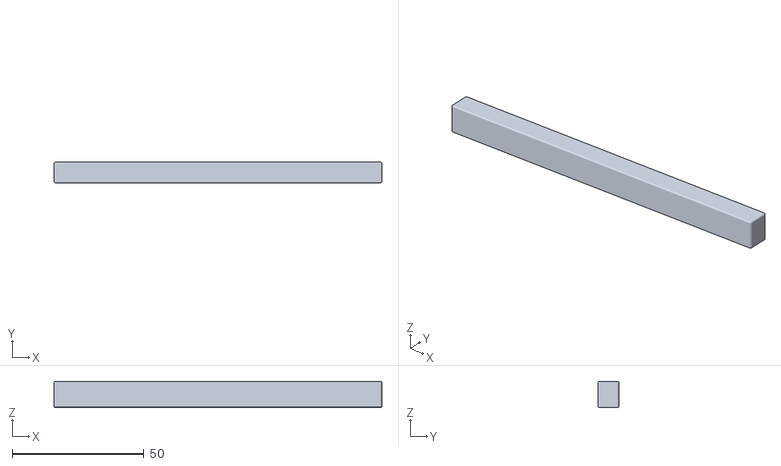
[picture p111: CAD file, 2026-10-17]
exports/prints_v2/JG-10.stl
124.7 x 8.00 x 10.0
