shaoming11/hh-winners/exports/prints_v2/RK-03_reagent-rack-freestanding_qty1.stl

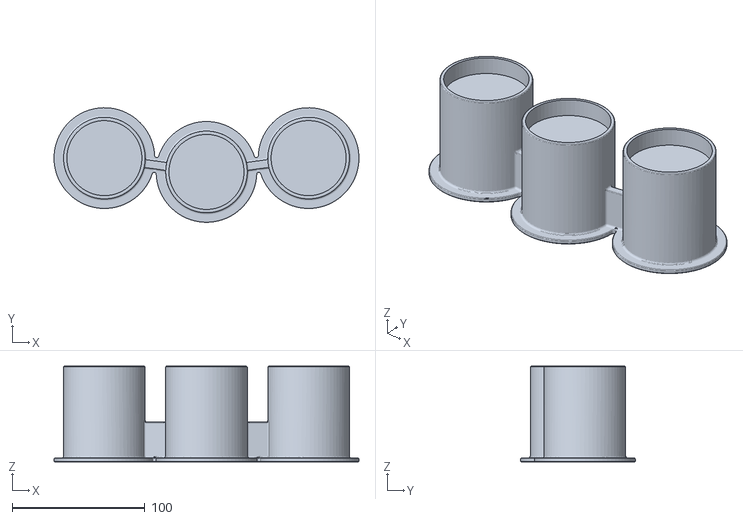
[picture p112: CAD file, 2026-10-17]
exports/prints_v2/RK-03_reagent-rack-freestanding_qty1.stl
230.0 x 86.4 x 72.2
