shaoming11/hh-winners/exports/prints_v2/RK-03_reagent-stand_qty3.stl

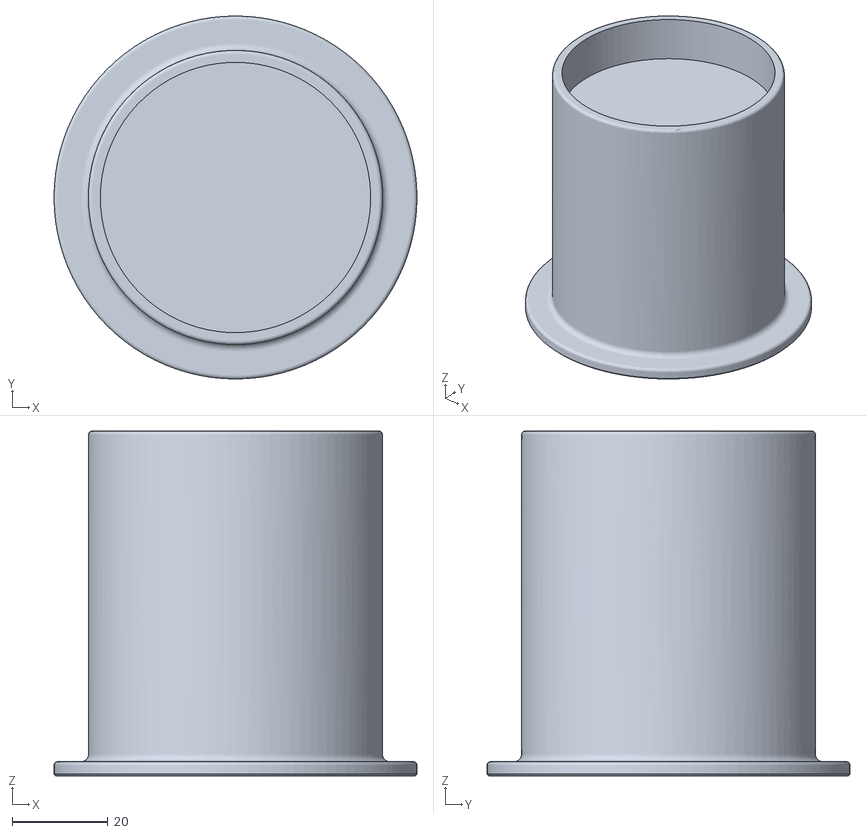
[picture p113: CAD file, 2026-10-17]
exports/prints_v2/RK-03_reagent-stand_qty3.stl
76.0 x 76.0 x 72.2
