shaoming11/hh-winners/exports/prints_v2/ST-14_connecting-rod_qty1.stl

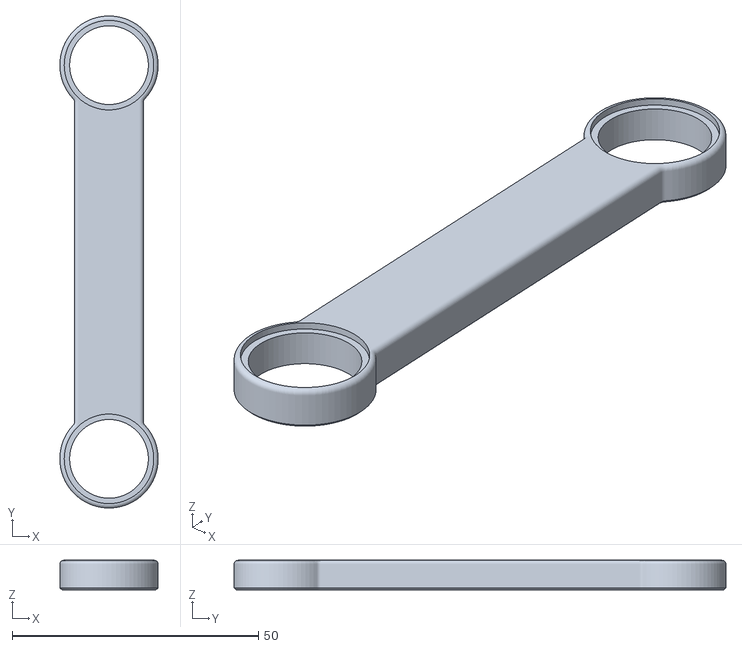
[picture p114: CAD file, 2026-10-17]
exports/prints_v2/ST-14_connecting-rod_qty1.stl
20.0 x 100.0 x 6.00
