shaoming11/hh-winners/exports/prints_v2/JG-02_gap-block-Xfront-Xback-50-R.stl

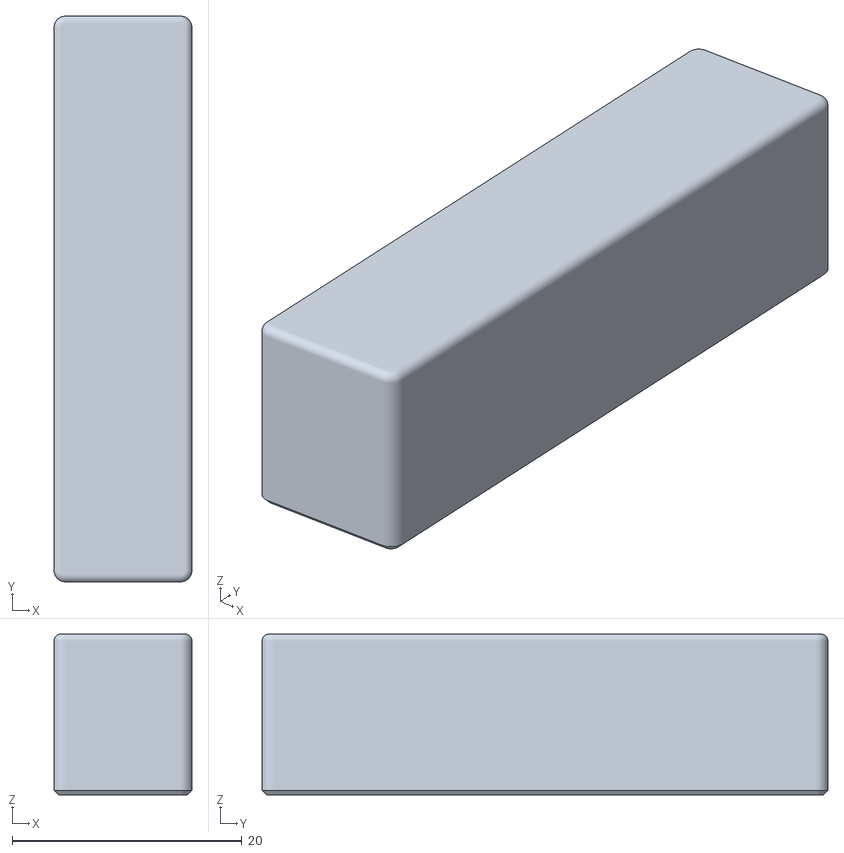
[picture p115: CAD file, 2026-10-17]
exports/prints_v2/JG-02_gap-block-Xfront-Xback-50-R.stl
12.0 x 49.2 x 14.0
