shaoming11/hh-winners/exports/prints_v2/DUMMY-BEAKER-100mL_56x74_qty4.stl

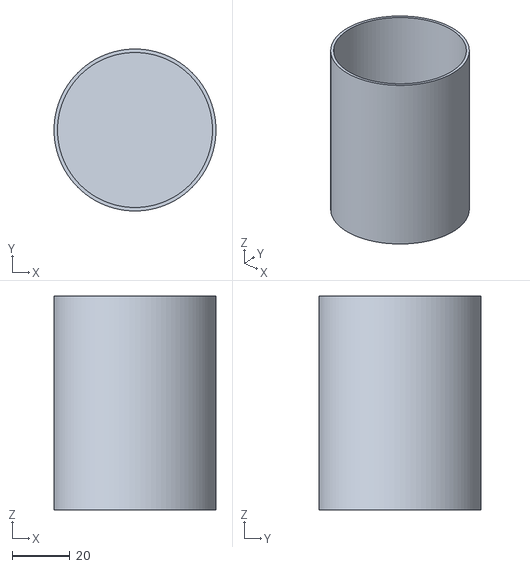
[picture p116: CAD file, 2026-10-17]
exports/prints_v2/DUMMY-BEAKER-100mL_56x74_qty4.stl
56.0 x 56.0 x 74.0
