shaoming11/hh-winners/exports/prints_v2/ST-08_bearing-race-spacer-v2_qty6.stl

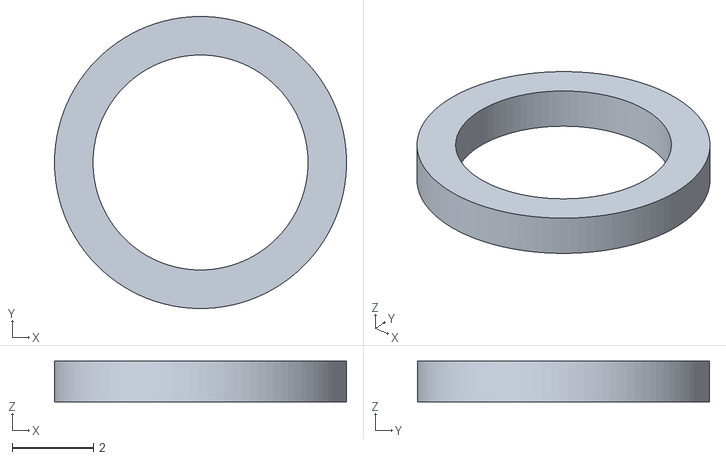
[picture p117: CAD file, 2026-10-17]
exports/prints_v2/ST-08_bearing-race-spacer-v2_qty6.stl
7.20 x 7.20 x 1.00
