shaoming11/hh-winners/(list of files, cad)

Other CAD files:
exports/print_at_BU/2_TT-04_carousel-ring_A1-sliced.gcode.3mf
exports/print_queue_2026-10-15/A1/3_TT-04-v4_carousel-ring_1h42.gcode.3mf
exports/print_at_BU/5_TT-05_turntable-tie-plate_x1.stl
exports/print_queue_2026-10-15/A1/4_RK-04_rack-tie-plate_0h57.gcode.3mf
exports/prints/DH-01_yeast-auger-head-v4_qty1_SUPPORTS.step
exports/plates/X2-4_CAL-02.gcode.3mf
exports/plates/X2-2_TT-04.gcode.3mf
exports/prints/PS-01_auger-post_qty1.step
exports/plates/H2D-3_ST-01-v2.gcode.3mf
exports/prints/WS-02_scale-pan-v2_qty1.step
exports/prints_v2/DH-01_yeast-auger-head-v5_qty1.stl
exports/prints_v2/CAL-02_calibration-probe_qty1.stl
exports/prints/CAL-02_calibration-probe_qty1.step
exports/prints/ST-08_bearing-race-spacer-v2_qty6.step
exports/prints/CAL-01_arm-calibration-block_qty2.step
exports/prints_v2/DH-01_yeast-auger-head-v4_qty1_SUPPORTS.stl
exports/prints/ST-07_catch-well_qty1_PETG.step
exports/prints_v2/GR-02_moving-jaw_qty2_SUPPORTS.stl
exports/prints_v2/GR-01_gripper-body_qty2_SUPPORTS.stl
exports/prints/RK-02_reagent-rack-v2_qty1.step
exports/prints/ST-05_flask-collar_qty1_PETG.step
exports/prints_v2/ST-15_pivot-spacer_qty2.stl
exports/prints_v2/WS-01_scale-base-v3_qty1.stl
exports/prints_v2/ST-07_catch-well_qty1.stl
exports/prints_v2/ST-12_servo-bridge_qty1.stl
exports/prints_v2/GR-03_fin-ray-finger_qty4_TPU.stl
exports/prints_v2/PS-01_auger-post_qty1.stl
exports/assembly/wet-lab-bench_WORK.f3d
exports/plates/H2D-2b_auger-screw-v3x2.gcode.3mf
exports/prints/CAL-01_arm-calibration-block_qty2.stl
exports/prints/DH-02_auger-screw-v3_qty2_SUPPORTS.step
exports/prints/FX-01_E5-joiner-plate_qty1.stl
exports/prints/GR-01_gripper-body_qty2_SUPPORTS.stl
exports/prints/GR-02_moving-jaw_qty2_SUPPORTS.stl
exports/prints/GR-03_fin-ray-finger_qty4_TPU.stl
exports/prints/PS-01_auger-post_qty1.stl
exports/prints/ST-11_stage-sled_qty1_SUPPORTS.stl
exports/prints/ST-12_servo-bridge_qty1.stl
exports/prints/TC-01_bearing-test-coupon_qty1.stl
exports/prints/TL-01_stir-rod-handle_qty2.stl
exports/prints/TT-01_turntable-base-v2_qty1.stl
exports/prints/TT-01_turntable-base_qty1.stl
exports/prints/TT-02_carousel-deck_qty1.stl
exports/prints/TT-03_horn-spacer_qty1.stl
exports/prints/TT-04_beaker-locator-ring-v2_qty1.stl
exports/prints_v2/DH-01_yeast-auger-head-v2_qty1_SUPPORTS.stl
exports/prints_v2/DH-01_yeast-auger-head-v3_qty1_SUPPORTS.stl
exports/prints_v2/DH-02_auger-screw-v2_qty1_SUPPORTS.stl
exports/prints_v2/DH-02_auger-screw-v3_qty2_SUPPORTS.stl
exports/prints_v2/DH-02_auger-screw-v4_qty2.stl
exports/prints_v2/JG-02_gap_block_Xfront-Xback_50_R.stl
exports/prints_v2/JG-05_transfer_base_locator.stl
exports/prints_v2/WS-01_scale-base-v2_qty1.stl
