shaoming11/hh-winners/exports/print_at_BU/README_PRINT_AT_BU.md

# Print at BU, Friday (highest priority first)

Settings for any FDM printer: PLA, 0.2 mm layers (0.28 mm is fine for the stands, tie plates and jigs), 3 walls, 15–20 % infill.
**Supports only where noted.** Keep the STL orientation; it's already print-ready.

| # | File | Qty | Supports | ~Time (Bambu) | Why |
|---|---|---|---|---|---|
| 1 | `1_GR-01_gripper-body_PRINT-x2_oriented.stl` | **2** | **Tree, 30°** | ~3–3.5 h for both | The gripper bodies the TPU fingers clip onto. **Without these the arms can't grip.** For orientation, see `1_REFERENCE_...3mf`. |
| 2 | `2_TT-04_carousel-ring_x1.stl` (or the A1-sliced 3mf) | 1 | none | ~1 h 45 m | 4-pocket carousel ring for the 100 mL beakers |
| 3 | `3_RK-03v2_reagent-stand_PRINT-x2.stl` | **2** (1 printed at home) | none | ~50 min each | Holds the reagent beakers at the verified height |
| 4 | `4_RK-04_rack-tie-plate_x1.stl` | 1 | none | ~1 h | Locks the 3 stands to the Y-left rail (2 × M4x10 + T-nuts) |
| 5 | `5_TT-05_turntable-tie-plate_x1.stl` | 1 | none | ~1 h 10 m | Locks the carousel + auger unit to the Y-right rail (2 × M4x10 + T-nuts) |
| 6 | `6_ST-07_catch-well_x1_ONLY-IF-NOT-PACKED.stl` | 1 | none (vase mode OK) | 54 min vase | Foam catch well. Skip it if the home print came along. |
| 7 | `7_jigs/` (JG-01L/R, 02L/R, 03, 04, 05, 06, 07, 08, 10) | 1 each | none | ~1.5 h total | Alignment jigs that set the frame/station positions. **Fallback:** 122 mm and 50 mm spacers cut from scrap, plus a 7 mm hex key. |

Already printed (bring from home):
- PS-01, DH-01 v5, DH-02 ×2
- GR-02 jaws ×2, GR-03 TPU fingers ×4
- ST-11..15 stage set, ST-08 ×6, ST-05 collar
- WS-01 v4, WS-02 v3
- TT-01 v2, TT-02 deck, TT-03 spacer
- CAL-02
- 1 × RK-03v2 stand
