shaoming11/hh-winners/docs/build_img/arm_zero_pose.png

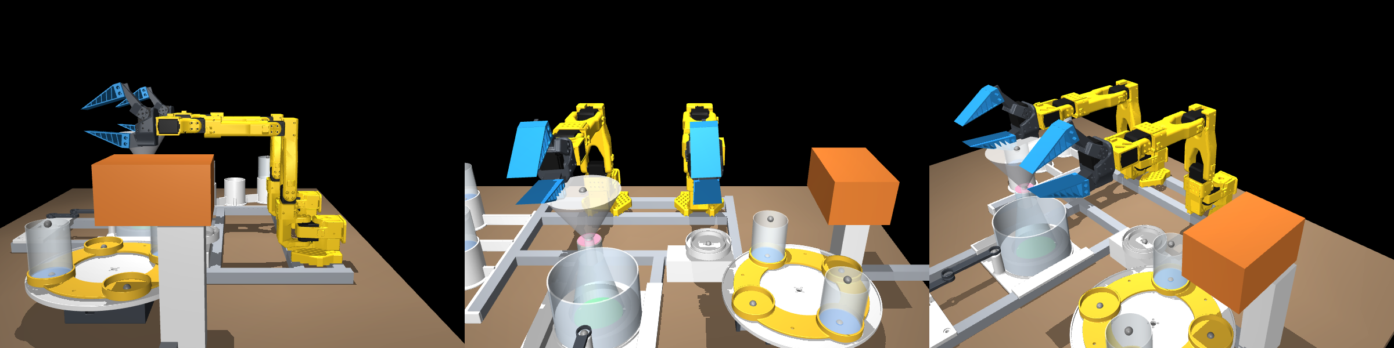
docs/build_img/arm_zero_pose.png
