shaoming11/hh-winners/docs/build_img/dh01_bore_cuts.png

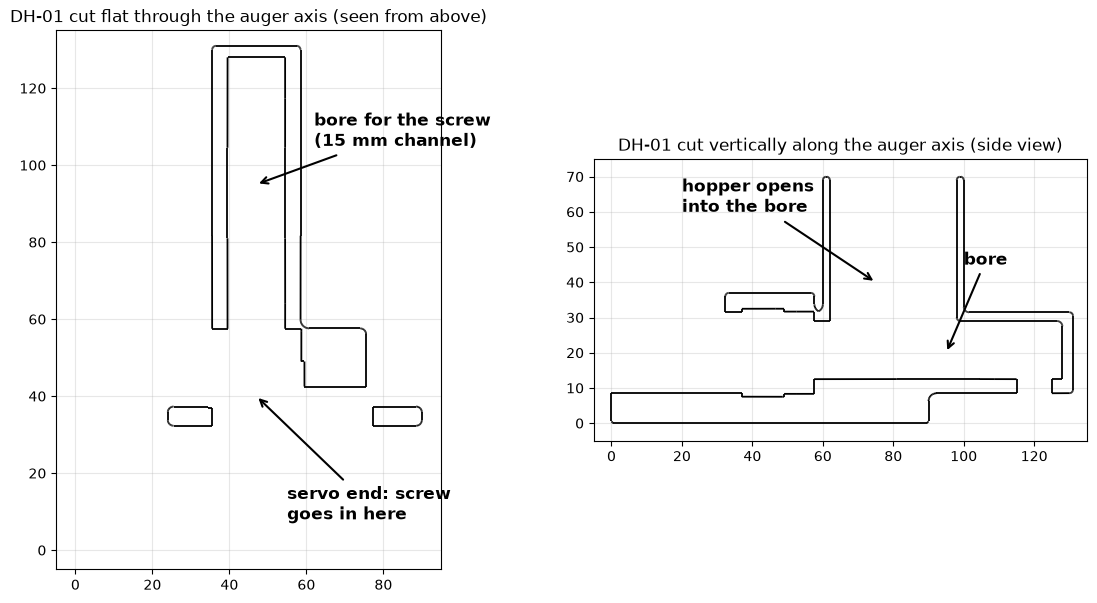
docs/build_img/dh01_bore_cuts.png
