shaoming11/hh-winners/docs/build_img/jg03_alone.png

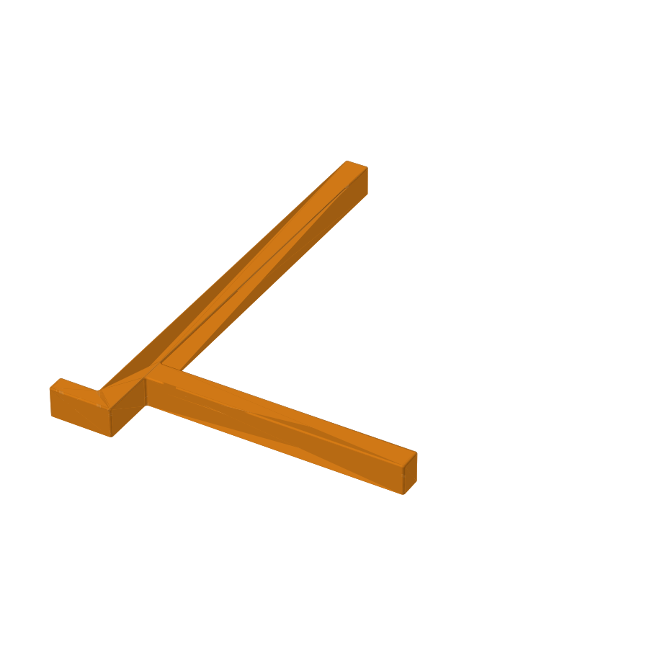
docs/build_img/jg03_alone.png
