shaoming11/hh-winners/docs/build_img/jg03_in_place.png

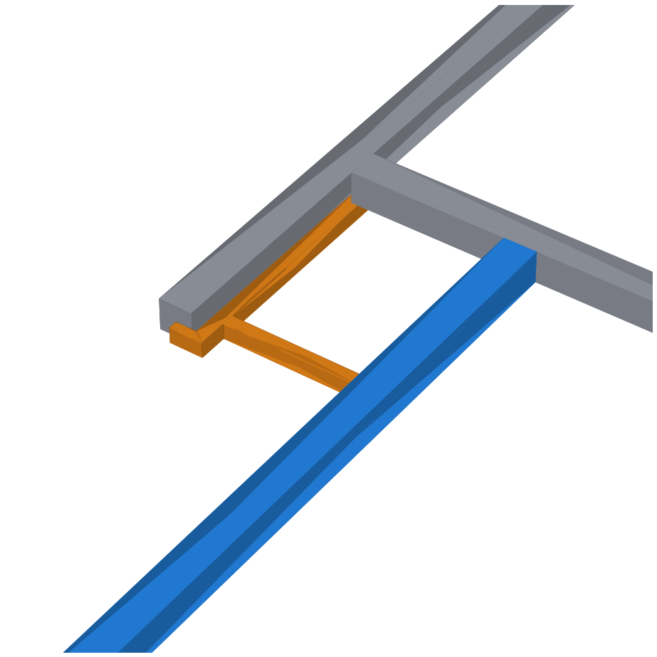
docs/build_img/jg03_in_place.png
