shaoming11/hh-winners/docs/build_img/jg10_in_place.png

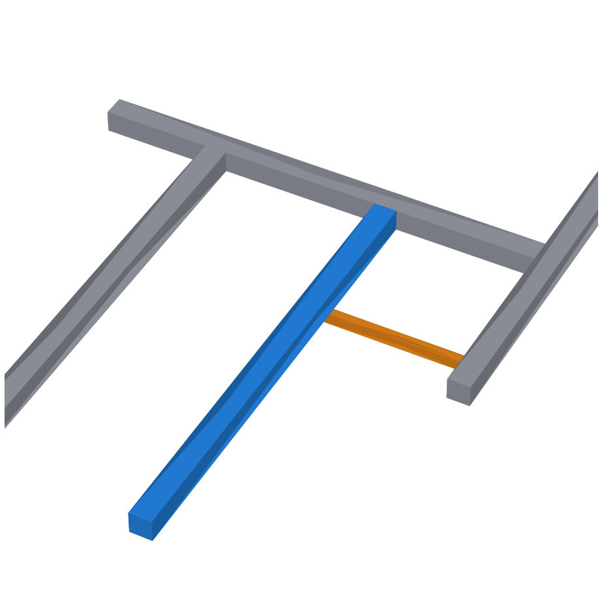
docs/build_img/jg10_in_place.png
