shaoming11/hh-winners/docs/build_img/lego/auger_1.png

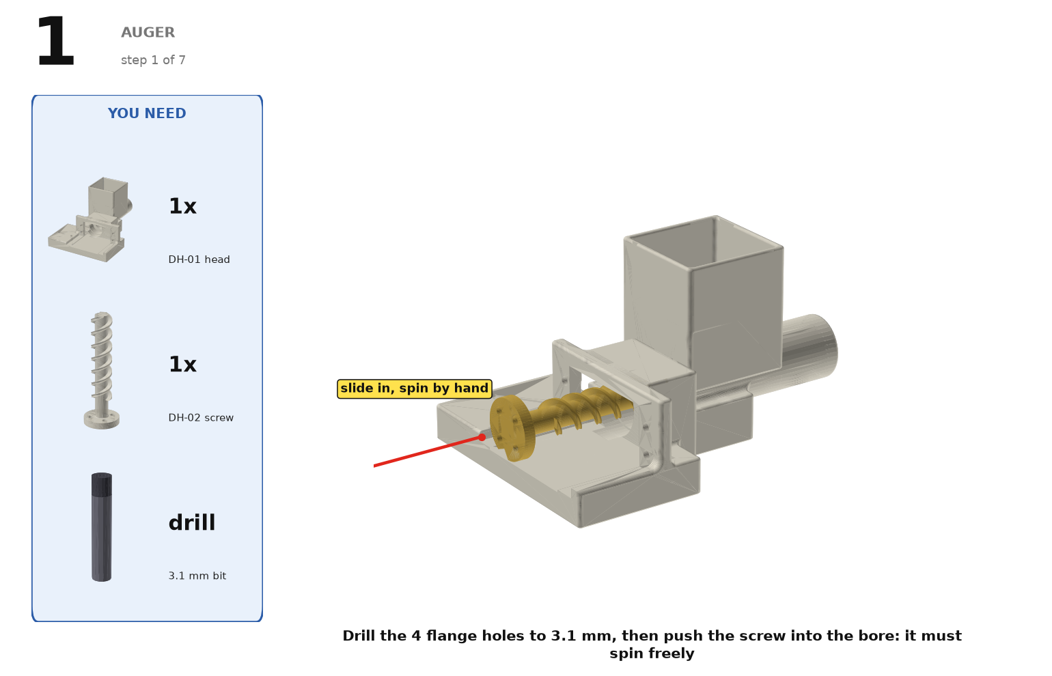
docs/build_img/lego/auger_1.png
