shaoming11/hh-winners/docs/build_img/lego/auger_4.png

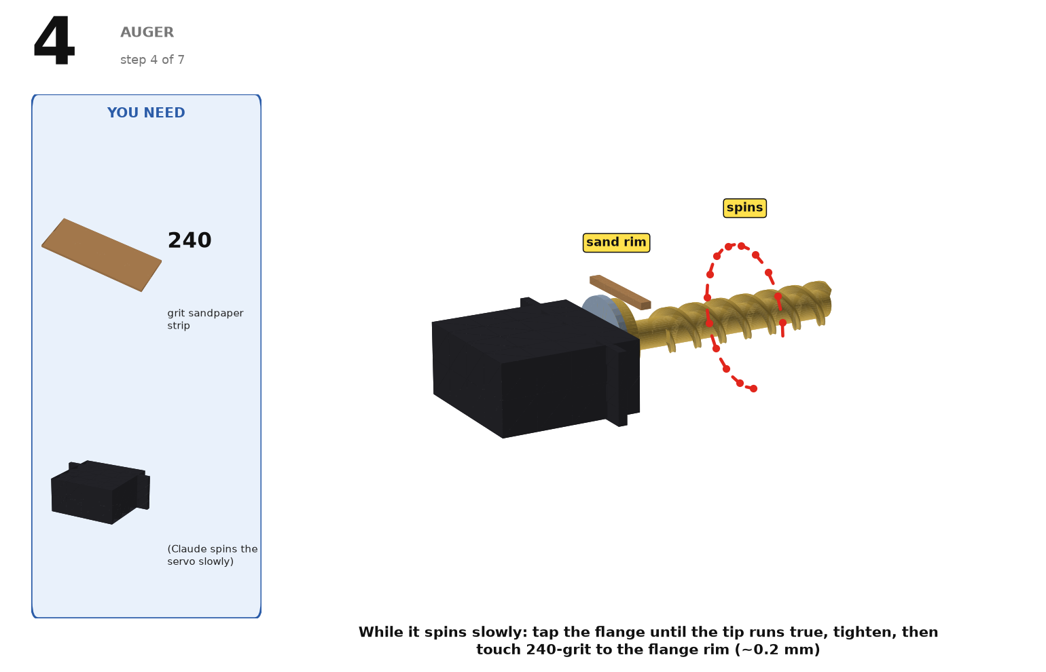
docs/build_img/lego/auger_4.png
