shaoming11/hh-winners/docs/build_img/lego/auger_5.png

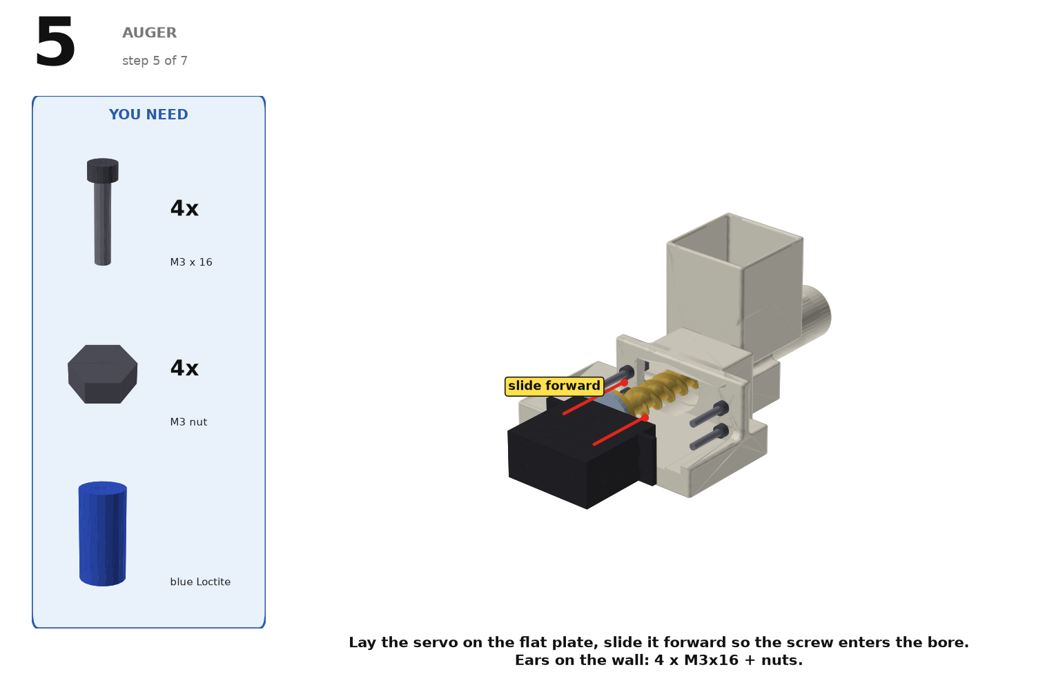
docs/build_img/lego/auger_5.png
