shaoming11/hh-winners/docs/build_img/lego/auger_6.png

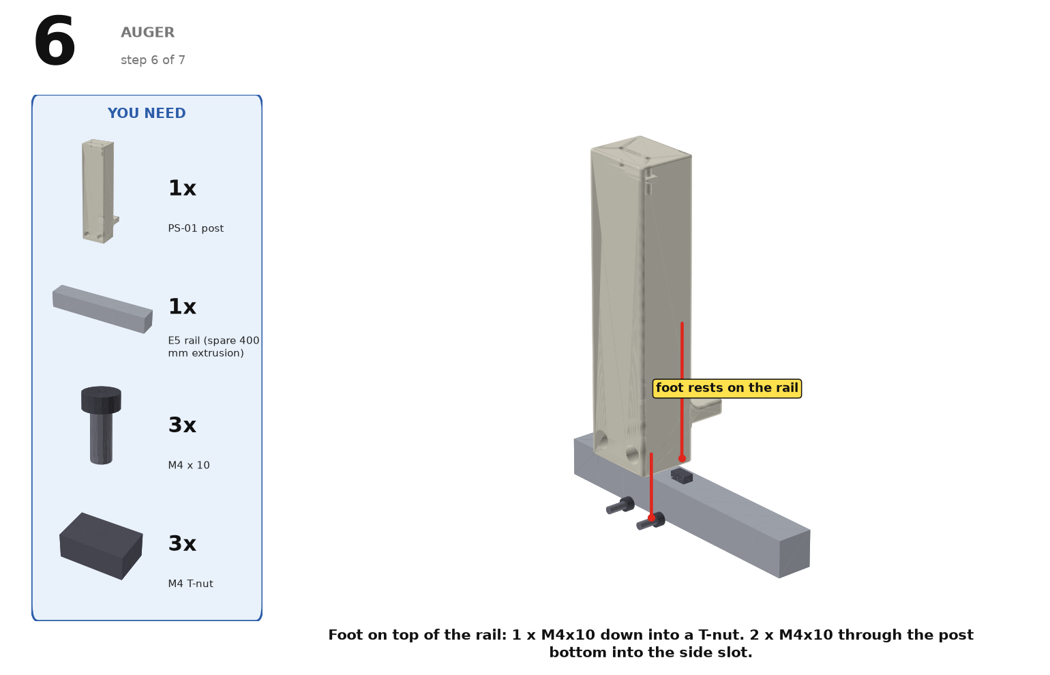
docs/build_img/lego/auger_6.png
