shaoming11/hh-winners/docs/build_img/lego/auger_7.png

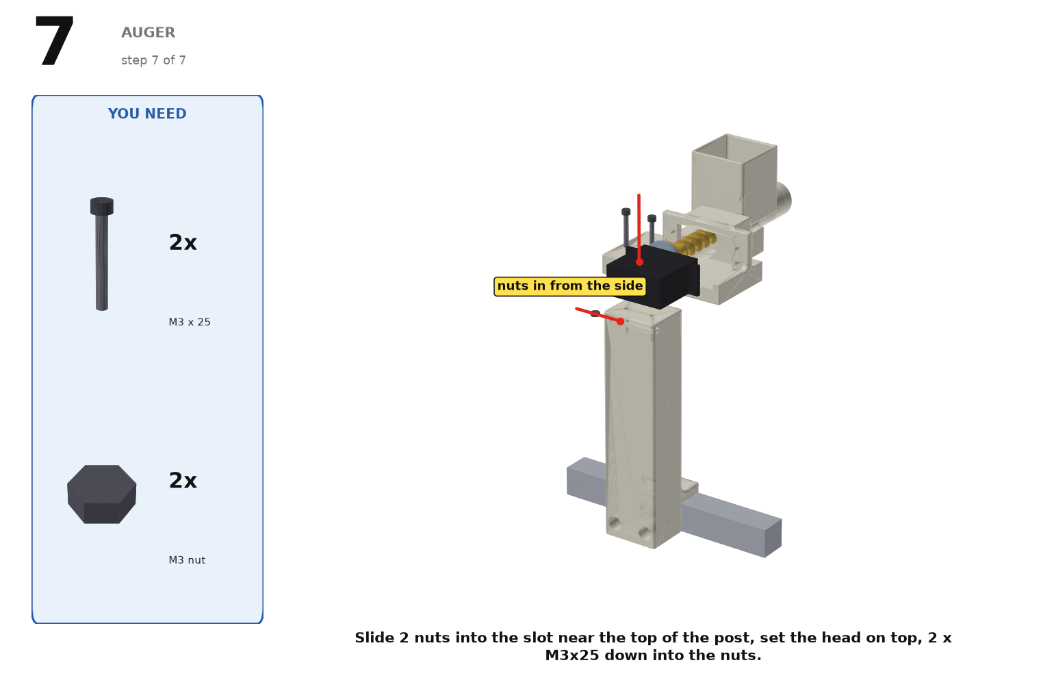
docs/build_img/lego/auger_7.png
