shaoming11/hh-winners/docs/build_img/lego/auger_w3.png

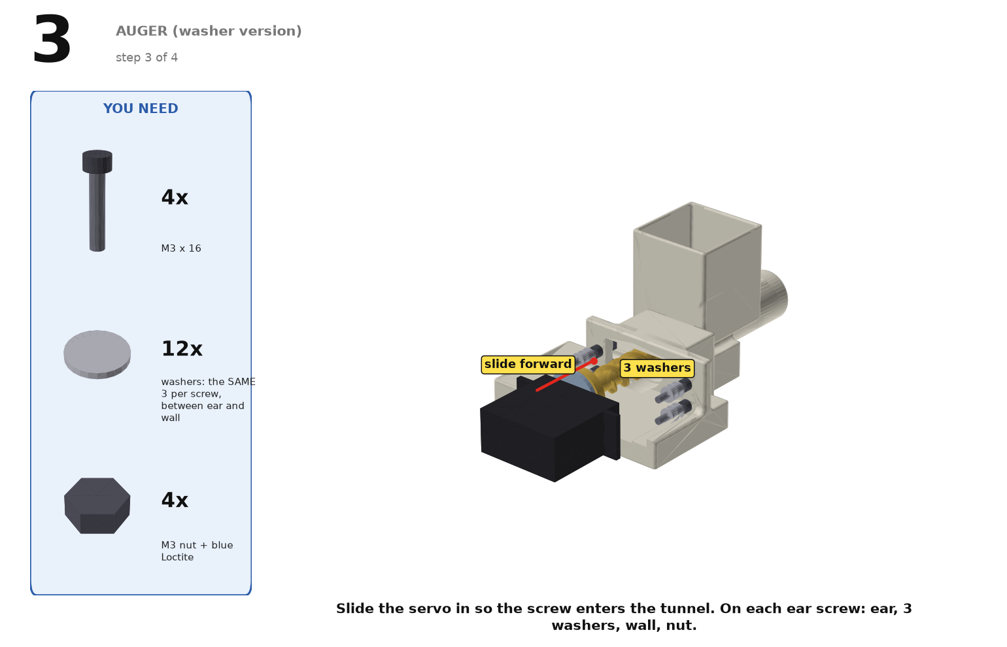
docs/build_img/lego/auger_w3.png
