shaoming11/hh-winners/docs/build_img/lego/auger_w4.png

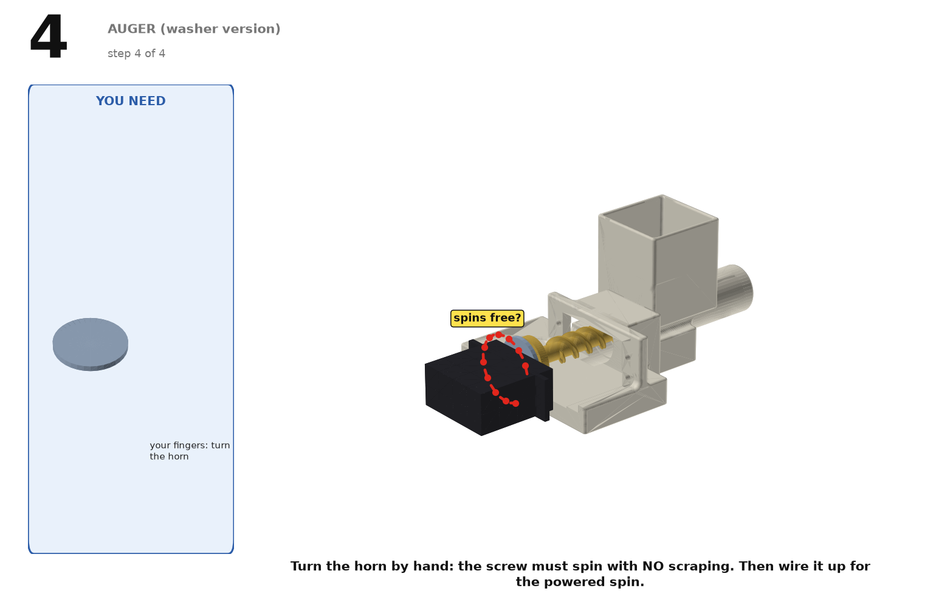
docs/build_img/lego/auger_w4.png
