shaoming11/hh-winners/docs/build_img/lego/saddle_3.png

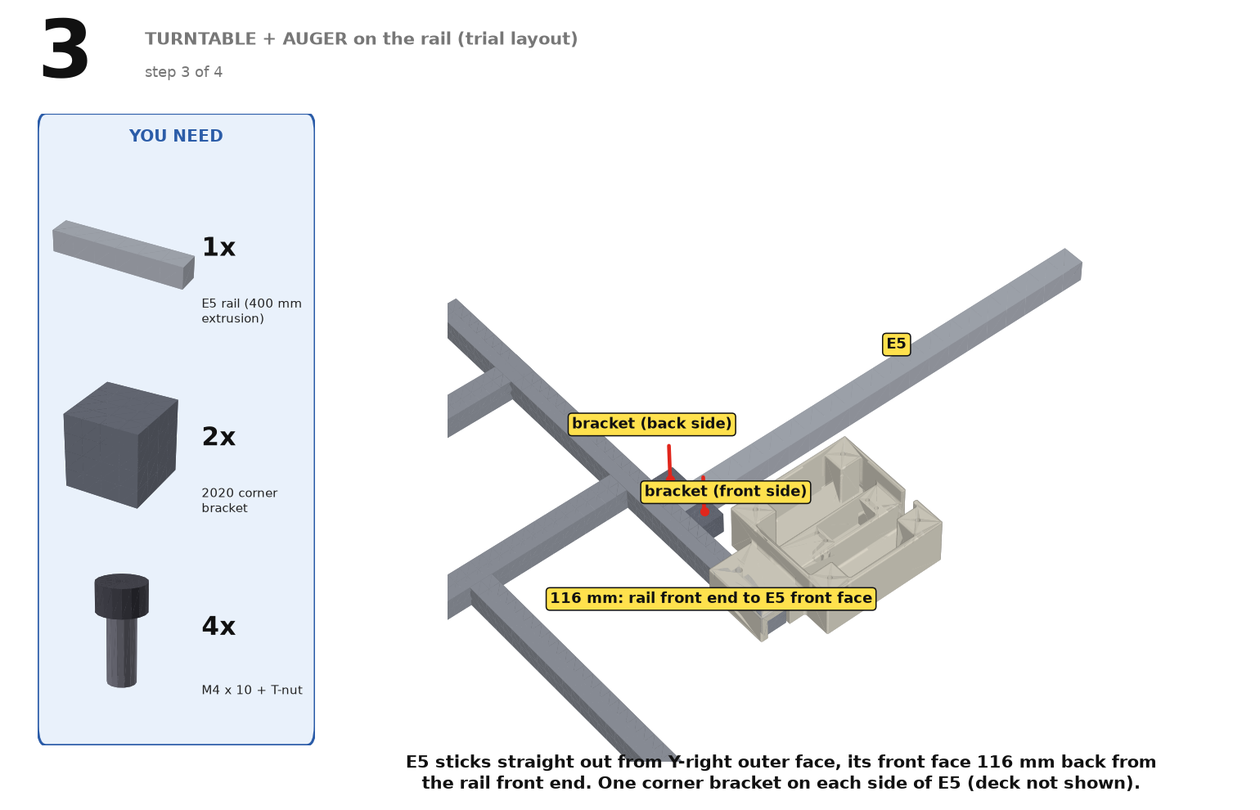
docs/build_img/lego/saddle_3.png
