shaoming11/hh-winners/docs/build_img/lego/saddle_4.png

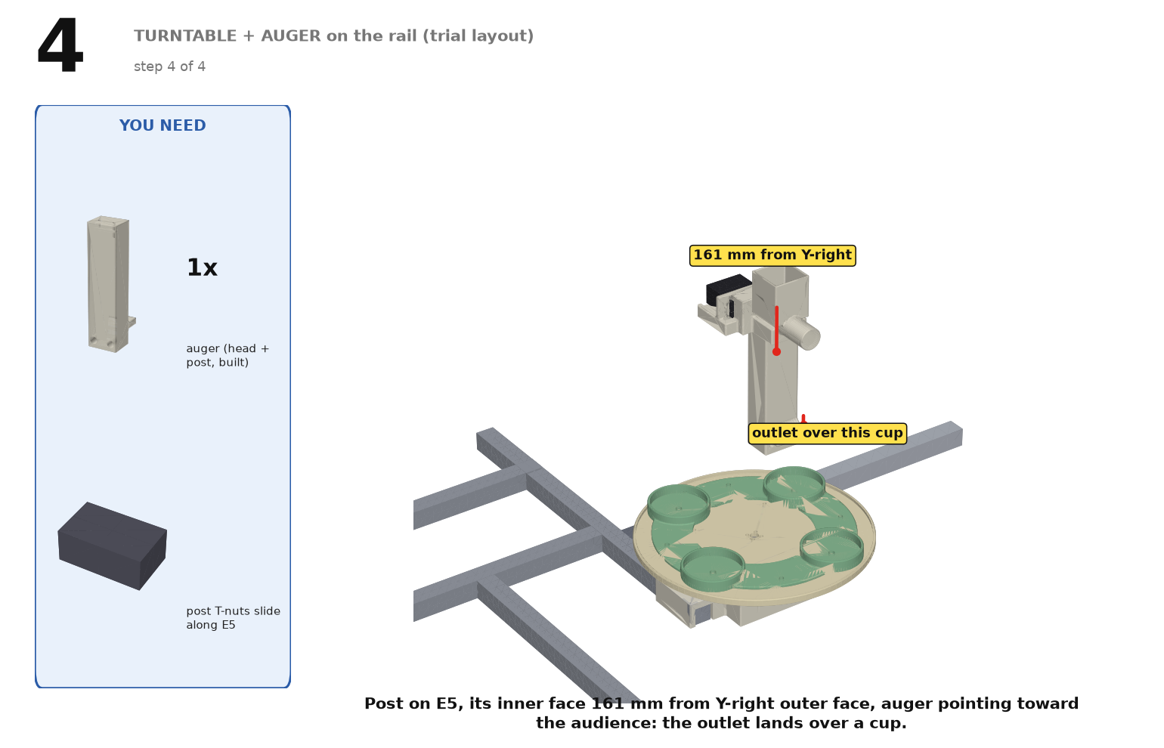
docs/build_img/lego/saddle_4.png
