shaoming11/hh-winners/docs/build_img/lego/zero_pick.png

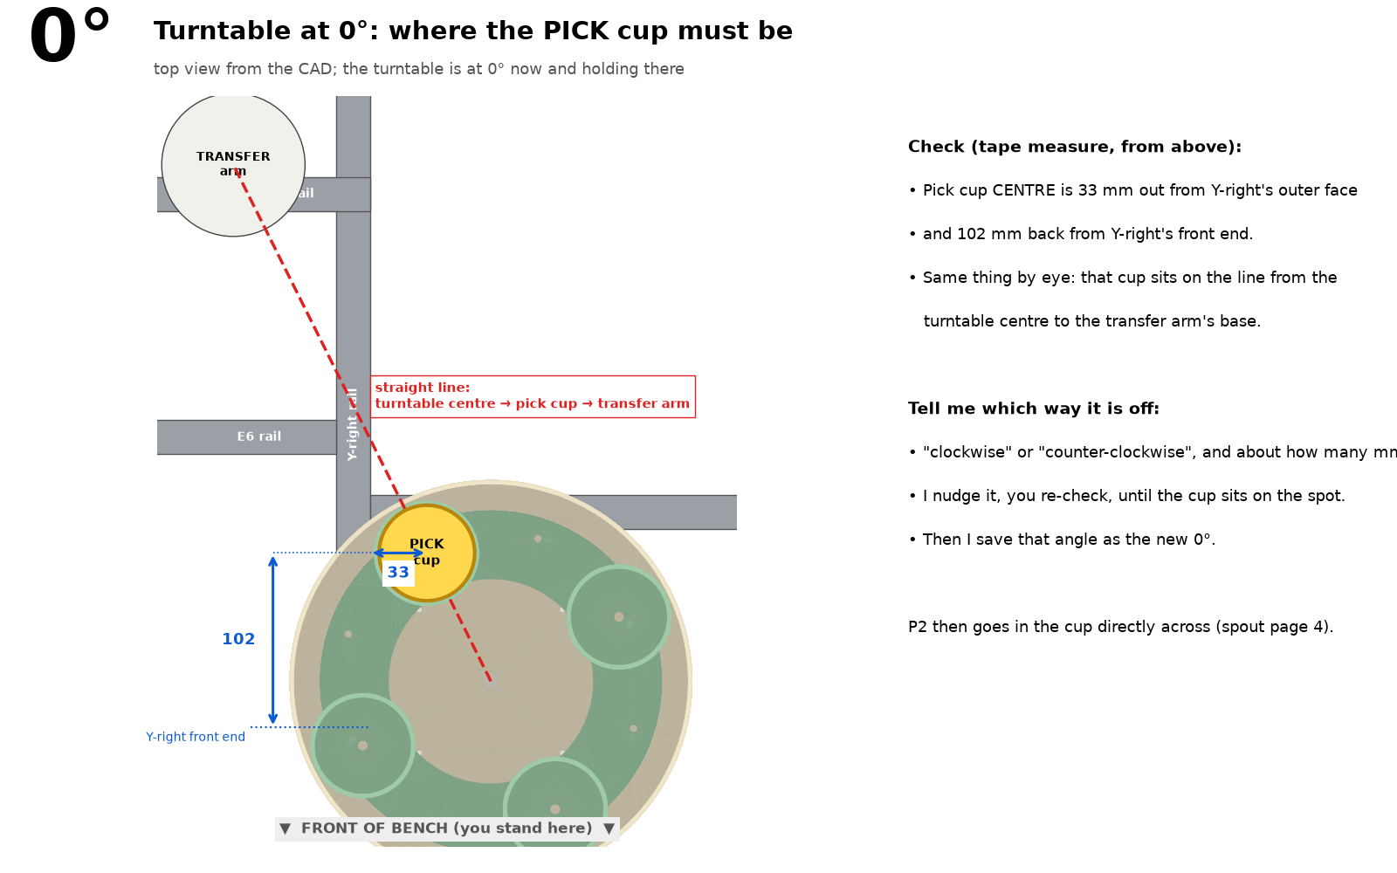
docs/build_img/lego/zero_pick.png
