shaoming11/hh-winners/docs/build_img/lego_A_horn.png

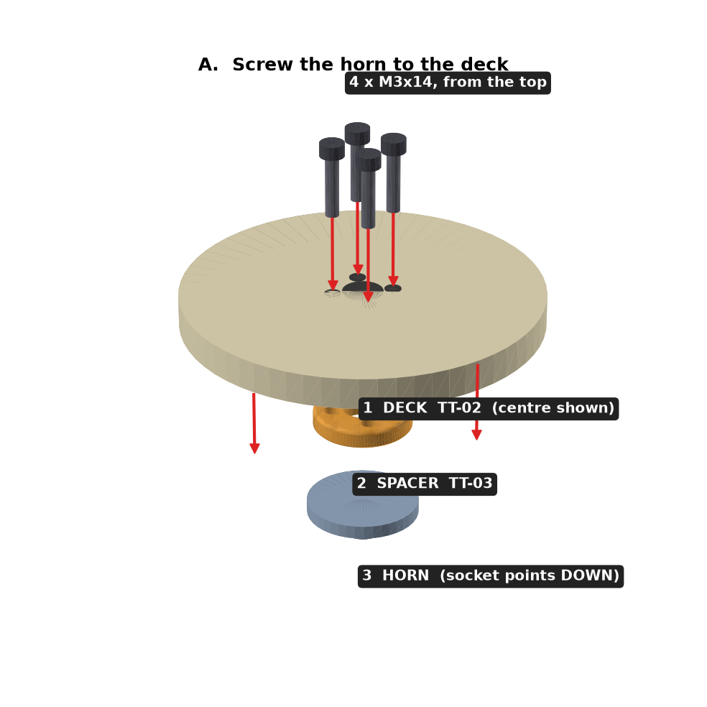
docs/build_img/lego_A_horn.png
