shaoming11/hh-winners/docs/build_img/lego_B_ring.png

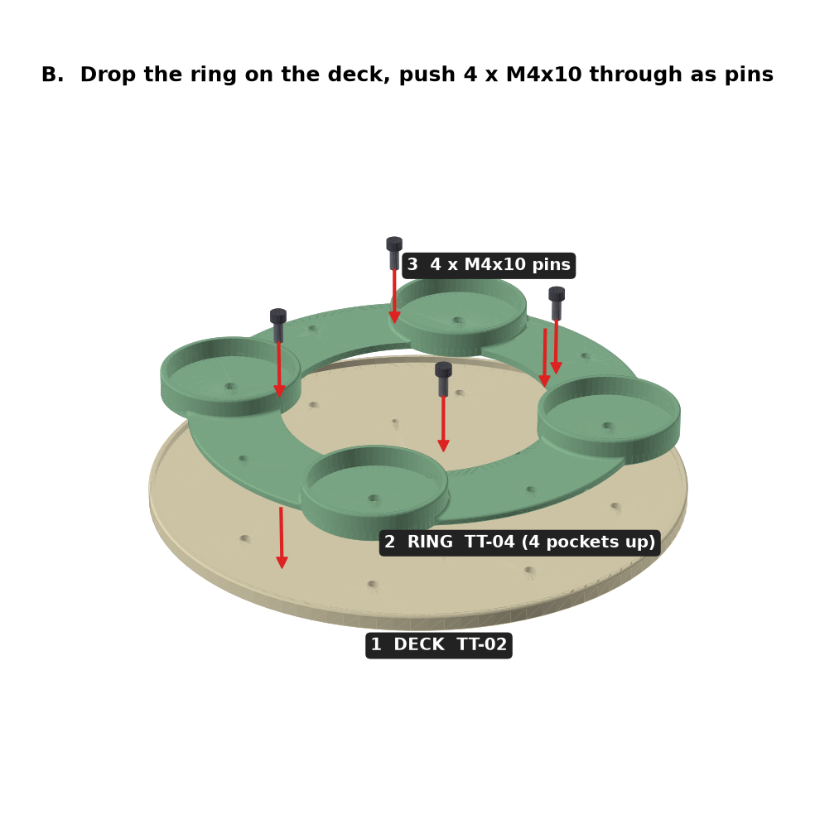
docs/build_img/lego_B_ring.png
