shaoming11/hh-winners/docs/build_img/part_dh01.png

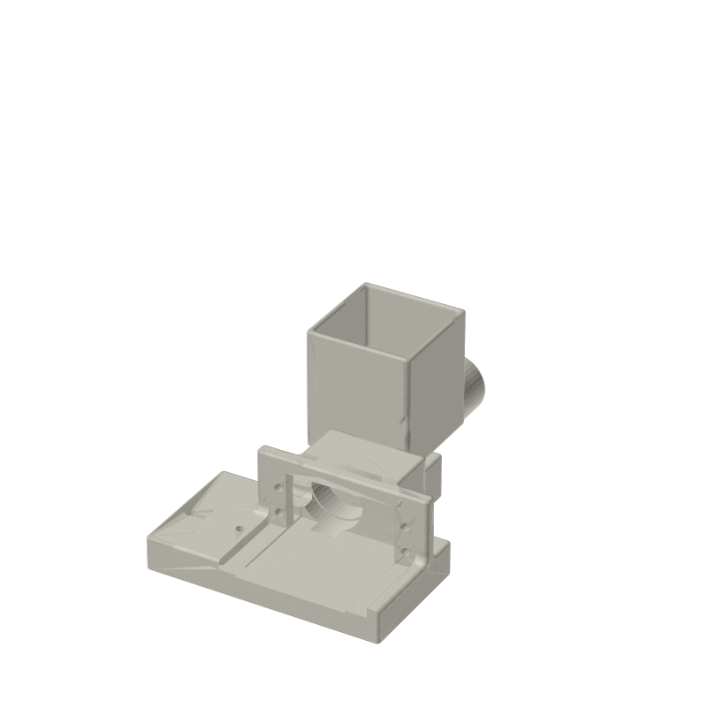
docs/build_img/part_dh01.png
