shaoming11/hh-winners/docs/build_img/part_dh02.png

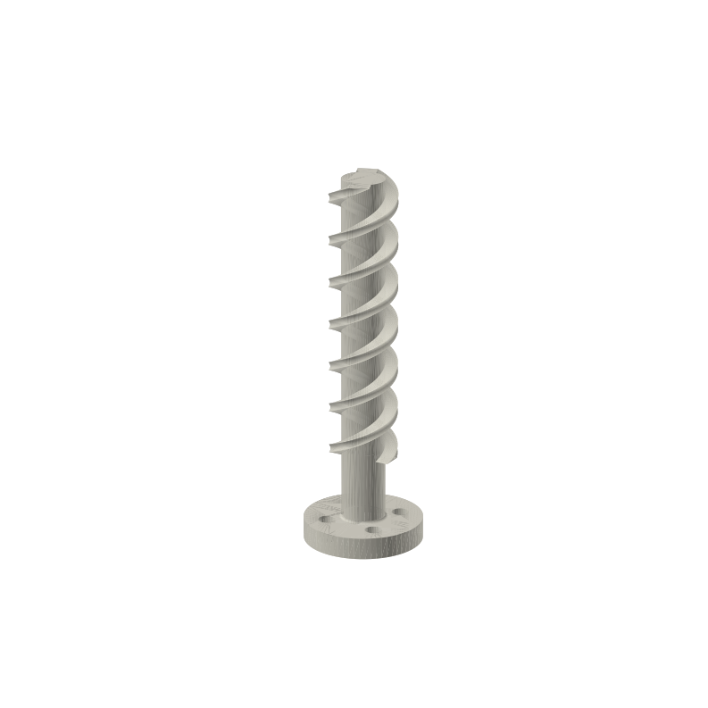
docs/build_img/part_dh02.png
