shaoming11/hh-winners/docs/build_img/rack_1_tieplate.png

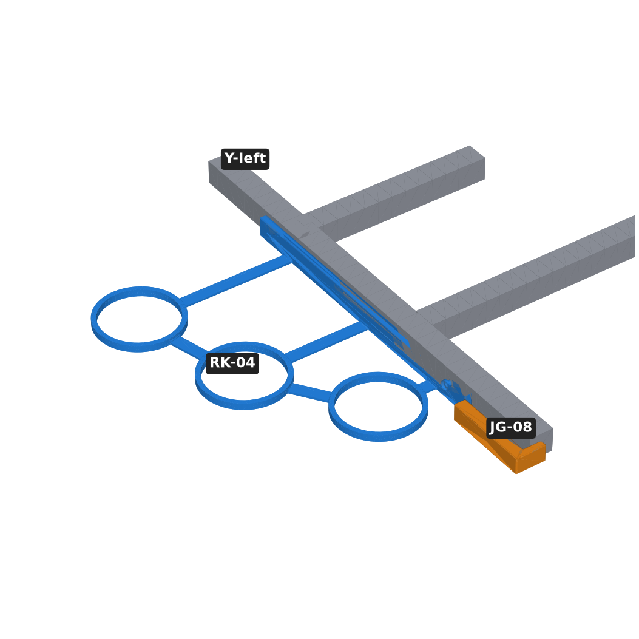
docs/build_img/rack_1_tieplate.png
