shaoming11/hh-winners/docs/build_img/spout/spout_1_developer.png

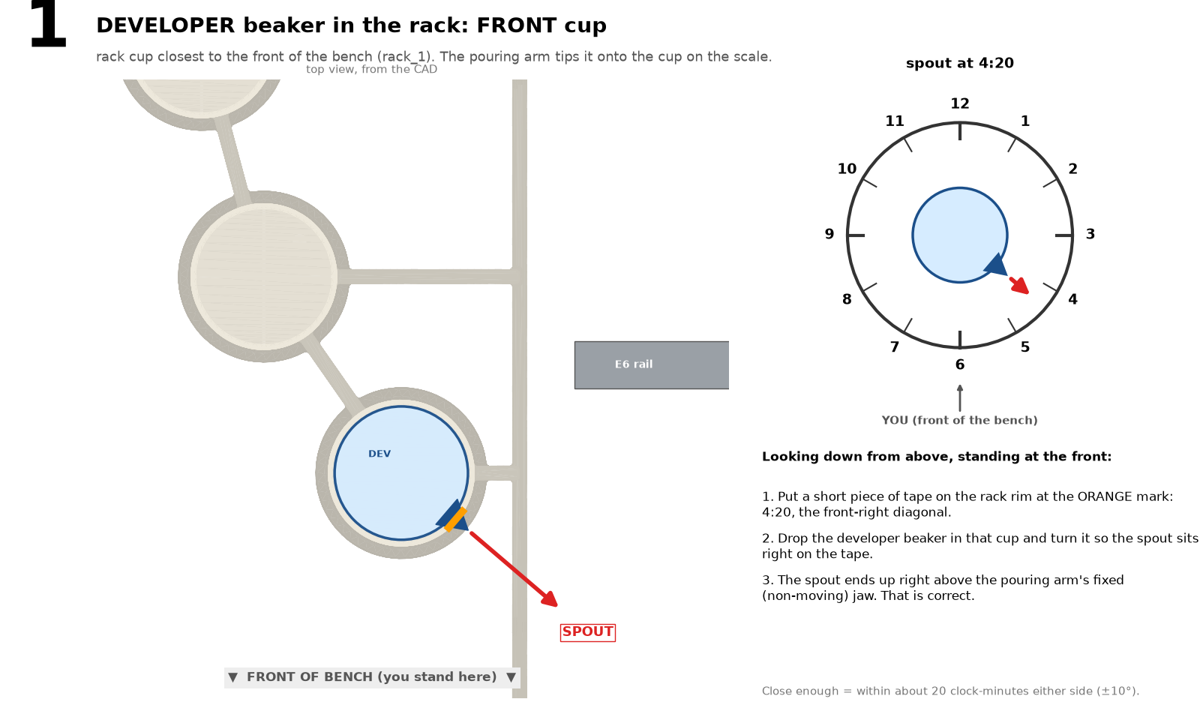
docs/build_img/spout/spout_1_developer.png
