shaoming11/hh-winners/docs/build_img/spout/spout_2_water.png

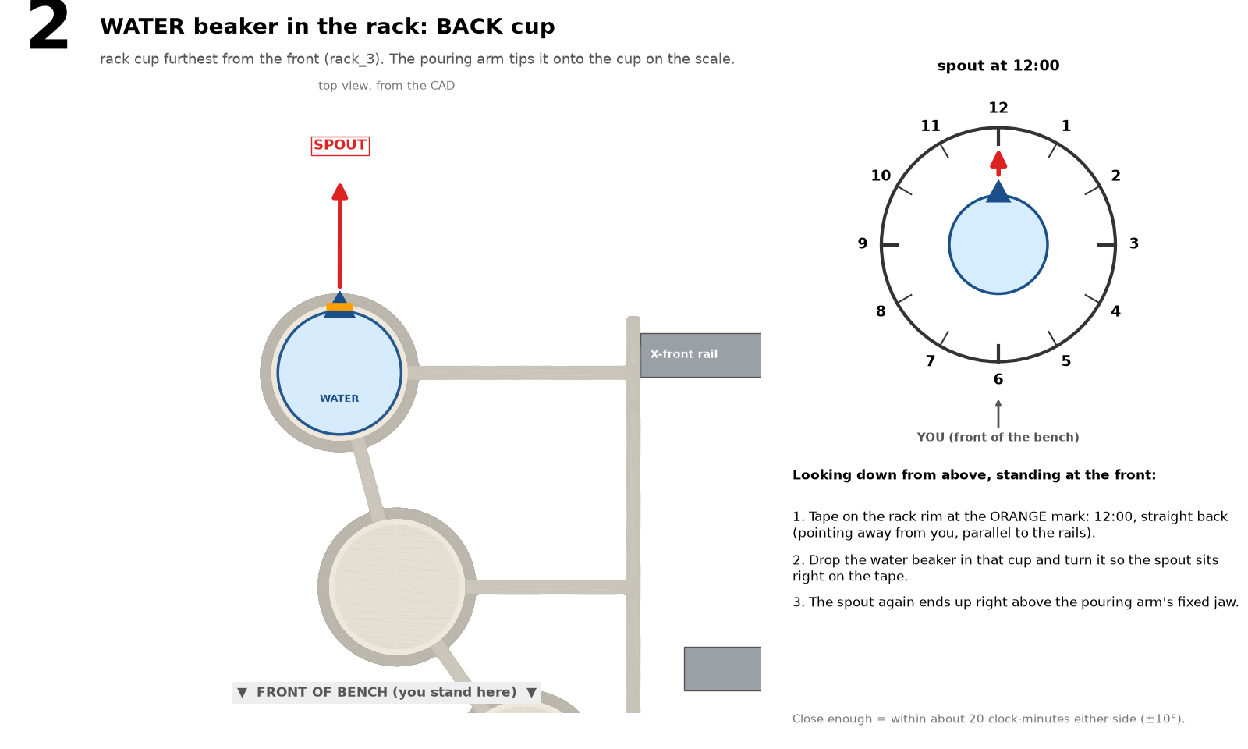
docs/build_img/spout/spout_2_water.png
