shaoming11/hh-winners/docs/build_img/spout/spout_4_P2.png

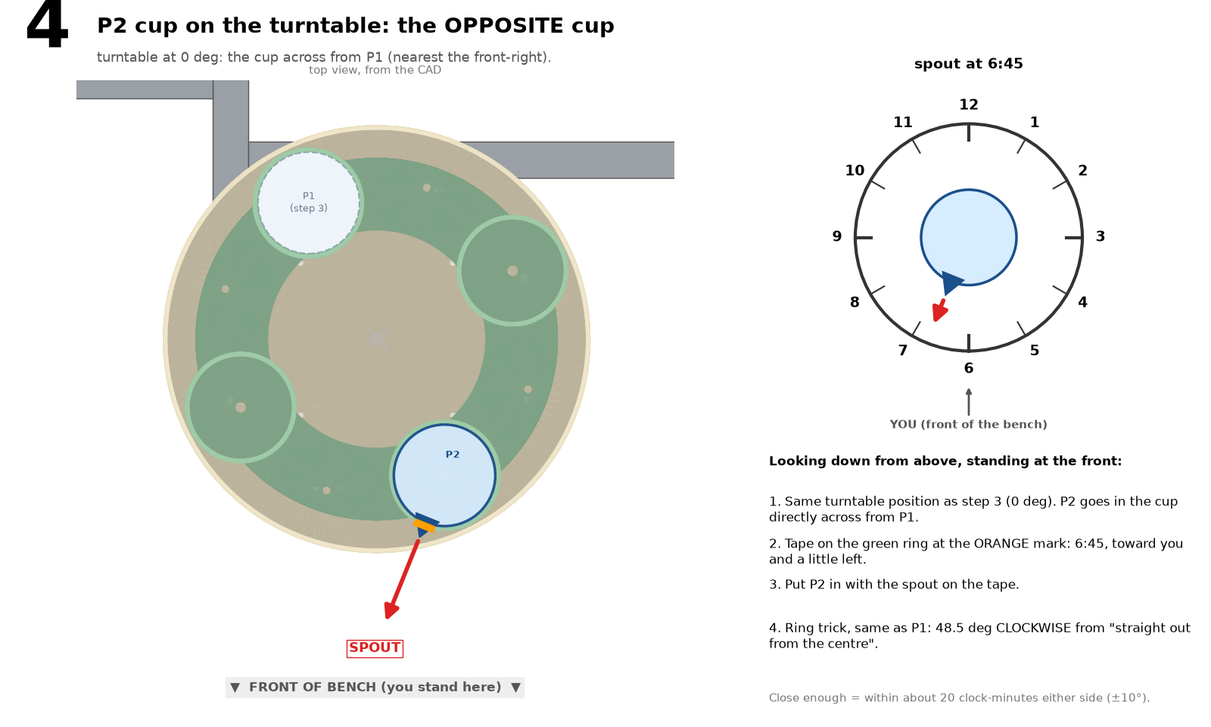
docs/build_img/spout/spout_4_P2.png
