shaoming11/hh-winners/docs/build_img/stage_1_bridge.png

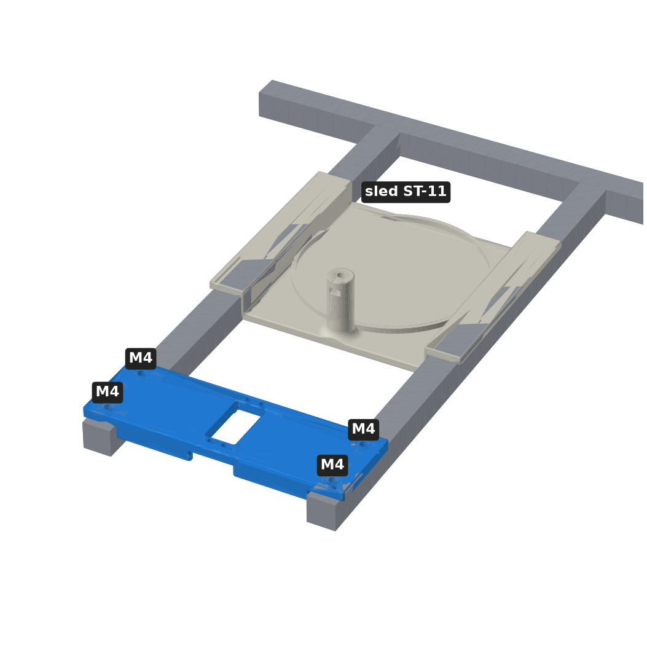
docs/build_img/stage_1_bridge.png
