shaoming11/hh-winners/docs/build_img/tt01_alone.png

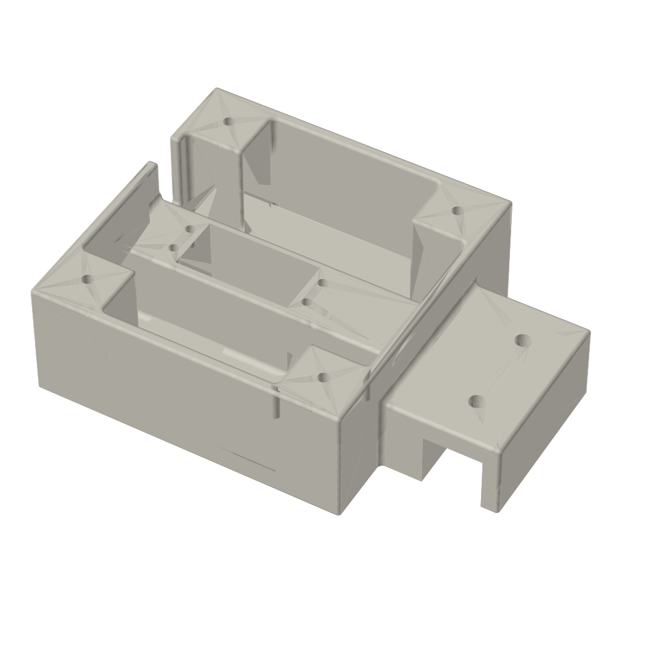
docs/build_img/tt01_alone.png
