shaoming11/hh-winners/docs/build_img/tt1_servo_orientation.png

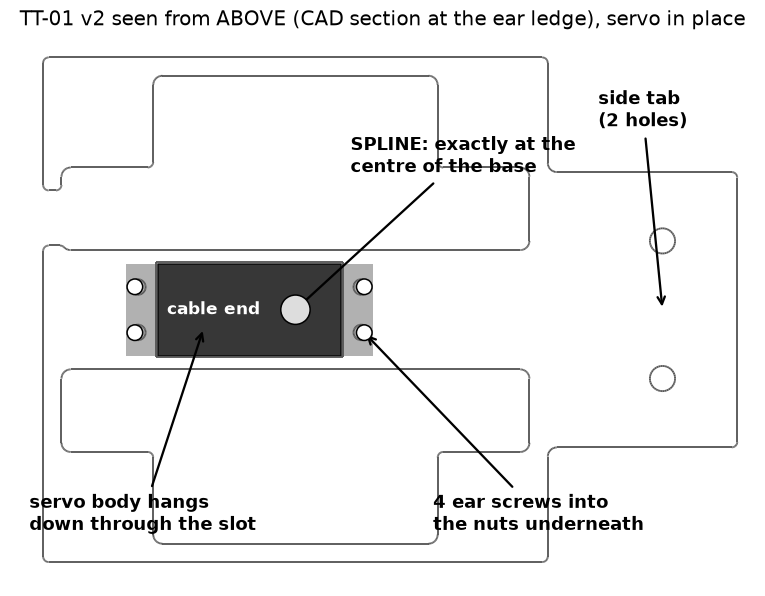
docs/build_img/tt1_servo_orientation.png
