shaoming11/hh-winners/docs/build_img/tt1_step1_servo.png

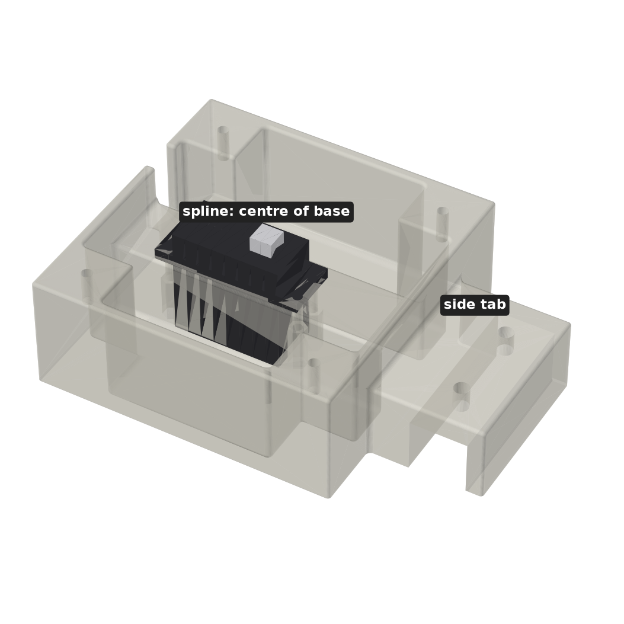
docs/build_img/tt1_step1_servo.png
