shaoming11/hh-winners/docs/build_img/tt01_top.png

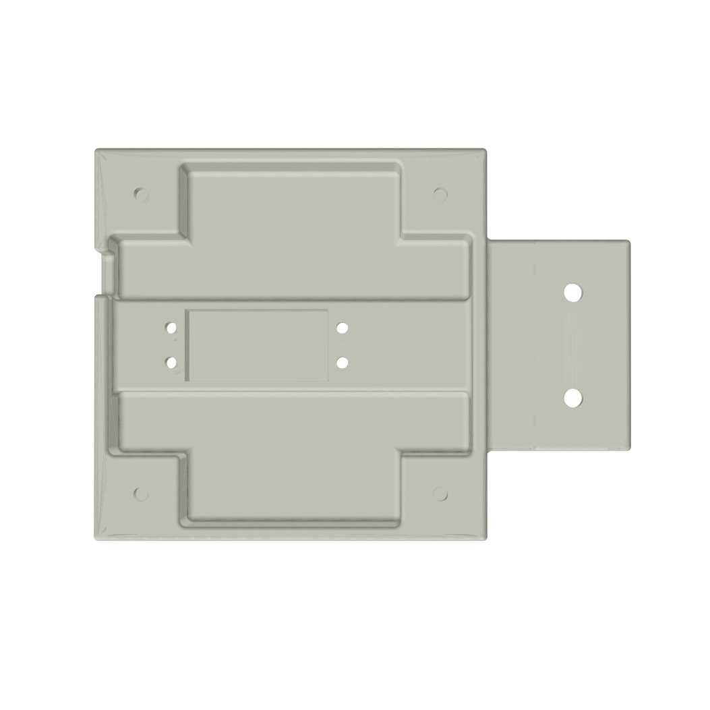
docs/build_img/tt01_top.png
