shaoming11/hh-winners/docs/build_img/tt01_v1_bottom.png

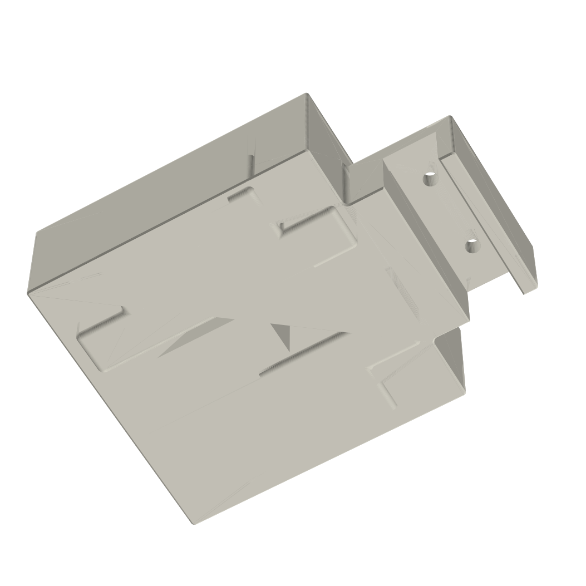
docs/build_img/tt01_v1_bottom.png
