shaoming11/hh-winners/docs/build_img/tt01_v1_top.png

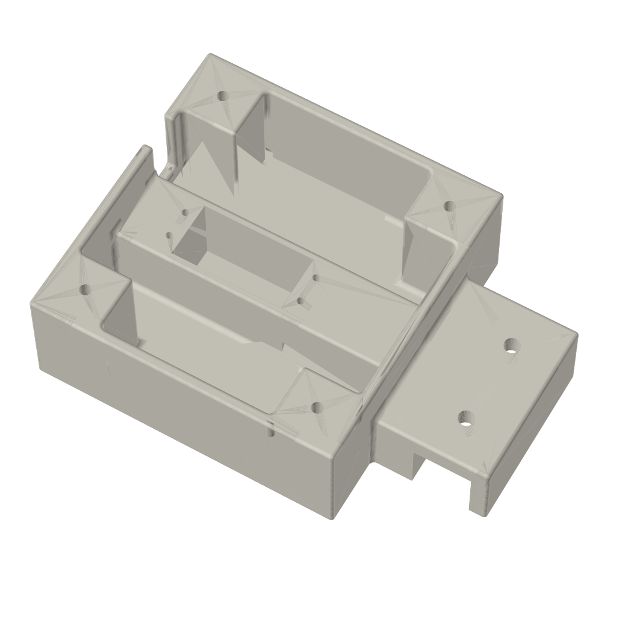
docs/build_img/tt01_v1_top.png
