shaoming11/hh-winners/docs/build_img/tt02_centre_z0side.png

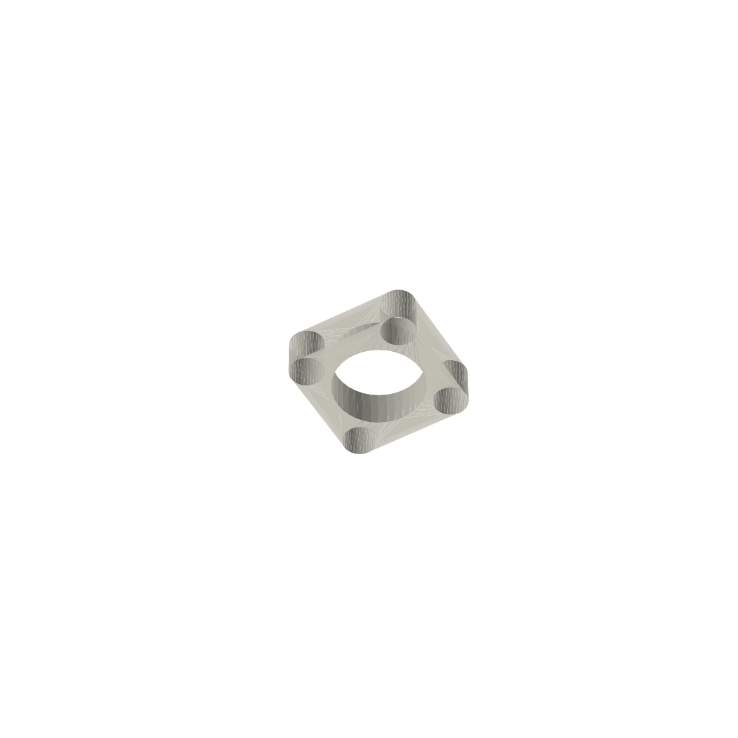
docs/build_img/tt02_centre_z0side.png
