shaoming11/hh-winners/docs/build_img/tt2_lazy_susan.png

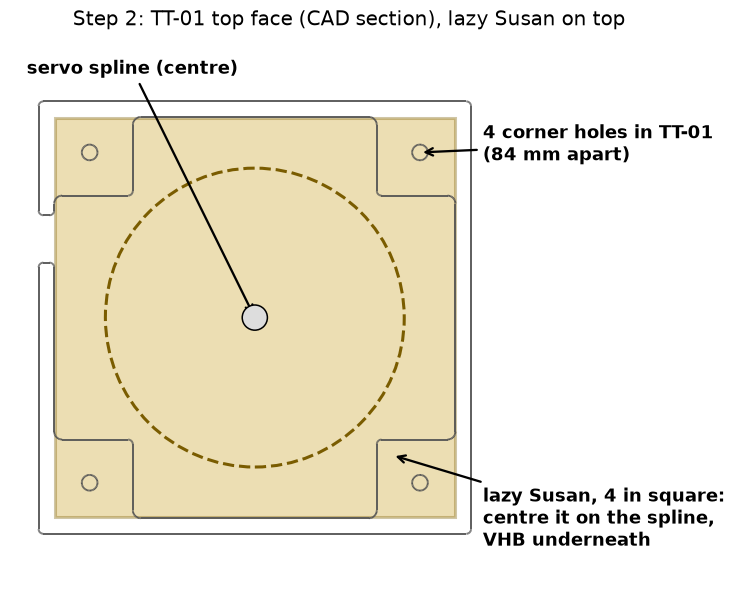
docs/build_img/tt2_lazy_susan.png
