shaoming11/hh-winners/docs/build_img/tt02_top.png

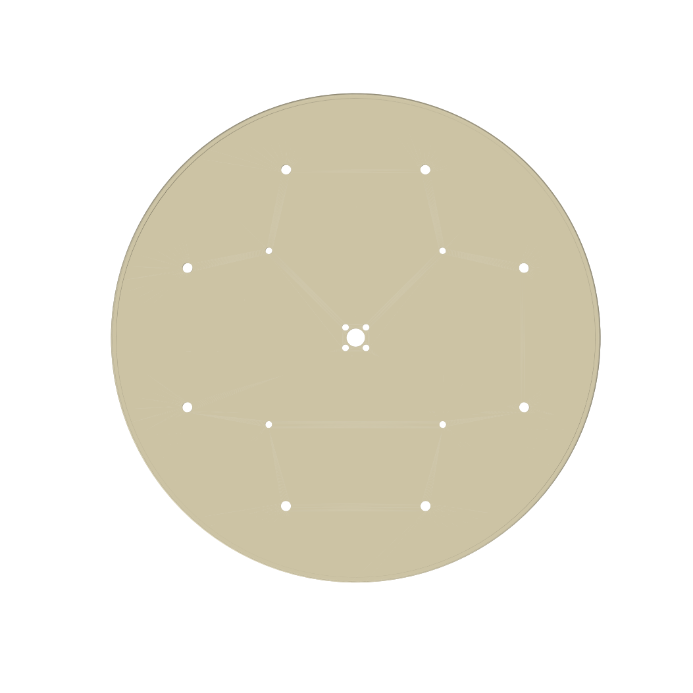
docs/build_img/tt02_top.png
