shaoming11/hh-winners/docs/build_img/tt03_spacer.png

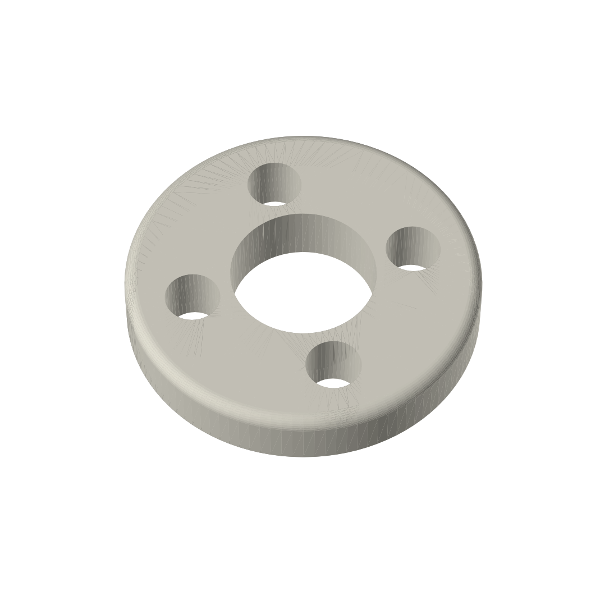
docs/build_img/tt03_spacer.png
