shaoming11/hh-winners/docs/build_img/tt3_stack.png

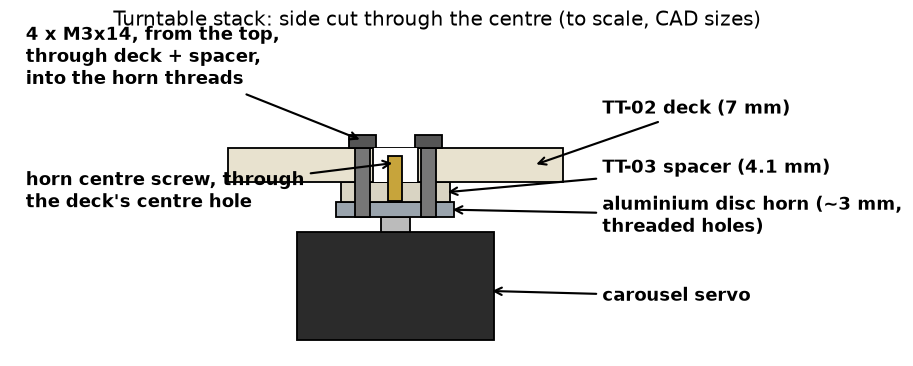
docs/build_img/tt3_stack.png
