shaoming11/hh-winners/docs/build_img/tt04_bottom.png

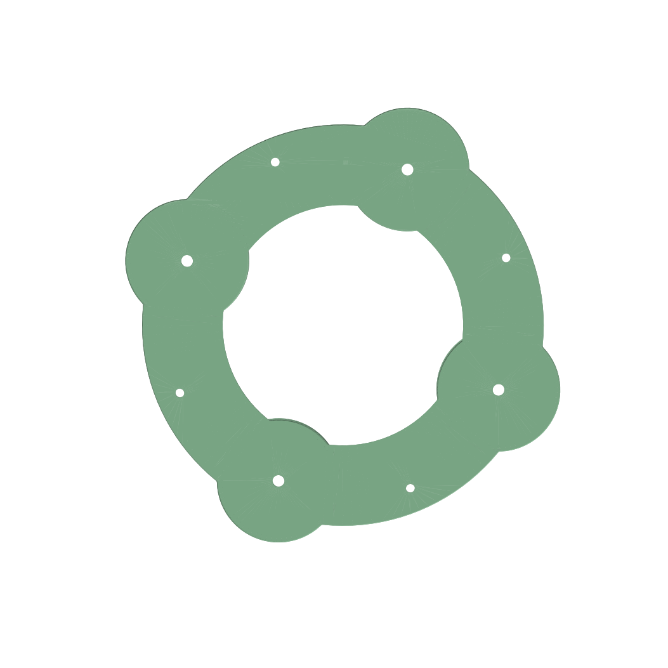
docs/build_img/tt04_bottom.png
