shaoming11/hh-winners/docs/build_img/tt04_top.png

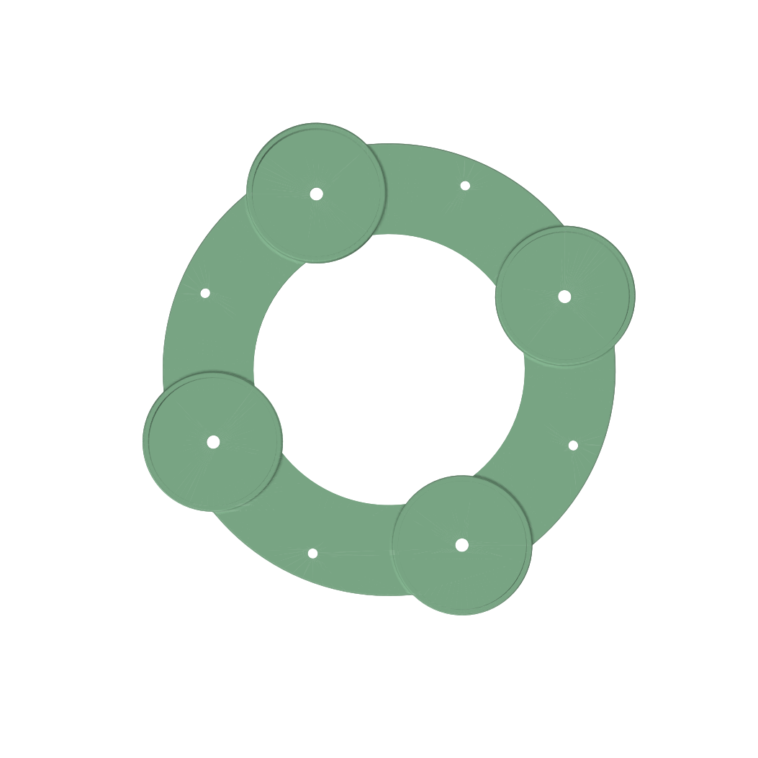
docs/build_img/tt04_top.png
