shaoming11/hh-winners/docs/build_img/tt05_plate.png

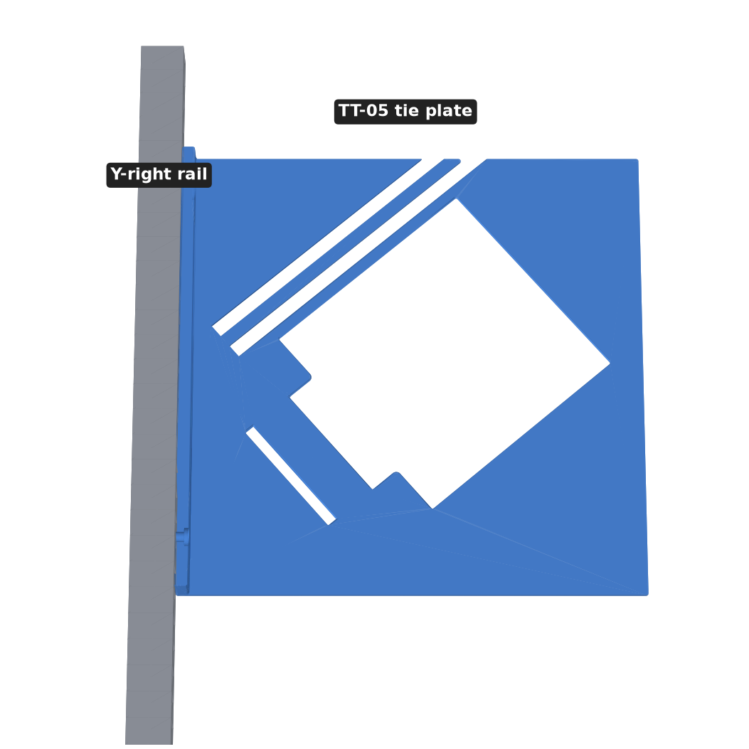
docs/build_img/tt05_plate.png
