shaoming11/hh-winners/docs/build_img/tt_orient_0deg.png

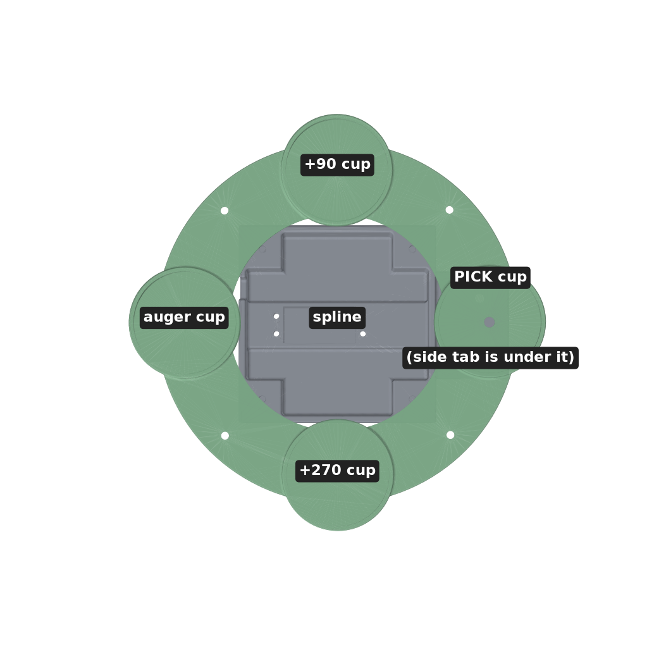
docs/build_img/tt_orient_0deg.png
