shaoming11/hh-winners/docs/build_img/ws01_alone.png

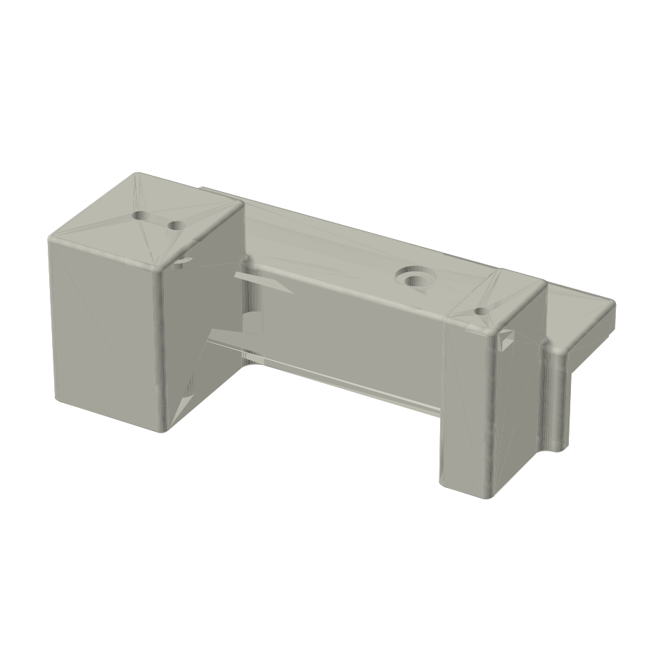
docs/build_img/ws01_alone.png
