shaoming11/hh-winners/exports/assembly/01_top_view.png

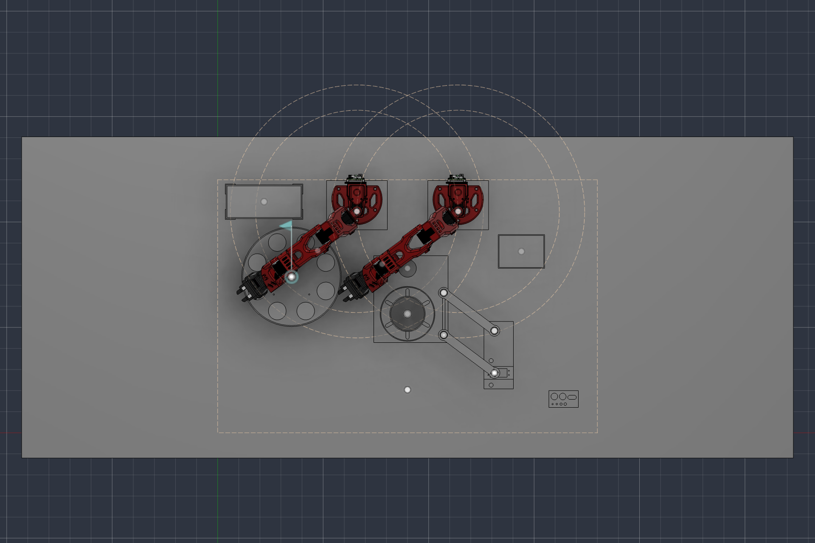
exports/assembly/01_top_view.png
