shaoming11/hh-winners/exports/assembly/02_front_threequarter_WORK.png

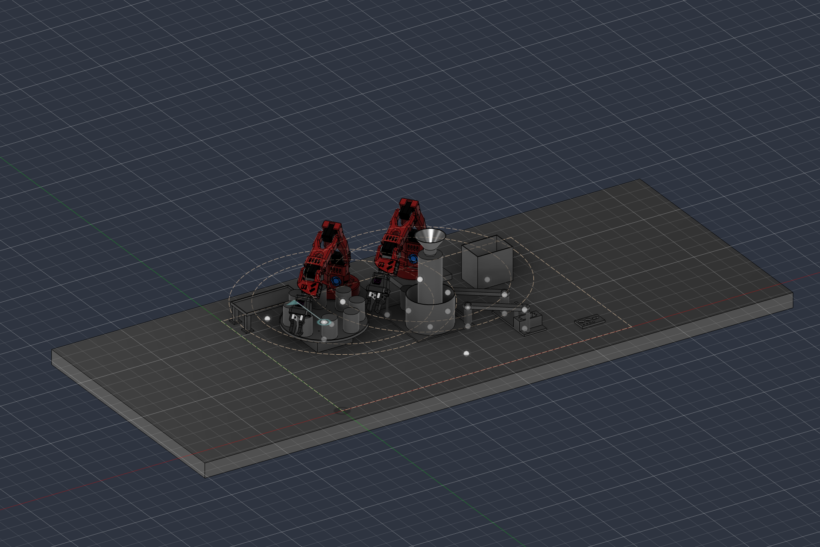
exports/assembly/02_front_threequarter_WORK.png
