shaoming11/hh-winners/exports/assembly/04_frame_threequarter.png

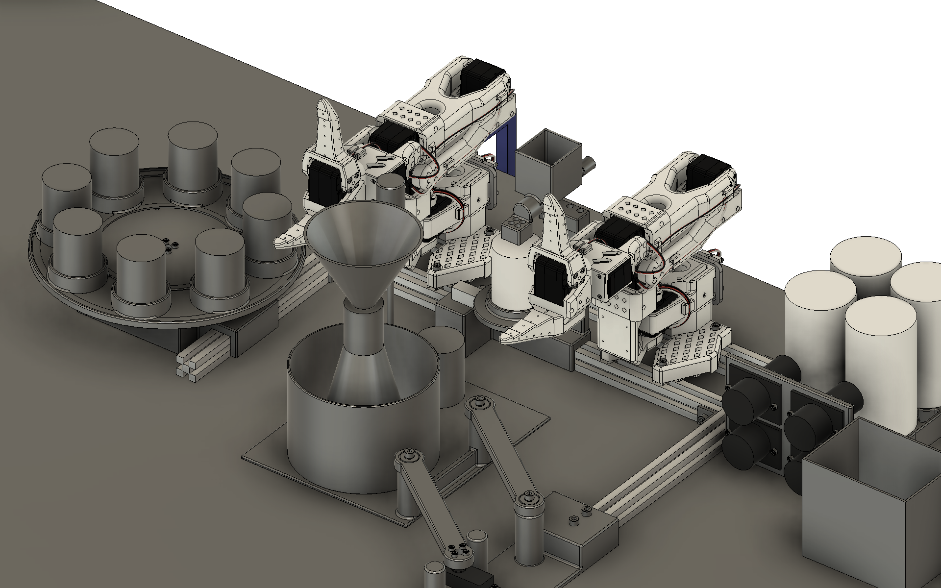
exports/assembly/04_frame_threequarter.png
