shaoming11/hh-winners/exports/assembly/05_frame_top.png

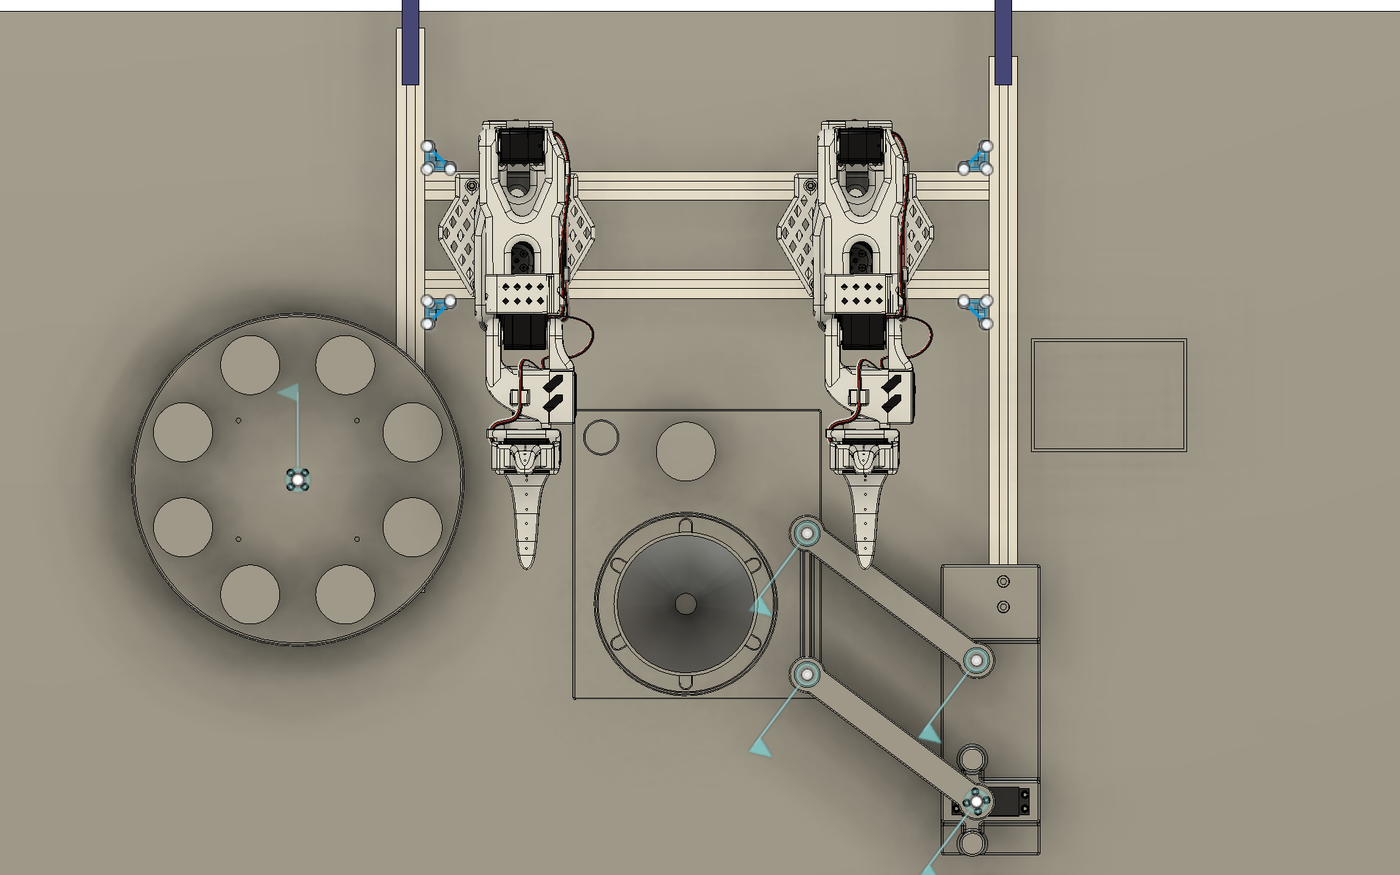
exports/assembly/05_frame_top.png
