shaoming11/hh-winners/exports/assembly/06_fourbar_detail.png

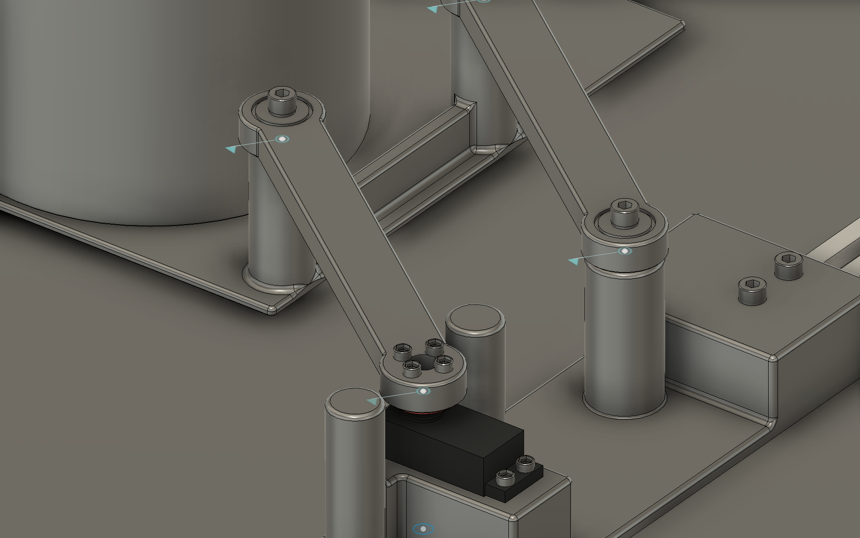
exports/assembly/06_fourbar_detail.png
