shaoming11/hh-winners/exports/assembly/07_carousel_detail.png

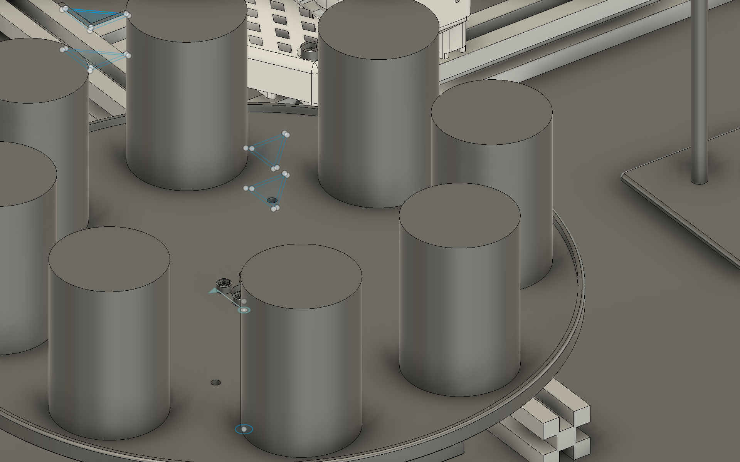
exports/assembly/07_carousel_detail.png
