shaoming11/hh-winners/exports/assembly/08_beaker_ring.png

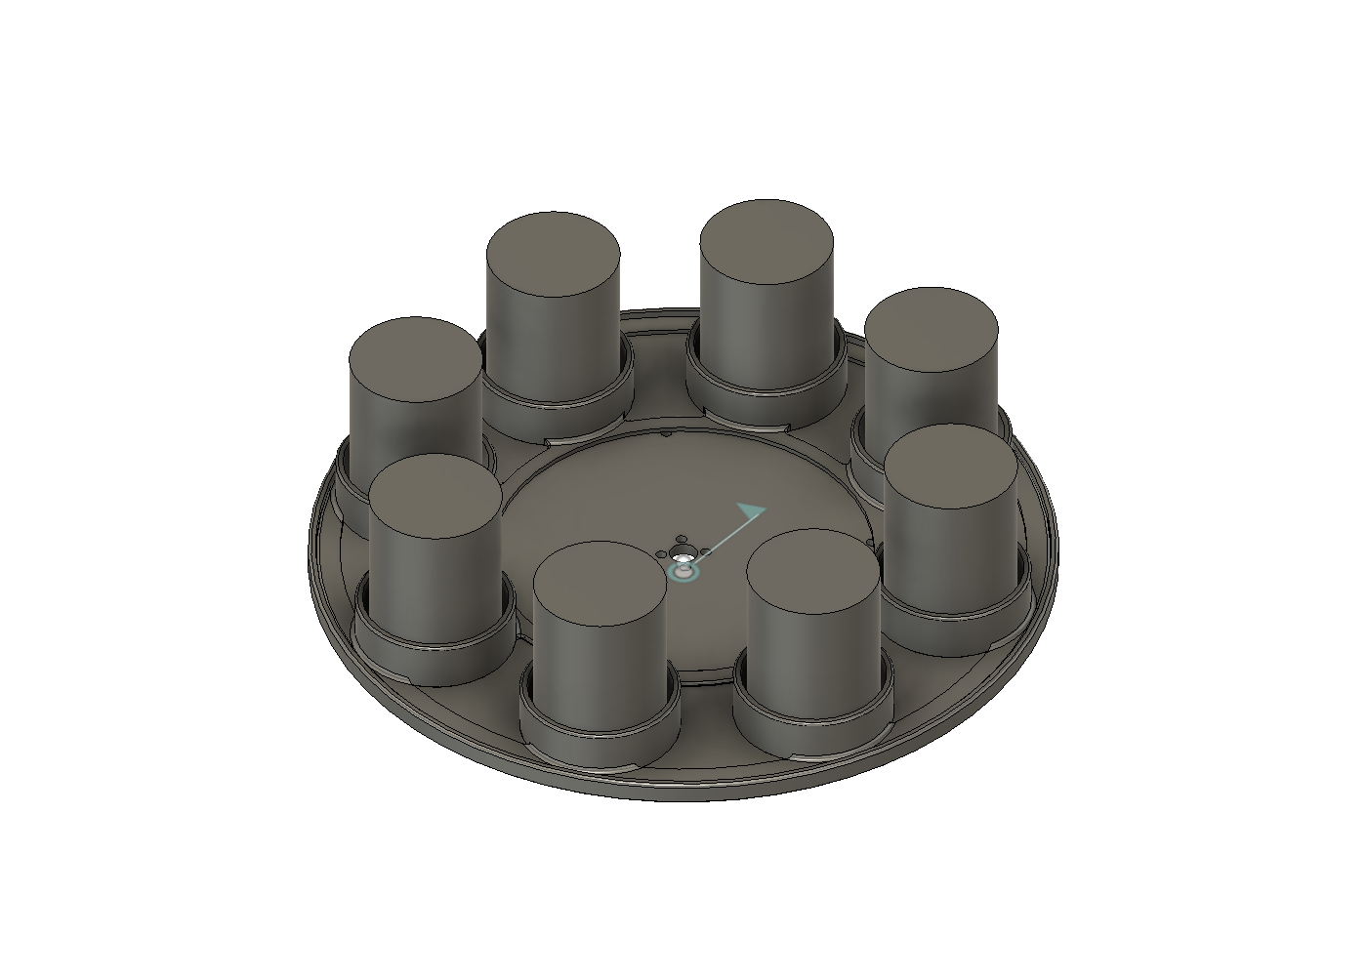
exports/assembly/08_beaker_ring.png
