shaoming11/hh-winners/exports/assembly/09_dosing_station.png

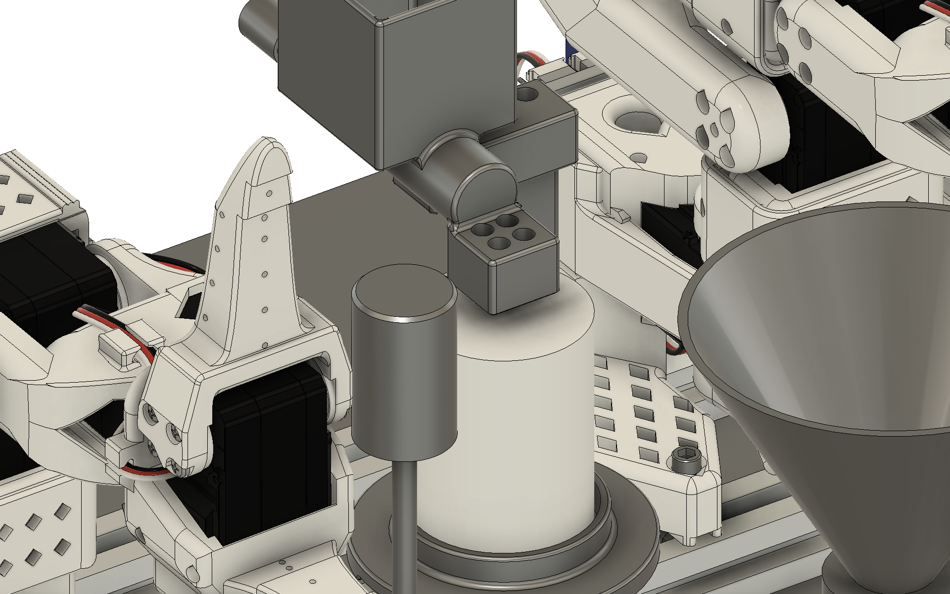
exports/assembly/09_dosing_station.png
