shaoming11/hh-winners/exports/assembly/10_reagent_rack.png

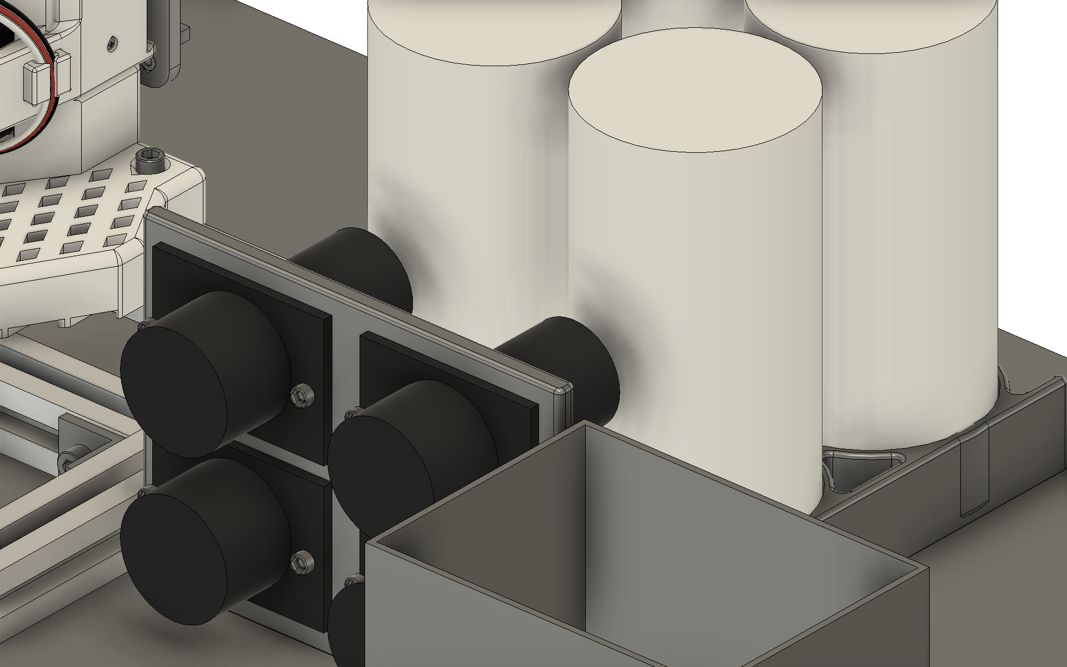
exports/assembly/10_reagent_rack.png
