shaoming11/hh-winners/exports/assembly/11_finray_gripper.png

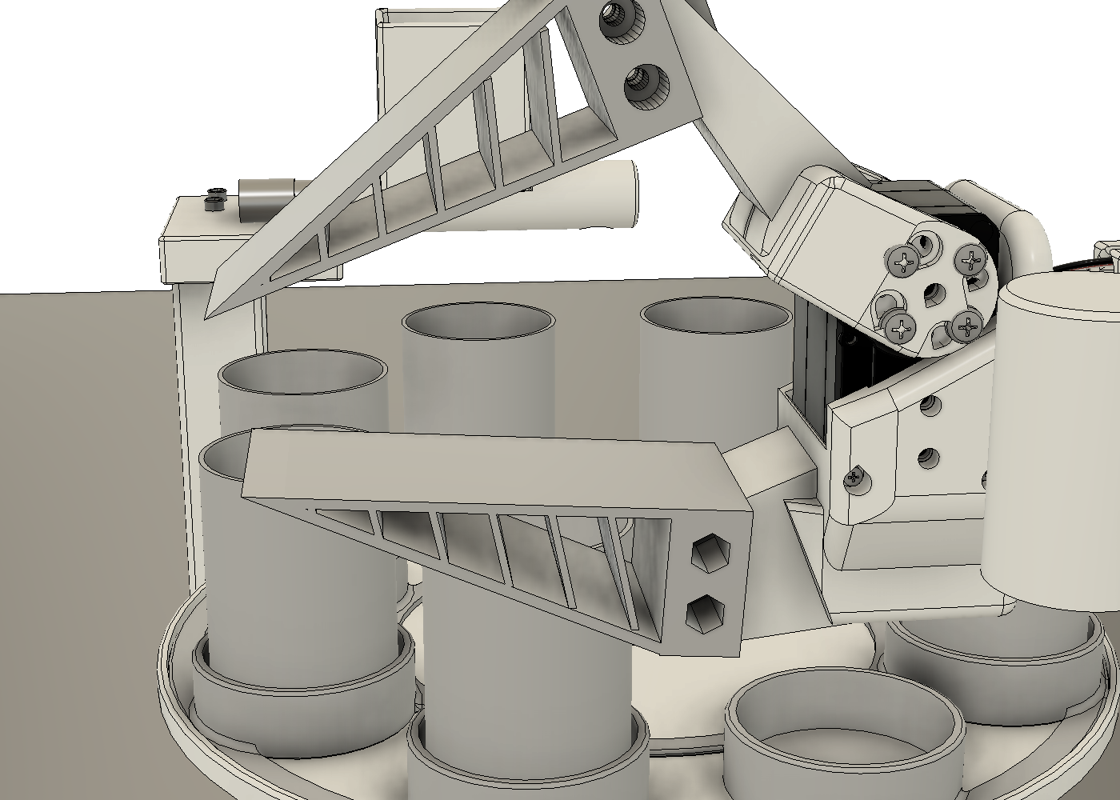
exports/assembly/11_finray_gripper.png
