shaoming11/hh-winners/exports/assembly/12_glassware.png

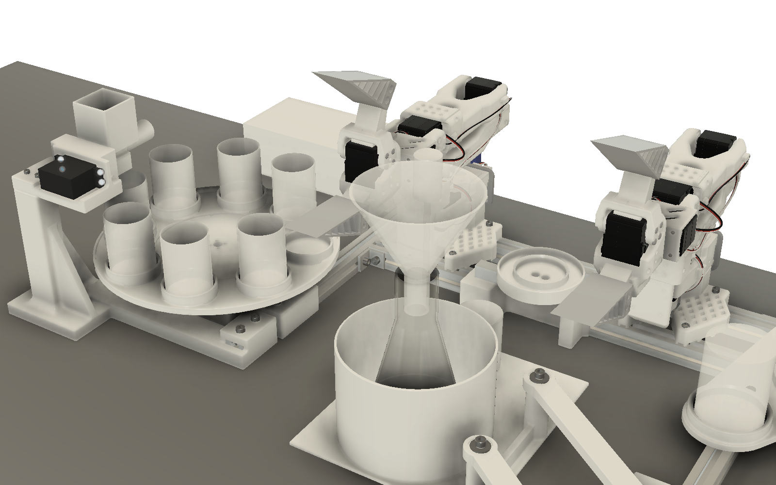
exports/assembly/12_glassware.png
