shaoming11/hh-winners/exports/print_queue_2026-10-15/A1/plate1_preview.png

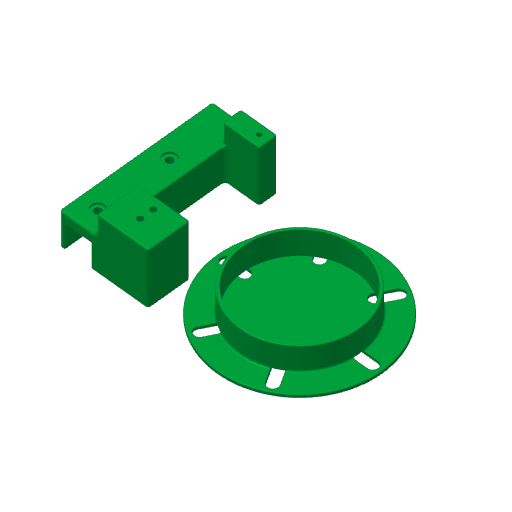
exports/print_queue_2026-10-15/A1/plate1_preview.png
