shaoming11/hh-winners/exports/print_queue_2026-10-15/X2E/orientation_top.png

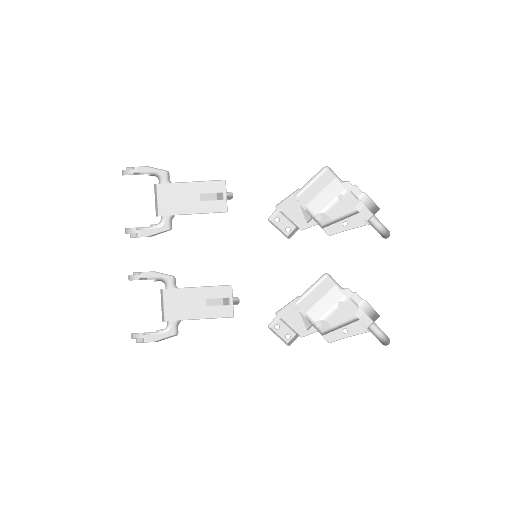
exports/print_queue_2026-10-15/X2E/orientation_top.png
