shaoming11/hh-winners/media/steps/step1.png

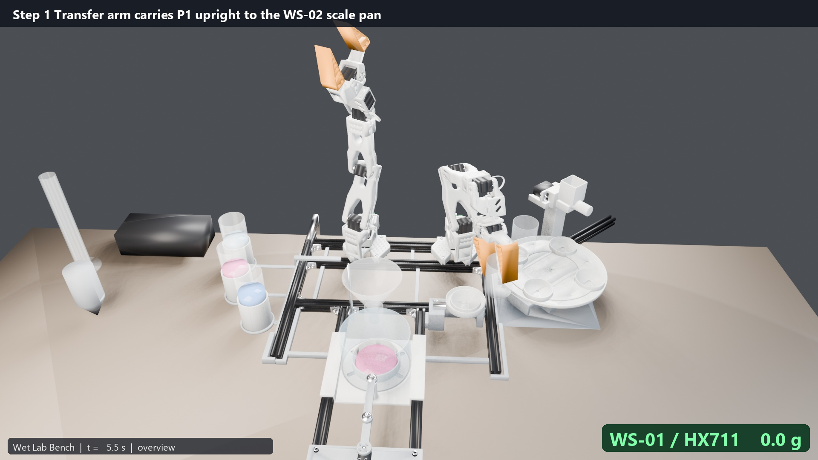
media/steps/step1.png
