shaoming11/hh-winners/media/steps/step2.png

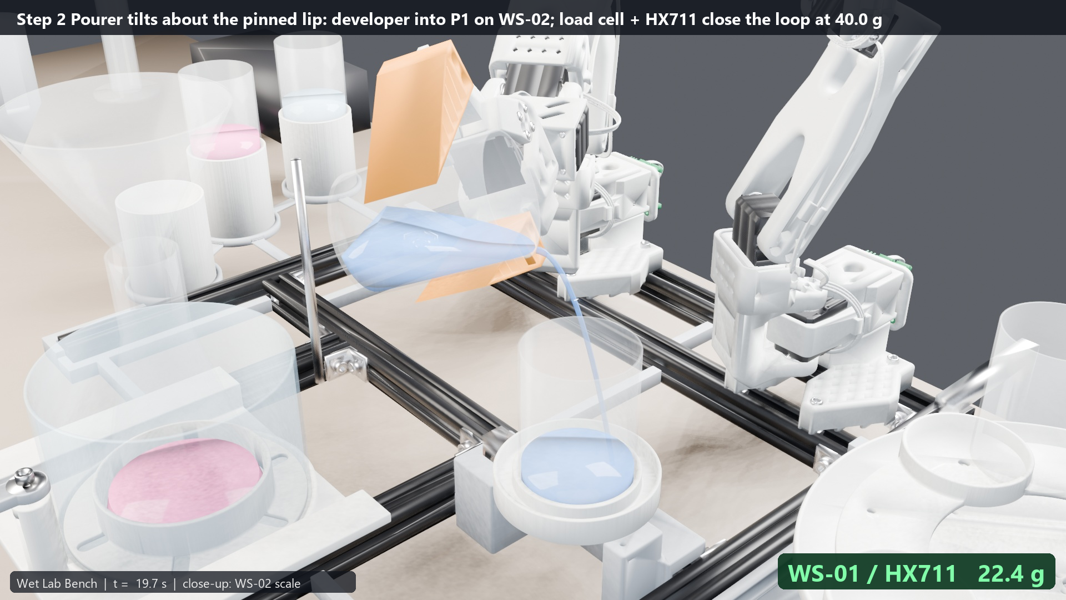
media/steps/step2.png
