shaoming11/hh-winners/media/steps/step3.png

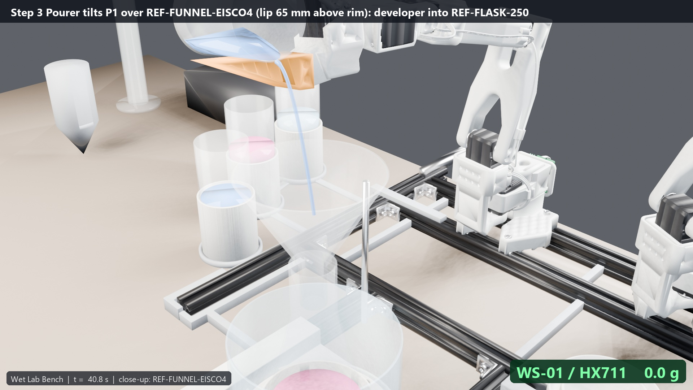
media/steps/step3.png
