shaoming11/hh-winners/media/steps/step5.png

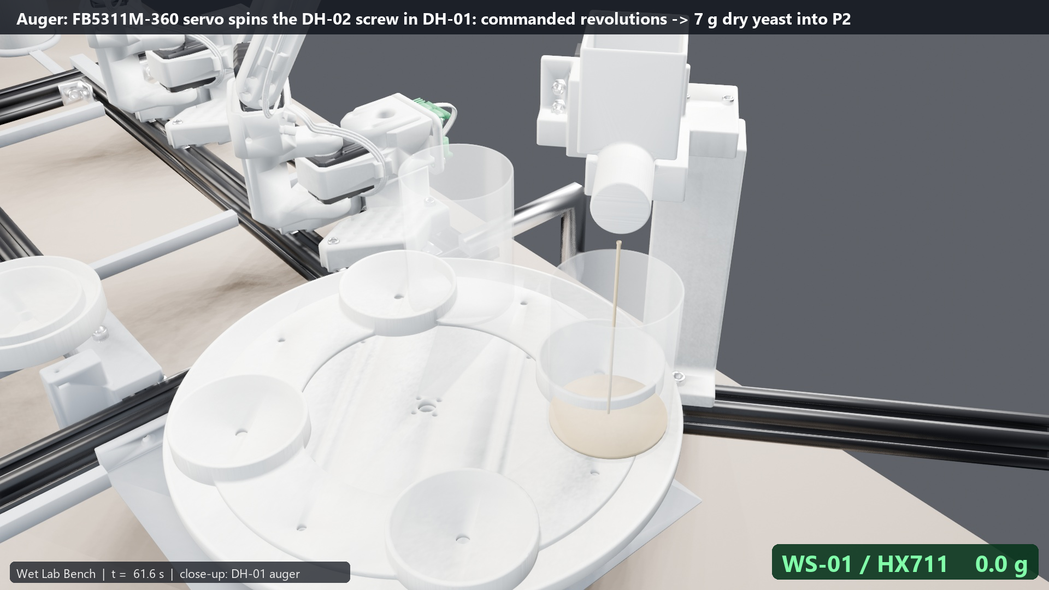
media/steps/step5.png
