shaoming11/hh-winners/media/steps/step6.png

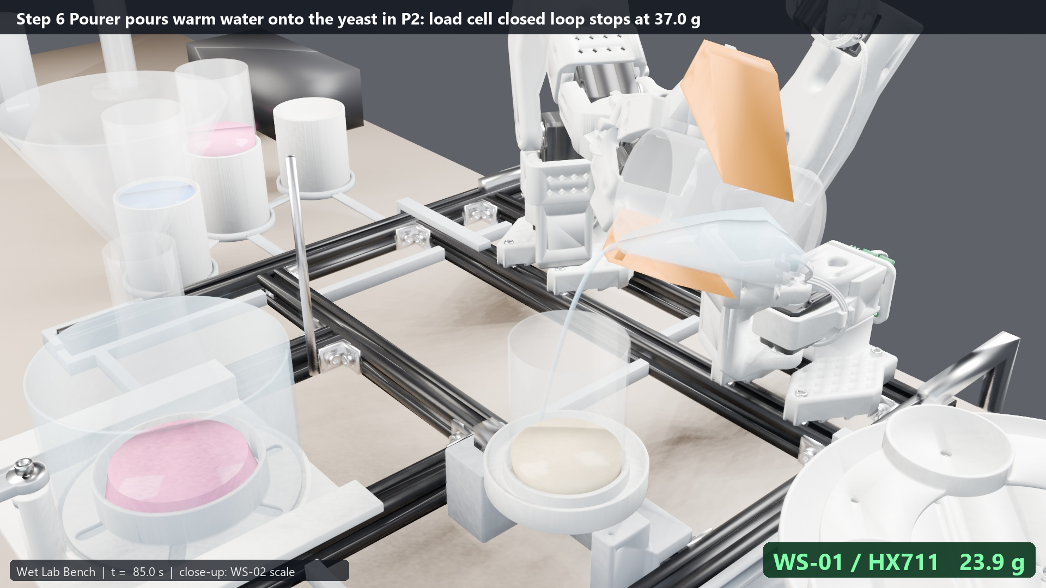
media/steps/step6.png
