shaoming11/hh-winners/media/steps/step8.png

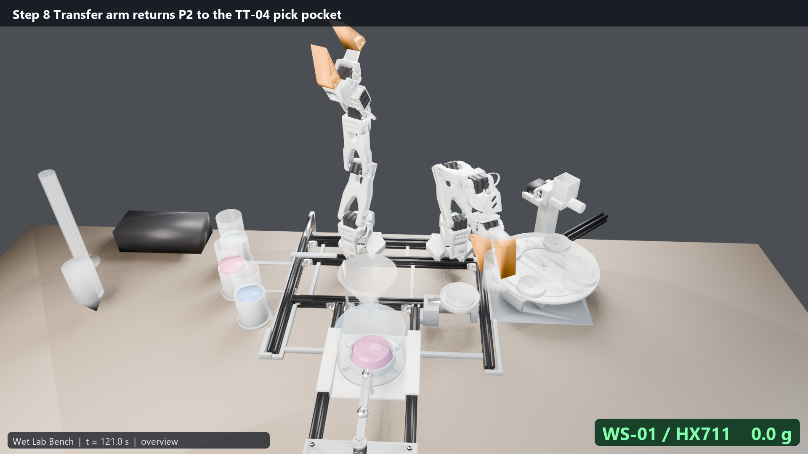
media/steps/step8.png
