shaoming11/hh-winners/(commit log)

2026-10-17 Import wet-lab-bench: README, gitignore, servo reference model
2026-10-17 docs: motivation, pitch, 36h plan, electrical and software architecture
2026-10-17 bom: bill of materials, tiered sourcing links and delivery checks
2026-10-17 tools, software: CAD generation and bench layout scripts
2026-10-17 exports: part STLs and sliced print plates
2026-10-17 exports: final print queues, X2E re-slices and the Boston print set
2026-10-17 exports: Fusion working assembly and render animation
2026-10-17 benchsim: runnable MuJoCo bench scene from update13_final with pinned SO-101 arms
    Phase 1 checkpoint: pinned upstream SO-101 model fetch with SHA-256 lock,
    layout loader with status check and r/bearing cross-check, CAD as-built
    fit, procedural bench scene, fin-ray gripper meshes, viewer and render CLI.
2026-10-17 benchsim: CAD mesh placement fits and layout verification gate
    Phase 2 checkpoint: RK-03, TT-04, WS-02 and stage STLs placed by feature
    fits to update13_final, station-centre and beaker-settle gate with a
    generated report, pytest suite.
2026-10-17 Run P1 arm transfer in reference demo
2026-10-17 benchsim: kinematics, CAD path audit and MuJoCo-native arm plans
    Phase 3 checkpoint: bounded IK on MuJoCo Jacobians, URDF-5 deg margin
    rule, contact and clearance queries, sign search and per-frame replay of
    anim_paths, native plans for all 8 arm steps, verifier report.
2026-10-17 benchsim: shared arm/Mega interfaces, JSON-lines protocol and sim backend
    Phase 4 checkpoint: CRC-8 JSON-lines codec with range validation, MegaClient,
    single backend entry point, simulated SO-101 servos and Mega (carousel,
    stage, auger stall rule, HX711 stream, watchdog, e-stop), 25-check exercise.
2026-10-17 Plan upright transfers and audit gripper contacts
2026-10-17 benchsim: shared contracts for vessels, process steps and run log
    Mass ledger with weight coupling to the beakers, fixed step vocabulary with a
    deterministic validator and the 10-step demo, run-log schema.
2026-10-17 benchsim: camera interface and shared beaker/foam image checks
2026-10-17 benchsim: lab notebook (HTML + Markdown) from run_log.json, sample run fixture
2026-10-17 benchsim: grasping, held-beaker transfer and miss detection
    Phase 5 checkpoint: contact-gated weld grasp with jaw stop in the sim backend,
    backend-independent path following, jaw-angle grasp classification and
    executor with parked-arm, drop and scale checks; carousel->scale,
    rack->scale and deliberate-miss demo with video and stills.
2026-10-17 Add SO-101 arm-driven analytical pour
2026-10-17 Run an arm-driven developer pour in the demo
2026-10-17 benchsim: process sequencer with timeouts, safe stop and run logging
    Phase 8 core: explicit states, per-step timeouts, stop requests honoured at
    safe points, safe-stop path that keeps torque and never opens a holding
    gripper, transfer/verify/wait/stage skills.
2026-10-17 benchsim: RunLog setters for trace files and the approval record
2026-10-17 benchsim: analytic liquid model, closed-loop pour controller and sim pour harness
    chem/liquid.py: tilted-cylinder volume/head tables, rectangular-weir lip flow,
    ballistic parcels with receiver capture or spill, impact force, after-drip.
    process/pour.py: architecture 5 state machine (fast/ramp/flow/cut/drip/settle/
    top-up, PAUSE outcomes) plus a mass-deficit spill check; funnel profile.
    process/pour_sim.py: theta -> joint goal on the native tilt-in + manifold.
    pour_trials.py: per-trial fresh world, Executor to pre-pour, MegaClient samples.
    [liquid] and [pour] config sections; fill offset from 3 calibration pours.
2026-10-17 benchsim: auger dosing model, carousel/stage helpers, foam model and their tests
    AugerModel on SimMega.aug_hooks (per-rev g/rev draws, high-water-mark
    dispensing, landing or spill, hopper-empty fault); Mechanisms host helpers
    (station table, carousel_to, stage_to, dose_yeast with scale hooks,
    calibrate); analytic slider-crank; FoamModel driving the foam geom;
    verify_mechanisms checks; new [auger_model] and [foam] parameters.
2026-10-17 Pin reference SO-101 simulator assets
2026-10-17 Add reach and stage reference sim audits
2026-10-17 benchsim: pour tests, trial report, spill and funnel runs
    tests/test_pour.py: tilted cylinder vs closed forms, flow monotonicity,
    landing/spill classification in the world, controller state machine on the
    MuJoCo-free plant (nominal, low fill, top-up, overshoot, low reagent, spill).
    Top-up no longer re-cuts before any top-up flow. Report: 10/10 within +-2 g
    (mean -0.28 g, sd 0.06 g), spill A/B, funnel landing 9.9/34.0 mm of 40.
2026-10-17 benchsim: phase 7 mechanisms report and foam camera frames
    verify_mechanisms: 31 gates pass (10 doses within +-0.7 g, carousel stations,
    slider-crank vs MuJoCo closed chain, foam growth and camera pixel growth);
    fault payload in dose records, stage travel-time gate, foam region includes
    the column base.
2026-10-17 benchsim: keep an append-only scale sample archive in MegaClient
2026-10-17 benchsim: real backend review fixes (lerobot API note, Moving fallback, joint order test)
2026-10-17 benchsim.dashboard: live feed contract and step narration
    Feed.attach(seq) watches a sequencer run through ctx.on_tick_hooks and the
    sim frame hooks and publishes benchsim.feed/1 snapshots: step statuses,
    current step with judge-facing narration, scale, arm goals vs positions,
    exact Mega JSON lines (CRC included) and servo-bus writes, events, faults.
    Arms are wrapped to record commanded goals; polls never raise into the run.
2026-10-17 benchsim.dashboard: HTTP server, main-thread runner and live page
    python -m benchsim.dashboard serves a plain HTML/JS page with an SSE feed
    (stdlib ThreadingHTTPServer). The sim stays on the main thread; HTTP threads
    only queue start/reset or raise a stop flag that becomes ctx.request_stop at
    the next tick, so Stop runs the sequencer's own safe-stop path. Real-time
    pacing via a frame hook. Until demo_run lands, the runner uses a labelled
    3-step development protocol; nothing is faked.
2026-10-17 benchsim: one-command reproduction, final status, fidelity and calibration notes
    reproduce.py regenerates every report and the demo evidence (all gates
    pass); README gains the status table, fidelity table, assumptions,
    calibration needs and known failure cases; grasp tests write to a temp dir.
2026-10-17 benchsim.dashboard: live sim camera with step-following auto view
    A world frame hook renders the chosen MuJoCo camera at 15 fps of sim time
    (about 14 ms per 960x540 frame), JPEG-encodes it and serves it as MJPEG
    under the step caption overlay. 'auto' follows the running step: close-up
    on carousel and scale for transfers/dosing, flask camera for the eruption.
    Camera buttons on the page; --camera/--fps/--no-video flags.
2026-10-17 benchsim.dashboard: twin panel, commanded vs measured tool point
    Forward kinematics (private Kin) of the last commanded goal and of the
    measured joints for each arm: x/y/z both ways, error in mm, per-joint
    deltas, highest load. Error counts only once the arm has settled (while
    moving it is tracking lag) and is compared with the step's tightest
    verified clearance. The card states the limit: encoders cannot reveal a
    wrong servo zero; the grasp and scale checks catch that.
2026-10-17 benchsim.dashboard: keep twin labels and joint deltas from wrapping
2026-10-17 benchsim.dashboard: full 12-step demo, chemistry card, live speed, README
    DemoRun drives demo_run.SimDemo (liquid, auger and foam models) through the
    dashboard runner, mirroring SimDemo.run; a test runs it to DONE with all
    12 steps passed so drift is caught. Chemistry card shows every vessel's
    composition from the ledger (validated categorical palette, values also in
    text) plus O2 and foam column. Speed 0.5x-8x switchable live; --dev keeps
    the quick 3-step protocol. README section for the dashboard.
2026-10-17 benchsim.dashboard: record every run and replay it with the synced overlay
    Each dashboard run writes dashboard.mp4 (the camera view the audience saw,
    one frame per 1/fps of sim time) and tape.json (snapshots at 5 Hz plus
    every status change, all wire lines and events once) into its run folder.
    --replay RUN_DIR serves them; the page maps video time -> sim time and
    rebuilds the overlay, so scrubbing works both ways and the speed buttons
    set the playback rate. Static files support byte ranges for seeking.
2026-10-17 benchsim.dashboard: camera view no longer lags one switch behind
    Chrome shows a multipart/x-mixed-replace part only once the next part's
    headers arrive. Between runs a camera switch pushes a single frame, so the
    picture was always the previous camera (Overview showed Close-up). Each
    frame is now followed at once by the next part's boundary and headers.
    Also redraw on a camera command instead of at the next 0.5 s idle tick,
    and stop re-creating the camera buttons when only the shown camera
    changes, which could swallow a click.
2026-10-17 benchsim.dashboard: merge the step tiles and the Now card into one Run panel
    Styled like the Claude Code terminal: a spinner line with the current
    step's title, elapsed time and timeout, then "⎿" and the steps as a todo
    list (✔ done, ■ running, □ pending). Finished steps fold into
    "… +N steps done" (click to unfold), the last finished step stays in
    view, and the current step's detail, reaction and facts sit under it.
2026-10-17 benchsim.dashboard: fix a flaky MJPEG test (wait for the frame, not the first part header)
    The response headers plus the opening part header already end the same
    way as a closed frame, so the read loop could stop before the frame came.
2026-10-17 benchsim.dashboard: fit the whole dashboard on one screen
    On a laptop-sized window (>= 1000 x 640) nothing scrolls. The video
    shrinks to leave room for a Chemistry | Wire row under it. The right
    column is the Run panel (which scrolls inside itself if it has to), then
    Arms, then Errors. The cards also get compact:
    - Arms: one line per arm (name, holding, error meter with the gap tick,
    short status). Plan/servo positions, joint errors and load move to the
    tooltip.
    - Chemistry: one line per vessel with the total; the per-species split
    is in the tooltip.
    - Wire and Errors: single-line rows with the full text as a tooltip;
    Errors keeps the last 4.
    The wire log now keeps following new li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
2026-10-17 firmware: HX711 DT on D5, scale commands allowed while ESTOP is latched
    Two changes from the first hardware bring-up on the real Mega:
    - HX711 DOUT moves from D3 (PE5) to D5 (PE3) to match the bench wiring.
    Pin tables updated in docs/electrical.md and firmware/mega/README.md;
    the stub-register test gains PE3.
    - STREAM, TARE and CAL now work while the ESTOP fault is latched, in both
    the firmware core and SimMega (parity kept). They move nothing, and it lets
    the scale be tested before the e-stop is wired. TT/ST/AUG still answer
    err ESTOP. The host-test script and bringup.md E6 are updated to match.
    Verified on hardware: sketch flashed to the Mega, boot line and PING OK,
    scale strea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
2026-10-17 software: bench backend, schemas, Photon agent, demo script and tests
    Backend (software/backend): FastAPI state/log store over the benchsim bench, QA watchdog,
    HTTP + SSE + MJPEG API for the frontend, MCP server for agents, approval gate (nothing moves
    without a human), conversation tools (describe, delta, snooze, thread context, preferences).
    Contracts in software/backend/schemas.py exported to software/schemas/*.json.
    Agent (software/agent): Photon Spectrum iMessage/terminal agent on Claude with the backend's MCP
    tools, per-space memory, proactive alert watcher (deduped, batched, requester-aware, notify
    preferences and quiet hours), operator bootstrap, camera attachments.
    Also: the earli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
2026-10-17 benchsim.render: hide the marker sites (the grey spheres in every beaker)
    Sites are named points (beaker lip and bottom, carousel pockets, funnel rim, flask neck...) read for positions only.
    Renderer never set sitegroup, so MuJoCo drew each as a 5 mm grey ball. verify_mechanisms already hid them the same
    way. The interactive viewer keeps them for debugging.
2026-10-17 benchsim.fx: camera look for the dashboard (room, glass, liquids, pour streams, elephant-toothpaste foam)
    The dashboard camera showed a black void, one blue for every liquid, no pour stream at all and the eruption as a
    single pink cylinder. benchsim.fx draws a look into each frame's scene copy, after update_scene and before render:
    - a lab room (tiled walls, speckled epoxy worktop, floor), softer key/fill light, glossy glass and PP
    - liquids coloured from the Ledger (developer, water, yeast slurry, dyed flask); tilted beakers keep a level surface
    - pour streams on the liquid model's ballistic arc, thinning by continuity, drops at a trickle, splash and ripples;
    liquid down the funnel and o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
2026-10-17 benchsim.fx: pastel foam, lighter streams, eruption camera as soon as the foam is out
    From a full recorded run:
    - the dye is mixed into the flask liquid (load_flask), so the foam now comes out an even pastel pink with lighter
    streaks and per-bubble shade, instead of high-contrast pink/white blobs that read as beads from a distance
    - fewer, larger foam blobs: smoother silhouette and about a third fewer geoms to render
    - pour streams lightened toward white (a clear stream catches light)
    - auto camera: the foam erupted during step 10 and peaked during step 11 while the camera watched the funnel and
    then the carousel; it now switches to erupt_cam as soon as the foam column exists
    - one pass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
2026-10-17 software: the agent looks at texted photos; /mcp redirect; unweighed-dose pours
    photos.ts normalises an inbound attachment into something the model can see:
    sips re-encodes to JPEG at 1568 px (iPhone HEIC included) where it exists, the
    four API-accepted types pass through otherwise, and anything else comes back as
    a sentence the sender can act on. index.ts routes attachment messages through
    it, brain.ts sends the image block ahead of the text and is told to safe_stop
    first if the picture shows a spill.
    Also: /mcp without the trailing slash 307s to /mcp/ so a client configured
    without it still connects, and a pour into a beaker holding an unweighed auger
    dose raises CONTENT_UNKNOWN instead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
2026-10-17 benchsim: recorded run with the camera look; previews replaced by one before/after sheet
    runs/dashboard/20261017T163648Z-sim: the full demo through the dashboard runner with benchsim.fx (12/12 steps),
    for --replay on demo day. runs/fx_preview held 100 stills of an earlier version of the look (old camera names,
    striped foam); python -m benchsim.fx.preview regenerates them in seconds, so one before/after sheet of the final
    look replaces them.
2026-10-17 benchsim: ERUPT rides on the reaction pour, pushed as soon as the pourer is clear
    The sled used to push only after the pourer carried P2 back to the scale and the
    transfer arm returned it to the carousel: 32 s after the slurry met the peroxide,
    by which time the foam (at the neck 4.3 s after contact, assumed kinetics) had
    erupted at WORK, under the arms.
    POUR_TO_FUNNEL takes erupt (bool). With erupt=true the pourer untilts, lifts the
    beaker clear of the funnel ("raise from pre-pour"), the stage moves to ERUPT, and
    only then does the pourer carry the beaker back. The validator treats the stage
    as at ERUPT after such a pour, so only returning a beaker to the carousel may
    follow. The demo prot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
2026-10-17 benchsim.dashboard: restyle to the thematrix look
    Black bento of cards (1px #232323 borders, 8px radius), IBM Plex Sans 300
    titles with IBM Plex Mono for data, round pills for the controls, a blinking
    status dot in the header, and the task-tree glyphs (☐ ◐ ☒ ✗) in the Run
    panel. Dark only, like the reference; the light theme and its toggle go.
2026-10-17 software: free-look camera, fullscreen, and a bench that talks like a person
    The dashboard camera was fixed to whichever scene camera you picked. benchsim's
    Video now also renders an MjvCamera, so drag orbits, shift-drag pans and the
    wheel zooms; entering free look copies the pose of the camera you were on, so the
    picture does not jump. The page owns the gesture and POSTs absolute angles to
    /api/view (registered above the /api/{cmd} catch-all, which would swallow it).
    A fullscreen button sits on the stage, f toggles it, and the camera stream now
    re-attaches itself two seconds after an error instead of staying blank until
    someone reloads - the data feed always reconnected, which is why a ba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
2026-10-17 firmware + config: bench calibration, HX711 on D11, timed auger
    Measured on the real bench (2026-10-17) and carried into both the firmware
    defaults and bench_params.toml, so hw-check parity still holds:
    - HX711 DOUT on D11 (PB5), not D5: the bench wiring changed again.
    Pin tables in electrical.md and firmware/mega/README.md updated.
    - Stage zero: st_us_at_zero 944.4 -> 914.8 us (crank and rod in line at WORK).
    - Carousel: zero is the pick cup over the TT-01 tab, tt_us_at_zero 1134.5 us,
    and the servo turns 90 real degrees per 489.7 us (5.4406 us/deg; it covers
    ~368 deg over 500-2500 us, not the assumed 290). deck_range_deg is now
    [-110, 250], so P2's pick stop is reached as -90 inst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
2026-10-17 TRIAL (not for main): TT-01 rail saddle on Y-right, flush with the front end
    verify_kinematics on this layout: native plans NOT collision-free. Carrying P2
    carousel<->scale sweeps 22 mm into P1 (steps 6, 9); lowering P1 onto the pick
    pocket hits the ring by 4.6 mm (step 4); the deck rim clears the scale pan by
    0.6 mm in plan at pan height. Transfer pick r 229 mm, margins 15-22 deg (fine).
    Kept for the record; the TT-05 plate placement (update13_final) stays.
2026-10-17 TRIAL saddle mount, config A: collision-free
    TT-01 rail saddle on Y-right, centre 80.7 mm outside the rail and 21 mm from
    its front end (base overhangs the end by 34 mm; both saddle holes stay on the
    rail). Pocket 0 sits at the pick spot at deck 0 (pick 259.6 mm from the
    transfer base, bearing 26.1 deg), P2 starts in the pocket opposite P1, auger
    station opposite the pick. Deck rim clears the scale pan by 20.5 mm.
    verify_kinematics: native plans collision-free; transfer pick/place margins
    15.3-23.1 deg (original 15.3-16.2); the only rule issues are the 6 pourer
    wrist_flex rows that the original layout has too.
2026-10-17 Trial: auger on E5 rail out from Y-right; planner collision-free
2026-10-17 Trial saddle layout: TT-01 6 mm back so both M4 T-nuts sit inside Y-right
    TT-01 saddle bolts now at Y 282/312 (12/42 mm from the Y-right south end),
    was 6 mm from the end with no room for a T-nut. Carousel centre (755.7, 297),
    pick (718.2, 372.2), auger outlet (834.5, 326) on E5 at Y 386-406.
    P2 starts in pocket 2 (opposite P1) in mechanisms.INITIAL_POCKETS to match
    scene.BEAKERS; the full dashboard demo now passes.
    verify_kinematics: collision-free, same 6 pourer wrist_flex rule issues as main.
    Known: 7 tests still encode the old carousel geometry (test_kinematics x3,
    test_layout station centres, test_mechanisms x3) plus test_real_backend
    megaclient parity; these failed on this branch befo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
2026-10-17 Spout alignment pages for the trial saddle layout
    One top-view page per spot (from the CAD) with a clock-face heading for the
    beaker spout, computed from native_plans.json: pourer pre-pour direction
    mapped back to each pick through the gripper frame, P1/P2 mapped through the
    transfer carry and the carousel deck angle. Developer rack_1 4:20, water
    rack_3 12:00, P1 pocket 0 12:45, P2 pocket 2 6:45 (deck 0), scale check 1:30.
2026-10-18 Trial saddle layout: real auger post/head/E5 in the sim, all reproduce gates pass
    - layout_final carousel: auger_post_box / auger_head_box / auger_rail_E5 from the
    PS-01 / DH-01 STL extents as placed on E5; scene builds them (else the old radial post)
    - verify_layout / verify_mechanisms / test_mechanisms: the auger may sit anywhere on the
    pocket circle (here ~96 deg from the pick); stops visit each pocket/station angle
    - test_kinematics: the 3 CAD-recording tests skip while a TRIAL layout is active
    - bench_cam moved clear of the real-size DH-01 head (it blocked the pick cup)
    - test_real_backend: TT done means inside the firmware 0.6 deg tolerance
    - TT-04 mesh fit regenerated for the new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
2026-10-18 Saddle step 3 page: deck hidden so both E5 corner brackets show
2026-10-18 Firmware: tt_release stops the carousel pulses after each move
    The deck's inertia makes the M45CHW's own loop hunt while holding; with
    tt_release = 1 (bench default) the output goes off once a TT move is done and
    the next move starts from rest_deg (no snap). Also: the stub-AVR sketch test
    builds with -DWLB_USE_ESTOP, since the default build no longer installs the D2
    interrupt (it crashed after 1d58caf).
2026-10-18 HX711 DT moved to D15 (PJ0) to fit the bench wiring
2026-10-18 Scale calibrated: 689.384 counts/g (3 Canadian $2 coins, 21.14 g)
2026-10-18 Beaker empty mass 19.94 g (measured on the calibrated scale)
2026-10-18 LeRobot calibration for both SO-101 followers (wlb_transfer, wlb_pourer) + port map
2026-10-18 LeRobot calibration for the SO-101 leader arm (wlb_leader)
2026-10-18 Firmware: closed-loop carousel option (continuous servo on D6, feedback on A3)
    tt_closed = 1 reads the deck angle from the A3 feedback and drives the servo's
    speed with a P(D) loop that tracks the same smooth 2 s/45 deg profile; inside
    tt_tol_deg for settle_ms it reports done (measured deg) and stops pulsing.
    PING adds tt_adc in this mode for calibration. Off by default until the A3
    range, signs, zero and stop centre are measured on the bench.
2026-10-18 Closed-loop carousel on by default: FB5311M-360 measured (A3 2..670, stop 1500, deadband 56 us)
    Deadband compensation so a small error still turns the servo; kp 3 us/deg,
    tol 2 deg. Unloaded bench run: 6 moves (+-30/45/90 deg) all done within 1.3 deg
    at the commanded time + 0.2 s. -DWLB_TT_OPEN_LOOP builds the old position-servo
    mode (the stub-AVR sketch test uses it).
2026-10-18 Arm calibration for the demo backend (hardware_calibration.bench.json)
    Built from the LeRobot calibration (tick_at_zero = range middle, sign +1): on
    the bench both followers at LeRobot 0 deg matched the MJCF zero pose and every
    joint's + direction matched the sim (pan right, lift toward the sled, elbow and
    wrist flex down, wrist roll moving jaw to the left). Gripper: closed = fin-ray
    tips touching. Fingerprints recorded (port swap refuses). Dry-run read: all
    joints within ~1 deg of 0 at the zero pose (gravity sag).
2026-10-18 scripts/replay_plan.py: step-by-step dry run of native_plans.json on the real arms + carousel
    Pre-flight checks every waypoint against the calibrated limits before anything
    moves (--check opens the ports read-only); parks both arms, then waits for Enter
    before each step, turns the carousel to the step's pocket, replays the step's
    joint path at --speed (default 30 %); Ctrl-C freezes both arms, torque on.
2026-10-18 replay_plan: rest pose (arms folded back, holds unpowered); start from rest, end at rest with torque off; --rest
2026-10-18 Carousel: deadband jump 62 us, done tolerance 2.5 deg (small moves stalled just outside 2 deg with the deck on); replay_plan stops cleanly on a Mega fault
2026-10-18 replay_plan: 60 % speed, flow through intermediate waypoints (0.4 s), 5 deg / 2 s on segment ends; plan park for the steps, rest only at start and end
2026-10-18 replay_plan: waits scale with the move size (long moves were cut off at 2 s and overlapped the next step)
2026-10-18 replay_plan: 3x move-time allowance; a step only starts once the previous arm is back at park (else stop)
2026-10-18 replay_plan: stream multi-waypoint paths on a clock (planned spacing at the set speed) instead of polling each waypoint; per-joint error when a segment end is missed
2026-10-18 Arms: Goal_Velocity floor at 30 % of the peak speed
    Goal_Velocity goes out in a sync write (no status reply). After near-zero
    waypoint steps wrote 1 step/s to idle joints, a lost later write left a joint
    crawling (pourer wrist_roll at ~4 deg/s on the bench) and stalled the dry run.
2026-10-18 Arms: verify Goal_Position/Goal_Velocity after every sync write and re-send misses; 120 deg/s, 600 deg/s^2
    On the bench single motors silently missed sync writes (no status packet): the
    pourer elbow kept its old goal (87 deg off park), a wrist kept a crawl speed.
    set_goal now reads both registers back and re-writes the motors that missed.
2026-10-18 replay_plan: funnel pours all at once; sled out to erupt right after the last pour (back to work at the end); gripper waited on pick/place + 0.4 s; 2 deg segment ends near the cups; timestamps
    Step 1 on the bench now runs its arm motion in ~4 s (plan at 60 %: 3.8 s).
2026-10-18 replay_plan: jaws 85 deg open on every approach; pours stop before the manifold's arm-flip (84-96 deg tilt), drain 1.5 s, retrace to 40 deg before untilting
    The plan's untilt starts at 40 deg tilt, so after the manifold ended at 105 deg the
    arm snapped back 65 deg of wrist roll; the manifold itself swings elbow and wrist
    flex ~17 deg per sample near 84-96 deg tilt.
2026-10-18 backend: dashboard camera with the benchsim.fx look (liquids, pour streams, foam); WLB_FX=0 for the bare scene
    The backend built its Video without fx, so the served dashboard showed the plain MuJoCo scene while
    python -m benchsim.dashboard drew the full look.
2026-10-18 replay_plan: fix the step selection syntax error from the pre-mixed change
    The conditional sat in the comprehension's filter position, which Python does not
    parse, so scripts/replay_plan.py would not start at all. Same behaviour as intended:
    the named steps, else every step except "7 water pour" when P2 comes pre-mixed.
2026-10-18 Dashboard demo mode: a 3-step live-demo slot (yeast pre-mixed in the flask) beside the full run
    steps.flask_demo_protocol: P1 to the scale, weigh 39 g developer, pour it into the funnel and erupt. The
    operator mixes the yeast with the warm water beforehand and pours it into the flask, so the auger dose, the
    water pour and the activation wait drop out (about 80 s to the eruption at real time in the sim, against
    about 280 s for the full run). The full protocol is unchanged.
    Backend: BenchRunner.plan_mode (full | demo) picks the preset; POST /api/mode/<full|demo> switches it and
    rebuilds the sim bench with the yeast and water in the flask. The dashboard shows a full run | demo switch
    next to S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
2026-10-18 Sim + dashboard: our full run | demo switch replaces the yeast_in_flask / premixed demo restructure
    Undoes 7c238cc and 9b7feb7 in the simulator, the sequencer, the step vocabulary, the narration and their
    tests, so steps.demo_protocol is the whole process again and the dashboard's run-mode switch picks the live
    demo (steps.flask_demo_protocol). Keeps scripts/replay_plan.py (with b458fbb's fix) and the two
    bench_params.toml [recipe] flags it reads, so the real arms still run the 4-step flask demo.
2026-10-18 replay_plan: sled goes out the moment the last pour's drain ends, in parallel with the arm's retrace and retreat
    The stage move runs in the background (ack checked, done followed by mega_tick
    from every wait, heartbeats keep the 500 ms watchdog fed); the step waits for
    it before the arm-at-park check.
2026-10-18 Hand-taught pose corrections: scripts/teach_poses.py + replay_plan applies pose_overrides.json; carousel skips moves already within 2 deg, re-homes on a TT_TIMEOUT
    teach_poses plays each key pose's path, drops torque on that arm, records the
    operator's correction (deg per joint) and backs out. replay_plan shifts the
    taught pose and the slow segments around it by the offset.
2026-10-18 Carousel P 3 -> 5, cap 60 -> 90 us (small moves stalled; bench: +-90/45/10 deg all done within 1.5 deg); sled starts out at WORK each run and stays retracted at the end
2026-10-18 teach_poses: refuse corrections over 25 deg on a joint (wait for a gentler pose); back out along the corrected path
2026-10-18 Arm limits from the measured LeRobot ranges (minus 3 deg) instead of the MJCF ranges; teach_poses --from; pose 1 (transfer pick at the carousel) taught
2026-10-18 Straight-line pick around a hand-taught pose (transfer at the carousel)
    taught_poses.json holds the operator's touch pose; replay_plan builds, relative to
    it, above-and-15-mm-back -> straight down with the jaws at 85 deg -> advance onto
    the cup while closing -> straight up (IK on the sim kinematics, bounded by the
    arms' calibrated limits; the tool may tilt <= ~15 deg near the top where the wrist
    flex limit binds). Replaces the plan's slide / descend / touch / close / lift.
2026-10-18 Hardware replay on emulated USB, with step meaning, subgoals and checks
    - benchsim/backends/emu.py: LeRobotArm + MegaClient/SerialTransport with the servo bus and
    the serial port replaced by the simulator (SimServoBus, LoopbackSerial on SimMega)
    - replay_plan.py: waits go through a swappable CLOCK; LOG/STEP/SEG hooks; --emulate;
    replay(bb, a) callable from the backend; ReplayStop for the backend's stop button
    - backend: hw_replay command (approval from the agent), MCP hardware_replay tool;
    replay_observer derives each step's process meaning and its subgoals from the route
    and checks them from encoder + scale readings (reach, grip, lift/place on the scale,
    grams vs target, funnel em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
2026-10-18 Straight-line place on the scale from a hand-taught hold pose; transfer steps 1 and 4 built from the two taught poses
    teach_one.py teaches an absolute hold pose (transfer_scale). Steps 1 and 4: park
    -> straight-line pick -> carry with the beaker 70 mm above the receiver ->
    straight down -> open -> back off 15 mm -> straight up -> park.
2026-10-18 Taught spots: carousel grab 15 mm higher (caught the ring), scale place 10 mm higher
2026-10-18 Sled always starts out: read positions before clearing, CLR home only when the Mega lost track (it declared the retracted sled 'home' and the start move was skipped)
2026-10-18 Pourer: jaws 55 deg on approach, peroxide grab 2 cm higher, carries arc close to the arms (beaker upright, no posture jumps) instead of swinging over the flask
2026-10-18 Pourer grab: advance with the jaws open then close (closing on the move shoved the beaker), 8 mm back-off, grab 3 cm higher
2026-10-18 Peroxide pour over the scale 2 cm lower (every pour pose re-solved lower with the full gripper orientation kept)
2026-10-18 Peroxide pour rotated 4 deg further on the base (about 2 cm at the gripper)
2026-10-18 No folded rest pose: runs end with both arms parked up (torque on); teach_one parks both arms first
2026-10-18 Bench tweaks: peroxide pour 1 cm higher and 1.5 cm right (pan -1 deg net); peroxide put back 2 cm right (IK translation); P1 grab on the scale from 30 mm back, closing while advancing so the centre h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
2026-10-18 Real bench behind the backend: read-only link, live mirror, recordings, playback
    - backend/hardware.py: WLB_BACKEND=usb opens both SO-101 buses + the Mega read-only
    (dry run) and goes live only for an approved hw_replay; the displayed sim world
    mirrors the hardware (encoders for the arm joints, the commanded gripper so grasps
    carry over, Mega axes, the real scale). usb-fake: the same path on a hidden sim bench.
    - every replay records runs/<id>/telemetry.jsonl (20 Hz) + run.json; GET /api/recordings,
    {"kind":"playback"} plays one back in the sim with its step/subgoal/check timeline
    (MCP list_recordings / play_recording)
    - on the real bench only hw_replay moves hardware (start_run an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
2026-10-18 Firmware: closed-loop carousel is never 'position unknown' (the encoder measures it), so a TT move needs no CLR home (which would also declare the sled home)
2026-10-18 replay_plan: step 2 peroxide pour onto P1 closed loop by weight
    closed_loop_pour() replaces step 2's fixed tilt (tilt-in, smooth pour, drain, retrace,
    untilt) with benchsim.process.pour.PourController driving the tilt along the PLAYED pour
    path (taught / re-solved poses; theta by forward kinematics of the held beaker) from the
    Mega's live scale samples (STREAM). Target and tolerance from the recipe (developer_g,
    developer_tol_g); the controller's tilt limit is capped at the played path's end (the
    smooth part stops before the arm flip), so a short beaker pauses LOW_REAGENT. The taught
    grab, carry and place segments play as before. Without a Mega it pours open loop.
    --emulate now builds demo_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
2026-10-18 MCP run_mode tool (read / switch full|demo); backend starts in demo mode (WLB_PLAN_MODE, default demo)
2026-10-18 Bench: reliable top-down transfer (steps 1+4), 0.48 speed, grab check, loops
    - replay_plan: default speed 0.48; --cycles to repeat a run; grab held/missed
    check (jaws stopped short of closed) with a stop on a missed transfer grab;
    'landed' error print at the cups; the descent onto a receiver finishes before
    the jaws open (released 1 cm early before: fingers hit the scale posts)
    - scale place 10 mm right + 10 mm toward the arm; step 4 picks at the taught
    spot (the pan ring re-centres P1). 9/9 grabs held over two carousel pockets
    - angled side-grip code kept behind TRANSFER_GRIP='side' (FinRay jaws twisted
    P1 square to them; top-down with foam tape is what works)
    - record_pose.py: sa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
2026-10-18 Bench: peroxide pour 2 cm further left (pan +4 deg); sled back out at the end of the run with no wait
    4 full-demo loops (end turn off): 16/16 grabs held.
2026-10-18 Bench: peroxide pour pan sign fixed (negative = operator's left): -5 deg, 2 cm left of the original
2026-10-18 Bench carousel: a missed turn retries by backing off 20 deg and coming in with a full move (small corrections stalled)
    4 full demos with the carousel turning: 16/16 grabs held across all 4 pockets.
2026-10-18 Half dose: peroxide 19.5 +- 1.0 g, yeast 3.5 +- 0.35 g; developer low-fill pause 23.1 mL
2026-10-18 Mega firmware: HX711 DOUT moved to D30 (PC7) - the D31 joint failed again (scale read a constant 0.0 g and flooded samples)
2026-10-18 replay_plan under the backend: stream paths and the pour loop on the raw clock (the mirror tick took >=0.25 s per slice: jerky arms); pour scale reads 8 samples / 5 s (scale runs at ~10 Hz)
2026-10-18 Backend no longer holds up the arms: step checks read the already-streamed scale samples (no 16-sample blocking read), the mirror ticks at most twice a second during a replay; live_scale.py readout (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
2026-10-18 Revert "Half dose: peroxide 19.5 +- 1.0 g, yeast 3.5 +- 0.35 g; developer low-fill pause 23.1 mL"
    This reverts commit 7fc3d12b012860ea4883d2dd5e7b365a0c52aee2.
2026-10-18 Add precedents and benefits research for the pitch
    Claude-Session: https://claude.ai/code/session_016SjjcUiQL7C85LLuXh1Riz
2026-10-18 Add ethical case, risks and why-now evidence to pitch research
    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
2026-10-18 Add the build-guide images (docs/build_img) and the demo-run report frames
